AubergineShallow/digital8mm-vertical-nizo/cad/gs8-d2-v1/candidate-vertical/README.md

# D2 vertical Pi concealed vent review candidate

This directory contains the compact Kowa / Princeton vertical-Pi camera candidate derived from [AubergineShallow/digital8mm](https://github.com/AubergineShallow/digital8mm), with upstream baseline commit `d38468e58eb2b02d56743e2e0cfdd8f780818a65` retained for traceability. The current ventilation study uses a plain integral outer skin and separate intake/exhaust shadow plenums. Broadside grilles are concealed; edge mouths remain visible in direct front/rear views. Nine compact printed production parts and the reviewed purchased BOM selections/quantities are retained.

**This is an unqualified review candidate, not a fabrication, energization or service release.** Every r7 physical gate that still applies to this layout, the candidate's G-V-* gates ([REVIEW](REVIEW.md)) and collar M1 remain open. Actual cooler registration, complete FPC/EVF wiring, real tool access, printed strength, plenum manufacture and closed-body thermal performance remain unresolved. Geometric openings and scoped CAD passes do not establish useful airflow or physical safety.

<!-- gates:begin (generated by make_gates_vertical.py; do not edit) -->
**r7 gates on this candidate (generated):** 58 r7 receipt gates (56 open in r7): 39 carried, 11 re-scoped, 3 replaced, 5 retired; 53 of the open ones still apply here (carried, re-scoped or replaced by a G-V-* gate), 3 retired with deleted parts. r7 BX fixes: 8 carried, 7 re-scoped, 0 replaced, 2 retired. Table: [GATES-VERTICAL.md](GATES-VERTICAL.md).
<!-- gates:end -->

**Print hold:** the tub is not print-released. Plenum trial2 (review FP-11a) carries the roof on continuous 1.2 mm flow ribs and splits all four edge mouths (cold rear Z5..75, cold underside, hot underside, hot front Z5..40) with mullions; the two cold mouths also have 45° lintels, the hot mouths cannot (area parity leaves 9.6 mm² of margin). On the trial2 tub every plenum roof and mouth region passes the computed single-direction bridge rule (longest plenum bridge 27.1 mm, hot underside zone; [run extracts](review-2026-10-10/fp11a/)), but other tub regions still fail it, the selected export predates trial2, and no slicer, coupon or physical bridge/cleanout result exists. The plenum coupon script now also crops all four mouths; its files must be regenerated from the final export.

## Start here

- [Design review and open holds](REVIEW.md): geometry, dimensions, alternatives, evidence limits and decisions still needed
- [Assembly and service proposal](ASSEMBLY-VERTICAL.md): dependencies and STOP points, including physical battery isolation
- [Complete BOM](BOM-VERTICAL.md) and [CSV](BOM-VERTICAL.csv): installed versus purchased quantities, included kit contents, spares and qualification notes; [buy view by SKU](BUY-VERTICAL.csv)
- [Wiring specification](WIRING-VERTICAL.md) (generated by `make_wiring_vertical.py`): header and J2 tables, junctions, every lead with both ends, colours, polarity, lengths, plug and unplug order; supersedes baseline WIRING sections 2 and 5-7 for this fork
- [Received-part measurement plan](MEASUREMENTS-TO-CLOSE.md): the measurements needed to replace proxies and close interface holds
- [Pictorial concealed-vent guide PDF](guide/out-concealed-vents/D2-vertical-concealed-vents-review.pdf), [reproduction instructions](guide/README-CONCEALED-VENTS.md) and [STEP review map](guide/STEP-REVIEW-CONCEALED-VENTS.md): source-bound assembly and wiring review
- [Two-page structural supplement PDF](structural-review/output/pdf/D2-shadow-plenum-structural-supplement.pdf) and [editable text](structural-review/CONCEALED-VENT-STRUCTURAL.md): manifest-bound mass/load sensitivity, retained-section assumptions and print implications; no FEA or physical strength claim
- [Retained structural coupons](structural-review/coupons/README.md): nine separate test pieces, with the unchanged [generator](structural-review/make_coupons.py), selected/optional STEP inputs and a [verified restoration receipt](structural-review/coupon-reproducer-recovery.json)
- [Two plenum inspection coupons](vent-study/shadow-plenum-coupon/README.md): generated regular-grid and expanded port/CSI/edge crops, with a [source-bound index](vent-study/shadow-plenum-coupon/coupon-index.json). They remain separate from production parts and earlier structural coupons and do not prove closed-body cleanout or every unsupported span. No slicing, print or test is claimed.
- [Reproduction and inspect commands](REPRODUCE.md) (Windows and POSIX), the [toolchain lock](requirements-candidate-lock.txt) and the [repository index](REPO-INDEX.md) (selected pipeline, helpers, studies, evidence with no in-repo producer)
- [Check coverage](COVERAGE-VERTICAL.md) per report and category, generated from the selected reports, and the [map of r7 gates and BX fixes](GATES-VERTICAL.md)
- [Publication notes](PUBLISHING.md): the repository is public; the review fixes are local and unpushed

## Review 2026-10-10

An independent review recorded 84 issues ([register](review-2026-10-10/ISSUE-REGISTER.md), user decisions at its end). Phase 1 ([status](review-2026-10-10/PHASE1-STATUS.md), commit `44f8131`) and phase 2 (in progress, [fix log](review-2026-10-10/FIX-LOG.md)) changed the candidate as follows; every figure below is generated from the current reports, so it moves with each refresh.

- Windows-safe repository and I/O: `.gitattributes` keeps bytes exact, `cv_io.py` reads and writes UTF-8 with LF and records `/`-separated relative paths; writers record no machine-local path (older records that still hold one are listed in the [repository index](REPO-INDEX.md); the selected one is regenerated in FP-16).
- Deterministic export (fixed STEP header time, canonical colour order) and bound caches that `export_cache.py` can rebuild.
- Evidence tooling: `reconcile_review_evidence.py` and `review_docs_audit.py` have `--check`, exit non-zero on any failure and format repeated figures from their source rows.
- Assembly-state model `steps.py` with the corrected build order (collar and gauge before the camera, lens before the carrier, refits after every service removal); ASSEMBLY-VERTICAL.md blocks are generated from it.
- r7 checks ported: driver and service-driver, J7-R float, roll catch, lens support and clamp, inserts and assembly state in the main audit; print (overhang, bridge direction, bed contact and chamfer, thin wall, critical features), harness (routes, stow, reach, lead access, header housings) and check-scope (EVF and HDMI faces, EVF restraint, flow network, area parity, J4 screen, stack retention) as batch reports. Several fail on the current geometry by design until the phase-2 CAD fixes land; none was weakened.
- Generated [wiring specification](WIRING-VERTICAL.md), buy view and [third-party notices](../../../THIRD-PARTY-NOTICES.md).

<!-- coverage:begin (generated by make_coverage_vertical.py; do not edit) -->
**Check coverage (generated):**

- Main audit (`out/compact-kowa_lm6hc/verification.json`, 529 rows in 20 categories): 481 pass / 16 fail / 32 info. By kind: geometric 312 pass / 9 fail / 17 info; bookkeeping 155 pass / 7 fail / 0 info; coverage/state 14 pass / 0 fail / 6 info; analytical/declared 0 pass / 0 fail / 9 info.
- Batch reports (print, mesh, harness, check_scope, hdmi, power_static): geometric 167 pass / 71 fail / 64 info; coverage/state 4 pass / 0 fail / 0 info; analytical/declared 7 pass / 3 fail / 11 info.
- r7 categories (`cad/gs8-d2-v1/out/checks.json`, 36): 21 ported, 4 partly, 1 report only, 10 not ported.
- Report freshness: stale (manifest or verifier changed since the report): main, mesh, power_static; the counts are what those reports hold.
- Per-category table and the r7 mapping: [COVERAGE-VERTICAL.md](COVERAGE-VERTICAL.md).
<!-- coverage:end -->

## Evidence and preserved history

The current compact-Kowa [manifest](out/compact-kowa_lm6hc/manifest.json) identifies source files, STEP/mesh exports, estimated mass and print poses. Only reports whose manifest and verifier/source hashes match that export are current. The [documentation audit](out/review-docs-audit.json) distinguishes stale reports and checks BOM preservation. A report can contain known failures; binding a report does not convert them into passes.

[Reviewed export18](history/reviewed-export18/README.md) is the frozen reference before concealed-vent changes. Its raw 288 pass / 2 fail / 18 info result and prior service evidence remain historical. The new main checker distinguishes the intentionally empty CSI aperture from adjacent wall measurements; the actual cooler/source conflict remains an open hold.

The [visible angled-channel trial](vent-study/angled-channel-trial/manifest.json) is preserved as a rejected visual alternative. Its slot mouths remained visible, so its 59 mm core and throat/check results must not be used as the shadow-plenum result. Fresh [three-variant STEP comparisons](out/comparison/assembled-comparison.json) and core-void reports bind the current Kowa, Fujinon and original-storage exports. Compact Kowa/Fujinon bounding volumes are about 6.8% below matching baseline; original-storage Kowa is about 3.3% larger. Alternative exports and meshes have current identity checks, but compact-Kowa service results do not transfer.

## Reproduce a review snapshot

Use the repository's pinned CadQuery environment from [the dependency lock](../../gs8-pxl-v3/cad-requirements-lock.txt) (candidate additions and optional extras: [requirements-candidate-lock.txt](requirements-candidate-lock.txt)) and the [CAD execution wrapper](../run_locked.py). [REPRODUCE.md](REPRODUCE.md) has the exact commands for Windows and POSIX. Read the scripts' arguments before running them, and keep all geometry sources fixed during export/checking.

1. Export the chosen compact Kowa source with [export_candidate.py](export_candidate.py). Geometry is defined by [model.py](model.py), [vent_geometry.py](vent_geometry.py) and their recorded dependencies.
2. Run [verify_shadow_plenum.py](verify_shadow_plenum.py), then the serial [shadow review checks](run_shadow_checks.py). Preserve failures and inspect the report scope; do not inherit a historical pass count.
3. Refresh [the BOM generator](make_bom_vertical.py), [the CAD-free structural sensitivity](structural-review/update_concealed_vent_structure.py), the generated summaries ([coverage](make_coverage_vertical.py), [gates](make_gates_vertical.py), [repository index](make_repo_index.py), each with `--write`), and [the document/BOM audit](review_docs_audit.py). The structural calculation accepts only tub/panel changes relative to its frozen reference; a changed carried or lower component needs a new free-body calculation.
4. Rebuild [the structural PDF](structural-review/build_shadow_structural_pdf.py) from its bound JSON and text. For the pictorial guide, run [build_guide_concealed_vents.py](guide/build_guide_concealed_vents.py) under the CAD wrapper with `--manifest-sha256` set to the SHA-256 of the nominated `out/compact-kowa_lm6hc/manifest.json` (it changes with every re-export); on Windows run it through [run_with_numpy_raster.py](guide/run_with_numpy_raster.py), which supplies the pure-numpy rasterizer. Inspect every rendered page, then use [package_concealed_guide.py](guide/package_concealed_guide.py) to verify the guide package. A source change requires renewed bindings and renders.

The guide and reports are review artifacts. Slicing, representative plenum/coupon tests, actual part measurements and powered qualification are separate work that has not been completed by these scripts.
