AubergineShallow/digital8mm-vertical-nizo/cad/gs8-d2-v1/candidate-vertical/routing-snapshots/hdmi-corrected-ports-20261009-0623/README.md

# Corrected-port HDMI integration input

`input.json` SHA256
`cf6b20f21e342414dbf001fe9a4d84ad9634fa2b93e81118b112cac4eaec6f88`
preserves all three300mm full-width HDMI objects exactly. Only the USB5V head
reservation changes, to the upper receptacle of the real GPIO-side USB2 stack,
the lower candidate Z row. `creation-checks.json` records exact object equality
and canonical hashes. The original0524 study remains unchanged.

The corrected exterior31×15.5×9.8mm allowance occupies
X[−152.779999,−121.779999], Y[−15.126001,−5.326001],
Z[8.250319,23.750319]. It is an entire inherited head/bend reservation aligned
to a source socket, not a measurement of the received overmold or insertion.
No wire-exit point or direction is invented.

## Authoritative USB donor clarification

`usb-donor-provenance.json` explicitly supersedes the200mm wording in the two
USB route-status fields of the frozen geometry input. That200mm was an old
route allocation, not an intact purchased cable length that must be retained.

D2-22 is the Adafruit4448 cuttable donor (catalogue300mm, supplier325±10mm),
plus Pololu2180 and2181 tails,100mm each, and an inline diode. Final installed
copper cuts and complete rigid-junction positions remain TBD. Trimming is
permitted as part of the final cut plan. The complete installed lead and its
service staging remain blocked until the real overmold and exit are measured.
The final receipt binds this clarification and the unchanged geometry input
together; a guide must not repeat the superseded200mm intact-stock claim.

## Scope

Installed and EVF-unplugged/Pi-mated ribbon are the selected geometry poses.
Both-free is preserved solely as a rejected diagnostic: in-body Pi-head+Z6
conflicts with fixed power. The Adafruit3557 body-to-socket/root registration
hold remains. Full camera FPC placement and actual cooler/latch/tool geometry
remain open. Exact head/FPS/support checks and the final corrected mechanical
manifest binding are reported separately. No whole-loom or physical approval
follows from a hard-head reservation check. Baseline56 and M1 remain open.
