AubergineShallow/digital8mm-vertical-nizo/cad/gs8-d2-v1/candidate-vertical/routing-snapshots/hdmi-export17-selected-20261009-0704/README.md

# Export17 selected HDMI and corrected USB head reservation

The nominated compact export passes all six canonical selected checks against mechanical manifest `ed58af4220b6afebf3bf1d88d61a9f786f21fd717f74791387b613e62366be4b`: all three hard-head reservations versus printed material, both complete static HDMI ribbon poses, and the selected carrier/ribbon/header reservation at 36 offsets from +Y0 to +Y70 in 2 mm steps. The carried check performed 225 exact intersections after conservative broad-phase rejection. No positive witness was found. This is sampled geometry, not continuous or physical service qualification.

`export17-selected-hdmi-checks.json` is SHA256 `1a589bdbf4d84ecf351e3dd51cfdae0f002a0b5e8bea667961cada53856771da`. It binds canonical verifier `8d842217a75aa1b3ba3b3fabbbf3c5be785e56c637ad3becc2096a836e1fa556` and unchanged geometry input `cf6b20f21e342414dbf001fe9a4d84ad9634fa2b93e81118b112cac4eaec6f88`. Non-material storage keepout is excluded from fixed physical material.

## Conserved HDMI material

`conserved-ribbon-proof.json` checks exact object equality of all three ribbon dictionaries against the accepted CK1044-clear snapshot. The selected installed and premate shapes each use 2,283 full-width convex material cells and exactly 300.000000 mm analytic centreline length. The accepted reproduction proof covers all50 source poses: full10 mm width, 0.4 mm planning thickness, U radius5.5 mm installed decreasing to3 mm with Pi lift, R3 miter and R5 post bends. No ribbon geometry was altered to accommodate the USB port or boss. These are geometric planning radii; laminate bend capability, stiffness, tolerances and received cable construction are unqualified.

The selected sequence keeps the Pi HDMI adapter mated, disconnects the EVF end, and carries the complete ribbon with Pi/carrier. FPS wires/switch remain mated and travel with that group under their separate source-bound audit. The both-heads-free shape is retained only as a diagnostic. In-body Pi-head unplugging is rejected against the fixed power lead; on-bench Pi-head removal requires releasing and parking that loom first. An HDMI-only pass does not grant a full-loom staging pass.

## Corrected USB head and remaining cable holds

The source-aligned USB2 exterior head box is X−152.779999..−121.779999, Y−15.126001..−5.326001, Z8.250319..23.750319 mm. Its own source receptacle, represented FPS branches/supports, original power material and the final mechanical parts are checked separately in this folder. The 31×15.5×9.8 mm box remains a conservative reservation; the real overmold, engagement and wire exit are unmeasured. Neither an exit nor a new soft lead route is invented.

Read `usb-donor-provenance.json` as the authoritative donor ledger: D2-22 is cuttable Adafruit4448 stock, with catalogue300 mm versus supplier325±10 mm unresolved, two Pololu2180/2181 tails of100 mm each and an inline diode. Final installed copper cuts, overlaps, joints and complete lead placement remain TBD. The old200 mm allocation in preserved input status fields is superseded; it is not a purchased intact length or a ban on trimming.

The full200×16 mm camera FPC remains unplaced pending real root/engagement/stiffener/contact clocking and cooler/latch corridor measurements. The old87.119 mm stock allocation is not a full-width material route. Exact source Pi/approximate cooler conflicts remain open, including a separately investigated difference between saved union and distributed source-component witnesses. HDMI adapter-to-socket/root registration remains a received-part measurement hold. All56 baseline physical gates and M1 remain open.

## Preserved failures

The prior export16 tub/boss collision is retained in `../hdmi-corrected-ports-20261009-0623`. The rejected X−131/Z48 boss intersects the accepted ribbon and remains in `../usb-boss-relocation-20261009-0642`. The passing isolated compact X−128.5/Z48 rebuild is separately preserved, including its0.30 mm compression-only corner landing; inward push, outward peel, root stiffness and printed gap still need tests. No failed record was overwritten.
