AubergineShallow/digital8mm-vertical-nizo/cad/gs8-d2-v1/candidate-vertical/requirements-candidate-lock.txt

# Candidate toolchain lock (review 2026-10-10 VN-12, FP-15). Checked by tests/test_repo_hygiene.py.
#
# Base: the shared pinned CAD environment, unchanged (r7 and the 8mm project use the same file):
-r ../../gs8-pxl-v3/cad-requirements-lock.txt
#
# Reference interpreter: CPython 3.12.14, Windows x86-64 (8mm/.venv-cad); the same lock serves Linux.
# Every third-party module the live candidate scripts import is listed on exactly one line below.
# pinned-in-base: cadquery OCP numpy PIL reportlab vtk manifold3d
#   (import names; distributions cadquery, cadquery-ocp, numpy, pillow, reportlab, vtk, manifold3d, pinned in the base lock)
# optional: pypdf | structural-review/build_shadow_structural_pdf.py (page-count assertion after the PDF build)
# optional: scipy | screen_fps_carrier_service.py, screen_fps_core_removal.py, screen_fps_fixed_wires.py, screen_fps_mated_carry.py, screen_fps_mated_carry_v2.py, screen_fps_separate_cores.py, screen_fps_service_low.py, screen_fps_service_wires.py (historical FPS screening studies, scipy.spatial.cKDTree)
#   Optional modules are NOT installed in the reference venv and have no tested version, so no version is pinned.
#   Gate: install them in a copy of the venv, run the scripts that need them and tests/test_repo_hygiene.py, then pin
#   the installed versions here (the test fails while an optional module is installed but unpinned).
# external: bpy mathutils | render_review.py runs inside Blender's bundled Python (not pip).
#   Blender version: unrecorded for the 9ced753 renders (their receipts hold no version); r7 used Blender 4.3.2
#   (cad/gs8-d2-v1/CLOUD-REPRODUCIBILITY.md). render_review.py now writes bpy.app.version_string into every receipt.
# Guide rasterizer: guide/raster.cpp needs a 64-bit g++ matching the interpreter (POSIX); on Windows run the builder
#   through guide/run_with_numpy_raster.py (pure numpy, tested bit-identical to raster.cpp in tests/test_raster_fallback.py).
