AubergineShallow/digital8mm-vertical-nizo/THIRD-PARTY-NOTICES.md

# Third-party notices

This repository contains material made by others. This file names each item, its licence, and every
copy or derived file of it in the repository. The project's own licences are listed at the end.

This file is generated by `cad/gs8-d2-v1/candidate-vertical/tests/test_third_party_notices.py` with `--write`.
The same script's tests fail when a Pi-derived file has no licence beside it or is missing here.

## 1. Raspberry Pi 5 3D model (Raspberry Pi Ltd, MIT licence)

- Source: the official Raspberry Pi 5 STEP model, document RP-010083-CA-1 ("No Graphics small file"):
  <https://pip-assets.raspberrypi.com/categories/892-raspberry-pi-5/documents/RP-010083-CA-1-rpi-5%203D%20STEP%20-%20No%20Graphics%20small%20file.zip>
- SHA-256 of the source STEP inside that archive: `78164070c1cc7ab854382950d2e85926c6e35432f1e5a146b733397a7c6afb44`.
  It is recorded in `cad/gs8-d2-v1/candidate-vertical/official_pi5_csi.py` and in each variant manifest. The archive itself is not stored here.
- The manufacturer's licence file is kept unchanged at `cad/gs8-d2-v1/candidate-vertical/routing-snapshots/hdmi-ck1044-clear-20261009-0524/official-fpc-sources/LICENSE.txt`
  (SHA-256 `4ca2d350552b24137e55587e13fb09a249b757c6af49652ff02ea524d154c7fc`; build receipts bind these exact bytes).
- Every folder that holds Pi geometry has a copy of that licence: the original `LICENSE.txt`, or
  `LICENSE-RaspberryPi.txt` (the same text with LF line endings). A copy covers only the Pi-derived files listed
  for its folder, not the project's own parts stored next to them.
- Renders and guide pages that show the assembled camera also depict this geometry. This notice covers them.

| Folder | Licence file | Pi-derived files |
|---|---|---|
| `cad/gs8-d2-v1/candidate-vertical/out/compact-fujinon_hf6xa/` | `LICENSE-RaspberryPi.txt` | `assembly.step` (whole-camera assembly that includes the Pi part) |
| `cad/gs8-d2-v1/candidate-vertical/out/compact-fujinon_hf6xa/step/` | `LICENSE-RaspberryPi.txt` | `pi5.step` (Pi part as exported for this variant) |
| `cad/gs8-d2-v1/candidate-vertical/out/compact-kowa_lm6hc/` | `LICENSE-RaspberryPi.txt` | `assembly.step` (whole-camera assembly that includes the Pi part) |
| `cad/gs8-d2-v1/candidate-vertical/out/compact-kowa_lm6hc/step/` | `LICENSE-RaspberryPi.txt` | `pi5.step` (Pi part as exported for this variant) |
| `cad/gs8-d2-v1/candidate-vertical/out/original-kowa_lm6hc/` | `LICENSE-RaspberryPi.txt` | `assembly.step` (whole-camera assembly that includes the Pi part) |
| `cad/gs8-d2-v1/candidate-vertical/out/original-kowa_lm6hc/step/` | `LICENSE-RaspberryPi.txt` | `pi5.step` (Pi part as exported for this variant) |
| `cad/gs8-d2-v1/candidate-vertical/out/source-components/` | `LICENSE-RaspberryPi.txt` | `pi5-corrected.step` (corrected Pi assembly built from the extracted solids) |
| `cad/gs8-d2-v1/candidate-vertical/routing-snapshots/hdmi-ck1044-clear-20261009-0524/official-fpc-sources/` | `LICENSE.txt` | `cam_disp0-native.step` (connector solids extracted unchanged from the official STEP)<br>`cam_disp1-native.step` (connector solids extracted unchanged from the official STEP)<br>`connector-extraction.json` (indices and landmark positions measured on the official STEP)<br>`ethernet-native.step` (connector solids extracted unchanged from the official STEP)<br>`gpio-native.step` (connector solids extracted unchanged from the official STEP)<br>`port-landmarks.json` (indices and landmark positions measured on the official STEP)<br>`usb2-native.step` (connector solids extracted unchanged from the official STEP)<br>`usb3-native.step` (connector solids extracted unchanged from the official STEP)<br>`usbc-native.step` (connector solids extracted unchanged from the official STEP) |

### Licence text (verbatim from the manufacturer's LICENSE.txt)

```text
= Disclaimer =
This 3D model is provided under the MIT license included at the end of this file. The 3D model may incorporate individual 3D models that have been provided by third parties with permission to redistribute. No additional license terms are imposed by this use of third party provided 3D models, where applicable.

The overall 3D model and any individual 3D models incorporated into the whole, whether created by first or a third party, are provided here for guidance only and without guarantee of accuracy. Additionally, provided 3D model data may not reflect the most current version(s). Any third party intending to use the provided 3D model for appearance and fitment purposes must refer to manufacturer information and conduct suitable measurements of the physical product.

= MIT License =
Copyright (c) 2026 Raspberry Pi Ltd

Permission is hereby granted, free of charge, to any person obtaining a copy of this software and associated documentation files (the "Software"), to deal in the Software without restriction, including without limitation the rights to use, copy, modify, merge, publish, distribute, sublicense, and/or sell copies of the Software, and to permit persons to whom the Software is furnished to do so, subject to the following conditions:

The above copyright notice and this permission notice shall be included in all copies or substantial portions of the Software.

THE SOFTWARE IS PROVIDED "AS IS", WITHOUT WARRANTY OF ANY KIND, EXPRESS OR IMPLIED, INCLUDING BUT NOT LIMITED TO THE WARRANTIES OF MERCHANTABILITY, FITNESS FOR A PARTICULAR PURPOSE AND NONINFRINGEMENT. IN NO EVENT SHALL THE AUTHORS OR COPYRIGHT HOLDERS BE LIABLE FOR ANY CLAIM, DAMAGES OR OTHER LIABILITY, WHETHER IN AN ACTION OF CONTRACT, TORT OR OTHERWISE, ARISING FROM, OUT OF OR IN CONNECTION WITH THE SOFTWARE OR THE USE OR OTHER DEALINGS IN THE SOFTWARE.
```

## 2. DejaVu fonts

Used to engrave text on printed parts and to set text in rendered guide pages. Generated PDFs may embed
subsets of these fonts. The licence (Bitstream Vera terms, with DejaVu changes in the public domain) is in the
file named next to each font.

- `cad/gs8-d2-v1/fonts/DejaVuSans-Bold.ttf`. Licence: `cad/gs8-d2-v1/fonts/LICENSE-DejaVu.txt`.
- `cad/gs8-d2-v1/fonts/DejaVuSans.ttf`. Licence: `cad/gs8-d2-v1/fonts/LICENSE-DejaVu.txt`.

## 3. The project's own material

- `tools/`: MIT licence, see `tools/LICENSE`.
- `software/gs8-camera-evf/`: MIT licence, see `software/gs8-camera-evf/LICENSE`.
- Individual files with an `SPDX-License-Identifier: MIT` header: MIT licence.
- No licence has been chosen yet for the remaining CAD models and documents. That choice is open with the
  project owner (review item VN-13). Until it is made, only the items above grant any rights.
