AubergineShallow/digital8mm-vertical-nizo/cad/gs8-d2-v1/candidate-vertical/COVERAGE-VERTICAL.md

# Check coverage of the vertical candidate

Generated by `make_coverage_vertical.py` from the selected compact-Kowa reports (manifest `ec60b42dee2487c17f67aab9561451d146ab137fdd88cc3dcf20a39a96917715`); do not edit. Regenerate with `make_coverage_vertical.py --write` after every report refresh; `--check` fails when this file is stale. Review 2026-10-10 VN-21.

## Summary

- Main audit (`out/compact-kowa_lm6hc/verification.json`, 529 rows in 20 categories): 481 pass / 16 fail / 32 info. By kind: geometric 312 pass / 9 fail / 17 info; bookkeeping 155 pass / 7 fail / 0 info; coverage/state 14 pass / 0 fail / 6 info; analytical/declared 0 pass / 0 fail / 9 info.
- Batch reports (print, mesh, harness, check_scope, hdmi, power_static): geometric 167 pass / 71 fail / 64 info; coverage/state 4 pass / 0 fail / 0 info; analytical/declared 7 pass / 3 fail / 11 info.
- r7 categories (`cad/gs8-d2-v1/out/checks.json`, 36): 21 ported, 4 partly, 1 report only, 10 not ported.
- Report freshness: stale (manifest or verifier changed since the report): main, mesh, power_static; the counts are what those reports hold.
- Per-category table and the r7 mapping: [COVERAGE-VERTICAL.md](COVERAGE-VERTICAL.md).

## Per report and category

| Report | Category | Kind | pass | fail | info | stub |
|---|---|---|---|---|---|---|
| main | assembly_state | coverage/state | 3 | 0 | 0 | 0 |
| main | driver | geometric | 9 | 2 | 0 | 0 |
| main | driver_coverage | coverage/state | 1 | 0 | 0 | 0 |
| main | inserts | geometric | 4 | 0 | 0 | 0 |
| main | integrity | bookkeeping (STEP validity, solid count and volume per exported part) | 46 | 0 | 0 | 0 |
| main | interference | geometric | 108 | 1 | 9 | 0 |
| main | j7_float | geometric | 50 | 0 | 0 | 0 |
| main | lens_clamp | geometric | 4 | 4 | 2 | 0 |
| main | lens_support | geometric | 41 | 0 | 5 | 0 |
| main | motion | geometric | 16 | 0 | 0 | 0 |
| main | motion_coverage | coverage/state | 10 | 0 | 6 | 0 |
| main | nominal_features | analytical/declared (analytical constants, not measured from the STEP (VN-21)) | 0 | 0 | 7 | 0 |
| main | non_material_keepout | analytical/declared | 0 | 0 | 1 | 0 |
| main | physical | analytical/declared | 0 | 0 | 1 | 0 |
| main | roll_catch | geometric | 58 | 0 | 1 | 0 |
| main | roundtrip | bookkeeping | 45 | 0 | 0 | 0 |
| main | service_driver | geometric | 9 | 2 | 0 | 0 |
| main | source_binding | bookkeeping | 64 | 7 | 0 | 0 |
| main | step_aperture_probes | geometric | 1 | 0 | 0 | 0 |
| main | step_material_probes | geometric | 12 | 0 | 0 | 0 |
| print | bed_chamfer | geometric | 6 | 4 | 0 | 0 |
| print | bed_contact | geometric | 1 | 0 | 0 | 0 |
| print | critical_features | geometric | 50 | 55 | 37 | 0 |
| print | print_bridge_direction | geometric | 7 | 3 | 0 | 0 |
| print | print_overhang | geometric | 7 | 3 | 0 | 0 |
| print | thin_wall | geometric | 9 | 0 | 0 | 0 |
| print | unclassified_thin_spots | geometric | 0 | 0 | 4 | 0 |
| mesh | mesh | geometric | 10 | 0 | 0 | 0 |
| harness | cable_routes | geometric | 8 | 3 | 2 | 0 |
| harness | cable_stow | geometric | 3 | 0 | 10 | 0 |
| harness | feed_volumes | geometric (EVF feed parts (diode sleeve, RCY pair, option-C reserve) placed on the usb_5v route (FP-11f)) | 6 | 0 | 0 | 0 |
| harness | header_housings | geometric | 7 | 0 | 0 | 0 |
| harness | lead_access | analytical/declared (mixed: lead geometry plus the G-W5 voltage-drop estimate) | 1 | 3 | 2 | 0 |
| harness | mate_reach | geometric | 3 | 2 | 5 | 0 |
| harness | signal_routes | geometric | 5 | 0 | 1 | 0 |
| check_scope | area_parity | geometric | 2 | 0 | 0 | 0 |
| check_scope | evf_face | geometric | 12 | 0 | 3 | 0 |
| check_scope | evf_restraint | geometric | 8 | 1 | 0 | 0 |
| check_scope | flow_network | analytical/declared | 1 | 0 | 9 | 0 |
| check_scope | hdmi_face | geometric | 4 | 0 | 2 | 0 |
| check_scope | j4_screen | analytical/declared | 4 | 0 | 0 | 0 |
| check_scope | post_root_bending | analytical/declared | 1 | 0 | 0 | 0 |
| check_scope | stack_retention | geometric | 1 | 0 | 0 | 0 |
| hdmi | carried_sweep | geometric | 1 | 0 | 0 | 0 |
| hdmi | full_ribbon_vs_solids | geometric | 2 | 0 | 0 | 0 |
| hdmi | hard_head_vs_material | geometric | 3 | 0 | 0 | 0 |
| hdmi | hard_head_vs_printed | geometric | 3 | 0 | 0 | 0 |
| hdmi | obstacle_fixture | coverage/state | 4 | 0 | 0 | 0 |
| hdmi | service_access | geometric (EVF HDMI unplug corridor: pliers jaws and shank swept down the stroke (H2, VN-43; r7 ACCESS tool numbers)) | 3 | 0 | 0 | 0 |
| power_static | power_static | geometric | 6 | 0 | 0 | 0 |

## Reports read

| Report | File | Binds selected manifest | Verifier current |
|---|---|---|---|
| main | `out/compact-kowa_lm6hc/verification.json` | no | no (`verify_candidate.py`) |
| print | `out/compact-kowa_lm6hc/print-checks.json` | yes | yes (`verify_print_checks.py`) |
| mesh | `out/compact-kowa_lm6hc/print-mesh-checks.json` | no | yes (`verify_print_meshes.py`) |
| harness | `out/compact-kowa_lm6hc/harness-checks.json` | yes | yes (`verify_harness_checks.py`) |
| check_scope | `out/compact-kowa_lm6hc/check-scope-checks.json` | yes | yes (`verify_check_scope.py`) |
| hdmi | `out/compact-kowa_lm6hc/hdmi-solid-checks.json` | yes | yes (`verify_hdmi.py`) |
| power_static | `out/compact-kowa_lm6hc/wire-solid-checks.json` | no | yes (`verify_wire_solids.py`) |

## r7 categories

Each category of the r7 release check (`cad/gs8-d2-v1/out/checks.json`, row counts from that file) and where the candidate runs it. "partly" means a narrower candidate check stands in; "not ported" means the candidate has no equivalent and its geometry is not checked for that rule.

| r7 category | r7 rows | Candidate | Coverage |
|---|---|---|---|
| bed_fit | 12 | mesh/mesh (fits_250x210x220 field) | partly |
| boss_geometry | 7 | - | not ported |
| cable_routes | 10 | harness/cable_routes | ported |
| cable_stow | 7 | harness/cable_stow | ported |
| clearance | 13 | - | not ported |
| contract | 38 | - | not ported |
| cots_containment | 20 | - | not ported |
| critical_features | 141 | print/critical_features | ported |
| driver | 11 | main/driver | ported |
| engrave_groove | 10 | - | not ported |
| evf_restraint | 8 | check_scope/evf_restraint | ported |
| handling | 17 | - | not ported |
| header_housings | 10 | harness/header_housings | ported |
| inserts | 4 | main/inserts | ported |
| interference | 62 | main/interference | ported |
| j7_float | 50 | main/j7_float | ported |
| keepouts | 109 | main/non_material_keepout (1 info row) | partly |
| layout_self_check | 188 | - | not ported |
| lead_access | 9 | harness/lead_access | ported |
| lens_clamp | 6 | main/lens_clamp | ported |
| lens_support | 42 | main/lens_support | ported |
| mass_com | 2 | manifest mass_est_g / com_est_mm (report only, as in r7) | report only |
| mate_overlap | 42 | main/interference (declared mating info rows) | partly |
| mate_paths | 13 | hdmi/service_access (r7 ACCESS rows for the EVF HDMI unplug only, H2) | partly |
| mate_reach | 6 | harness/mate_reach | ported |
| print_modifiers | 18 | - | not ported |
| print_overhang | 13 | print/print_overhang | ported |
| release_access | 2 | - | not ported |
| removals | 13 | - | not ported |
| roll_catch | 59 | main/roll_catch | ported |
| service_driver | 11 | main/service_driver | ported |
| stack_retention | 1 | check_scope/stack_retention | ported |
| stl_mesh | 12 | mesh/mesh | ported |
| sweeps | 14 | main/motion | ported |
| thin_wall | 12 | print/thin_wall | ported |
| unclassified_thin_spots | 0 | print/unclassified_thin_spots | ported |

Candidate categories with no r7 counterpart: check_scope/area_parity, check_scope/evf_face, check_scope/flow_network, check_scope/hdmi_face, check_scope/j4_screen, check_scope/post_root_bending, harness/feed_volumes, harness/signal_routes, hdmi/carried_sweep, hdmi/full_ribbon_vs_solids, hdmi/hard_head_vs_material, hdmi/hard_head_vs_printed, hdmi/obstacle_fixture, main/assembly_state, main/driver_coverage, main/integrity, main/motion_coverage, main/nominal_features, main/physical, main/roundtrip, main/source_binding, main/step_aperture_probes, main/step_material_probes, power_static/power_static, print/bed_chamfer, print/bed_contact, print/print_bridge_direction.
