AubergineShallow/digital8mm-vertical-nizo/cad/gs8-d2-v1/candidate-vertical/GATES-VERTICAL.md

# r7 gates and BX fixes on the vertical candidate

Generated by `make_gates_vertical.py` from `gate_map.py`, the r7 build receipt (`cad/gs8-d2-v1/out/build-receipt.json`, hardware_gates.gates) and `cad/gs8-d2-v1/guide/BLOCKERS-2026-10-08.md`; do not edit. Review 2026-10-10 VN-50.

The disposition rules are in the `gate_map.py` docstring. No gate is closed by this table: carried, re-scoped and replaced gates all remain open physical gates, and the candidate adds its own G-V-* gates (REVIEW.md).

## Counts

- r7 receipt gates: 58 (56 open in r7). Disposition on the candidate: 39 carried, 11 re-scoped, 3 replaced, 5 retired.
- Of the 56 gates open in r7, 53 still apply to the candidate (carried, re-scoped or replaced by a G-V-* gate) and 3 are retired with deleted parts (hood, pi_keeper, plunger, stick_sleeve).
- r7 BX blocker fixes: 17. Disposition: 8 carried, 7 re-scoped, 0 replaced, 2 retired.

## r7 physical gates

| Gate | r7 status | Candidate | Carried by | Why |
|---|---|---|---|---|
| EVF-G1 | open (no record) | carried | - | same HMX039 OLED and EVF board |
| EVF-G2 | open (no record) | carried | - | same EVF timing on the Pi |
| EVF-G3 | open (no record) | carried | - | same EVF electronics |
| EVF-G4 | open (no record) | carried | - | same EVF board supply range |
| EVF-G5 | open (no record) | carried | - | same HDMI pin 19 behaviour (run as G-W7) |
| EVF-G6 | open (no record) | carried | - | same EVF electronics |
| EVF-G7 | open (no record) | carried | - | same EVF optics |
| EVF-G8 | open (no record) | carried | - | same EVF optics |
| EVF-G9 | open (no record) | carried | - | same EVF electronics |
| EVF-G4b | open (no record) | carried | - | same EVF rail limit (run as G-W6) |
| G-CAM-1 | open (no record) | carried | main/j7_float | same GS camera and J7-R float; j7_float must pass again after any CAM update |
| G-CAM-2 | open (no record) | carried | main/roll_catch | same assembled sag acceptance and tab-catch roll stop |
| G-CAP-1 | open (no record) | carried | - | the printed cap and its detent are retained |
| G-COL-1 | open (no record) | carried | main/lens_clamp | same lens collar coupons (collar redesign FP-11d may change them) |
| G-COMB-1 | open (no record) | carried | - | clearance comb calibration applies to every printed fit |
| G-ENC-1 | open (no record) | carried | - | encoder cradle hooks retained in the panel |
| G-EVF-1 | open (no record) | carried | - | same eyepiece spigot pull-out and diopter |
| G-EVF-2 | open (no record) | re-scoped | check_scope/evf_restraint | the EVF +Y stop moved with the vertical layout; the candidate stop is the evf_restraint rows |
| G-EVF-3 | open (no record) | re-scoped | harness + hdmi carried sweep | in-situ HDMI mating now follows the candidate step-5 order and the 3557/3556 heads (see G-V-HDMI) |
| G-FPC-1 | open (no record) | carried | - | applies only if a shorter verified FPC is chosen instead |
| G-HDMI | open (no record) | re-scoped | G-V-HDMI | cable part replaced by G-V-HDMI (3557 Pi head, 3556 EVF head, 300 mm ribbon); the 18/24 switch bushing and tab part is carried |
| G-HDR-1 | open (no record) | carried | harness/header_housings | same Pi header housings (WIRING-VERTICAL cites it) |
| G-J4-1 | open (no record) | carried | - | the J4 grip joint is retained |
| G-KEEP-1 | open (no record) | retired | G-V-STACK | pi_keeper deleted; stack retention is the carrier (G-V-STACK) |
| G-KEEP-1/whole | open (no record) | retired | G-V-STACK | whole-keeper cycles: pi_keeper deleted |
| G-KNOB-1 | open (no record) | carried | - | same knob D-bore ladders |
| G-LENS | open (no record) | carried | main/lens_support | same lens line; before tub/panel/collar printing |
| G-MP-ENC | open (no record) | carried | - | same Adafruit 5880 encoder and panel cradle |
| G-MP-EVF | open (no record) | carried | - | same EVF jig measurement |
| G-MP-FPC | open (no record) | re-scoped | G-V-SERVICE | the r7 S-fold box ko_fpc_loop does not exist in the vertical layout; FPC length and route are re-derived |
| G-MP-PACK | open (no record) | carried | - | same 1S2P pack envelope |
| G-MP-STICK | open (no record) | replaced | G-V-STORAGE | stick sleeve and guide deleted; the upper-port storage reserve is G-V-STORAGE |
| G-MP-SW | open (no record) | carried | - | same 18/24 switch tab and nut on the panel |
| G-MP-X1203 | open (no record) | re-scoped | G-V-STACK | X1203 and cooler limits were stated in the r7 horizontal frame (cooler top z 36.3, keeper finger offsets) |
| G-PANEL-1 | open (no record) | re-scoped | G-V-STRAP | the panel is held by four screws with the shifted strap; the r7 PH1-only open/close cycle no longer describes it |
| G-PANEL-1/whole | open (no record) | re-scoped | G-V-STRAP | whole-panel cycles with the strap fitted, on the candidate panel and screws |
| G-PI-1 | open (no record) | replaced | G-V-STACK | keeper finger zones deleted; standoff and stack fit are G-V-STACK |
| G-PLG-1 | open (no record) | replaced | G-V-POWER | plunger deleted; the power switch on J2 is G-V-POWER |
| G-PT-1 | open (no record) | carried | - | PT screws in printed bosses are retained |
| G-QT-1 | open (no record) | re-scoped | harness/mate_reach qt_enc | the QT lead route and fan-in changed (VN-28); the propped-panel dry fit is re-derived |
| G-RUN-1 | open (no record) | carried | - | same run button cap |
| G-SKIRT-1 | withdrawn (feature deleted; see the gate doc) | retired | - | withdrawn in r7 (feature deleted) |
| G-SNAP-1 | withdrawn (feature deleted; see the gate doc) | retired | - | withdrawn in r7 (Pi floor hooks deleted) |
| G-SNAP-2 | open (no record) | re-scoped | - | hood hook and ledge coupons retired with the hood; the encoder cradle hook coupon is carried |
| G-SNAP-2/whole | open (no record) | retired | - | five whole-hood cycles: hood deleted |
| G-W1 | open (no record) | carried | - | same pack receipt |
| G-W2 | open (no record) | carried | - | same X1203 identity and pads |
| G-W3 | open (no record) | carried | - | same Pi bench bring-up |
| G-W4 | open (no record) | carried | - | same X1203 feed test |
| G-W5 | open (no record) | re-scoped | G-V-PIGTAIL | the pigtail path is the candidate 270 mm route (harness lead_access/pigtail_drop; user decision 4) |
| G-W6 | open (no record) | carried | - | same EVF rail test on the bench |
| G-W7 | open (no record) | carried | - | same HDMI pin 19 isolation |
| G-W8 | open (no record) | re-scoped | G-V-POWER | power key is the J2 switch, not the plunger on the Pi button |
| G-W9 | open (no record) | carried | - | same controls test |
| G-W10 | open (no record) | carried | G-V-STORAGE | same sustained recording test; G-V-STORAGE adds the upper-port reserve |
| G-W11 | open (no record) | carried | G-V-THERMAL | closed-body thermal run; G-V-THERMAL adds the plenum and occlusion cases |
| G-W12 | open (no record) | carried | - | closed-body test after the print set |
| G-W13 | open (no record) | carried | - | option C regulator (user decision 10) |

## r7 BX blocker fixes

| BX | r7 severity | Candidate | Where | Why |
|---|---|---|---|---|
| BX-1 | BLOCKER | re-scoped | steps.py evf_mate; hdmi carried sweep | EVF HDMI mating order follows the candidate steps and heads |
| BX-2 | MAJOR | carried | harness/mate_reach qt_enc (fails, VN-28) | QT reach with the panel propped is still open |
| BX-3 | MAJOR | carried | harness/mate_reach xt30_pack; lead_access (fail, VN-47) | XT30 mating length and ties are still open (user decision 6) |
| BX-4 | MAJOR | carried | main/roll_catch | tab-catch camera hold retained (tab printability FP-11b) |
| BX-5 | MAJOR | carried | ASSEMBLY-VERTICAL.md knob press text | knob press by thumb; r7 handling rows not ported |
| BX-6 | MINOR | retired | - | plunger and hood deleted |
| BX-7 | MINOR | carried | steps.py foam pad order | foam pad present |
| BX-8 | MINOR | re-scoped | G-V-SERVICE | no ko_fpc_loop S-fold in the vertical layout |
| BX-9 | MINOR | re-scoped | usb_5v route volumes (FP-11f, VN-60) | no hood; the EVF feed parts move onto the usb_5v route |
| BX-10 | MINOR | re-scoped | harness/header_housings | header-to-wall distances changed with the vertical Pi |
| BX-11 | MINOR | re-scoped | G-V-STACK | stack handling is on the carrier |
| BX-12 | MINOR | re-scoped | main/driver | no hood; driver margins come from the candidate driver rows |
| BX-13 | MINOR | carried | - | same proud panel shafts before the knobs; the r7 fix is not yet written into ASSEMBLY-VERTICAL.md and r7 handling rows are not ported |
| BX-14 | MINOR | carried | - | same 18/24 shaft cut; the r7 guide fix is not yet written into ASSEMBLY-VERTICAL.md |
| BX-15 | MINOR | carried | steps.py collar and gauge before the camera (VN-39) | same centring gauge and collar screws |
| BX-16 | MINOR | re-scoped | harness/cable_routes run_pin37/39 (fail, VN-26) | the run lead route changed and is still open |
| BX-17 | MINOR | retired | - | hood deleted |
