AubergineShallow/digital8mm-vertical-nizo/cad/gs8-d2-v1/candidate-vertical/REPO-INDEX.md

# Repository index of the vertical candidate

Generated by `make_repo_index.py`; do not edit. `make_repo_index.py --check` fails when this file is stale, an evidence file records an undeclared absolute path, or a path grows past the Windows limit below. Review 2026-10-10 VN-10, VN-11, VN-18, VN-19, VN-20.

## Selected pipeline

- export: `make_corrected_pi.py`, `export_candidate.py`, `export_cache.py`, `export_shadow_alternatives.py`
- checks (run_shadow_checks.py batch, then the plenum/outlet verifiers): `run_shadow_checks.py`, `verify_candidate.py`, `verify_print_meshes.py`, `verify_print_checks.py`, `verify_csi_source.py`, `verify_power_service.py`, `verify_wire_solids.py`, `verify_hdmi.py`, `verify_fps_integrated.py`, `verify_harness_checks.py`, `verify_shadow_usb_head.py`, `verify_microsd_service.py`, `verify_check_scope.py`, `measure_volume.py`, `measure_comparison.py`, `verify_shadow_plenum.py`, `verify_shadow_outlet_context.py`, `verify_wall_probe_context.py`
- evidence and documents: `make_assembly_text.py`, `make_bom_vertical.py`, `make_wiring_vertical.py`, `make_shadow_plenum_coupon.py`, `structural-review/update_concealed_vent_structure.py`, `structural-review/build_shadow_structural_pdf.py`, `structural-review/verify_reference_binding.py`, `reconcile_review_evidence.py`, `review_docs_audit.py`, `make_coverage_vertical.py`, `make_gates_vertical.py`, `make_repo_index.py`, `check_links_vertical.py`
- guide and renders: `guide/build_guide_concealed_vents.py`, `guide/run_with_numpy_raster.py`, `guide/package_concealed_guide.py`, `run_shadow_renders.py`, `render_review.py`

Helper modules (the local import closure of the scripts above, computed): `check_scope.py`, `critical_features_vertical.py`, `cv_io.py`, `driver_checks.py`, `evidence_rules.py`, `fps_fixed_support.py`, `fps_geometry.py`, `fps_pair_guide.py`, `gate_map.py`, `guide/raster_numpy.py`, `guide/software_lineart.py`, `guide/vent_guide_support.py`, `harness_rules.py`, `hdmi_routes.py`, `j4_slide_checks.py`, `j7_collar_checks.py`, `model.py`, `official_pi5_assembly.py`, `official_pi5_csi.py`, `official_pi5_geometry.py`, `power_geometry.py`, `power_routes.py`, `print_rules.py`, `rigid_sweep.py`, `routes.py`, `signal_routes.py`, `steps.py`, `strap_route_proposal.py`, `structure_geometry.py`, `vent_geometry.py`, `verify_fps_access.py`, `wire_terminal_rules.py`, `wiring_data.py`.

Superseded runners, kept for provenance:

- `refresh_primary_evidence.py`: the 9ced753 primary refresh runner; run_shadow_checks.py replaces it
- `refresh_alternatives.py`: the 9ced753 alternative-variant runner; export_shadow_alternatives.py replaces it
- `run_review_batch.py`: earlier batch runner; run_shadow_checks.py replaces it
- `render_views.py`: earlier render runner; run_shadow_renders.py replaces it
- `run_vent_renders.py`: renders of the rejected angled-channel trial
- `package_delivery.py`: the 9ced753 delivery packager (delivery-core-paths.json)
- `guide/build_guide_vertical.py`: the original 29-page guide builder (frozen; superseded by the concealed-vent guide)
- `guide/package_guide.py`: packager of the original guide

Studies, probes and one-off generators (56; not part of the selected pipeline, kept because snapshots and receipts record their paths and hashes): `analyze_power_corner.py`, `create_corrected_port_hdmi_snapshot.py`, `diagnose_fps_fixed_contacts.py`, `fps_ck1044_mated_carry.py`, `fps_ck1044_mated_carry_v2.py`, `fps_ck1044_separate_cores.py`, `fps_ck1044_service.py`, `fps_ck1044_service_carrier.py`, `fps_ck1044_service_low.py`, `fps_ck1044_static.py`, `fps_fixed_support_central.py`, `fps_fixed_support_central_wide.py`, `fps_fixed_support_pad_proposal.py`, `fps_picoblade_study.py`, `fps_service_routes.py`, `inspect_baseline.py`, `make_vent_comparison.py`, `measure_baseline.py`, `probe.py`, `probe_carrier_reinforcement.py`, `probe_corrected_fps.py`, `probe_fujinon_print.py`, `probe_power_boolean.py`, `probe_power_boolean2.py`, `probe_power_fit.py`, `probe_structure_additions.py`, `probe_walls.py`, `screen_fps_carrier_service.py`, `screen_fps_core_removal.py`, `screen_fps_fixed_wires.py`, `screen_fps_mated_carry.py`, `screen_fps_mated_carry_v2.py`, `screen_fps_separate_cores.py`, `screen_fps_service_low.py`, `screen_fps_service_wires.py`, `structural-review/check_coupon_meshes.py`, `structural-review/j4_trial_geometry.py`, `structural-review/make_coupons.py`, `structural-review/render_coupons.py`, `study_fps_fixed_switch.py`, `study_fps_over_top_tool.py`, `study_fps_saddle.py`, `study_fps_transition.py`, `study_hdmi_ck1044.py`, `study_pi_cooler_union.py`, `verify_csi_access.py`, `verify_fps_carrier_route.py`, `verify_fps_central_rest.py`, `verify_fps_central_rest_wide.py`, `verify_fps_contact_pad.py`, `verify_fps_final_candidate.py`, `verify_fps_fixed_service.py`, `verify_fps_mated_carry.py`, `verify_fps_pair_deployment.py`, `verify_fps_pair_guide.py`, `verify_ventilation.py`.

Tests: `tests/` (phase-1 and phase-2 review tests) and `test_routes_source.py` (the candidate's own route test).

## Evidence produced by code that is not in the repository

| File | What | Why not reproducible here | What still checks it |
|---|---|---|---|
| `routing-snapshots/hdmi-ck1044-clear-20261009-0524/official-fpc-sources/connector-extraction.json` | Pi 5 connector components extracted from the official Raspberry Pi 5 STEP (source SHA-256 78164070, THIRD-PARTY-NOTICES.md) | the extractor script is not in the repository or the upstream archive; re-deriving needs the official archive (a download) | each component source_sha256 equals its *-native.step (tests/test_repo_hygiene.py); readers official_pi5_geometry.py, official_pi5_csi.py, routes.py, make_corrected_pi.py |
| `routing-snapshots/hdmi-ck1044-clear-20261009-0524/official-fpc-sources/port-landmarks.json` | Pi 5 port landmark boxes (USB2, USB3, Ethernet, GPIO, USB-C) from the same official STEP | same extractor, not in the repository | each object sha256 equals its *-native.step (tests/test_repo_hygiene.py); routes.py binds p_usb_pi to the usb2 landmark (test_routes_source.py) |
| `routing-snapshots/hdmi-ck1044-clear-20261009-0524/official-fpc-sources/*-native.step` | seven native component STEPs (cam_disp0, cam_disp1, ethernet, gpio, usb2, usb3, usbc) | written by the same missing extractor | hash-bound by connector-extraction.json / port-landmarks.json and by the export manifests through make_corrected_pi.py |
| `routing-snapshots/power-csi-clear-20261009-0358/independent-audit.json` | independent XT30 route audit of 2026-10-09 | its reproduction_commands name /tmp/xt30_independent_audit/*.py on the author machine; those scripts were never committed | historical only; the current power checks are verify_power_service.py and verify_wire_solids.py |
| `out/final-check-run.json` | the author run record of 2026-10-09 (main, hdmi, fps) | no writer in the repository; its logs were /tmp/d2-final-*.log on the author machine and were not kept | historical only; the current run record is out/compact-kowa_lm6hc/review-check-run.json (VN-07) |
| `structural-review/reference-export18-structural-binding.json` | base of the structural supplement (export18 mass, parts, critical-region equivalence, upper-body loads) | its generator is not in the repository; the critical-region reference STEPs are not kept | structural-review/verify_reference_binding.py re-derives the manifest, mass, centre of mass, part hashes, history STEP hashes and volumes; "inherited" there means r7 1.6 mm lip / 1.8 mm head J4 geometry |
| `probe_power_boolean.py --archive` | input of a historical boolean diagnostic: an export archive zip | the archive is not in the repository (git history holds the same STEPs) | not evidence; prints only |

## Machine-local absolute paths in recorded JSON

Writers record repository-relative POSIX paths (VN-10; `verify_shadow_usb_head.py`, `verify_check_scope.py` and the refresh runners were fixed in FP-15). These files still hold an absolute path from the machine that wrote them:

| File | Occurrences | Class |
|---|---|---|
| `history/head-checks/0eebe7ed45a5a01f61b9f139f7ccc2ff577751cef44955ccfcbc16942684f4d9.json` | 1 | frozen history |
| `out/final-check-run.json` | 3 | non-reproducible provenance |
| `routing-snapshots/hdmi-corrected-ports-20261009-0623/export16-head-checks.json` | 1 | frozen history |
| `routing-snapshots/hdmi-export17-selected-20261009-0704/export18-head-checks.json` | 1 | frozen history |
| `routing-snapshots/hdmi-export17-selected-20261009-0704/shadow-plenum-head-checks.json` | 1 | pending FP-16 |
| `routing-snapshots/power-csi-clear-20261009-0358/independent-audit.json` | 3 | non-reproducible provenance |

Frozen history is kept byte-for-byte; pending files are regenerated by the FP-16 refresh, never hand-edited.

## Windows path length

The longest repository-relative path is 132 characters (`cad/gs8-d2-v1/candidate-vertical/routing-snapshots/hdmi-ck1044-clear-20261009-0524/fps-deployed-carrier-context-0551-superseded.json`). Windows limits a full path to 259 characters, and git adds a `.lock` suffix while writing, so either clone into a folder whose own path is at most 120 characters, or enable long paths for the clone: `git config --global core.longpaths true` before cloning (and the Windows `LongPathsEnabled` policy for other tools). The routing-snapshot folder names are recorded in receipts and reconciler cases, so they are not shortened.

## Toolchain

Pinned environment and optional extras: `requirements-candidate-lock.txt` (base: `../../gs8-pxl-v3/cad-requirements-lock.txt`). Blender version of the 9ced753 renders: unrecorded (render receipts now record it). Guide rasterizer on Windows: `guide/run_with_numpy_raster.py`.
