AubergineShallow/digital8mm-vertical-nizo/cad/gs8-d2-v1/candidate-vertical/review-2026-10-10/REVIEW-physical.md

# Vertical candidate: physical assembly and service review (dimension "physical")

Date: 2026-10-10. Reviewer: physical-review agent. Read-only. Snapshot: digital8mm-vertical-nizo @ 9ced753, variant
out/compact-kowa_lm6hc (manifest 53e668d4...). Method: the r7 blocker review (guide/BLOCKERS-2026-10-08.md). I read
ASSEMBLY-VERTICAL.md (every step, STOP and service row), model.py, verify_candidate.py, verify_hdmi.py, the routing
snapshots and the out/compact-kowa_lm6hc reports. I ran two probes on the saved STEP files (scripts and JSON in this
folder: p1.py/p1.json, p2.py/p2.json; both through run_locked.py; nothing in the snapshot was written). A third
(p3.py) never got the CAD lock; see Notes.
Everything is CAD-proxy evidence. Nothing was printed or bought.

## Verdict

**0 BLOCKER. Latent: 7 MAJOR, 4 MINOR. Existing holds confirmed: 4 (2 MAJOR, 2 MINOR). 8 CLEARED.** The candidate can likely be built,
but not in the written order. Step 2 cannot be done as written: with the camera in, the seated centring gauge overlaps
the C-CS adapter by 927.75 mm3 (PHY-1). The microSD "panel-off" route is blocked by the lens collar, which the
`microsd_out` check leaves out (PHY-2). The main audit has none of r7's physical-assembly checks (driver, mate_paths,
mate_reach, handling, j7_float, roll_catch, lead_access...): 161 of its 292 passes are file/hash bookkeeping (PHY-3).
The camera FPC has no stated camera-end mating moment and no slack store (PHY-4). The FPS switch/panel sequence is
self-contradictory (PHY-5). The USB 5 V donor head ends 2.72 mm from the rear wall, so a normal axial cable exit cannot
bend (PHY-7). Step 4 needs more than two hands (PHY-8).
Good news, computed here: all 11 screws pass the r7 straight-driver envelope at their own step (C-1). The J7-R float
holds at the exported pose, if the lens is turned back off the tine (C-2, PHY-9). The in-place EVF HDMI push-up has a
clear column and hand corridor, so r7's BX-1 fix survives in principle (C-3).

## r7 BX fix carry-over

| r7 item | Status in the vertical candidate | Evidence |
|---|---|---|
| BX-1 EVF HDMI plug path | Mostly kept: board slides first, head pushed up in place. Push column and +Y hand corridor are clear (C-3). But step 3 still says mate the head at step 3 (PHY-6). The carried sweep drops the head only 6 mm, equal to the 6.0 mm stroke (r7 path: 12 mm). No mate_paths check, no service pliers corridor (PHY-3, PHY-6). | p2.json; verify_hdmi.py:125; snapshot input.json:36-67 |
| BX-2 QT lead / mating pose | Not re-done. The 250 mm lead is kept, the 60 mm prop is a "starting target". No mate_reach row. My rough polyline (header, front edge, up, encoder, panel 60 mm off) is about 164 mm + 2 x 15 mm allowance, against 240 mm minimum. That is an estimate, not a check. | ASSEMBLY-VERTICAL.md:137-139, 260-261 |
| BX-3 pigtail tie / XT30 reach | Weakened. Four carrier cable ties come back (r7 removed tie points because they cost reach). The rigid pose puts the XT30 face 15 mm below the mouth, which is r7's floor (r7 reached 28.4 mm). No lead_access check. Documented as G-V-PIGTAIL STOP (PHY-11). | ASSEMBLY-VERTICAL.md:62-66, 220-229; power-270-yaw21.json pose 150 note |
| BX-4 lens torque via tab catch | Geometry kept: the same four tine boxes, grown from the roof to z 98. Tine gap 1.2 mm (p2). The roll_catch check is not run. The step-7 text drops the "turn lens and camera back off the tine before s_c4" step (PHY-9). | model.py:237-239; p2.json |
| BX-5 knob press backing | knob_exp is pressed at bench B3 (panel off), but the "thumb behind the encoder" wording is gone. knob_fps cannot be fitted at B3 at all (PHY-5). | ASSEMBLY-VERTICAL.md:154-156 |

## Findings

Severity: BLOCKER / MAJOR / MINOR. Kind: latent (not documented by the candidate) or existing (documented hold/STOP).
Closable-by: docs, checks, cad, measurement, user_decision.

| id | sev | kind | title | evidence | failure scenario | fix | closable-by |
|---|---|---|---|---|---|---|---|
| PHY-1 | MAJOR | latent | Step 2 order is impossible: camera first, then collar with the centring gauge | Seated `centring_gauge` vs `c_cs_adapter` overlap **927.75 mm3** (p1.json; gauge x -3.4..21.0). printed_collar.py:193 "camera not yet in". r7 ASSEMBLY.md:206 "Lens collar first, camera still out". The candidate's own `camera_in` motion has the collar present (verify_candidate.py:108). ASSEMBLY-VERTICAL.md:176-186 puts camera first, collar second. | The builder seats the camera, then cannot push the gauge home. Either the collar is screwed down uncentred, or the gauge is forced against the adapter and the floating camera. | Reorder step 2: inserts, then collar + gauge + s_c1..s_c3 with the camera out, gauge out forward, then camera in (r7 C-8). Add a check: gauge seated pose vs every part present at that step. | docs, checks |
| PHY-2 | MAJOR | latent | `microsd_out` pass is mis-scoped; the panel-off +X route is blocked by the lens collar | verify_candidate.py:112 fixed set is only tub, gs_camera, c_cs_adapter. Probe (+X 0..45, 1 mm): `lens_collar` hit at dx 32..45, 14 samples, max **75.55 mm3**; `power_button` dx 5..27, 23 samples, max 42.414 (matches the documented rejection). The card front is at x -31.5 and must travel 31.5 mm to leave the front face. | REVIEW.md:297 and ASSEMBLY-VERTICAL.md:15-16, 306 allow +X withdrawal with the panel removed. With the collar on, the card stops inside the front slit with nothing to grip. The slit (model.py:273) never passes a card and is an unsealed opening into the bay. | Add lens_collar, lens, panel parts, carrier, x1203 to `microsd_out` (it will fail; keep the fail). Either model and qualify a panel-off "+X about 12 mm, then +Y" path with a named tool, or declare microSD bench-only and close the slit. | checks, cad |
| PHY-3 | MAJOR | latent | Main audit dropped every r7 physical-assembly check | verification.json categories: integrity 45, roundtrip 45, source_binding 71, interference 118, motion 10, probes 13, nominal 7, keepout 1, physical 1. 161 of the 292 passes are bookkeeping. r7 out/checks.json has 36 categories incl. driver, service_driver, mate_paths, mate_reach, handling, j7_float, roll_catch, lens_support, lens_clamp, lead_access, cable_routes, cable_stow, header_housings, evf_restraint, stack_retention. REVIEW.md:302: tool reach "pending". | "292 pass" reads as a broad geometric pass. Defects like PHY-1 and PHY-2 are invisible to it. This conflicts with the rule "never weaken a check". | Port the r7 physical checks to the candidate geometry (driver per step, j7_float over s 0..3, roll_catch, mate_paths with hand/tool corridors, mate_reach, lead_access, header_housings, handling). Report counts by category. | checks |
| PHY-4 | MAJOR | latent | Camera FPC: camera-end mating moment unstated, in-place mating unreachable, no slack store | ASSEMBLY-VERTICAL.md:213-217 connects "both end contacts" at step 5, after the carrier. Camera socket stiffener x -28.09..-25.09, y +-8.5, z 41.25..46.25 (snapshot p_fpc_cam; r7 "before camera_in"). Carrier to camera **3.91 mm** (p1); +Y corridor x -29..-25 at socket height holds 6.08 mm3 of camera (p2). Slack space (manifest bounding boxes; the exact probe p3 could not get the CAD lock in time): r7's FPC store `ko_fpc_loop` (x -42.5..-29.7, y 2..19.5, z 36.6..56) now lies inside the pi5 box (x <= -33.55, y <= 6.2), the x1203 box (x <= -34, y 6.2..16.2) and the carrier box (y >= 16.2). Only a strip about 3.9 mm wide (x -33.55..-29.7) is left behind the camera. | A builder follows step 5 and cannot reach the camera socket through a 4 mm slot. About 120 mm of spare FPC has no reserved place. | Mate the FPC at the camera on the bench before step 2 (r7 order). Pre-fold it, define a reserved slack store and route to CAM1, add an FPC route/stow check. | docs, cad |
| PHY-5 | MAJOR | latent | FPS switch / panel sequence contradicts itself | B3 (ASSEMBLY-VERTICAL.md:154-156) seats the panel over the CK1044 bushing at the bench, fits washer, nut and "the two knobs". Step 4 (:197-199) carries the switch with the carrier, hand-supported. Step 6 (:258-266) moves the panel -Y over the switch and never refits the FPS washer, nut or knob. knob_fps is about 24 mm across (manifest x -122.99..-99.01); the panel hole is r5 (model.py:307). | Done as written, step 4 is impossible (switch is on the panel), or the body is closed with a loose switch, no nut and no FPS knob. The r7 BX-5 "thumb behind the encoder" backing is also gone from B3. | B3: encoder, knob_exp (thumb backing, paper shim) and power button only. Step 6: guide bushing and peg into the panel, fit mounting washer and nut with a socket on axis, then knob_fps with the shim. | docs |
| PHY-6 | MINOR | latent | EVF HDMI and 5 V junction told to mate at step 3, before their source ends exist; carried head drop has zero margin | Step 3 (:191-192) mates the EVF HDMI head and establishes the EVF power junction. The 3556 head and the USB donor half arrive with the carrier at step 4 (verify_hdmi.py:125 carries `evf_head`; step 4 :197 "Keep the EVF HDMI end free"). The carried sweep lowers the head 6 mm; the snapshot stroke is 6.0 and its path drops 12 mm (input.json:36-67). | The builder cannot do step 3, or plugs the head early and drags the ribbon during the carrier slide. During the slide the plug tip passes the receptacle mouth with 0 mm margin. | Move both matings to step 5 (push-up from below, C-3). Re-run the carried sweep with the head at least stroke + 3 mm low (12 mm as in r7). Add a service pliers/finger corridor for unplugging (side zones hold tub material: rear 69.4 mm3, front 132.6 mm3, p2). | docs, checks |
| PHY-7 | MAJOR | latent | USB 5 V donor head leaves 2.72 mm to the rear wall; no room for its cable exit | Head reservation x -152.78..-121.78 (usb2-head-reservation.json, `cable_exit: None`). Head-to-tub distance **2.72 mm**; tub material directly behind its footprint 287.9 mm3 (p2). Jacket OD 3.6 (ASSEMBLY-VERTICAL.md:240). | If the real 4448 overmold exits axially (the usual USB-A form), the jacket must turn 90 deg within 2.7 mm. It cannot, so the plug will not seat, or it is forced against the wall and strains the Pi USB2 receptacle. | Measure the 4448 overmold first. If the exit is axial, use a COTS right-angle USB-A lead, or give at least bend radius + OD behind the exit. Add a cable-exit capsule to the head check. | measurement, cad |
| PHY-8 | MAJOR | latent | Step 4 needs more than two hands; no handling pose, helper or switch retainer | ASSEMBLY-VERTICAL.md:197-206: switch and carrier "separately hand-supported", while the pigtail, fuse and XT30 are fed down the floor passage (:199). FPS-SERVICE-STUDY.md step 5: one hand on the bushing, the other on the carrier. The 300 mm ribbon with the hanging EVF head and the FPC tail must also stay clear. r7 used the `handling` check, rest poses and a helper. | The switch drops on its wires; the pigtail or fuse scrapes the floor passage; the ribbon folds under the carrier. | Printed transport clip holding the CK1044 to the carrier in its checked pose, removable through the open side, or a named helper. Define the body rest pose for step 4. Feed the XT30 before the last part of the slide. | cad, docs, user_decision |
| PHY-9 | MINOR | latent | r7 lens turn-back step lost; J7-R float depends on it | Step 7 (:278-281) says only "verify the metal-tab catch". r7 step 8: turn lens and camera back off the tine before s_c4, then the level check (`lens_turn_back_lint`). Nominal gaps: tine 1.2 mm, camera-tub 0.5, panel catch 2.25 (p1, p2). | After threading the lens the tab stays pressed on a printed tine: the camera touches a printed part in the final pose and the tine keeps a standing preload. | Copy r7's step-8 wording (turn back, s_c4, level check); run the r7 lens lint on this doc. | docs |
| PHY-10 | MINOR | latent | Grip/base service row cannot be done as written | Service row (:307): "free run ... leads before sliding the grip off". The run lead's Pi end is a wall-facing header housing (pins 37/39, y -15.4..-0.4, z 10.5..13.1, under the cooler; snapshot hdr_run_lead_37/39), reachable only with the carrier out. The button end is pre-wired (snapshot p_run_btn). | The run lead cannot be freed in place: the grip is pulled on the lead, or the whole Pi module must come out first, with all its STOPs. | State "Pi module out first" in the grip row, or add a removable inline junction in the run lead near the grip mouth. | docs, user_decision |
| PHY-11 | MAJOR | existing | Battery isolation reach is rigid-only and at the r7 floor; ties reintroduced | Rigid poses: XT30 face at z -125, 15 mm below the mouth (power-270-yaw21.json pose notes). Flexible 270 mm cores, tie retention and finger force are STOPs (power-service-checks.json `remaining_stop`; G-V-PIGTAIL; ASSEMBLY-VERTICAL.md:62-66). r7 BX-3 fix reached 28.4 mm with RTV only. | With the four ties fitted, the tied folds may not let the junction leave the mouth; the pack is then parted blind in the bay, against the isolation rule. | Model ties as fixed points; run an r7-style lead_access check (XT30 face >= 15 mm out with flexible cores). Prefer RTV-only retention. | checks, measurement |
| PHY-12 | MAJOR | existing | Module removal and CSI latch access remain STOPs; every camera service now needs the module out | ASSEMBLY-VERTICAL.md:302-303 STOPs (FPC release through the 12 x 27 slot, pigtail withdrawal, run-lead reach). The camera's +Y leg (x -36.19..-15.49) crosses the carrier frame (x <= -29) and the Pi (x <= -33.55). In the current variant folder, csi-access-checks.json is bound to an older manifest (e8648073...); csi-source-tool-checks.json is bound to the current 53e668d4.... | Back-focus, camera or adapter service needs FPC, HDMI, pigtail and harness work first: a serviceability regression against r7. | Keep the STOP. Remove or rebind the stale csi-access-checks.json. Record the regression in REVIEW. | checks, measurement |
| PHY-13 | MINOR | existing | QT and J2 mating with the panel propped are unmeasured | ASSEMBLY-VERTICAL.md:260-261 ("60 mm prop offset is a starting target"). No mate_reach row. Rough estimate (not a check): about 164 mm route + 30 mm end allowance vs 240 mm minimum lead. | QT plug too short to mate outside the body (r7 BX-2 again). | Run mate_reach for qt and J2 with a placed route. | checks |
| PHY-14 | MINOR | existing | Power-switch nut and its tool are unverified | power_nut_reserve "UNVERIFIED nut reserve OD22x3" (model.py:424); G-V-POWER. Probe: a socket annulus up to OD 28 (bore 19) clears every panel feature (only the 0.01 mm plate contact, 1.7-3.3 mm3, p2). | None found in printed geometry; the real nut AF is unknown. | Measure the nut AF; confirm a thin-wall socket on axis at bench B3. | measurement |
| PHY-15 | MINOR | latent | "Camera pigtail" used for the battery pigtail | ASSEMBLY-VERTICAL.md:199; REVIEW.md:245. | A builder confuses the camera FPC with the 16 AWG battery lead in the step-4 feed. | Say "battery pigtail". | docs |

## Cleared (checked here, no defect found)

| id | point checked | result / evidence |
|---|---|---|
| C-1 | Straight-driver rule, all 11 threaded fasteners at their own step | p1.json: r7 envelope (bit dia 6.5 x 40 + handle dia 30 x 100, from the head top along the screw axis). 0 mm3 against every rigid part present: p_grip/s_j (step 1, with the moved strap), p_carrier1/2 (step 4, with camera, collar, EVF, stack, microSD and the CK1044 on its rest), p_panel1..4 (step 6, all panel parts and knobs), s_c1..s_c3 (step 2, with gauge), s_c4 (step 7, with lens). HDMI ribbon cells (installed and premate) stay at y <= 10.5, clear of the carrier-screw paths (y >= 22.2). Not covered: FPS harness, QT/J2 leads, FPC (unplaced). Stack M2.5 screws are bench work; their access next to the cooler proxy was not checked. |
| C-2 | J7-R float at the exported pose | p1/p2: camera-tub 0.5 mm, camera to tab tines 1.2, camera-panel catch 2.25, camera-collar 3.48, camera-carrier 3.91, camera-power button 6.75, adapter-tub 0.825. All above the r7 rule (0.4 overall). Only the exported s; r7 swept s 0..3 (PHY-3). Holds only after the lens turn-back (PHY-9). |
| C-3 | EVF HDMI in-place push-up (r7 BX-1 lesson) | p2: head box (x -147.6..-143.6, y -3.15..14.15, z 37.3..63.8) clear at dz 0, -6, -12. Push column below it to the floor and a hand corridor from the open side (x -155..-136, y 14.15..28, z 10..37): 0 mm3 of tub, carrier, stack, EVF, switch. |
| C-4 | Tab catch carried over | Same four `tab_catch_boxes()`, z top raised to 98 into the roof (model.py:237-239). `camera_in` passes with the tines present. |
| C-5 | Closed-panel microSD rejection | Reproduced: power_button hits dx 5..27, 23 samples, max 42.414 mm3, same as microsd-service-dependency.json. |
| C-6 | Carrier +Y removal with the camera fitted | `carrier_out` passes (36 samples) with camera, adapter and EVF as obstacles; the carrier passes under the FPS shelf beam. |
| C-7 | Power-switch nut socket access (printed parts) | p2: socket annulus bore 19, OD 24/26/28 from the nut face inward: only the 0.01 mm plate contact (1.7/2.5/3.3 mm3). No panel feature blocks it. |
| C-8 | Panel extraction | `panel_out` passes with knob_exp, encoder, power button and nut moving, after the FPS knob, nut and washer come off (three motion rows pass). |

## Notes

- Method: exact cadquery booleans and BRep distances against the saved STEP files of out/compact-kowa_lm6hc
  (manifest 53e668d4...). Corridors are boxes and cylinders; fingers are not modelled beyond box sizes. Scripts p1-p2
  ran. p3.py (exact FPC-space booleans) is in the folder but never got the shared CAD lock; it was stopped while waiting.
  PHY-4's slack statement therefore uses manifest bounding boxes, so treat it as an envelope result.
- Not checked: FPC route detail (unplaced in the candidate), FPS harness hand coordination (needs a trial), real COTS
  sizes (all proxies), the original-storage and Fujinon variants, upper stack screws vs the real Active Cooler.
- Suggestion: before any fix round, freeze a candidate step list as data (like r7 INSERTIONS/MATE_POSES) and generate
  the guide text and the step-present sets for the driver, mate and handling checks from that one list. Most latent
  findings here (PHY-1, -4, -5, -6) are order errors that such a list would have caught.
