AubergineShallow/digital8mm-vertical-nizo/cad/gs8-d2-v1/candidate-vertical/vent-study/angled-channel-trial/FROZEN-LINKS.md

# Frozen copies in this folder

Notice (review 2026-10-10 VN-15): the Markdown files listed below are a frozen copy: relative links point to the original location. They are kept byte-for-byte as recorded (several are bound by SHA-256 in review evidence), so their relative links are not rewritten and some do not resolve from this folder. `check_links_vertical.py` allows broken links only in the files named here.

| File | Original location |
|---|---|
| `ASSEMBLY-VERTICAL.md` | `cad/gs8-d2-v1/candidate-vertical/ASSEMBLY-VERTICAL.md` of the rejected angled-channel trial; its links resolve from `candidate-vertical/` |
| `BOM-VERTICAL.md` | `cad/gs8-d2-v1/candidate-vertical/BOM-VERTICAL.md` of the rejected angled-channel trial; its links resolve from `candidate-vertical/` |
| `REVIEW.md` | `cad/gs8-d2-v1/candidate-vertical/REVIEW.md` of the rejected angled-channel trial; its links resolve from `candidate-vertical/` |
