AubergineShallow/digital8mm-vertical-nizo/cad/gs8-d2-v1/candidate-vertical/routing-snapshots/hdmi-ck1044-clear-20261009-0524/MATED-CARRY-ADDENDUM.md

# Selected mated carry: supplemental scope

This supersedes the staging narrative in the earlier frozen `SERVICE-SCOPE.md`
where it differs. It preserves the old collision diagnoses and input records.

The selected proposed procedure keeps the Pi HDMI head mated, removes the EVF
end first, and carries the complete premate ribbon with the Pi/carrier. The FPS
pair remains mated; the switch and both complete FPS branches travel with them.
Panel/QT endpoints are released and the fixed run lead is explicitly staged.
An HDMI-only extraction is not permission to ignore those objects or undeployed
stock. Whole-loom and fixed-world staging remain the parent audit's scope.

`fps-mated-carry-context-0556.json` and its frozen generator contain the selected
main200mm FPS route,80mm shared switch loop and complete fanout. Exact tests
against full-width corrected HDMI have zero material intersections in installed,
premate and both-free diagnostic poses, with874,870 and698 narrow-phase checks.
See `fps-mated-carry-context-checks.json`. Mutual geometry remains unchanged when
these complete objects translate together. This does not prove clearance from
fixed objects or an unrelated deployed loom.

`reinforced-carrier-checks.json` binds the reinforced carrier STEP
SHA2560befe19c07e62b430d691c7b263e1b0aeed41f3a254685b7cffe3e1c943dd268.
All three complete HDMI poses pass its material screen; no ribbon cell was
within the1mm expanded carrier box. The premate ribbon and carrier move together,
so that relative result remains constant during their shared translation.

The Pi head+Z6 in-body unplug is a real rejected path. The full positive power
core penetrates the head reservation by0.25mm at its initial pose, and the core
axis enters the head during later diagnostic translation. Installed Pi-mated
head clearance to the same full power axis minus wire radius is2.242431mm.
On-bench Pi-head removal still requires releasing and parking the power loom.

The full300mm HDMI construction,10mm width and0.4mm thickness allowance are
retained. All50 source motion samples conserve300.000000mm analytical length.
The smallest modeled centerline radius is3mm; other post-fold radii remain5mm.
These are geometric choices, not received-laminate qualifications. The new
official socket/adapter datum limitation is recorded separately in
`OFFICIAL-PI5-CORRECTION.md`; no source-bound physical head fit is implied.

The complete camera FPC remains unresolved. Orientation-independent envelope
overlap is not proof of actual ribbon collision, and cannot be reported as
interacting-loom clearance. No blanket service or build release is issued.
