AubergineShallow/digital8mm-vertical-nizo/cad/gs8-d2-v1/candidate-vertical/routing-snapshots/hdmi-ck1044-clear-20261009-0524/SERVICE-SCOPE.md

# Separate the selected carrier sequence from rejected diagnostics

No blanket service pass is established.

## 1. Installed, Pi head mated

The corrected full 300 mm installed ribbon clears the tested rigid solids,
corrected CK1044 terminals and separate cradle hypothesis. It also clears all
modeled round wires, corrected FPS junction/splices, full modeled power cores,
and explicit stock reservation boxes. The actual complete camera FPC is
unresolved; an orientation-independent envelope overlap is not a physical
ribbon-contact verdict.

The Pi head remains mated. Its nominal installed clearance to the closest full
positive-power polyline tube is 2.242431 mm (3.842431 mm centerline-to-head
distance minus the nominal 1.6 mm wire radius). The negative-core gap is
3.450000 mm. This is a bound to the source proxy head, not measured hardware.

## 2. Selected carrier-removal candidate: Pi head stays mated

Remove the panel/QT endpoint connections and the FPS switch first, as specified
by the parent procedure. Disconnect the EVF HDMI end by its 6 mm drop. Carry the
Pi-mated HDMI head, full premate ribbon and loose EVF head with the carrier/Pi
stack. **Do not lift the Pi head 6 mm inside the body.**

The saved rigid audit passes this premate carrier motion at 2 mm samples through
Y+70 mm against the export15 STEP solids and separate corrected cradle. Its
carried geometry includes the rigid HDMI heads, USB Pi head, seven source header
housings and complete premate HDMI strip. It does not include complete moving
flexible QT/FPS/RUN/power/USB/FPC shapes. A moving header housing is not proof
that its connected wire has been freed.

The following exact objects need assigned, verified carried or parked states:

- QT: all GPIO housings/breakout branches, the complete main loom, its released
  panel-side endpoint, any fan-in material, and the released route guides.
  If it travels with the Pi, its full material must be shown through the motion;
  the fixed-QT crossing in the HDMI-only diagnostic is not that intended motion.
- FPS: the Pi-side GPIO housing/branch, the complete nominal 200 mm lead,
  both splice zones, and its loose PicoBlade half must travel or be parked after
  release from guides/support. The detached switch-side bundle, both terminal
  branches, switch and mating PicoBlade half must be removed or parked outside
  the moving corridor. The unsupported junction volume alone does not establish
  a carried state.
- Power: isolate/disconnect the battery using its separately validated procedure.
  Model the complete positive and negative allocated paths, fuse, loose housing,
  both board/root regions and all released printed guides. If the entire released
  loom travels rigidly with the stack, its head-relative installed gap is retained;
  its motion through the body/floor and actual flexibility still need checking.
- USB 5 V: include the full 200 mm lead, EVF-end release, diode/PH hardware,
  strain relief and all stored stock. Carrying only the Pi USB head is incomplete.
- Fan: both endpoints and the full native lead belong to the moving Pi/cooler
  assembly; include them in the final carried bundle check.
- RUN: the button stays fixed. Either release the corresponding GPIO housings
  before carrier motion or prove full deployment of the two retained 250 mm
  wires while tethered to the button. The saved moving-header test proves
  neither option and must not be treated as permission to ignore these wires.
- Camera FPC: the camera stays fixed unless a different procedure explicitly
  removes it. Release at a measured accessible connector and park the complete
  200 mm strip/stiffeners, or prove a complete tethered deployment. The actual
  root/latch access and the 87.119246 mm unshaped stock remain open.
- Power-button loom and other panel/native flexible stock: explicitly release
  the removable connection and park or carry its full stock. The unmeasured J2
  root and volume-only storage are not a completed service state.

The next proof is a combined full-loom carrier-motion snapshot showing these
objects and release states, with the Pi HDMI head still seated. This task does
not invent missing stock geometry or claim this combined proof is complete.

## 3. Rejected both-heads-free, fixed-neighbor diagnostic

The diagnostic raises the Pi head 6 mm in the crowded body, drops the EVF head
6 mm, then translates only the HDMI assembly while neighboring looms stay fixed.
It is **not** the selected carrier-removal sequence.

The Pi head already penetrates the nominal positive-power tube by 0.250 mm at
Y0. During Y+6 through +22 mm the positive-core centerline itself enters the head
box; a nominal clash remains at Y+24 mm. This independently rejects in-body
Pi-head unplugging with the power loom in its installed shape. On-bench Pi-head
removal must first release/park that loom; no undeveloped staging is assumed.

The translating strip also meets fixed QT at Y+4 through +14 mm and fixed
Pi-side FPS main at Y+12 through +24 mm. These are required staging constraints,
not proof that the intended carried-looms procedure fails. The unknown camera
FPC envelope also interacts. The rigid-only both-heads-free test can never waive
these flexible-looms or unmodeled-stock gates.

Evidence: `solid-checks.json`, `context-checks.json`,
`power-head-distance-complete.json`, and `FPC-NEXT-DATUM.md`.
