AubergineShallow/digital8mm-vertical-nizo/cad/gs8-d2-v1/candidate-vertical/structural-review/output/pdf/D2-shadow-plenum-structural-supplement.pdf

Review candidate | 53e668d4 | All physical gates remain open | 1

# D2 shadow plenum structural supplement

Compact Kowa candidate | 9 October 2026 | Separate supplement to the historical structural report

The selected housing adds 32.72 g in the planning mass model. The same analytical assumptions raise J4 floor moment by 4.82% and conservative grip moment by 3.79%. The revised proposed equal-share J4 coupon screen is 0.95 N m.

PRINT HOLD: the front mouth removes first-roof frame support over Z5..40. A nominal 10.7 mm distance there is not a two-ended supported span; raster direction may require about 35 mm bridging. The expanded coupon includes it, but slicer, bridge and cleanout evidence remain open.

Unqualified review only. No FEA, drop rating, print test or physical strength result is claimed. All 56 inherited physical gates and collar M1 remain open.

Planning quantity | Reviewed export18 | Shadow plenum
Complete mass | 831.38 g | 864.10 g
Tub / panel mass | 122.58 / 37.41 g | 154.59 / 38.12 g
Upper-body mass | 640.43 g | 673.15 g
Upper-body 5g floor moment | 1.7201 N m | 1.8031 N m
Conservative grip 5g moment | 4.4751 N m | 4.6449 N m
Carrier payload | 122.60 g | 122.60 g (retained)

Estimated complete CoM: (-46.37, 0.92, 29.90) mm. Core: 158 x 63.6 x 100 mm. Manifest mesh-derived complete bounds: 248.83 x 72.82 x 216.82 mm. These are CAD/proxy figures, not a weighed or measured camera.

### Assumptions retained

Only tub and panel manifest rows change. The upper-body first-moment change is taken from the difference between complete manifests; the excluded lower components stay fixed. Grip screening places the whole assembly mass at the upper-body CoM, with hand reaction at Z=-55 mm. The 1g/3g/5g cases are quasi-static handling sensitivities, not drop ratings.

Tub/panel mass retains ASA density 1.07 g/cm3 and the empirical 0.85 mass factor. That factor is not stiffness or slicer mass. The 12 g connector/fuse/pigtail lump has unresolved distribution; other harness masses remain omitted. Weigh actual parts and the loaded assembly before setting qualification loads.

### Retained sections under the new load

Equal-share J4 nominal lip/head screens are 8.92/9.86 MPa; 30-70% station sharing scales these by 0.6-1.4. Grip gross stresses are 1.58/1.68 MPa. The unchanged carrier screen remains 3.39 MPa and 0.399 mm at E=1600 MPa and half of the 5g payload reaction.

Adding the retained 12 g-at-Z100 wiring sensitivity gives 0.9309 N m per equally sharing joint. Round upward to the proposed 0.95 N m inert-coupon screen after fixture review. The old 0.90 N m target is insufficient; 70% reaction would be 1.3033 N m and remains a separate unqualified case.

Review candidate | 53e668d4 | All physical gates remain open | 2

# Print and thermal holds

The selected geometry and its limitations

The 1.6 mm integral skin and support posts cover a 6 mm plenum gap, while the original 2.5 mm wall forms the roof in the -Y-face-down print pose. Keep the current 0.20 mm layer starting point and original part orientations. Nominal 8 mm post spacing does not establish the largest bridge span or two-ended support for every roof extrusion.

Inspect first roof layers, post bonds, sag, slot/mouth area and debris-removal paths in the slicer and actual coupons. The front-mouth band interrupts the frame beneath the first roof layer. Automatic support trapped inside the full plenum is unacceptable. The plain 2.8 mm panel removes four former blind grooves with 0.2 mm floors; it still needs flatness and screw-seat checks.

### Two new open-edge coupons

Generated STEP/STL inspection crops are 48 x 32 x 10.1 mm (regular grid) and 110 x 100 x 10.1 mm (ports, CSI sleeve, post exclusions and front/top edge regions). Both saved STEP crops are valid single solids. They are separate from the nine production pieces and the prior nine structural coupons. Neither has been sliced, printed or tested. Cut-open edges cannot prove closed-body cleanout; the larger crop omits the complete rear region and does not prove a global maximum unsupported span.

### Occlusion and airflow remain unqualified

Test unobstructed reference, normal hand positions, fitted strap positions and stand/support contacts separately under the inherited thermal qualification program. Blocking the hot underside mouth leaves only 210 mm2 at the front versus 510 mm2 of hot wall slots, before internal losses. The 534 mm2 gross outlet sum cannot be credited in that case. No rated blocked-vent operation is established.

The smallest named sampled hot horizontal section is 299.4 mm2, not a proven global hydraulic minimum. External cold/hot/CSI void separation excludes the main cavity and does not seal its baffle, CSI bypass or grip communication. Actual cooler registration, fan operating point, complete wiring, pressure loss, useful flow and closed-body battery temperature remain open.

### Material and structural scope

Retain E=0.8/1.6/2.4 GPa and 5/10/20/30 MPa strength scenarios only as sensitivity cases, never allowables. Layer bonds, notches, preload, warm creep, wear and impact remain unmeasured. Matching unchanged manifest rows is metadata consistency, not a new occupied-solid equivalence test. Old whole-tub/panel zero-difference bindings do not apply to the skin, plenums, divider, posts or CSI sleeve. No factor of safety is certified.

### Source receipt

Selected mechanical manifest

53e668d43847acd1f59d2b559a562476c54a23db0918debd482d632f0e8ceb77

Frozen export18 reference manifest

c9e1e20710bb5f947ad47fa62328cebffb099fd3832d22909056bf8f1867cc76

Saved STEP plenum report SHA-256

a4c4fdc1170a8c4a9488b539ea2b6eaf5a3e2387253d01893a103a13696d65ba
