AubergineShallow/digital8mm-vertical-nizo/cad/gs8-d2-v1/candidate-vertical/out/compact-kowa_lm6hc/renders/rear.png

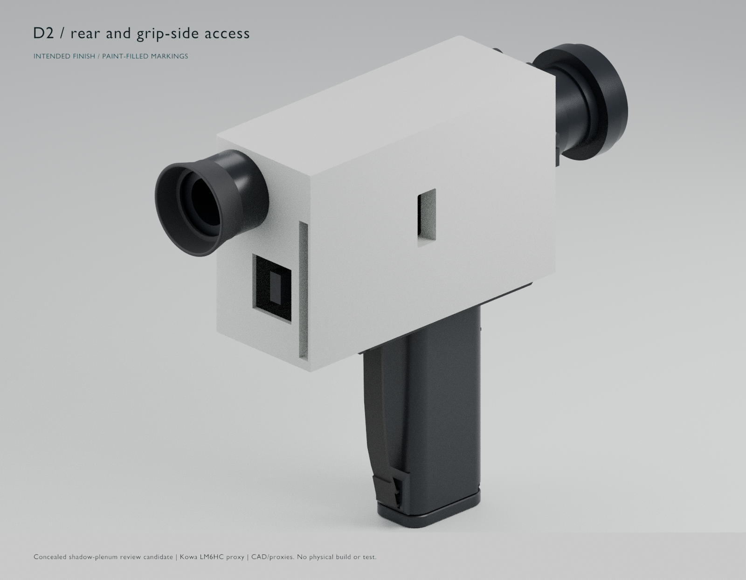
cad/gs8-d2-v1/candidate-vertical/out/compact-kowa_lm6hc/renders/rear.png
