AubergineShallow/digital8mm-vertical-nizo/cad/gs8-d2-v1/candidate-vertical/structural-review/tmp/pdfs/supplement-1.png

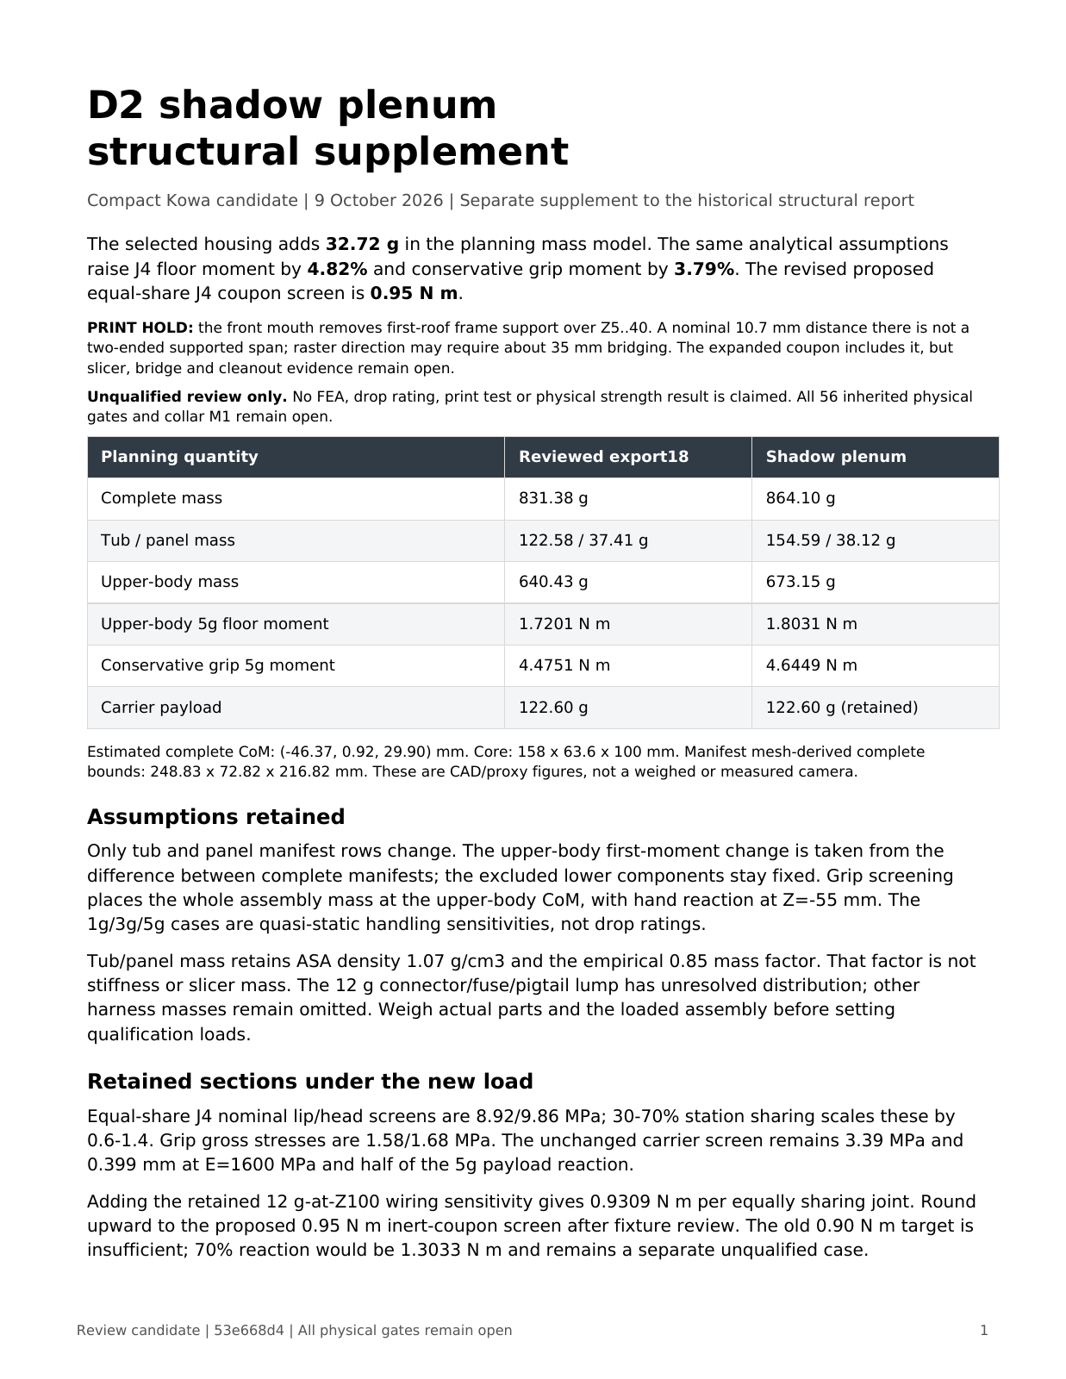
cad/gs8-d2-v1/candidate-vertical/structural-review/tmp/pdfs/supplement-1.png
