AubergineShallow/digital8mm-vertical-nizo/cad/gs8-d2-v1/candidate-vertical/vent-study/angled-channel-trial/renders/vent_side.png

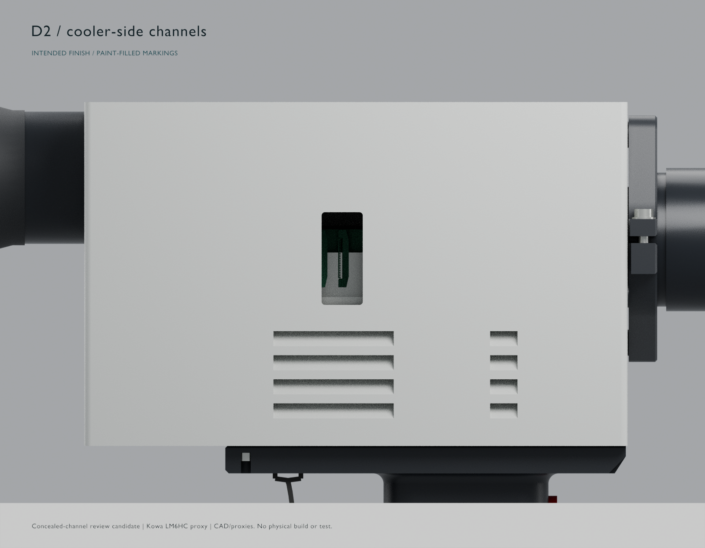
cad/gs8-d2-v1/candidate-vertical/vent-study/angled-channel-trial/renders/vent_side.png
