AubergineShallow/digital8mm-vertical-nizo/cad/gs8-d2-v1/candidate-vertical/vent-study/D2-concealed-vent-comparison.png

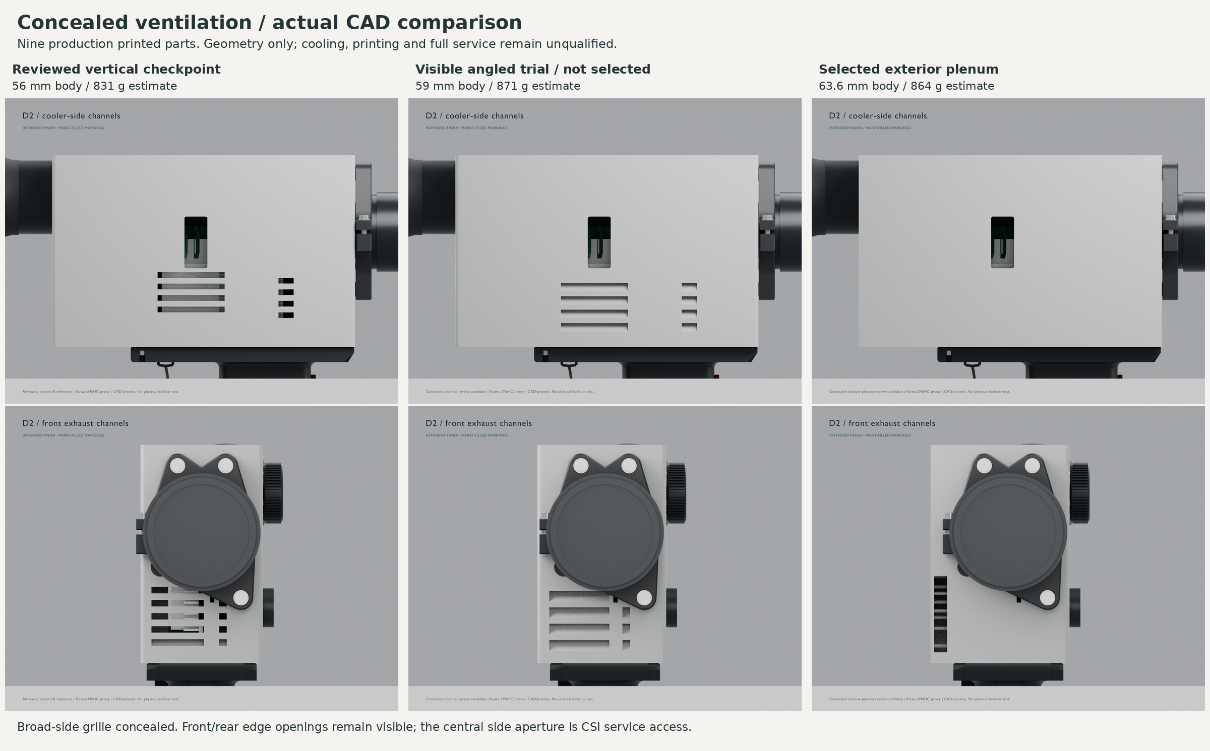
cad/gs8-d2-v1/candidate-vertical/vent-study/D2-concealed-vent-comparison.png
