AubergineShallow/digital8mm-vertical-nizo/cad/gs8-d2-v1/candidate-vertical/vent-study/reviewed-export18-renders/vent_front.png

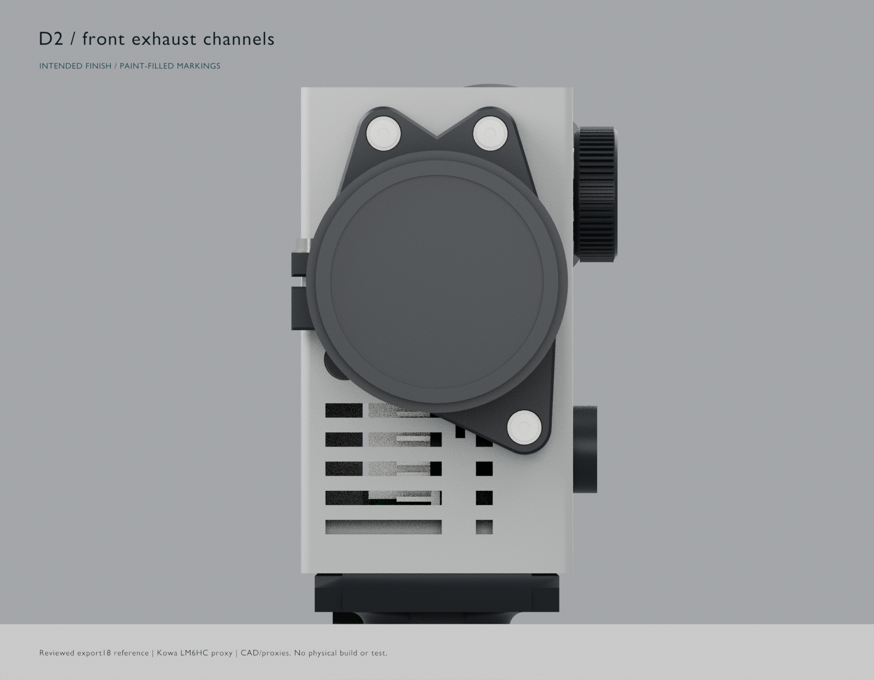
cad/gs8-d2-v1/candidate-vertical/vent-study/reviewed-export18-renders/vent_front.png
