AubergineShallow/digital8mm-vertical-nizo/cad/gs8-d2-v1/candidate-vertical/BOM-VERTICAL.md

# Vertical Pi candidate: complete review BOM

**Unqualified review candidate. Do not procure or fabricate from this list yet.** No costs or stock claims. Baseline commit `d38468e58eb2b02d56743e2e0cfdd8f780818a65` is preserved. Sharing review artifacts does not authorize procurement or production release.

Generated by `make_bom_vertical.py`, reading the unchanged baseline generator’s `LINES`; every baseline line is retained, including explicit replaced/removed/optional rows. Candidate assembly and notes supersede old step numbers. The CSV carries separate installed units, purchase units, spares and included-in fields.

## Current checkpoint: assembly STOPs

- Current compact ventilation geometry: shadow-gap plenum trial2 (flow ribs, 45 deg cold-mouth lintels, mullions, skin bed chamfer). Core 158 x 63.6 x 100 mm. Geometry identity: ec60b42dee2487c17f67aab9561451d146ab137fdd88cc3dcf20a39a96917715. The panel is plain 2.8 mm; four former grooves had blind 0.2 mm floors, not through-vent area. Nine printed production parts are unchanged from reviewed export18; the purchased selections and quantities that differ from it are listed under "Purchase changes against reviewed export18" (computed from history/reviewed-export18/BOM-VERTICAL.csv).
- Current full scoped-report set is not yet bound to this manifest and current verifier sources. Do not import historical pass counts; inspect each report and its binding before use.
- Reviewed export18 is frozen history, manifest c9e1e20710bb5f947ad47fa62328cebffb099fd3832d22909056bf8f1867cc76. Its 288 pass / 2 fail / 18 info, six scoped HDMI passes, 332 clear FPS material checks plus nine separate clear keepout diagnostics and other service checks are not automatically current evidence for the shadow-plenum tub. Read the new manifest-bound ventilation report and structural supplement for this revision.
- Retained unresolved failure: active cooler/source-Pi witness (no main-audit report is bound to this manifest; see verification.json once rerun). The old right-wall ray runs through the intentional CSI opening and does not measure adjacent wall thickness. The new checker records that location as expected-empty and separately probes outer skin and original wall; read its manifest-bound result for the current count. The original 288/2/18 result and old wall supplement remain historical. The former 11.669 mm3 Boolean-difference witness is not an established lost-material volume; the Pi raw component-volume sum is not occupied material. Full FPC and EVF donor wire routes remain unplaced. Storage plug keepout is non-material; actual mating stays open.
- Pigtail convention: positive 270 mm is the FINISHED PATH including a 20 mm rigid fuse/joint-sleeve zone; both 270 mm total path budgets include unresolved pad-root allowances; they are not extra length to add later. Actual copper cuts/overlaps and offcuts are not established. Buy one 914.4 mm stock length per colour; full flexible deployment remains unqualified.
- Conservatively charging both paths as 270 mm copper gives 0.142811 V at 8.6 A with copper at 60 C, just 7.2 mV below G-W5 before hot fuse/contact uncertainty. This nominal calculation is not a pass.
- PRINT HOLD: the front mouth removes first-roof frame support over Z5..40. The nominal 10.7 mm distance is not a two-ended supported span; raster direction may require about 35 mm bridging. The expanded coupon contains the region, but slicer/bridge/cleanout qualification remains open.
- Intact 300 mm HDMI selected; fragile 200 mm study rejected. Limited geometry checks do not qualify the full interacting loom or service.
- CSI slot remains straight 12 x 27 mm R1 (323.14 mm2) and unsealed. It bypasses the intended cooling path. Current declared cylinder clearances do not establish actual latch/jaw/FPC/cooler access, which remains on HOLD.

The detailed service evidence applies to selected compact Kowa. Fresh shadow-plenum compact Fujinon and original-storage Kowa exports have their own source/file, mesh, assembly-envelope, mass/CoM and core-void comparisons in out/comparison/assembled-comparison.json and the three volume reports. Their full service/harness audits were not rerun; compact-Kowa service results do not transfer. Export18 alternative main audits remain historical.

## Count rules

- Filter to one storage variant; compact and original drives are mutually exclusive.
- Installed is the planned in-camera quantity after qualification. It is not evidence anything was built.
- Buy is a planning provision, not an order. Zero for printed items and included-kit constituents.
- Included rows decompose a parent kit or harness. Never add both a parent assembly and its constituents to claim a physical total.
- Workshop tools and spools are outside the camera; consumption and slice masses remain unmeasured.
- Qualification aids are separate: retain the nine prior structural coupon pieces. A preliminary regular-grid open-edge plenum coupon STEP/STL is generated; its open edges do not prove closed-body cleanout or represent all ports/CSI/post exclusions. The expanded feature-region crop is also generated, giving two plenum coupons total. Neither has been sliced, printed or tested; neither establishes every unsupported span or closed-body cleanout. Coupons are neither additional production parts nor purchased items.

| Count | Baseline | Compact candidate | Original-storage candidate |
|---|---:|---:|---:|
| Installed printed production parts | 12 | 9 | 10 |
| Installed PT body screws | 7 | 7 (4 panel + 2 carrier + 1 grip) | 7 |
| Installed lens M3 screws / washers / inserts | 4 / 4 / 4 | 4 / 4 / 4 | 4 / 4 / 4 |
| Installed stack screws / standoffs | 8 / 4 | 8 / 4 (4 old + 4 longer screws) | 8 / 4 |
| Functional harnesses, including kit leads | 10 | 11 | 11 |
| HDMI purchased pieces for one cable assembly | 1 | 3, intact 300 mm ribbon | 3, intact 300 mm ribbon |

The new power signal switch, removable junction and longer carrier screws trade extra purchased parts and bench work for removal of the printed plunger/linkage and side extraction of the whole stack. This is not an overall purchased-part reduction.

Mass caveat: the legacy XT30 row carries a 12 g lump that includes an estimated pigtail mass concentrated at the rigid proxy. Other harness masses are excluded. Thus not all wires are excluded, and the mass distribution/centre of mass is not fully resolved.

Use the chosen manifest and its ventilation report for passage geometry and normal throat definitions; earlier visible angled-channel figures are not transferable to a new plenum. The straight CSI slot remains an unsealed bypass, and the source-driven floor passage adds body/grip air communication. Useful flow, pressure loss, hand occlusion, print/support quality and battery/thermal performance remain unqualified. Integral passages add no purchased fan, mesh, seal or duct part. See structural-review/CONCEALED-VENT-STRUCTURAL.md for the manifest-bound mass/load sensitivity; old whole-tub binding does not apply.

## Installed pieces by category (not a grand total)

| Category | Installed count and contents |
|---|---|
| Printed production pieces | Compact 9; original-stick 10 including sleeve. Gauge/coupons excluded. Integrated FPS rest/guide do not add loose pieces. The tub is printed as two pieces (body + bonded +Y tab-catch stub, T2) and counted once. |
| Body screws | 7 PT: four panel, two carrier, one independent grip lock. |
| Stack hardware | 4 standoffs + 4 retained upper M2.5 x 5 + 4 replacement lower M2.5 x 8 = 12. Removed lower screws are not installed. |
| Cooler mounting | 2 supplied push pins, not four illustrative proxy feet. Other cooler/fan internals stay inside the purchased assembly count. |
| Lens mounting | 4 M3 screws + 4 washers + 4 inserts = 12. |
| Tripod mounting | 1 captured 1/4-20 nut. |
| Control mounting | Planned 5: FPS nut, mounting washer, stop/tang washer; power nut and washer. Inclusion/actual dimensions remain receipt gates. Encoder support is integral; no invented loose hardware. |
| Standalone purchased cable/connector inputs retained in six harnesses | 15 assembly/section inputs: FPC 1; HDMI heads/ribbon 3; USB donor 1; EVF RCY halves 2; QT donor sections 2; GPIO donor stubs 2; FPS Molex halves 2; J2 keyed halves 2 (each one housing plus two pre-crimped leads; family default pending user decision 13). Two GPIO stubs come from one 20-wire pack; this is not 15 separately ordered packages. |
| Camera battery pigtail | Separate seventh external harness: two cut 16 AWG cores, one camera XT30 female and one inline fuse. Copper cuts/overlaps remain TBD; stock wire is not an installed cable assembly. |
| Included/native leads | 4: cooler fan, OLED flex, run-button lead, pack lead. Total functional harnesses = 6 + 1 + 4 = 11. |
| Explicit inline pair constituents | EVF, FPS and J2 together: 6 housings and 12 factory contacts, already inside the six half-assemblies above. GPIO donors add 2 retained housings/2 contacts, also already counted. Do not add them again. |
| Retention/insulation consumption | Four allocated power-slack ties; no FPS service tie. Two USB data-core sleeves, optional shield sleeve only if present, plus two FPS splice sleeves and other required joint insulation. Final tape, RTV, sleeve and wire cuts are unquantified. |

No grand physical-part total is claimed: board/kit internals, purchased assembly internals and measured consumable cuts are not decomposed consistently. Tools, optional quantity-zero rows, spares, offcuts and non-material keepouts are excluded from these installed counts.

## Solder-joint accounting

| Operation | Planned joints |
|---|---:|
| Legacy generator tally: X1203 pads 2, fuse splice 2, EVF lead 3 (two diode/positive joints and one ground splice), encoder A0 1, 18/24 lugs 2, EVF board pigtail 2 | 12 |
| QT splice explicitly required by baseline WIRING W-QT but absent from legacy tally | 4 |
| Loose camera-side XT30 female terminations, absent from legacy tally | 2 |
| New J2 signal lead: two Pi pads and two switch terminals | 4 |
| FPS GPIO donor-stub to PicoBlade blunt-wire splices | 2 |
| Planned total, supplied pack male, spliced QT, FPS donor splices, preterminated J2 pair | 24 |

Add two only if the supplied pack lacks its XT30 male. A verified one-piece QT cable removes four. Optional EVF option C is excluded; its additional parts/joints are still a separate decision. Four J2 connector contacts are preterminated, so they are not four further solder joints. This tally is an operation-level plan, not a completed harness audit or physical qualification.

## Harness inventory

`fpc`, `hdmi`, `usb_5v`, `oled_flex`, `qt`, `run_lead`, `fps_lead`, `pigtail`, `fan`, `pack_lead`, `power_button`. Two HDMI adapters plus a ribbon remain one functional harness; the two QT source cables become one; the J2 pair adds one.

## A. Electronics, optics, power

| Line / variant | Item and SKU | Installed | Buy | Spares / included | Qualification and source |
|---|---|---|---|---|---|
| D2-01 / both | Raspberry Pi 5, 8 GB; SC1432 (8 GB, prices.json); layout pn SC1111/SC1112 | 1 ea | 1 ea |  | inherited; unqualified. Same board, physically rolled into a vertical XZ PCB plane; no replacement compute platform. [Source](../../../electronics/gs8-d2-v1/make_bom.py) |
| D2-02 / both | Raspberry Pi Active Cooler; SC1148 | 1 ea | 1 ea |  | inherited; unqualified. Inherited specification; baseline source line D2-02. Candidate assembly sequence supersedes baseline step numbers. [Source](../../../electronics/gs8-d2-v1/make_bom.py) |
| D2-03 / both | Geekworm X1203 UPS board (pogo pins, 1S input, 5.1 V 5 A) with its M2.5 standoff kit; X1203 | 1 ea | 1 ea |  | inherited; unqualified. One UPS purchase includes four standoffs and eight original M2.5 x 5 screws. Install four original upper screws and four replacement M2.5 x 8 lower screws (V-31); bag the four removed lower screws. Included detail below is not another purchase. [Source](../../../electronics/gs8-d2-v1/make_bom.py) |
| D2-04 / both | microSD card, A2 class, 32-64 GB (OS only, front slot); A2 class | 1 ea | 1 ea |  | inherited; unqualified. Fit the OS card on the bench before carrier insertion; it stays with the carried stack. The closed-panel +X extraction path intersects the panel-mounted power-switch body. Remove the panel and verify actual reach before withdrawing the card, or service it on the bench with the complete module. The panel-off sweep is not a closed-body access pass. [Source](../../../electronics/gs8-d2-v1/make_bom.py) |
| D2-05 / both | Raspberry Pi Global Shutter Camera (IMX296) with its C-CS adapter; SC0926 | 1 ea | 1 ea |  | inherited; unqualified. C-CS adapter included. Remove tripod block and its two supplied screws at supported optical bench setup; bag them. Never react lens torque through PCB or cover. [Source](../../../electronics/gs8-d2-v1/make_bom.py) |
| D2-06 / both | C-mount lens: Kowa LM6HC 6 mm f/1.8 1 in (default, 215 g); LM6HC | 1 ea | 1 ea |  | inherited; unqualified. Default review geometry only; final lens decision and measured support band remain open. M1 remains open for the revised collar. [Source](../../../electronics/gs8-d2-v1/make_bom.py) |
| D2-06b / both | Alternative lens: Fujinon HF6XA-5M 6 mm (100 g); order instead of D2-06; HF6XA-5M | 0 ea | 0 ea |  | optional; not adopted. Alternative, not an additional installed lens. Requires its own measured support band and collar; no baseline CoM claim is carried into the vertical candidate. [Source](../../../electronics/gs8-d2-v1/make_bom.py) |
| D2-07 / both | EVF-A display kit: Hicenda HMX039 0.39 in 1024x768 micro-OLED + HDMI board (option "Display+HDMI Board+Prism"); Hicenda Tindie kit | 1 kit | 1 kit |  | inherited; unqualified. One kit purchase covers OLED emitter, driver board and native flex; included detail below is not a second purchase. Identity, power range and flex/service gates remain open. [Source](../../../electronics/gs8-d2-v1/make_bom.py) |
| D2-08 / both | EVF-A eyepiece: Display Components 0PE039-16X glass eyepiece; 0PE039-16X | 1 ea | 1 ea |  | inherited; unqualified. Inherited specification; baseline source line D2-08. Candidate assembly sequence supersedes baseline step numbers. [Source](../../../electronics/gs8-d2-v1/make_bom.py) |
| D2-09 / original only | SanDisk Extreme PRO USB 3.2 solid state flash drive, 256 GB; SDCZ880-256G | 1 ea | 1 ea |  | fallback; unqualified. SDCZ880-256G retained only with 185 mm original-storage body and sleeve. Do not buy with V-09 for one camera. Warm sustained G-W10 still required. [Source](../../../electronics/gs8-d2-v1/make_bom.py) |
| D2-10 / both | Adafruit 5880 I2C STEMMA QT rotary encoder (encoder pre-soldered); Adafruit 5880 | 1 ea | 1 ea |  | inherited; unqualified. Bridge A0 to select I2C address 0x37; same exposure control. [Source](../../../electronics/gs8-d2-v1/make_bom.py) |
| D2-11 / both | 18/24 selector: Lorlin CK1044 imperial PCB rotary switch with adjustable stop; Lorlin CK1044 | 1 ea | 1 ea |  | conditional corrected selection; physical integration/service unqualified. Replaces inconsistent inherited CK1049/6.35D description. CK1044 is 1 pole, 12 positions, BBM, silver contacts, PCB pins, standard 30-degree indexing; set supplied stop/tang washer to two adjacent positions and verify continuity. Body diameter 27.5 mm, mounting face to rear body 14.1 mm and PCB pin ends 18.1 mm. Preserve all 13 terminals, including unused ones; actual pin section/clocking remain receipt gates. Imperial bushing 9.52 mm x 32 TPI projects 8 mm; shaft diameter 6.35 mm, across-flat 5.5 mm, stock length 38 mm from mounting face with 30 mm end flat. Proposed cut 11.8 mm from mounting face gives about 3.55 mm flat engagement after 0.25 mm bushing clearance; measure actual stack before cutting and coupon-test knob fit/removal force. Corrected candidate knob is 24 mm diameter, with adjacent 30-degree detent markings. Common A and throw 2 give open/high 18 and closed/low 24 under existing software, only after real continuity confirms numbering. Nut, mounting washer and stop/tang washer are separate planned constituents; mounting-washer inclusion and all hardware dimensions remain receipt gates. Do not lose or reset the stop ring during knob/nut/panel removal. [Source](https://lorlinelectronics.co.uk/wp-content/uploads/2020/11/CK-ROTARY-Nov-2020-1.pdf) |
| D2-12 / both | Run button: pre-wired momentary, red cap, female-socket leads; Squid Button (non-latching) class | 1 ea | 1 ea |  | inherited; unqualified. Prewired record/run button; its lead is included, not a separate purchase. GPIO26, pins 37/39 unchanged. [Source](../../../electronics/gs8-d2-v1/make_bom.py) |
| D2-13 / both | 1S2P 18650 pack: 2 high-drain cells (>= 10 A class), BMS >= 10 A, 18 AWG lead, XT30U male, pull ribbon; 1S2P custom (Molicel P28A / Samsung 35E class) | 1 ea | 1 ea |  | inherited; unqualified. Pack, BMS, existing 60 mm 18 AWG lead and XT30 male retained. Check the numeric R-PACK-BMS specification in baseline WIRING; no 2S or other power architecture substitution. Battery is physically disconnected before any internal service. [Source](../../../electronics/gs8-d2-v1/make_bom.py) |
| D2-14 / both | XT30U connector pair (female for the pigtail; male if the pack lacks one); Amass XT30U | 1 female connector | 2 pair | 1 spare female + 2 loose male connectors when pack already has its male | inherited; unqualified. Buy two pairs as baseline provision. Fit one female to the camera pigtail; pack-side male is included with D2-13. Loose males are not additionally installed; one can replace a missing pack male (+2 joints). [Source](../../../electronics/gs8-d2-v1/make_bom.py) |
| D2-14F / both | Inline fuse 15 A, very fast, axial PICO II, 32 V (pigtail + conductor near the XT30 female; W-10, r4); Littelfuse 0251015.MXL (DigiKey F2352-ND) | 1 ea | 2 ea | 1 spare fuse | inherited; unqualified. Retain 15 A axial fuse near the XT30 female in the positive pigtail conductor. ONE installed inline fuse; legacy side-mounted duplicate is removed from the proxy. Frozen 21-degree yaw/45-degree pitch pose and source-driven swept floor passage are integrated. Export18 rigid-power report: 201 poses/659 queries/zero hits. This is not a complete flexible-harness service pass. Flexible-path deployment, actual copper cuts/overlaps, pad/pin exits, retention and hot-drop remain STOPs; positive 270 mm finished path includes the 20 mm rigid fuse/joint-sleeve zone. [Source](../../../electronics/gs8-d2-v1/make_bom.py) |
| D2-15 / both | Hand strap, 12 mm webbing with buckle; class | 1 ea | 1 ea |  | inherited; unqualified. Same hand strap; upper anchors move 12 mm in Y and 18.5 mm rearward in X. Check access with the strap installed. [Source](../../../electronics/gs8-d2-v1/make_bom.py) |
| D2-16 / both | Schottky diode 1N5817 (EVF 5 V lead, W-3; baseline feed); MCC 1N5817-TP | 1 ea | 2 ea | 1 spare diode | inherited; unqualified. Baseline EVF feed provision only; G-W6 remains open. The vertical redesign does not qualify this feed or adopt the optional regulator. [Source](../../../electronics/gs8-d2-v1/make_bom.py) |
| D2-16R / both | Candidate (option C, WIRING s4.8; qty 0 until the user adopts it or G-W6 fails): LDO, adjustable 500 mA, set to 4.553 V by D2-16D (R-EVF-REG band 4.459-4.638 V from datasheet limits); TI TLV75801PDBVJ (SOT-23-5) or TLV75801PDRVR (WSON-6, reflow) | 0 ea | 0 ea |  | optional; not adopted. Baseline EVF-feed option C retained at quantity zero; not adopted. See WIRING section 4.8 and G-W13. No geometry, power or thermal qualification is implied. [Source](../../../electronics/gs8-d2-v1/make_bom.py) |
| D2-16D / both | Candidate (option C): divider resistors for D2-16R, R1 11.5 kohm + R2 1.58 kohm, 0.1 %, 0603; thin film 0.1 % class | 0 ea | 0 ea |  | optional; not adopted. Baseline EVF-feed option C retained at quantity zero; not adopted. See WIRING section 4.8 and G-W13. No geometry, power or thermal qualification is implied. [Source](../../../electronics/gs8-d2-v1/make_bom.py) |
| D2-16C / both | Candidate (option C): MLCC CIN 2.2-4.7 uF + COUT 4.7 uF, X7R, 16 V, 0805 (TLV75801P; the XC6220 would need 10 uF + 10 uF, 1206 25 V); class | 0 ea | 0 ea |  | optional; not adopted. Baseline EVF-feed option C retained at quantity zero; not adopted. See WIRING section 4.8 and G-W13. No geometry, power or thermal qualification is implied. [Source](../../../electronics/gs8-d2-v1/make_bom.py) |
| D2-16P / both | Candidate (option C): small SOT-89 carrier PCB with copper (est. 16 x 7.5 x 4.5 sleeved envelope reserved on the installed usb_5v route (routes.py FEED_VOLUMES); carrier not measured); SOT-23-5 / WSON-6 carrier with copper pour (custom; no 4.5 V module found) | 0 ea | 0 ea |  | optional; not adopted. Baseline EVF-feed option C retained at quantity zero; not adopted (default pending user decision 10, VN-80). Its 16 x 7.5 x 4.5 mm reserve is kept free on the installed usb_5v route, centred in the diode splice zone it would replace (harness feed_volumes usb_5v_option_c_reserve). See WIRING section 4.8 and G-W13. No power or thermal qualification is implied. [Source](../../../electronics/gs8-d2-v1/make_bom.py) |
| V-09 / compact only | Princeton USB-A portable SSD, 500 GB; PHD-USSD-500G | 1 ea | 1 ea |  | candidate; unqualified. Primary compact candidate under review. Official 34 x 15 x 7 mm INCLUDING CAP, about 5 g; model reserves full 34 mm outside port X=-122 to -156 plus assumed mating plug. Remove and bag cap. Advertised maximum write/read 500/600 MB/s, operating 0-70 C; no Linux claim in vendor OS list. G-W10 >=100 MB/s warm sustained, Linux/USB compatibility, power, identity, dimensions and availability all remain gates. [Source](https://www.princeton.co.jp/product/storage/phdussd.html) |
| V-09S / compact only | Studied alternative: Samsung FIT Plus 256 GB; MUF-256AB | 0 ea | 0 ea |  | studied; not recommended or adopted. Retained research record only. Up-to-110 MB/s advertised sequential write offers little headroom against >=100 MB/s warm sustained G-W10. Prior conservative 23.6 x 18.8 x 7.3 mm reserve is not the primary compact storage model. [Source](https://download.semiconductor.samsung.com/resources/data-sheet/2024_Samsung_Data_sheet_UFD_FIT_Plus_v1.2_10139817901318.pdf) |
| V-17 / both | Normally-open black momentary panel power switch; Adafruit 1505 | 1 ea | 1 ea |  | candidate; unqualified. Switch plus supplied fixing nut/washer, receipt check required. Signal switch across Pi 5 J2; same onboard-button semantics, not battery isolation. Full rear 29.4 mm reserve plus 5 mm button; drawing conflicts remain open. [Source](https://www.adafruit.com/product/1505) |

## B. Cables and leads

| Line / variant | Item and SKU | Installed | Buy | Spares / included | Qualification and source |
|---|---|---|---|---|---|
| D2-20 / both | Pi 5 camera cable Standard-Mini 22-to-15 pin, 200 mm; official 200 mm | 1 ea | 1 ea |  | source-corrected port; operational FPC access HOLD. Export18 uses source-registered CAM/DISP 1 and a 12 x 27 mm R1 slot, nominal area 323.14 mm2. The inherited rotated CSI proxy and prior tool pass are superseded. Official 200 mm cable retained; full material route remains unplaced. Both declared cylindrical reservations clear the selected saved solids; the retained straight opening remains an unsealed cooling bypass; this does not qualify actual latch/jaws, cooler outline, stiffeners, contact orientation or cable withdrawal. [Source](../../../electronics/gs8-d2-v1/make_bom.py) |
| D2-21 / both | micro-HDMI D-D 200 mm (+10/-0), OD 3.0, Pi end 90 deg up, board end right-angle (-Y exit); EVF-SELECTION A3 class | 0 ea | 0 ea |  | replaced in both vertical variants. Replaced by one V-21 straight EVF head, one V-21P right-angle Pi head and one V-22O 300 mm ribbon in either body variant. V-22 200 mm ribbon is rejected at quantity zero. One old molded cable becomes three purchased pieces, net +2 pieces. [Source](../../../electronics/gs8-d2-v1/make_bom.py) |
| D2-22 / both | USB-A power-feed donor: Adafruit 4448 four-core breakout cable, cut to verified route; Adafruit 4448 / C14289-001 | 1 ea | 1 ea | Four removed jumper ends and unquantified wire offcuts; not installed parts | conditional donor; source-registered USB2 reservation, actual plug/route unqualified. One purchased cable. Catalog says 300 mm; supplier drawing says 325 +/- 10 mm, 4 x 28 AWG copper (7/0.12), jacket OD 3.6 mm and 25 mm breakout. This explicitly replaces the inherited generic 24-26 AWG lead. The old 200 mm is a route allocation, not purchased length or a cut instruction. Retain the conservative full plug/bend reserve: overmold, strain relief and wire-exit dimensions are unpublished, so no exact fit/exit claim. Red VBUS and black GND only; individually insulate unused white D- and green D+ with TWO separate sleeves, plus shield insulation only if a shield is present. No data connection. Verify every conductor by continuity. Export18 places the estimated head at source-registered USB2; the rejected RJ45-row pose is historical. Actual plug/exit measurements and the full cable/service route remain unresolved. Retain the inline diode; final donor/RCY copper cuts, overlaps and storage are TBD. G-W6 must recheck EVF voltage/drop/heating at measured current with the 28 AWG donor. [Source](https://cdn-shop.adafruit.com/product-files/4448/C14289-001_datasheet.pdf) |
| D2-23 / both | EVF power-only inline pair: Pololu 2180 socket-contact half + 2181 pin-contact half; Pololu 2180 + 2181, Generic RCY-style; one of each | 1 matched pair | 1 pair (one 2180 and one 2181) | No spare pair provision; actual tail offcuts TBD | conditional matched Generic pair; no JST rating inherited. Replaces unsupported PH wire-to-wire pair, not an EVF board socket. Buy ONE 2180 and ONE 2181. Both have nominal 100 mm 20 AWG silicone tails, stripped/tinned; trim only after complete routing and joint budgets are verified. Use 2180 recessed SOCKET contacts on USB source side, 2181 on the EVF board side; confirm actual mating/continuity and insulate when separated. Brand is explicitly Generic; no current/contact-resistance/OD/tolerance rating is published and JST specifications must not be borrowed. Vendor housing lengths are 13 mm and 19 mm; reserve their full sum 32 mm axially, width 7 mm and provisional thickness 7 mm until actual mated geometry is measured. This is a planning reserve, not a guaranteed vendor bound. Keep straight exit space and real disconnect access. Distinct family prevents mating to PicoBlade signal pairs; label EVF polarity. Preserve G-W6 voltage/drop, contact heating, pull retention and insulation gates. Two housings and four factory contacts are included below; no crimper. The EVF board receives two soldered pigtail joints at traced EXT+/GND pads. [Source](https://www.pololu.com/product/2180) |
| D2-24 / both | QT lead part 1: Adafruit 4397 STEMMA QT to female sockets, 150 mm (cut so the socket end is about 93-117 mm, WIRING W-QT); Adafruit 4397 | 1 retained socket-end lead section | 1 ea |  | inherited; unqualified. Join to D2-24B by pin-number continuity, not colour alone; four QT splice joints. Finished QT lead 250 +/- 10 mm. Revised routing requires a new straight splice/stow location. [Source](../../../electronics/gs8-d2-v1/make_bom.py) |
| D2-24B / both | QT lead part 2: Pololu #5521 JST SH-style 4-pin cable, single-ended female, 30 cm, 28 AWG (SH end kept; cut so the finished lead is 250 +/- 10 mm); Pololu 5521 | 1 retained SH-end lead section | 1 ea |  | inherited; unqualified. One purchased cable contributes the SH end; offcut is not another harness. Combined finished lead is 250 +/- 10 mm with D2-24. [Source](../../../electronics/gs8-d2-v1/make_bom.py) |
| D2-25 / both | GPIO donor jumpers: two cut female-ended stubs from Adafruit 1950 pack; Adafruit 1950 | 2 female-ended donor stubs; installed lengths TBD | 1 pack of 20 female/female 150 mm jumpers | 18 intact jumpers plus two removed ends and unquantified wire offcuts | conditional new-build donor; measured cut/fit gates open. Use two distinct colours for GPIO13 pin 33 and ground pin 34. Each stock jumper has 2.54 mm female contacts at both ends and 28 AWG wire (7 strands of 36 AWG). Retain one female housing/contact on each selected jumper; cut measured stubs and join to trimmed blunt-ended PicoBlade male wires using TWO solder splices and TWO insulating sleeves. Included housing/contact counts below are constituents, not additional purchases. No crimp tool. Vendor does not specify complete housing dimensions or insulation OD and warns the silver-latch side is slightly wider than 2.54 mm; verify orientation, adjacent fit, retention and the modeled envelope on receipt. Stock length is not installed length; per-core stub/copper cuts, splice overlaps and combined route budgets remain TBD until actual root/termination dimensions are measured against the selected source-bound FPS route. Replaces the unsupported generic Dupont-to-PH donor identity. [Source](https://www.adafruit.com/product/1950) |
| D2-27 / both | FPS inline pair: Molex 2181110202 male + 2181120201 female pigtail assemblies; Molex 2181110202 + 2181120201 (one of each) | 1 mated pair within one FPS harness | 1 pair (one 225 mm male and one 150 mm female assembly) | Measured wire offcuts TBD; both factory Molex housings retained | selected mated-carry route; refreshed scoped CAD pass, physical cuts/service unqualified. Supersedes unsupported generic PH wire-to-wire identity and old 200+50 mm accounting. Purchased rear-housing-exit-to-blunt-end lengths: male 225 +/- 6 mm, female 150 +/- 6 mm; two black 28 AWG UL1061 cores per half. Installed main nominal axis is 200.000 mm INCLUDING D2-25 donor stubs and splice region; female-to-A axis 95.4644 mm and female-to-throw2 axis 102.4759 mm precede unresolved solder allowances. These are study axes, not copper cuts. See FPS-SERVICE-STUDY.md for staggered splice midpoints and illustrative overlap convention. Both housings and four contacts included below. Keep pair mated while the independently supported switch and whole harness move with carrier; disconnect only on bench. No sacrificial tie or in-body connector draw-out. Actual heads, individual-core fanout, terminal geometry, root allowances and complete integrated USB/CSI/service checks remain open. Mated body 9 mm is reference only; male 8 mm and female 3.95 mm are not equal halves. Polarized friction lock has no alternate keying; J2 now uses a different mating family (V-28, default pending user decision 13), so no other in-camera half mates this pair (FP-14 junction check). Still label FPS and continuity-test both black wires. Spare pair: V-27S. System 1.5 A maximum at 28 AWG / 125 V and 30 tin-contact mating cycles are not a physical service qualification. [Source](https://www.molex.com/content/dam/molex/molex-dot-com/products/automated/en-us/salesdrawingpdf/218/218111/2181110201_sd.pdf) |
| D2-26 / both | PRC high-flex pure-copper 16 AWG silicone wire, red and black; PRC 16 AWG silicone; red SW-16R; black SW-16B | 2 conductor-path allocations; copper cuts TBD | 2 36 in lengths, one per colour | Offcuts not fixed; determine after measured cuts, joint overlaps and pad allowance | provisional length; service route blocked. Purchase one 914.4 mm stock length per colour: red SW-16R, black SW-16B (store product record https://www.progressiverc.com/products/prc-silicone-wire-16-awg.json, read 2026-10-11; the product page shows one SKU field with a colour selector). POSITIVE: 270 mm FINISHED-PATH allocation includes a 20 mm rigid fuse/joint-sleeve zone; actual copper cut and solder overlap must be measured/trimmed to that finished path, not 270 mm copper plus fuse. NEGATIVE: 270 mm total path budget includes unresolved pad-root allowances. BOTH budgets include those allowances; they are not extra length to add later. Neither is a proved production cut; no exact offcut claim. Electrical estimate conservatively charges BOTH as 270 mm copper: at 8.6 A cold drop 0.129789 V and copper-at-60 C drop 0.142811 V, leaving about 7.2 mV before hot fuse/contact/pad uncertainty under the unchanged 0.15 V G-W5 limit. Vendor OD 3.0 mm; reserve 3.2 mm/core, 6.4 x 3.2 mm pair. Existing pack lead stays 60 mm 18 AWG. Four carrier tie eyes are present; separate red/black cold-side slack retention is provisional. Full stored-length/bend and battery-disconnect reach checks pending; fixed ties cannot be assumed to unfold for service. Nominal resistance is not a vendor specification or hot-test pass. [Source](https://www.progressiverc.com/products/prc-silicone-wire-16-awg) |
| V-21 / both | Straight micro-HDMI plug adapter, EVF end; Adafruit 3556 | 1 ea | 1 ea |  | candidate; unqualified. 26.5 x 17.3 x 4 mm; one at EVF only. Replaces earlier two-straight-head proposal. Ribbon not included. Mating, retention and tool access gated. [Source](https://www.adafruit.com/product/3556) |
| V-21P / both | Right-angle R-bend micro-HDMI plug adapter, Pi end; Adafruit 3557 | 1 ea | 1 ea |  | candidate; unqualified. 17.5 x 15 x 14.5 mm; one at Pi. Actual connector clocking, rigid envelope and service access gated. Together with V-21 and one selected ribbon, three purchased pieces total. [Source](https://www.adafruit.com/product/3557) |
| V-22 / compact only | Rejected study: HDMI ribbon cable, intact 200 x 10 mm; Adafruit 3561 | 0 ea | 0 ea |  | rejected/fragile; not installed. Full 200 mm study had effectively zero tolerance reserve with both heads unplugged. Retained research record only; primary compact length is now 300 mm V-22O. No procurement or service-fit recommendation. [Source](https://www.adafruit.com/product/3561) |
| V-22O / both | HDMI ribbon cable, intact 300 x 10 mm; Adafruit 3562 | 1 ea | 1 ea |  | conditional primary; selected scoped checks passed; physical HOLD. One intact 300 mm ribbon for either compact or original-storage body, with 3557/3556 heads. Selected routing input: routing-snapshots/hdmi-corrected-ports-20261009-0623/input.json. The refreshed selected shadow-plenum report has 6 scoped passes / 0 failures, bound to the current compact-Kowa manifest; alternatives still require their own audit. Earlier over-PCB tool failures remain rejected diagnostics; CSI operational access stays on HOLD. This does not qualify complete interacting loom service. Actual availability, full-width/slack/service tolerance, bend/thickness/clocking/EMI and retention remain gates. [Source](https://www.adafruit.com/product/3562) |
| V-23S / both | Spare EVF Generic RCY-style matched pair; Pololu 2180 + 2181 | 0 pair | 1 pair | 1 spare pair (one 2180 + one 2181) | spare (FP-14 spare policy); in the buy count, not installed. Spare for D2-23 (parted at every EVF and module service (steps.SERVICE evf, module); no rating published). Same receipt, continuity, polarity-label and fit checks as D2-23; ordered with it (buy view sums the SKUs). [Source](https://www.pololu.com/product/2180) |
| V-28 / both | J2 removable signal pair: keyed 2-circuit wire-to-wire set, Molex Micro-Fit 3.0 2-circuit wire-to-wire (3.0 mm pitch) (default pending user decision 13); class: Molex Micro-Fit 3.0 2-circuit wire-to-wire set = 1 receptacle housing (socket contacts) + 1 plug housing (pin contacts) + 2 factory pre-crimped leads with female terminals + 2 with male terminals, 28-24 AWG, each lead >= 231 mm exposed; part numbers recorded at order after user decision 13 | 1 set | 1 set | Lead offcuts after cutting to the measured J2 route; spare set V-28S | conditional; default pending user decision 13; family distinct from every other junction; placement and route unqualified. FP-14 (VN-63): replaces the 9ced753 Molex 2181120201 + 2181110202 PicoBlade pair, which was the same unkeyed family as the FPS junction (D2-27), so a J2 half could mate an FPS half and hold PWR_BUT to GND. Default family: Molex Micro-Fit 3.0 2-circuit wire-to-wire (3.0 mm pitch), chosen because no other mateable half in the camera uses its pitch, its housings are polarized with a positive latch, and factory pre-crimped leads need no crimp tool. The family is default pending user decision 13 (alternatives and their gates in WIRING-VERTICAL.md). Genders: receptacle housing with SOCKET (female) contacts on the Pi J2 side: the live side never shows a bare pin that could touch ground and press the button (same rule as the EVF RCY source half); plug housing with PIN (male) contacts on the 1505 switch side. Each pre-crimped lead >= 231 mm exposed: longest 9ced753 V-28 tail upper bound (Molex 2181110202, 225 + 6 mm): each half may then sit on either side and the harness_rules j2_btn halves (150 / 225 +/- 6 mm) and CABLES power_button (363-387 mm) stay conservative lower bounds of what is bought; cut to the measured J2 route. Four solder joints remain: two J2 pads and two switch terminals; no crimps or splices. Housing dimensions, mated length, latch travel, wire exits and stow are receipt and placement gates: the J2 junction was never placed (G-V-POWER, VN-73) and the larger housing is not shown to fit the old 6 x 8 x 12 mm reserve. Try-mate matrix on receipt: each J2 half must refuse the FPS, EVF RCY and header housings. Signal use only, never battery current. Label J2 at both housings; verify both circuits by continuity. [Source](wiring_data.py) |
| V-28S / both | Spare J2 keyed pair set (default pending user decision 13); class: Molex Micro-Fit 3.0 2-circuit wire-to-wire set = 1 receptacle housing (socket contacts) + 1 plug housing (pin contacts) + 2 factory pre-crimped leads with female terminals + 2 with male terminals, 28-24 AWG, each lead >= 231 mm exposed; part numbers recorded at order after user decision 13 | 0 set | 1 set | 1 spare set | spare (FP-14 spare policy); in the buy count, not installed. Spare for V-28 (one J2 mating cycle per panel removal (ASSEMBLY section 5.1 J2 cycles)). Same family decision and receipt checks as V-28. [Source](wiring_data.py) |
| V-27S / both | Spare FPS PicoBlade pair: Molex 2181110202 male + 2181120201 female; Molex 2181110202 + 2181120201 (one of each) | 0 pair | 1 pair | 1 spare pair | spare (FP-14 spare policy); in the buy count, not installed. Spare for D2-27 (tin contacts with a low rated mating-cycle count (BOM D2-27 note); parted on the bench at FPS service). Ordered with D2-27; the buy view sums the two SKUs. [Source](https://www.molex.com/content/dam/molex/molex-dot-com/products/automated/en-us/salesdrawingpdf/218/218111/2181110201_sd.pdf) |
| V-22OS / both | Spare HDMI ribbon cable, intact 300 x 10 mm; Adafruit 3562 | 0 ea | 1 ea | 1 spare ribbon | spare (FP-14 spare policy); in the buy count, not installed. Spare for V-22O (less durable and less shielded than a moulded cable (Adafruit 3562 page; review ELE-14); FPC latch or fold fatigue after services). Heads V-21/V-21P are not consumed in service; reorder only if damaged. [Source](https://www.adafruit.com/product/3562) |

## C. Fasteners

| Line / variant | Item and SKU | Installed | Buy | Spares / included | Qualification and source |
|---|---|---|---|---|---|
| D2-30 / both | PT 3.0 x 12 thread-forming screw for plastics, pan head, PH1 (EJOT PT K30x12 WN 1411 / Delta PT 30x12 class); WN 1411 class | 7 ea | 11 ea | 4 spare | inherited; unqualified. Four panel + two carrier + one independent grip-lock PT 3.0 x 12 PH1; seven installed, not eleven. Same body screw count as baseline. [Source](../../../electronics/gs8-d2-v1/make_bom.py) |
| D2-31 / both | 1/4-20 UNC hex nut, steel (tripod socket); ISO 4032 class | 1 ea | 1 ea |  | inherited; unqualified. Inherited specification; baseline source line D2-31. Candidate assembly sequence supersedes baseline step numbers. [Source](../../../electronics/gs8-d2-v1/make_bom.py) |
| D2-32 / both | Insert fallback: M3 x 5.7 brass heat-set insert (pack); CNC Kitchen M3 standard | 0 inserts | 1 pack |  | contingency stock. Fallback stock only; pack quantity unspecified. Do not count a pack as an installed insert. One long collar insert is separately counted at D2-36. [Source](../../../electronics/gs8-d2-v1/make_bom.py) |
| D2-33 / both | Insert fallback: M3 x 10 pan head A2, ISO 7045 cross recess PH1 (no hex: straight-driver rule); ISO 7045 class | 0 ea | 7 ea |  | contingency stock. Seven fallback screws for stripped PT bosses, not installed in the candidate. Requalify a repaired boss before use. [Source](../../../electronics/gs8-d2-v1/make_bom.py) |
| D2-35 / both | M3 heat-set insert, brass, short (L 4.0, OD 4.6 class), lens-collar anchors in the tub bosses; heat-set insert class (procure; G-COL-1) | 3 ea | 5 ea | 2 spare | inherited; unqualified. Lens-collar hardware; revised collar geometry requires renewed coupon/load checks. M1 remains open. See ASSEMBLY-VERTICAL.md. [Source](../../../electronics/gs8-d2-v1/make_bom.py) |
| D2-36 / both | M3 heat-set insert, brass, L 5.7 (OD 4.6 class), lens-collar pinch lug; CNC Kitchen M3 standard class | 1 ea | 1 ea | spare may come from D2-32; not another installed insert | inherited; unqualified. Lens-collar hardware; revised collar geometry requires renewed coupon/load checks. M1 remains open. See ASSEMBLY-VERTICAL.md. [Source](../../../electronics/gs8-d2-v1/make_bom.py) |
| D2-37 / both | M3 x 10 pan head A2, ISO 7045 cross recess PH1 (lens-collar anchors); ISO 7045 class | 3 ea | 4 ea | 1 spare | inherited; unqualified. Lens-collar hardware; revised collar geometry requires renewed coupon/load checks. M1 remains open. See ASSEMBLY-VERTICAL.md. [Source](../../../electronics/gs8-d2-v1/make_bom.py) |
| D2-38 / both | M3 x 16 pan head A2, ISO 7045 cross recess PH1 (lens-collar pinch); ISO 7045 class | 1 ea | 2 ea | 1 spare | inherited; unqualified. Lens-collar hardware; revised collar geometry requires renewed coupon/load checks. M1 remains open. See ASSEMBLY-VERTICAL.md. [Source](../../../electronics/gs8-d2-v1/make_bom.py) |
| D2-39 / both | M3 washer, ISO 7089 A2 (3.2 x 7.0 x 0.5); ISO 7089 class | 4 ea | 6 ea | 2 spare | inherited; unqualified. Lens-collar hardware; revised collar geometry requires renewed coupon/load checks. M1 remains open. See ASSEMBLY-VERTICAL.md. [Source](../../../electronics/gs8-d2-v1/make_bom.py) |
| D2-34 / both | Contingency: M2.5 x 5 pan head A2, ISO 7045 cross recess PH1; ISO 7045 class | 0 ea | 0 ea |  | optional; not adopted. Conditional four M2.5 x 5 PH1 upper replacements only if included upper screws have an unsuitable drive. Lower four are already replaced by V-31; never add eight extra kit screws. [Source](../../../electronics/gs8-d2-v1/make_bom.py) |
| V-31 / both | M2.5 x 8 pan-head PH1 lower stack/carrier screws; ISO 7045 PH1 class | 4 ea | 5 ea | 1 spare | candidate; unqualified. Replace four original lower M2.5 x 5 screws. Recessed 4 mm bosses leave 3 mm below the heads; 8 - 3 - 1.6 = 3.4 mm nominal thread engagement. Actual thread depth, head profile and bottoming must be measured. Eight stack screws installed in total, never twelve. [Source](model.py) |

## E. Consumables

| Line / variant | Item and SKU | Installed | Buy | Spares / included | Qualification and source |
|---|---|---|---|---|---|
| D2-40 / both | ASA filament 1.75 mm, satin silver (tub, panel; original-storage sleeve); Polymaker ASA class | 0 spool | 1 spool |  | inherited; unqualified. Workshop spool; actual slice mass and filament consumption pending. Does not include an invented production mass. [Source](../../../electronics/gs8-d2-v1/make_bom.py) |
| D2-41 / both | ASA filament 1.75 mm, black (carrier, base/grip, cap, knobs, lens collar); Polymaker ASA class | 0 spool | 1 spool |  | inherited; unqualified. No hood, Pi keeper or printed power plunger in this candidate; actual slice mass pending. Collar material still follows thermal qualification. [Source](../../../electronics/gs8-d2-v1/make_bom.py) |
| D2-43 / both | TPU 95A filament, black (eyecup); class | 0 spool | 1 spool |  | inherited; unqualified. Workshop supply; amount consumed in the candidate is not yet measured. [Source](../../../electronics/gs8-d2-v1/make_bom.py) |
| D2-44 / both | Paint pen / enamel, black and white, for labels and optical witness marks; class | 0 ea | 2 ea |  | inherited; unqualified. Keep baseline two-pen workshop provision; no printed plunger symbol. Witness marks across adapter/BFAR and BFAR/housing remain required. [Source](../../../electronics/gs8-d2-v1/make_bom.py) |
| D2-45 / both | Closed-cell foam sheet 1.0 mm, pressure-sensitive adhesive one side (OLED pad 16 x 14; stuck to the OLED back); class | 0 sheet | 1 sheet |  | inherited; unqualified. Workshop supply; amount consumed in the candidate is not yet measured. [Source](../../../electronics/gs8-d2-v1/make_bom.py) |
| D2-46 / both | Adhesive-lined heat-shrink 3:1 (pigtail, diode splice, r4 fuse splice: about 4.8 mm, 30 mm per fuse) + thin-wall 2:1 (switch lugs); class | 0 set | 1 set |  | inherited; unqualified. Retain insulation for pigtail, fuse, diode and switch leads; include four QT splice sleeves, TWO FPS donor-splice sleeves and insulation for both J2 pads and both new power-switch terminal joints. Confirm diameters for 16 AWG. [Source](../../../electronics/gs8-d2-v1/make_bom.py) |
| D2-46R / both | Neutral-cure silicone RTV, small tube (pigtail strain relief at the X1203 battery pads); class | 0 tube | 1 tube |  | inherited; unqualified. Workshop supply; amount consumed in the candidate is not yet measured. [Source](../../../electronics/gs8-d2-v1/make_bom.py) |
| D2-47 / both | Solder, flux, wick; class | 0 set | 1 set |  | inherited; unqualified. Workshop supply; amount consumed in the candidate is not yet measured. [Source](../../../electronics/gs8-d2-v1/make_bom.py) |
| D2-48 / both | Pull ribbon 10 mm (if the pack has none) + Kapton tape; class | 0 set | 1 set |  | inherited; unqualified. Workshop supply; amount consumed in the candidate is not yet measured. [Source](../../../electronics/gs8-d2-v1/make_bom.py) |
| D2-49 / both | Isopropyl alcohol + glue stick (bed release); class | 0 set | 1 set |  | inherited; unqualified. Workshop supply; amount consumed in the candidate is not yet measured. [Source](../../../electronics/gs8-d2-v1/make_bom.py) |
| D2-50 / both | Small cable ties 2.5 mm (lead bundles); class | 4 allocated slack-loop ties | 1 pack | Pack count and remaining baseline bundle consumption to be measured | inherited; unqualified. Use existing-class 2.5 mm cable ties; measured band thickness must be <=0.7 mm for the four 3 x 1 mm carrier slots. Four provisionally allocated to separate red/black cold-side pigtail loops; exact retention scheme may change. Fixed tied folds cannot unfold for service: qualify battery-disconnect reach with retention as installed. No contact or pressure on UPS PCB; retain bend radii and a straight fuse section. Exact tie/head dimensions and routing remain gated. [Source](../../../electronics/gs8-d2-v1/make_bom.py) |
| V-68 / both | Two-part epoxy adhesive, small pack (bond the +Y tab-catch stub into the tub, B1 print_inserts); class; structural two-part epoxy, confirm on receipt | 0 pack | 1 pack |  | candidate; unqualified. T2 (VN-53, FP-11b): default pending user decision 16 (bonded stub; alternatives: press fit with a printed detent, or a panel-held block, which needs the panel on at lens_in). Adhesive type, cure, gap fill (0.1 to 0.2 mm pocket clearance) and the bond and tenon strength under the r7 roll_catch design torque are a G-V-PRINT tine coupon gate; amount consumed not measured. [Source](model.py) |

## F. Tools and accessories (not in the camera)

| Line / variant | Item and SKU | Installed | Buy | Spares / included | Qualification and source |
|---|---|---|---|---|---|
| D2-60 / both | PH1 screwdriver, straight, shank dia <= 6.5, blade >= 40 mm (hand); TLS-14 class | 0 ea | 1 ea |  | inherited; unqualified. Workshop equipment, not an installed camera part; retained from baseline scope. [Source](../../../electronics/gs8-d2-v1/make_bom.py) |
| D2-61 / both | 1/2 in (12.7 mm) deep socket for the CK1044 switch nut, driven on the bushing axis; class | 0 ea | 1 ea |  | inherited; unqualified. Straight-driver rule (review VN-46): deep socket on the nut axis, never a spanner. 12.7 mm across-flats is the inherited reservation, not a published Lorlin dimension; confirm on receipt. Socket clearance to the panel face and exposure knob belongs to the straight-driver check (FP-07). [Source](../../../electronics/gs8-d2-v1/make_bom.py) |
| D2-62 / both | Fine tweezers (OLED, flex, microSD); class | 0 ea | 1 ea |  | inherited; unqualified. Workshop equipment, not an installed camera part; retained from baseline scope. [Source](../../../electronics/gs8-d2-v1/make_bom.py) |
| D2-63 / both | Temperature-controlled soldering iron; class | 0 ea | 1 ea |  | inherited; unqualified. Planned complete baseline-style build: 24 solder joints with spliced QT, two FPS donor splices and preterminated J2 pair; +2 only if pack lacks XT30 male. See audited count breakdown below; optional EVF regulator excluded. [Source](../../../electronics/gs8-d2-v1/make_bom.py) |
| D2-64 / both | Digital multimeter + thermocouple; class | 0 ea | 1 ea |  | inherited; unqualified. Workshop equipment, not an installed camera part; retained from baseline scope. [Source](../../../electronics/gs8-d2-v1/make_bom.py) |
| D2-65 / both | Adjustable bench DC supply with current limit (>= 10 A for G-W5 and G-W12, else 3 A); class | 0 ea | 1 ea |  | inherited; unqualified. Workshop equipment, not an installed camera part; retained from baseline scope. [Source](../../../electronics/gs8-d2-v1/make_bom.py) |
| D2-66 / both | Official Raspberry Pi 27 W USB-C PSU (bring-up); SC1149 | 0 ea | 1 ea |  | inherited; unqualified. Workshop equipment, not an installed camera part; retained from baseline scope. [Source](../../../electronics/gs8-d2-v1/make_bom.py) |
| D2-67 / both | 1S Li-ion balance charger (SkyRC B6neo class) + XT60-to-XT30 lead + USB-C PD supply; SkyRC B6neo | 0 set | 1 set |  | inherited; unqualified. Workshop equipment, not an installed camera part; retained from baseline scope. [Source](../../../electronics/gs8-d2-v1/make_bom.py) |
| D2-68 / both | Wire stripper / flush cutter, heat gun; class | 0 set | 1 set |  | inherited; unqualified. Workshop equipment, not an installed camera part; retained from baseline scope. [Source](../../../electronics/gs8-d2-v1/make_bom.py) |
| D2-69 / both | Junior hacksaw + small flat file for measured 18/24 switch shaft trim; class | 0 set | 1 set |  | inherited; unqualified. Retain saw, file and soft-jaw vise for physical 18/24 shaft fit. Measure the new panel projection; historical absolute-Y cut position is obsolete. [Source](../../../electronics/gs8-d2-v1/make_bom.py) |
| D2-70 / both | ESD mat + wrist strap; class | 0 set | 1 set |  | inherited; unqualified. Workshop equipment, not an installed camera part; retained from baseline scope. [Source](../../../electronics/gs8-d2-v1/make_bom.py) |
| D2-71 / both | 2 x dia 1.5 steel pins, ISO 8734 1.5 x 16 dowel class (hood release hold-open; r2 fixer: replaces the 3 mm release blade); class | 0 ea | 0 ea |  | removed. The vertical tub has no separate hood; two hood-release pins are removed from required tool scope. [Source](../../../electronics/gs8-d2-v1/make_bom.py) |
| D2-72 / both | Digital calipers, 0.01 mm; class | 0 ea | 1 ea |  | inherited; unqualified. Workshop equipment, not an installed camera part; retained from baseline scope. [Source](../../../electronics/gs8-d2-v1/make_bom.py) |
| D2-73 / both | Oscilloscope >= 20 MHz + inline USB-C power meter (logging); class | 0 set | 1 set |  | inherited; unqualified. Workshop equipment, not an installed camera part; retained from baseline scope. [Source](../../../electronics/gs8-d2-v1/make_bom.py) |
| D2-74 / both | M3 heat-set tip in the tip system of the D2-63 iron (900M class for a YIHUA 928D or Hakko 936-type station, the T12 or TS100 range for those irons) + insert fallback set (pin vise or hand drill, 3.2 + 4.0 mm drills); class | 0 set | 1 set |  | inherited; unqualified. Workshop equipment, not an installed camera part; retained from baseline scope. [Source](../../../electronics/gs8-d2-v1/make_bom.py) |
| D2-75 / both | DC electronic load >= 10 A / 30 W, constant-current mode (r3 fix-baseline); class | 0 ea | 1 ea |  | inherited; unqualified. Workshop equipment, not an installed camera part; retained from baseline scope. [Source](../../../electronics/gs8-d2-v1/make_bom.py) |
| D2-76 / both | G-W13 (c) bench stand-ins: 100 uF electrolytic + power resistor for a 0.30 A load at 4.5 V (about 15 ohm, >= 3 W) (r3 fix-baseline); class | 0 set | 0 set |  | optional; not adopted. Retain in scope for EVF option C only. Baseline listed a tool set although the regulator was quantity zero; no purchase or installed part until that option is adopted. [Source](../../../electronics/gs8-d2-v1/make_bom.py) |
| D2-77 / both | Adjustable torque screwdriver 0.1-0.6 N m, straight, PH1 bit: shank dia <= 6.5 over >= 40 mm, handle dia <= 30 (the DRIVER audit envelope); class | 0 ea | 1 ea |  | inherited; unqualified. Retain adjustable torque PH1 driver; baseline numerical caps are provisional. Revised carrier/boss and collar coupons must validate actual torque limits. [Source](../../../electronics/gs8-d2-v1/make_bom.py) |
| V-62 / both | Deep socket for the Adafruit 1505 power-button nut, sized to the measured across-flats; class; confirm on receipt | 0 ea | 0 ea |  | provisional; purchase gated on the measured 1505 nut across-flats (FP-14 gated purchase). Straight-driver rule (review VN-46): the nut is run down with a deep socket on the button axis, never a spanner. Across-flats unknown until receipt: measure the nut, then reuse an existing deep socket that fits; buy the matching one only if none fits (purchase stays 0 until that measurement). Review CAD probe: a socket up to OD 28 mm clears the panel; actual reach unverified. [Source](model.py) |
| V-63 / both | Smooth-jaw long-nose pliers, fine tips; class; confirm on receipt | 0 ea | 1 ea |  | baseline toolset retained. Explicit ASSEMBLY section 1.1 tool formerly lacking its own baseline BOM line; not a new installed part. Reuse existing workshop item. [Source](model.py) |
| V-64 / both | Soft-jaw vise or vise with wood jaw pads; class; confirm on receipt | 0 ea | 1 ea |  | baseline toolset retained. Explicit ASSEMBLY section 1.1 tool formerly lacking its own baseline BOM line; not a new installed part. Reuse existing workshop item. [Source](model.py) |
| V-65 / both | Flat steel rule / bar; class; confirm on receipt | 0 ea | 1 ea |  | baseline toolset retained. Explicit ASSEMBLY section 1.1 tool formerly lacking its own baseline BOM line; not a new installed part. Reuse existing workshop item. [Source](model.py) |
| V-66 / both | Printer-paper knob shims and panel support block; class; confirm on receipt | 0 ea | 1 ea |  | baseline toolset retained. Explicit ASSEMBLY section 1.1 tool formerly lacking its own baseline BOM line; not a new installed part. Reuse existing workshop item. [Source](model.py) |
| V-67 / both | Small inspection mirror, optional; class; confirm on receipt | 0 ea | 0 ea |  | baseline toolset retained. Explicit ASSEMBLY section 1.1 tool formerly lacking its own baseline BOM line; not a new installed part. Reuse existing workshop item. [Source](model.py) |
| T-gauge / both | Printed collar centring gauge for selected lens; class; confirm on receipt | 0 tool | 0 tool |  | candidate; unqualified. Retained baseline tool; separate from the nine/ten installed printed production parts. Inspect candidate gauge export for selected lens. [Source](model.py) |

## G. Included-kit detail (do not buy or sum with parent assemblies)

| Line / variant | Item and SKU | Installed | Buy | Spares / included | Qualification and source |
|---|---|---|---|---|---|
| I-03A / both | M2.5 F-F standoffs; class; confirm on receipt | 4 ea | 0 ea | Included in D2-03.  | included; unqualified. Retain actual supplied stack length; measure it. [Source](model.py) |
| I-03B / both | Original upper M2.5 x 5 screws; class; confirm on receipt | 4 ea | 0 ea | Included in D2-03.  | included; unqualified. Four installed; four other supplied lower screws are removed and bagged. [Source](model.py) |
| I-05A / both | C-CS adapter; class; confirm on receipt | 1 ea | 0 ea | Included in D2-05.  | included; unqualified. Included optical adapter; witness marks required. [Source](model.py) |
| I-05B / both | Camera tripod block plus two screws; class; confirm on receipt | 0 ea | 0 ea | Included in D2-05.  | included; unqualified. Removed and bagged at supported optical bench setup; no camera-body installation. [Source](model.py) |
| I-07A / both | OLED emitter; class; confirm on receipt | 1 ea | 0 ea | Included in D2-07.  | included; unqualified. Constituent of one EVF kit. [Source](model.py) |
| I-07B / both | EVF driver board; class; confirm on receipt | 1 ea | 0 ea | Included in D2-07.  | included; unqualified. Constituent of one EVF kit. [Source](model.py) |
| I-07C / both | Native OLED flex; class; confirm on receipt | 1 ea | 0 ea | Included in D2-07.  | included; unqualified. One included native harness; never count as another kit purchase. [Source](model.py) |
| I-02B / both | Supplied Active Cooler push pins; class; confirm on receipt | 2 ea | 0 ea | Included in D2-02.  | included; unqualified. Two actual mounting push pins; old four illustrative support feet are not four purchased fasteners. Cooler/fan internals remain within the purchased cooler assembly. [Source](model.py) |
| I-02A / both | Native Active Cooler fan lead; class; confirm on receipt | 1 ea | 0 ea | Included in D2-02.  | included; unqualified. Stays with complete Pi/cooler/UPS module. [Source](model.py) |
| I-12A / both | Prewired run lead; class; confirm on receipt | 1 ea | 0 ea | Included in D2-12.  | included; unqualified. One included harness. [Source](model.py) |
| I-13A / both | 60 mm pack-side 18 AWG lead; class; confirm on receipt | 1 ea | 0 ea | Included in D2-13.  | included; unqualified. Unchanged; pack-side connector below. [Source](model.py) |
| I-13B / both | Pack-side XT30 male; class; confirm on receipt | 1 ea | 0 ea | Included in D2-13.  | included; unqualified. Do not also install a loose male from D2-14. [Source](model.py) |
| I-45A / both | Cut OLED foam pad, 16 x 14 x 1 mm; class; confirm on receipt | 1 ea | 0 ea | Included in D2-45.  | included; unqualified. Cut from the purchased sheet; rides with OLED; actual pad compression is a gate. [Source](model.py) |
| I-27A / both | FPS Molex 510470200 plug housing; class; confirm on receipt | 1 ea | 0 ea | Included in D2-27.  | included; unqualified. Included in male 2181110202; remains installed. [Source](model.py) |
| I-27B / both | FPS Molex 510210200 receptacle housing; class; confirm on receipt | 1 ea | 0 ea | Included in D2-27.  | included; unqualified. Included in female 2181120201; remains installed. [Source](model.py) |
| I-27C / both | FPS male factory-crimped contacts; class; confirm on receipt | 2 ea | 0 ea | Included in D2-27.  | included; unqualified. Included Molex 501338000; no additional purchase or crimp. [Source](model.py) |
| I-27D / both | FPS female factory-crimped contacts; class; confirm on receipt | 2 ea | 0 ea | Included in D2-27.  | included; unqualified. Included Molex 500588000; no additional purchase or crimp. [Source](model.py) |
| I-23A / both | EVF source-side socket-contact housing; class; confirm on receipt | 1 ea | 0 ea | Included in D2-23.  | included; unqualified. Included in Pololu 2180; protected source contacts, identity checked on receipt. [Source](model.py) |
| I-23B / both | EVF board-side pin-contact housing; class; confirm on receipt | 1 ea | 0 ea | Included in D2-23.  | included; unqualified. Included in Pololu 2181; not an additional purchase. [Source](model.py) |
| I-23C / both | EVF factory-crimped contacts; class; confirm on receipt | 4 ea | 0 ea | Included in D2-23.  | included; unqualified. Two per half; no additional crimp or solder joint. [Source](model.py) |
| I-46A / both | Individual USB data-core insulating sleeves; class; confirm on receipt | 2 ea | 0 ea | Included in D2-46.  | included; unqualified. Two separate installed pieces for unused white and green cores; do not join the data conductors. [Source](model.py) |
| I-46B / both | Conditional USB shield insulating sleeve; class; confirm on receipt | 0 ea | 0 ea | Included in D2-46.  | included; unqualified. Fit one additional piece only if a shield/drain is actually present; verify on receipt. [Source](model.py) |
| I-25A / both | GPIO female jumper housings retained from donor pack; class; confirm on receipt | 2 ea | 0 ea | Included in D2-25.  | included; unqualified. One installed on each measured stub; do not count both ends of each stock jumper. [Source](model.py) |
| I-25B / both | GPIO female preterminated contacts retained from donor pack; class; confirm on receipt | 2 ea | 0 ea | Included in D2-25.  | included; unqualified. One installed contact per retained housing; factory termination adds no new crimp or solder joint. [Source](model.py) |
| I-11A / both | 18/24 switch retaining nut; class; confirm on receipt | 1 ea | 0 ea | Included in D2-11.  | included; unqualified. Planned supplied nut; inclusion, imperial thread, dimensions and tool access require receipt verification. [Source](model.py) |
| I-11B / both | 18/24 switch mounting washer; class; confirm on receipt | 1 ea | 0 ea | Included in D2-11.  | included; unqualified. Planned mounting washer; inclusion, type and dimensions unverified. This is NOT the adjustable stop/tang washer. [Source](model.py) |
| I-11C / both | 18/24 adjustable stop/tang washer; class; confirm on receipt | 1 ea | 0 ea | Included in D2-11.  | included; unqualified. Distinct supplied position-limiting piece per CK catalog. Set for two adjacent detents; preserve its indexed seat during panel service. Actual shape and stack remain receipt gates. [Source](model.py) |
| I-09A / both | Princeton SSD protective cap; class; confirm on receipt | 0 ea | 0 ea | Included in V-09.  | included; unqualified. Remove before insertion and bag; official overall envelope includes this cap but it is not installed in camera. [Source](model.py) |
| I-17A / both | Power-switch retaining nut; class; confirm on receipt | 1 ea | 0 ea | Included in V-17.  | included; unqualified. Receipt inclusion/geometry gate. Model OD 22 x 3 mm is an unverified reserve, not a vendor dimension. Nut bearing plane follows panel inner Y=25.2 mm. [Source](model.py) |
| I-17B / both | Power-switch supplied washer; class; confirm on receipt | 1 ea | 0 ea | Included in V-17.  | included; unqualified. Receipt inclusion/thickness gate; no separately qualified washer solid. [Source](model.py) |
| I-28A / both | J2 two-circuit plug housing (pin contacts, switch side); class; confirm on receipt | 1 ea | 0 ea | Included in V-28.  | included; unqualified. Included in the V-28 set (default pending user decision 13); not another purchase. [Source](model.py) |
| I-28B / both | J2 two-circuit receptacle housing (socket contacts, Pi side); class; confirm on receipt | 1 ea | 0 ea | Included in V-28.  | included; unqualified. Included in the V-28 set (default pending user decision 13); not another purchase. [Source](model.py) |
| I-28C / both | J2 male-terminal pre-crimped leads; class; confirm on receipt | 2 ea | 0 ea | Included in V-28.  | included; unqualified. Factory-crimped, included in the V-28 set; no crimp tool or solder splice. [Source](model.py) |
| I-28D / both | J2 female-terminal pre-crimped leads; class; confirm on receipt | 2 ea | 0 ea | Included in V-28.  | included; unqualified. Factory-crimped, included in the V-28 set; no crimp tool or solder splice. [Source](model.py) |

## D. Printed production parts

| Line / variant | Item and SKU | Installed | Buy | Spares / included | Qualification and source |
|---|---|---|---|---|---|
| P-tub / both | tub; ASA, satin silver | 1 part | 0 part |  | candidate; unqualified. Concealed-vent revision: tub incorporates the source-defined ventilation geometry; panel is plain 2.8 mm after removal of four blind grooves. T2 (VN-53): printed as two pieces, the body (stl/tub.stl, -Y face down, tenon pocket open) and the +Y tab-catch stub (stl/tab_catch_insert.stl, bed face down, catch face vertical), bonded with V-68 at B1 print_inserts (default pending user decision 16); the stub is part of this production part, not another installed part. Slice orientation, supports, filament and measured print mass remain pending. Nine compact production parts retained; this is a production-part count, not a purchase quantity. [Source](model.py) |
| P-panel / both | panel; ASA, satin silver | 1 part | 0 part |  | candidate; unqualified. Concealed-vent revision: tub incorporates the source-defined ventilation geometry; panel is plain 2.8 mm after removal of four blind grooves. Slice orientation, supports, filament and measured print mass remain pending. Nine compact production parts retained; this is a production-part count, not a purchase quantity. [Source](model.py) |
| P-carrier / both | carrier; ASA, black | 1 part | 0 part |  | candidate; unqualified. Slice orientation, supports, filament and measured print mass remain pending. Nine compact production parts retained; this is a production-part count, not a purchase quantity. [Source](model.py) |
| P-base_grip / both | base_grip; ASA, black | 1 part | 0 part |  | candidate; unqualified. Slice orientation, supports, filament and measured print mass remain pending. Nine compact production parts retained; this is a production-part count, not a purchase quantity. [Source](model.py) |
| P-cap / both | cap; ASA, black | 1 part | 0 part |  | candidate; unqualified. Slice orientation, supports, filament and measured print mass remain pending. Nine compact production parts retained; this is a production-part count, not a purchase quantity. [Source](model.py) |
| P-eyecup / both | eyecup; TPU 95A, black | 1 part | 0 part |  | candidate; unqualified. Slice orientation, supports, filament and measured print mass remain pending. Nine compact production parts retained; this is a production-part count, not a purchase quantity. [Source](model.py) |
| P-knob_exp / both | knob_exp; ASA, black | 1 part | 0 part |  | candidate; unqualified. Slice orientation, supports, filament and measured print mass remain pending. Nine compact production parts retained; this is a production-part count, not a purchase quantity. [Source](model.py) |
| P-knob_fps / both | knob_fps; ASA, black | 1 part | 0 part |  | candidate; unqualified. Slice orientation, supports, filament and measured print mass remain pending. Nine compact production parts retained; this is a production-part count, not a purchase quantity. [Source](model.py) |
| P-lens_collar / both | lens_collar; ASA, black; thermal qualification pending | 1 part | 0 part |  | candidate; unqualified. Slice orientation, supports, filament and measured print mass remain pending. Nine compact production parts retained; this is a production-part count, not a purchase quantity. [Source](model.py) |
| P-stick_sleeve / original only | stick_sleeve; ASA, satin silver | 1 part | 0 part |  | candidate; unqualified. Slice orientation, supports, filament and measured print mass remain pending. Nine compact production parts retained; this is a production-part count, not a purchase quantity. [Source](model.py) |

## Buy view (grouped by orderable SKU)

Generated from the rows above (FP-14). Every purchased row is broken into the SKUs that are actually ordered (`wiring_data.BUY_SPLIT`); rows sharing a SKU are summed, spares included. Class rows are not SKUs and are never merged. Included-kit rows and printed parts are excluded. Not a price, stock or order claim. Also written as `BUY-VERTICAL.csv`.

| SKU or class | Unit | Supplier | Compact buy | Original buy | From lines | Gate |
|---|---|---|---:|---:|---|---|
| SC1432 (8 GB, prices.json); layout pn SC1111/SC1112 | ea | Cytron SG | 1 | 1 | D2-01 |  |
| SC1148 | ea | MakerSupplies SG | 1 | 1 | D2-02 |  |
| X1203 | ea | Geekworm | 1 | 1 | D2-03 |  |
| D2-04: microSD card, A2 class, 32-64 GB (OS only, front slot) (A2 class) | ea | any | 1 | 1 | D2-04 |  |
| SC0926 | ea | Cytron SG | 1 | 1 | D2-05 |  |
| LM6HC | ea | Kowa distributor | 1 | 1 | D2-06 |  |
| Hicenda Tindie kit | kit | Hicenda (Tindie) | 1 | 1 | D2-07 |  |
| 0PE039-16X | ea | Display Components (Tindie) | 1 | 1 | D2-08 |  |
| Adafruit 5880 | ea | Adafruit / DigiKey | 1 | 1 | D2-10 |  |
| Lorlin CK1044 | ea | Lorlin / authorized distributor | 1 | 1 | D2-11 |  |
| D2-12: Run button: pre-wired momentary, red cap, female-socket leads (Squid Button (non-latching) class) | ea | The Pi Hut | 1 | 1 | D2-12 |  |
| D2-13: 1S2P 18650 pack: 2 high-drain cells (>= 10 A class), BMS >= 10 A, 18 AWG lead, XT30U male, pull ribbon (1S2P custom (Molicel P28A / Samsung 35E class)) | ea | pack builder | 1 | 1 | D2-13 |  |
| Amass XT30U | pair | any | 2 | 2 | D2-14 |  |
| Littelfuse 0251015.MXL (DigiKey F2352-ND) | ea | DigiKey | 2 | 2 | D2-14F |  |
| D2-15: Hand strap, 12 mm webbing with buckle (class) | ea | any | 1 | 1 | D2-15 |  |
| MCC 1N5817-TP | ea | DigiKey SG | 2 | 2 | D2-16 |  |
| official 200 mm | ea | MakerSupplies SG | 1 | 1 | D2-20 |  |
| Adafruit 4448 / C14289-001 | ea | Adafruit | 1 | 1 | D2-22 |  |
| Pololu 2180 | ea | Pololu | 2 | 2 | D2-23, V-23S (spare) |  |
| Pololu 2181 | ea | Pololu | 2 | 2 | D2-23, V-23S (spare) |  |
| Adafruit 4397 | ea | Adafruit / DigiKey | 1 | 1 | D2-24 |  |
| Pololu 5521 | ea | Pololu | 1 | 1 | D2-24B |  |
| Adafruit 1950 | pack of 20 female/female 150 mm jumpers | Adafruit | 1 | 1 | D2-25 |  |
| Molex 2181110202 | ea | Molex / authorized distributor | 2 | 2 | D2-27, V-27S (spare) |  |
| Molex 2181120201 | ea | Molex / authorized distributor | 2 | 2 | D2-27, V-27S (spare) |  |
| PRC SW-16R (16 AWG red, 36 in) | ea | ProgressiveRC | 1 | 1 | D2-26 |  |
| PRC SW-16B (16 AWG black, 36 in) | ea | ProgressiveRC | 1 | 1 | D2-26 |  |
| D2-30: PT 3.0 x 12 thread-forming screw for plastics, pan head, PH1 (EJOT PT K30x12 WN 1411 / Delta PT 30x12 class) (WN 1411 class) | ea | any | 11 | 11 | D2-30 |  |
| D2-31: 1/4-20 UNC hex nut, steel (tripod socket) (ISO 4032 class) | ea | any | 1 | 1 | D2-31 |  |
| CNC Kitchen M3 standard | pack | Printed Solid (US) | 1 | 1 | D2-32 |  |
| D2-33: Insert fallback: M3 x 10 pan head A2, ISO 7045 cross recess PH1 (no hex: straight-driver rule) (ISO 7045 class) | ea | any | 7 | 7 | D2-33 |  |
| D2-35: M3 heat-set insert, brass, short (L 4.0, OD 4.6 class), lens-collar anchors in the tub bosses (heat-set insert class (procure; G-COL-1)) | ea | any | 5 | 5 | D2-35 |  |
| D2-36: M3 heat-set insert, brass, L 5.7 (OD 4.6 class), lens-collar pinch lug (CNC Kitchen M3 standard class) | ea | any | 1 | 1 | D2-36 |  |
| D2-37: M3 x 10 pan head A2, ISO 7045 cross recess PH1 (lens-collar anchors) (ISO 7045 class) | ea | any | 4 | 4 | D2-37 |  |
| D2-38: M3 x 16 pan head A2, ISO 7045 cross recess PH1 (lens-collar pinch) (ISO 7045 class) | ea | any | 2 | 2 | D2-38 |  |
| D2-39: M3 washer, ISO 7089 A2 (3.2 x 7.0 x 0.5) (ISO 7089 class) | ea | any | 6 | 6 | D2-39 |  |
| D2-40: ASA filament 1.75 mm, satin silver (tub, panel; original-storage sleeve) (Polymaker ASA class) | spool | MakerSupplies SG | 1 | 1 | D2-40 |  |
| D2-41: ASA filament 1.75 mm, black (carrier, base/grip, cap, knobs, lens collar) (Polymaker ASA class) | spool | MakerSupplies SG | 1 | 1 | D2-41 |  |
| D2-43: TPU 95A filament, black (eyecup) (class) | spool | any | 1 | 1 | D2-43 |  |
| D2-44: Paint pen / enamel, black and white, for labels and optical witness marks (class) | ea | any | 2 | 2 | D2-44 |  |
| D2-45: Closed-cell foam sheet 1.0 mm, pressure-sensitive adhesive one side (OLED pad 16 x 14; stuck to the OLED back) (class) | sheet | any | 1 | 1 | D2-45 |  |
| D2-46: Adhesive-lined heat-shrink 3:1 (pigtail, diode splice, r4 fuse splice: about 4.8 mm, 30 mm per fuse) + thin-wall 2:1 (switch lugs) (class) | set | any | 1 | 1 | D2-46 |  |
| D2-46R: Neutral-cure silicone RTV, small tube (pigtail strain relief at the X1203 battery pads) (class) | tube | any | 1 | 1 | D2-46R |  |
| D2-47: Solder, flux, wick (class) | set | any | 1 | 1 | D2-47 |  |
| D2-48: Pull ribbon 10 mm (if the pack has none) + Kapton tape (class) | set | any | 1 | 1 | D2-48 |  |
| D2-49: Isopropyl alcohol + glue stick (bed release) (class) | set | any | 1 | 1 | D2-49 |  |
| D2-50: Small cable ties 2.5 mm (lead bundles) (class) | pack | any | 1 | 1 | D2-50 |  |
| D2-60: PH1 screwdriver, straight, shank dia <= 6.5, blade >= 40 mm (hand) (TLS-14 class) | ea | any | 1 | 1 | D2-60 |  |
| D2-61: 1/2 in (12.7 mm) deep socket for the CK1044 switch nut, driven on the bushing axis (class) | ea | any | 1 | 1 | D2-61 |  |
| D2-62: Fine tweezers (OLED, flex, microSD) (class) | ea | any | 1 | 1 | D2-62 |  |
| D2-63: Temperature-controlled soldering iron (class) | ea | any | 1 | 1 | D2-63 |  |
| D2-64: Digital multimeter + thermocouple (class) | ea | any | 1 | 1 | D2-64 |  |
| D2-65: Adjustable bench DC supply with current limit (>= 10 A for G-W5 and G-W12, else 3 A) (class) | ea | any | 1 | 1 | D2-65 |  |
| SC1149 | ea | MakerSupplies SG | 1 | 1 | D2-66 |  |
| SkyRC B6neo | set | Makerfire (US) | 1 | 1 | D2-67 |  |
| D2-68: Wire stripper / flush cutter, heat gun (class) | set | any | 1 | 1 | D2-68 |  |
| D2-69: Junior hacksaw + small flat file for measured 18/24 switch shaft trim (class) | set | any | 1 | 1 | D2-69 |  |
| D2-70: ESD mat + wrist strap (class) | set | any | 1 | 1 | D2-70 |  |
| D2-72: Digital calipers, 0.01 mm (class) | ea | any | 1 | 1 | D2-72 |  |
| D2-73: Oscilloscope >= 20 MHz + inline USB-C power meter (logging) (class) | set | any | 1 | 1 | D2-73 |  |
| D2-74: M3 heat-set tip in the tip system of the D2-63 iron (900M class for a YIHUA 928D or Hakko 936-type station, the T12 or TS100 range for those irons) + insert fallback set (pin vise or hand drill, 3.2 + 4.0 mm drills) (class) | set | any | 1 | 1 | D2-74 |  |
| D2-75: DC electronic load >= 10 A / 30 W, constant-current mode (r3 fix-baseline) (class) | ea | any | 1 | 1 | D2-75 |  |
| D2-77: Adjustable torque screwdriver 0.1-0.6 N m, straight, PH1 bit: shank dia <= 6.5 over >= 40 mm, handle dia <= 30 (the DRIVER audit envelope) (class) | ea | any | 1 | 1 | D2-77 |  |
| PHD-USSD-500G | ea | Princeton / distributor | 1 | 0 | V-09 |  |
| Adafruit 1505 | ea | Adafruit | 1 | 1 | V-17 |  |
| Adafruit 3556 | ea | Adafruit | 1 | 1 | V-21 |  |
| Adafruit 3557 | ea | Adafruit | 1 | 1 | V-21P |  |
| Adafruit 3562 | ea | Adafruit | 2 | 2 | V-22O, V-22OS (spare) |  |
| J2 class: Micro-Fit 3.0 2-circuit receptacle housing (socket contacts) | ea | Molex / authorized distributor (default pending user decision 13) | 2 | 2 | V-28, V-28S (spare) |  |
| J2 class: Micro-Fit 3.0 2-circuit plug housing (pin contacts) | ea | Molex / authorized distributor (default pending user decision 13) | 2 | 2 | V-28, V-28S (spare) |  |
| J2 class: Micro-Fit 3.0 pre-crimped lead, female terminal, >= 231 mm | ea | Molex / authorized distributor (default pending user decision 13) | 4 | 4 | V-28, V-28S (spare) |  |
| J2 class: Micro-Fit 3.0 pre-crimped lead, male terminal, >= 231 mm | ea | Molex / authorized distributor (default pending user decision 13) | 4 | 4 | V-28, V-28S (spare) |  |
| V-31: M2.5 x 8 pan-head PH1 lower stack/carrier screws (ISO 7045 PH1 class) | ea | unselected | 5 | 5 | V-31 |  |
| V-62: Deep socket for the Adafruit 1505 power-button nut, sized to the measured across-flats | ea | unselected | 0 | 0 | V-62 | Adafruit 1505 nut across-flats (MEASUREMENTS-TO-CLOSE "Adafruit 1505 power switch and J2 signal harness" row; VN-73) |
| V-63: Smooth-jaw long-nose pliers, fine tips (class; confirm on receipt) | ea | unselected | 1 | 1 | V-63 |  |
| V-64: Soft-jaw vise or vise with wood jaw pads (class; confirm on receipt) | ea | unselected | 1 | 1 | V-64 |  |
| V-65: Flat steel rule / bar (class; confirm on receipt) | ea | unselected | 1 | 1 | V-65 |  |
| V-66: Printer-paper knob shims and panel support block (class; confirm on receipt) | ea | unselected | 1 | 1 | V-66 |  |
| V-68: Two-part epoxy adhesive, small pack (bond the +Y tab-catch stub into the tub, B1 print_inserts) (class; structural two-part epoxy, confirm on receipt) | pack | any | 1 | 1 | V-68 |  |
| SDCZ880-256G | ea | any | 0 | 1 | D2-09 |  |

Spare policy (`wiring_data.SPARES`): one spare for every inline pair that is cycled in build or service or has few rated mating cycles, and for the fragile HDMI ribbon.

- V-23S for D2-23: EVF RCY-style pair (one 2180 + one 2181); parted at every EVF and module service (steps.SERVICE evf, module); no rating published.
- V-27S for D2-27: FPS PicoBlade pair (one 2181110202 + one 2181120201); tin contacts with a low rated mating-cycle count (BOM D2-27 note); parted on the bench at FPS service.
- V-28S for V-28: J2 keyed pair set (housings + pre-crimped leads); one J2 mating cycle per panel removal (ASSEMBLY section 5.1 J2 cycles).
- V-22OS for V-22O: HDMI ribbon, intact 300 x 10 mm; less durable and less shielded than a moulded cable (Adafruit 3562 page; review ELE-14); FPC latch or fold fatigue after services.

Gated purchases (quantity stays 0 until the measurement closes):

- V-62: Deep socket for the Adafruit 1505 power-button nut, sized to the measured across-flats. Gate: Adafruit 1505 nut across-flats (MEASUREMENTS-TO-CLOSE "Adafruit 1505 power switch and J2 signal harness" row; VN-73); then reuse a fitting deep socket; buy one only if none fits, after the measurement.

Junction families (VN-63): no two wire-to-wire junctions may share a mating family, whatever the circuit count (`wiring_data.shared_family_pairs`, checked in `validate`).

| Junction | BOM line | Family | Carries |
|---|---|---|---|
| `evf_5v` | D2-23 | pololu-rcy-2.5 | EVF 5 V after the diode (power, Pi USB2 VBUS) |
| `fps_1824` | D2-27 | molex-picoblade-1.25 | GPIO13 / GND (18/24 select) |
| `j2` | V-28 | molex-micro-fit-3.0 | Pi 5 J2 PWR_BUT / GND (power-button signal; never battery current) |
| `xt30` | D2-14 | amass-xt30 | battery current (pigtail to pack; power last) |

J2 family: Molex Micro-Fit 3.0 2-circuit wire-to-wire (3.0 mm pitch), default pending user decision 13. See WIRING-VERTICAL.md for the alternatives and the try-mate gate.

## Purchase changes against reviewed export18

Computed against history/reviewed-export18/BOM-VERTICAL.csv on the fields variant, installed_qty, installed_unit, purchase_qty, purchase_unit, included_in, sku_or_class, supplier (the docs audit compares the same fields; item, note and status edits are editorial and not listed).

- D2-26: changed (sku_or_class)
- V-22OS: added
- V-23S: changed (purchase_qty)
- V-27S: added
- V-28: changed (installed_unit, purchase_unit, sku_or_class, supplier)
- V-28S: added
- V-68: added

## Primary source checks

Supplier facts were read on 2026-10-09. No current availability or pricing is asserted. CAD envelopes and bend allowances are proxies; vendor dimensions do not qualify service fit.

- [storage](https://www.princeton.co.jp/product/storage/phdussd.html)
- [storage_studied_samsung](https://download.semiconductor.samsung.com/resources/data-sheet/2024_Samsung_Data_sheet_UFD_FIT_Plus_v1.2_10139817901318.pdf)
- [power](https://www.adafruit.com/product/1505)
- [power_drawing](https://cdn-shop.adafruit.com/datasheets/R13diagram.jpg)
- [picoblade_female](https://www.molex.com/content/dam/molex/molex-dot-com/products/automated/en-us/salesdrawingpdf/218/218112/2181120201_sd.pdf)
- [picoblade_male](https://www.molex.com/content/dam/molex/molex-dot-com/products/automated/en-us/salesdrawingpdf/218/218111/2181110201_sd.pdf)
- [picoblade_spec](https://www.molex.com/content/dam/molex/molex-dot-com/products/automated/en-us/productspecificationpdf/510/51021/510211009-PS-000.pdf)
- [fps_switch](https://lorlinelectronics.co.uk/wp-content/uploads/2020/11/CK-ROTARY-Nov-2020-1.pdf)
- [fps_stop](https://www.mouser.com/catalog/specsheets/CK2373-6.35X17.5MM-D-SHAFT-Lorlin-datasheet-160875.pdf)
- [gpio_donor](https://www.adafruit.com/product/1950)
- [usb_donor](https://www.adafruit.com/product/4448)
- [usb_donor_drawing](https://cdn-shop.adafruit.com/product-files/4448/C14289-001_datasheet.pdf)
- [evf_socket](https://www.pololu.com/product/2180)
- [evf_pin](https://www.pololu.com/product/2181)
- [j2](https://www.raspberrypi.com/documentation/computers/raspberry-pi.html#add-your-own-power-button)
- [hdmi_adapter](https://www.adafruit.com/product/3556)
- [hdmi_pi_adapter](https://www.adafruit.com/product/3557)
- [hdmi_ribbon](https://www.adafruit.com/product/3561)
- [hdmi_original_ribbon](https://www.adafruit.com/product/3562)
- [wire](https://www.progressiverc.com/products/prc-silicone-wire-16-awg)
- [wire_variants](https://www.progressiverc.com/products/prc-silicone-wire-16-awg.json)

All 56 inherited physical gates and M1 remain open. New candidate-specific gates are documented in `REVIEW.md`. Physical HDMI bend/retention and complete-loom service, final power-slack retention, J2 full connector placement/route, power-nut access and warm storage speed remain blockers; a CSV validation pass is not a fabrication release.
