AubergineShallow/digital8mm-vertical-nizo/cad/gs8-d2-v1/candidate-vertical/review-2026-10-10/REVIEW-electrical-bom.md

# Electrical, wiring and BOM review: vertical-Pi candidate (9ced753)

Dimension: electrical-bom. Reviewer: workflow agent, 2026-10-10. Read-only. Nothing in the clone was changed
(`git status` clean after every probe). Probes live next to this file: `drop_probe.py`, `slack_probe.py`,
`bom_diff_probe.py`, `bomcheck.log`.

## What was checked

- `BOM-VERTICAL.md/.csv`, `make_bom_vertical.py`, `ASSEMBLY-VERTICAL.md`, `REVIEW.md`, `MEASUREMENTS-TO-CLOSE.md`,
  `signal_routes.py` / `signal_routes_review.json`, `routes.py`, `power_routes.py`, `hdmi_routes.py`, `model.py`.
- Against r7: `electronics/gs8-d2-v1/WIRING.md`, `BOM.md`, `make_bom.py`, `cad/gs8-d2-v1/checks.py`, `layout.py`.
- Web (one look per doubtful part): Adafruit 1505, 3556, 3557, 3562, 4448; Pololu 2180; Princeton PHD-USSD;
  Lorlin CK1044; Raspberry Pi SC1432; PRC 16 AWG. Molex 2181110202 pages timed out (not confirmed).

## Claims that check out

- Report counts match the JSON: main 292/1/18 (only fail `pi5/cooler` 79.902671 mm3), plenum 49/0/21, HDMI 6/0,
  FPS 332 checks / 0 hits + 9 diagnostics, power 201 poses / 659 queries / 0 hits.
- Header map is unchanged and geometrically consistent: QT 1/3/5/6, 18/24 33/34, run 37/39. Probe of the source
  rows: pin 1 x -42.27, column pitch 2.54, pin 33 x -82.91, pin 37 x -87.99, pin 39 x -90.53; 5/6 share a column.
- I2C: encoder 0x37 (A0 bridged), X1203 gauge 0x36. GPIO6/GPIO16 stay reserved (inherited). Software and
  electronics folders are byte-unchanged from d38468e (`git diff --stat` empty), so W-6 power-key semantics
  (logind ignore, 2 s hold daemon, POWER_OFF_ON_HALT=1) are inherited. J2 is in parallel with the onboard button,
  so the electrical semantics are the same.
- Part identities are real: 1505 = 16 mm NO momentary, 29.4 mm max length, no rating published; 3556 = straight
  micro-HDMI plug 26.5 x 17.3 x 4; 3557 = R-bend micro-HDMI plug 17.5 x 15 x 14.5; 3562 = 30 cm x 10 mm ribbon;
  4448 = USB-A plug to 4 female jumpers, 30 cm; Pololu 2180 = RCY female, 2181 = male, 20 AWG, 10 cm;
  PHD-USSD-500G = USB 3.2 Gen 2, 34 x 15 x 7 mm incl. cap, 500/600 MB/s, no Linux listed, current not published;
  CK1044 = 1 pole 12 way, 6.35 x 38 flat shaft, PCB; SC1432 = Pi 5 8 GB; PRC SW-16R = over 250 x 0.08 mm, OD 3.0.
- Arithmetic is right for its inputs: 24 solder joints; 11 harnesses; 15 cable inputs; drop 0.129789 V cold and
  0.142811 V at 60 C (13.17 and 21 mohm/m, fuse 4.46, XT30 1 mohm, 8.6 A).
- Power last is kept: pack mated last (ASSEMBLY s8), battery isolation first in every service route (s1, s5).

## Probe results used below

- `drop_probe.py`: PRC strand area 252 x 0.08 mm = 1.2667 mm2, so 13.61 mohm/m before lay. 18 AWG fine strand
  150 x 0.08 = 0.754 mm2, 22.87 mohm/m (pack lead strand count is unknown; assumption). At 60 C: lay 1.00 gives
  0.1474 V (+2.6 mV); lay 1.02 gives 0.1494 V (+0.6 mV); lay 1.03 gives 0.1504 V (-0.4 mV). Hot fuse +10/20/30 %
  (assumed range, not data) gives -3.3/-7.1/-10.9 mV. Same model meets 0.150 V only with a shorter path.
- `slack_probe.py` (loads `routes.py`, CAD-free): QT main route + longest branch (27.67 mm). Over the solver's own
  bound (low 34..50) the shortest variant is 237.2..242.3 mm depending on qt_x; at the code's qt_x (-45.4) it is
  about 239 mm, i.e. under 1 mm slack at the 240 mm minimum lead and about 11 mm at nominal 250. Run lead minimum
  routes 214.3 mm (pin 37) and 209.5 mm (pin 39); the recorded routes are stretched to exactly 250.000 mm.
- `bomcheck.log`: `make_bom_vertical.py --check` under run_locked on this Windows machine exits 1, "Stale output:
  BOM-VERTICAL.md". `bom_diff_probe.py` (UTF-8 read) shows both files identical. Cause: `path.read_text()` with no
  encoding uses cp1252 here and the file contains U+2019.

## Findings

| id | sev | kind | title | evidence | failure scenario | fix | closable by |
|---|---|---|---|---|---|---|---|
| ELE-1 | major | latent | Pigtail drop margin (7.2 mV) uses solid-wire resistance; vendor strand data removes it, and no G-W5 fallback is left | BOM-VERTICAL.md:14, :123; make_bom_vertical.py:273-274 (13.17 and 21 mohm/m); power_routes.py:169. PRC page: over 250 x 0.08 mm = 1.267 mm2 = 13.61 mohm/m. drop_probe: +2.6 mV at lay 1.00, +0.6 mV at 1.02, -0.4 mV at 1.03; any hot-fuse rise goes over 0.150 V. r7 WIRING s4.7 fallback ladder ended at "16 AWG", which the candidate already uses. validate() asserts the value equals a constant, not that it is within the limit. | Wire is cut to 270 mm, G-W5 then measures more than 0.15 V at 8.6 A. No documented next step; the X1203 cuts out early at peak load and the pigtail must be rebuilt. | Recompute with the vendor strand area and a stated resistance range; add a limit assertion or a computed row (drop_hi <= 0.150 V). Before any cut, define the G-W5 stop branch: shorter finished path (same model, lay 1.02, cold fuse: 250 mm leaves about 6 mV, 225 mm about 13 mV), 14 AWG with a lane re-check, or a higher software cut-off (user decision). Never relax 0.150 V. | cad / checks / user_decision |
| ELE-2 | major | latent | No candidate wiring specification; the only WIRING still describes r7 parts and ASSEMBLY points to it | electronics/** unchanged (git diff --stat d38468e..9ced753 empty). WIRING.md:43,48,64 (plunger, stick on USB3 lower), :371 (PH pigtail on 18/24 lugs), :373 (PH plug on EVF lead), s6 pigtail 18 AWG 200-225 mm; harness-schedule.csv, pi5-header.csv, wiring-d2.svg same. ASSEMBLY-VERTICAL.md:138 "Prepare the baseline EVF feed, 18/24 lead and QT lead"; :220 "within qualified lanes" (none exist for QT/run/J2/EVF). J2 half genders, EVF RCY colour/polarity and diode band direction are not stated in candidate docs. Port naming is inconsistent: routes.py:651 "corrected lower USB2" vs routes.py:188/611 and official_pi5_geometry.py:84 "upper USB2". | A builder follows WIRING s7 and crimps/solders JST PH parts that the candidate BOM does not buy, or wires J2 halves with the same genders as FPS (see ELE-4). No pin table includes J2; no plug order exists for the new junctions. | Write WIRING-VERTICAL.md (block diagram, header + J2 table, harness schedule with both ends, lengths with tolerances, genders, colours, polarity, plug order and service unplug order), generated from candidate sources; mark baseline WIRING sections superseded for this fork. | docs |
| ELE-3 | major | latent | Signal-lead reach is not checked: routes are stretched to nominal stock length; QT 240 mm minimum and panel-off mating ignored | signal_routes.py:60-66 (QT solved so main + branch = 250), :137 (`_solve_top(make,250,35,80)` for run), :13-21 (no final-length check). signal_routes_review.json: qt 222.33 + 27.67, run 250.000/250.000. slack_probe: shortest QT variant in the solver's own bounds about 239 mm, so under 1 mm slack at 240 mm min; r7 mate_reach qt_enc kept 35.2 mm slack at 240 mm after a 24 mm margin with the panel 60 mm off (WIRING W-QT). Run lead "about 250 mm" (r7 BOM D2-12) treated as exact; min routes 214.3/209.5 mm not reported. signal_routes_review.json power_source_sha256 3b7db74a... matches no file in the repo (power_routes.py is 3fd2a630...); revision "angled-csi" is superseded; no manifest-bound report covers QT/run/J2/EVF feed. MEASUREMENTS-TO-CLOSE.md has no row for run lead, QT lead, RCY pair or EVF pads. | QT lead at 240-245 mm cannot reach the encoder with the panel propped off (ASSEMBLY s6 needs both housings accessible), or is under tension when closed. A short run lead does not reach pins 37/39. | Port r7 semantics: route length from a minimum path plus service allowance, check at the minimum stock length (QT 240, run lead measured range), report slack and mating-pose reach; bind the report to the current power source and manifest. Consider a longer QT (e.g. 270-280 mm, inside Adafruit's 300 mm note). Add measurement rows. | checks / cad / measurement |
| ELE-4 | minor | latent | J2 and FPS junctions are the same Molex pair (all black, no keying); a cross-mate holds the Pi power button | BOM D2-27 and V-28 use the same 2181110202 + 2181120201; REVIEW.md:217-218 (label only). D2-23 picks a different family for EVF "to prevent mating to PicoBlade signal pairs", J2 does not get the same protection. J2 half genders unspecified (ASSEMBLY-VERTICAL.md:123-126). | On the bench, the Pi-side J2 half is mated to the FPS switch half (or the GPIO13/GND half): at 24 fps J2 PWR_BUT is held to GND, giving the 2 s daemon shutdown, then press-to-boot or PMIC forced-off cycles; another mix ties GPIO13 to PWR_BUT. | Use a different family or circuit count for J2 (e.g. 3-circuit with a blanked cavity, or a 2-pin JST GH/SH pair), or fix genders so the in-body open pair cannot meet FPS, plus coloured sleeves; add a check row. | bom / docs |
| ELE-5 | minor | latent | Power control lost its guard: r7 recessed plunger replaced by an unguarded 16 mm button about 5 mm proud of the side panel | r7 layout.py:118 (guard rim 1.0 proud), :532-537 (finger face recessed 1.3 mm, travel 0.6). Candidate model.py:423 (button cylinder Y28..33, flange at Y28); REVIEW.md:203-205. W-6 aim: a brush of the hand cannot stop a take. | Camera rested or held on the panel side keeps KEY_POWER pressed: after 2 s a clean shutdown ends the take; a longer press reaches the PMIC forced off and may lose the last file. | Add a printed guard ring or recess so the cap sits flush or below a rim, or choose a flush panel switch; add it to G-V-POWER; user decides. | cad / user_decision |
| ELE-6 | minor | latent | EVF option C (the r3-recommended fallback) has no space in the vertical body; diode sleeve and RCY junction are unplaced; stale "ko_5v_up" and "PH pair" text | BOM D2-16P item text "inside ko_5v_up by box arithmetic" (r7 keep-out, absent in the candidate). No regulator/diode/junction volume in candidate geometry (grep: none in model.py, routes.py, power_routes.py). routes.py:611 "Diode + PH pair and all unmodeled stock need a separate full straight/loop model"; routes.py:737 "diode/PH pair remains straight". r7 WIRING W-3: G-W6 is expected to fail. BOM line 12: EVF donor routes unplaced. | G-W6 fails as predicted; the 16 x 7.5 x 4.5 mm LDO carrier, the sleeved diode and the 32 x 7 x 7 mm RCY reserve have nowhere checked to go, so the body or the EVF feed must be redesigned late. | Place and check volumes for the diode sleeve, RCY pair and an option-C carrier on the usb_5v route (stow box routes.py:737 is 42 x 24 x 8 mm); replace stale PH/ko_5v_up text. | cad / checks |
| ELE-7 | minor | latent | 20 AWG RCY tails soldered straight onto the small traced EXT+/GND pads of the EVF board | BOM D2-23 note ("The EVF board receives two soldered pigtail joints"; 2181 has 20 AWG silicone tails); ASSEMBLY-VERTICAL.md:240-245. r7 used a 24-26 AWG PH pigtail on these pads (WIRING W-4, BOM D2-23). No pad-size row in MEASUREMENTS-TO-CLOSE.md. | Stiff 20 AWG and a large solder fillet lift a traced pad during soldering or service handling; the EVF board is the one item with a long lead time. | Keep a short 24-26 AWG pigtail from the pads to the 2181 tail (two more splices), or record pad size first and add a measurement row; strain-relieve on the board edge. | measurement / bom |
| ELE-8 | minor | latent | 18/24 switch has silver contacts on a dry-circuit GPIO input | BOM D2-11 ("silver contacts"); WIRING W-5/W-8: Pi internal pull-up only, no added parts; CK1044 rated 150 mA/250 V (distributors). Pull-up current is tens of microamps. | Silver tarnish gives intermittent opens over months; the camera reads 18 fps when set to 24 (or flickers between them on vibration). | Add an external 1-2.2 kohm pull-up to 3V3 on GPIO13 for wetting current, or buy a gold-contact variant if Lorlin offers one; add a continuity/contact-resistance check at G-W9. PLAUSIBLE, not measured. | bom / user_decision |
| ELE-9 | minor | existing | HDMI ribbon end-plane keying / contact face is open, yet the BOM already fixes the R-bend 3557 head that depends on it | hdmi_routes.py:9-15 ("Natural U turn + one isometric 45-degree cylindrical miter fold"; "clocking are still gates"); routes.py:655 ("BLOCKED pending ... keyed end-plane sweep"); REVIEW.md:322 G-V-HDMI. verify_hdmi.py has no contact-face or pin-1 end-plane test (grep), so the 6 HDMI passes do not cover it. A miter fold turns the strip face-over. Adafruit sells R-bend 3557 and a separate L-bend part; BOM V-21P names 3557 as the buy. | The bought 3557 head mates only with the ribbon's contacts facing away from its FPC latch after the routed fold; the builder has to twist the ribbon (not in the checked route) or buy the other bend. | Track the conductor-face normal along the route and assert it matches each head's FPC contact side; confirm on the real parts before ordering the head. | checks / measurement |
| ELE-10 | minor | latent | `make_bom_vertical.py --check` fails on Windows though the BOM is current; regeneration writes CRLF | bomcheck.log: exit 1 "Stale output: BOM-VERTICAL.md"; bom_diff_probe: both files identical in UTF-8. make_bom_vertical.py:399 `path.read_text()` (cp1252 here; file has U+2019), :400 `write_text` without newline='' (CRLF on Windows); also :279, :286 read JSON with locale encoding. REPRODUCE.md:12 documents the check. | The user's reproduction on Windows reports a stale BOM; a regenerate rewrites both files with CRLF and creates whole-file diffs while --check still passes. | Use read_text(encoding='utf-8') and write with newline='' (or open(..., 'w', newline='\n')). | repo |
| ELE-11 | minor | latent | BOM spares and purchase view regressed; some items still unsized | V-23S = 0 (r7 bought 2 PH pairs, 1 spare); D2-27 and V-28 order the same two Molex SKUs on separate lines with no combined total and no spare for a 30-cycle tin contact; no spare 3562 ribbon or heads; D2-26 black SKU missing ("black colour selection"; page shows SW-16R only); D2-61 1/2 in socket inherited for the old CK1049 nut, CK1044 nut size not checked; V-62 power-nut tool 0 qty; D2-14F note says 625 queries while BOM line 10 and the report say 659. No prices or purchase links (r7 PURCHASE-LINKS-2026-10-09.md not updated for new parts). | Buyer orders one Molex pair, or no black 16 AWG, or finds the nut tool missing at the bench; inconsistent counts reduce trust in the BOM. | Add a consolidated buy view grouped by SKU, spare policy (RCY, PicoBlade, ribbon), the black wire SKU, nut sizes as receipt gates with a tool line; refresh the stale count; price and link when adopted. | bom |
| ELE-12 | major | existing | Pigtail service STOP: 270 mm finished paths, copper cuts, pad roots, flexible deployment, retention and hot drop all open | BOM-VERTICAL.md:13-14, D2-26; ASSEMBLY-VERTICAL.md:127-136 (STOP); power-service-checks.json remaining_stop (5 items); REVIEW.md:323 G-V-PIGTAIL. Rigid-pose check only (201 poses, 0 hits). | No cut length can be set; a wrong cut cannot be undone without new wire, and tied folds may not unfold for pack withdrawal. | Keep the STOP; close with the mock-up in MEASUREMENTS-TO-CLOSE plus ELE-1 fallback; add a flexible-core reach check at the pack-out pose. | measurement / checks |
| ELE-13 | major | existing | Replacement power switch and J2 lead are unplaced: 1505 drawing conflict, nut/tool access, J2 pad map, J2 connector stow; microSD path blocked by the switch body | BOM V-17, V-28, V-62 (0 qty), D2-04; REVIEW.md:199-221, :321 G-V-POWER; MEASUREMENTS-TO-CLOSE rows 1505/J2 and microSD; signal_routes_review.json power_button route starts on the Pi PCB at a hypothesised J2 point. | Switch cannot be clamped or its nut reached; J2 pads may sit under the cooler or another part, so the J2 route changes after build. | Keep the hold; measure real 1505 and J2 location first; then place the J2 pair and run a manifest-bound check. | measurement / cad |
| ELE-14 | minor | existing | HDMI DIY assembly (3557 + 3556 + 300 mm ribbon) is physically unqualified: bend R3, thickness, retention, EMI | BOM V-21, V-21P, V-22O; REVIEW.md:322; Adafruit 3562 page: not as durable or shielded as molded cables. hdmi_routes.py:119 strain proxy 6.67 % at R3 for an assumed 0.4 mm. Ribbon runs within 1.15-1.5 mm of the FPC and QT routes (signal_routes_review.json installed_hdmi_segment_aabb_clearance). | FPC latch or ribbon fatigue after a few services; unshielded TMDS near the CSI FPC causes EVF dropouts or camera errors. | Keep G-V-HDMI and G-W7; add a live EMI soak (record + EVF) to the gate; buy a spare ribbon (ELE-11). | measurement |
| ELE-15 | minor | existing | Compact storage Princeton PHD-USSD-500G: Linux, bus power and warm speed unproven | BOM V-09; REVIEW.md:183-190, :320 G-V-STORAGE. Vendor page: USB 3.2 Gen 2, OS list Windows/macOS only, no current figure. Pi 5 ports are 5 Gb/s, so the 500/600 MB/s figures cannot be reached (still above 100 MB/s on paper). | Drive throttles warm below 100 MB/s or browns out the 1.6 A USB budget with the EVF feed; compact body then loses its drive. | Keep G-W10 and G-V-STORAGE; add bus-current logging with the EVF lead on the inline meter (D2-73); original SDCZ880 body stays the fallback. | measurement |
| ELE-16 | minor | existing | EVF 5 V diode feed is kept although r3 expects G-W6 to fail; option C stays at qty 0 pending the user | BOM D2-16 to D2-16P; r7 WIRING W-3, s4.8. Candidate adds 28 AWG donor and 20 AWG RCY tails (small extra drop). | EVF voltage outside 4.25-4.90 V; option C is then needed (see ELE-6 for space). | User decision on option C before the build; if adopted, add volumes and checks. | user_decision |
| ELE-17 | info | existing | Inherited power envelope: 27 W planning peak above the X1203 25.5 W rating; 8.6 A sizing assumes a 3.3 V software cut-off | r7 WIRING s4.1, s4.7; BOM D2-13 (R-PACK-BMS). At 3.0 V (BMS UVP upper bound) the same 25.5 W draws 9.44 A (drop_probe). Not changed by the candidate. | If the software cut-off fails, current and drop rise beyond the sized case. | Keep G-W12/G-W5; keep the low-cell shutdown as a tested function. | measurement |

## Other suggestions

- Generate the candidate wiring tables from code (as r7 did with make_tables.py), so BOM, WIRING and ASSEMBLY cannot drift.
- Port the r7 electrical checks to the vertical geometry: cable_routes (slack with allowance), mate_reach (minimum
  lengths), lead_access pigtail_drop (limit row), cable_stow, header_housings, completeness.
- Solder a 2-pin 2.54 mm header into J2 and use a socket half instead of wire joints on the Pi; it removes two Pi
  solder joints and makes the Pi side replaceable (check height against the cooler first).
- Put the fuse rating, wire gauge and polarity on a small label at the XT30 female.
