AubergineShallow/digital8mm-vertical-nizo/cad/gs8-d2-v1/candidate-vertical/vent-study/angled-channel-trial/BOM-VERTICAL.md

# Vertical Pi candidate: complete review BOM

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

## Current checkpoint: assembly STOPs

- Current compact candidate uses integral concealed channels, cooler-side exterior Y-31 with interior Y-25.5, a 158 x 59 x 100 mm core and a plain 2.8 mm panel. Four former panel grooves had blind 0.2 mm floors, not through-vent area. Nine printed production parts and every purchased selection/quantity are unchanged from reviewed export18.
- Reviewed export18 is frozen history, manifest c9e1e20710bb5f947ad47fa62328cebffb099fd3832d22909056bf8f1867cc76. Its 288 pass / 2 fail / 18 info, six scoped HDMI passes, 332 clear FPS material checks plus nine separate clear keepout diagnostics and other service checks are not automatically current evidence for the concealed-channel tub. Read the new manifest-bound ventilation report and structural supplement for this revision.
- Retained unresolved failure: active cooler/source-Pi witness 79.902671 mm3. The old right-wall ray runs through the intentional CSI opening and does not measure adjacent wall thickness. Frozen adjacent-wall measurements describe the former wall. The former 11.669 mm3 Boolean-difference witness is not an established lost-material volume; the Pi raw component-volume sum is not occupied material. Full FPC and EVF donor wire routes remain unplaced. Storage plug keepout is non-material; actual mating stays open.
- Pigtail convention: positive 270 mm is the FINISHED PATH including a 20 mm rigid fuse/joint-sleeve zone; both 270 mm total path budgets include unresolved pad-root allowances; they are not extra length to add later. Actual copper cuts/overlaps and offcuts are not established. Buy one 914.4 mm stock length per colour; full flexible deployment remains unqualified.
- Conservatively charging both paths as 270 mm copper gives 0.142811 V at 8.6 A with copper at 60 C, just 7.2 mV below G-W5 before hot fuse/contact uncertainty. This nominal calculation is not a pass.
- Intact 300 mm HDMI selected; fragile 200 mm study rejected. Limited geometry checks do not qualify the full interacting loom or service.
- CSI slot remains straight 12 x 27 mm R1 (323.14 mm2) and unsealed. It bypasses the intended cooling path. Frozen export18 cylinder clearances do not establish current actual latch/jaw/FPC/cooler access, which remains on HOLD.

This concealed-channel evidence applies to compact Kowa. Reviewed export18 alternatives and their source/file, mesh, assembly-bound, mass/CoM and Kowa core-void comparisons remain historical until individually updated and rebound. No separate Fujinon void calculation or complete alternative harness/service audit is claimed.

## Count rules

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

The concealed normal throats are nominally 435.58 mm2 inlet, 99.56 mm2 side exhaust and 420.87 mm2 front exhaust. The straight CSI slot remains an unsealed bypass, and the source-driven floor passage adds body/grip air communication. Useful flow, pressure loss, hand occlusion, print-web quality and battery/thermal performance remain unqualified. Integral passages add no purchased fan, mesh, seal or duct part. See structural-review/CONCEALED-VENT-STRUCTURAL.md for the final mass/load sensitivity; old whole-tub binding does not apply.

## Installed pieces by category (not a grand total)

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

## Solder-joint accounting

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

## Harness inventory

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

## A. Electronics, optics, power

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

## B. Cables and leads

| Line / variant | Item and SKU | Installed | Buy | Spares / included | Qualification and source |
|---|---|---|---|---|---|
| D2-20 / both | Pi 5 camera cable Standard-Mini 22-to-15 pin, 200 mm; official 200 mm | 1 ea | 1 ea |  | source-corrected port; operational FPC access HOLD. Export18 uses source-registered CAM/DISP 1 and a 12 x 27 mm R1 slot, nominal area 323.14 mm2. The inherited rotated CSI proxy and prior tool pass are superseded. Official 200 mm cable retained; full material route remains unplaced. Both declared cylindrical reservations cleared frozen export18 solids; retained straight opening remains an unsealed cooling bypass and needs a new manifest-bound check; this does not qualify actual latch/jaws, cooler outline, stiffeners, contact orientation or cable withdrawal. [Source](../../../electronics/gs8-d2-v1/make_bom.py) |
| D2-21 / both | micro-HDMI D-D 200 mm (+10/-0), OD 3.0, Pi end 90 deg up, board end right-angle (-Y exit); EVF-SELECTION A3 class | 0 ea | 0 ea |  | replaced in both vertical variants. Replaced by one V-21 straight EVF head, one V-21P right-angle Pi head and one V-22O 300 mm ribbon in either body variant. V-22 200 mm ribbon is rejected at quantity zero. One old molded cable becomes three purchased pieces, net +2 pieces. [Source](../../../electronics/gs8-d2-v1/make_bom.py) |
| D2-22 / both | USB-A power-feed donor: Adafruit 4448 four-core breakout cable, cut to verified route; Adafruit 4448 / C14289-001 | 1 ea | 1 ea | Four removed jumper ends and unquantified wire offcuts; not installed parts | conditional donor; source-registered USB2 reservation, actual plug/route unqualified. One purchased cable. Catalog says 300 mm; supplier drawing says 325 +/- 10 mm, 4 x 28 AWG copper (7/0.12), jacket OD 3.6 mm and 25 mm breakout. This explicitly replaces the inherited generic 24-26 AWG lead. The old 200 mm is a route allocation, not purchased length or a cut instruction. Retain the conservative full plug/bend reserve: overmold, strain relief and wire-exit dimensions are unpublished, so no exact fit/exit claim. Red VBUS and black GND only; individually insulate unused white D- and green D+ with TWO separate sleeves, plus shield insulation only if a shield is present. No data connection. Verify every conductor by continuity. Export18 places the estimated head at source-registered USB2; the rejected RJ45-row pose is historical. Actual plug/exit measurements and the full cable/service route remain unresolved. Retain the inline diode; final donor/RCY copper cuts, overlaps and storage are TBD. G-W6 must recheck EVF voltage/drop/heating at measured current with the 28 AWG donor. [Source](https://cdn-shop.adafruit.com/product-files/4448/C14289-001_datasheet.pdf) |
| D2-23 / both | EVF power-only inline pair: Pololu 2180 socket-contact half + 2181 pin-contact half; Pololu 2180 + 2181, Generic RCY-style; one of each | 1 matched pair | 1 pair (one 2180 and one 2181) | No spare pair provision; actual tail offcuts TBD | conditional matched Generic pair; no JST rating inherited. Replaces unsupported PH wire-to-wire pair, not an EVF board socket. Buy ONE 2180 and ONE 2181. Both have nominal 100 mm 20 AWG silicone tails, stripped/tinned; trim only after complete routing and joint budgets are verified. Use 2180 recessed SOCKET contacts on USB source side, 2181 on the EVF board side; confirm actual mating/continuity and insulate when separated. Brand is explicitly Generic; no current/contact-resistance/OD/tolerance rating is published and JST specifications must not be borrowed. Vendor housing lengths are 13 mm and 19 mm; reserve their full sum 32 mm axially, width 7 mm and provisional thickness 7 mm until actual mated geometry is measured. This is a planning reserve, not a guaranteed vendor bound. Keep straight exit space and real disconnect access. Distinct family prevents mating to PicoBlade signal pairs; label EVF polarity. Preserve G-W6 voltage/drop, contact heating, pull retention and insulation gates. Two housings and four factory contacts are included below; no crimper. The EVF board receives two soldered pigtail joints at traced EXT+/GND pads. [Source](https://www.pololu.com/product/2180) |
| D2-24 / both | QT lead part 1: Adafruit 4397 STEMMA QT to female sockets, 150 mm (cut so the socket end is about 93-117 mm, WIRING W-QT); Adafruit 4397 | 1 retained socket-end lead section | 1 ea |  | inherited; unqualified. Join to D2-24B by pin-number continuity, not colour alone; four QT splice joints. Finished QT lead 250 +/- 10 mm. Revised routing requires a new straight splice/stow location. [Source](../../../electronics/gs8-d2-v1/make_bom.py) |
| D2-24B / both | QT lead part 2: Pololu #5521 JST SH-style 4-pin cable, single-ended female, 30 cm, 28 AWG (SH end kept; cut so the finished lead is 250 +/- 10 mm); Pololu 5521 | 1 retained SH-end lead section | 1 ea |  | inherited; unqualified. One purchased cable contributes the SH end; offcut is not another harness. Combined finished lead is 250 +/- 10 mm with D2-24. [Source](../../../electronics/gs8-d2-v1/make_bom.py) |
| D2-25 / both | GPIO donor jumpers: two cut female-ended stubs from Adafruit 1950 pack; Adafruit 1950 | 2 female-ended donor stubs; installed lengths TBD | 1 pack of 20 female/female 150 mm jumpers | 18 intact jumpers plus two removed ends and unquantified wire offcuts | conditional new-build donor; measured cut/fit gates open. Use two distinct colours for GPIO13 pin 33 and ground pin 34. Each stock jumper has 2.54 mm female contacts at both ends and 28 AWG wire (7 strands of 36 AWG). Retain one female housing/contact on each selected jumper; cut measured stubs and join to trimmed blunt-ended PicoBlade male wires using TWO solder splices and TWO insulating sleeves. Included housing/contact counts below are constituents, not additional purchases. No crimp tool. Vendor does not specify complete housing dimensions or insulation OD and warns the silver-latch side is slightly wider than 2.54 mm; verify orientation, adjacent fit, retention and the modeled envelope on receipt. Stock length is not installed length; per-core stub/copper cuts, splice overlaps and combined route budgets remain TBD until actual root/termination dimensions are measured against the selected source-bound FPS route. Replaces the unsupported generic Dupont-to-PH donor identity. [Source](https://www.adafruit.com/product/1950) |
| D2-27 / both | FPS inline pair: Molex 2181110202 male + 2181120201 female pigtail assemblies; Molex 2181110202 + 2181120201 (one of each) | 1 mated pair within one FPS harness | 1 pair (one 225 mm male and one 150 mm female assembly) | Measured wire offcuts TBD; both factory Molex housings retained | selected mated-carry route; export18 scoped CAD pass, physical cuts/service unqualified. Supersedes unsupported generic PH wire-to-wire identity and old 200+50 mm accounting. Purchased rear-housing-exit-to-blunt-end lengths: male 225 +/- 6 mm, female 150 +/- 6 mm; two black 28 AWG UL1061 cores per half. Installed main nominal axis is 200.000 mm INCLUDING D2-25 donor stubs and splice region; female-to-A axis 95.4644 mm and female-to-throw2 axis 102.4759 mm precede unresolved solder allowances. These are study axes, not copper cuts. See FPS-SERVICE-STUDY.md for staggered splice midpoints and illustrative overlap convention. Both housings and four contacts included below. Keep pair mated while the independently supported switch and whole harness move with carrier; disconnect only on bench. No sacrificial tie or in-body connector draw-out. Actual heads, individual-core fanout, terminal geometry, root allowances and complete integrated USB/CSI/service checks remain open. Mated body 9 mm is reference only; male 8 mm and female 3.95 mm are not equal halves. Polarized friction lock has no alternate keying: label FPS distinctly from J2 and continuity-test black wires. System 1.5 A maximum at 28 AWG / 125 V and 30 tin-contact mating cycles are not a physical service qualification. [Source](https://www.molex.com/content/dam/molex/molex-dot-com/products/automated/en-us/salesdrawingpdf/218/218111/2181110201_sd.pdf) |
| D2-26 / both | PRC high-flex pure-copper 16 AWG silicone wire, red and black; PRC 16 AWG; red SW-16R; black colour selection | 2 conductor-path allocations; copper cuts TBD | 2 36 in lengths, one per colour | Offcuts not fixed; determine after measured cuts, joint overlaps and pad allowance | provisional length; service route blocked. Purchase one 914.4 mm stock length per colour. POSITIVE: 270 mm FINISHED-PATH allocation includes a 20 mm rigid fuse/joint-sleeve zone; actual copper cut and solder overlap must be measured/trimmed to that finished path, not 270 mm copper plus fuse. NEGATIVE: 270 mm total path budget includes unresolved pad-root allowances. BOTH budgets include those allowances; they are not extra length to add later. Neither is a proved production cut; no exact offcut claim. Electrical estimate conservatively charges BOTH as 270 mm copper: at 8.6 A cold drop 0.129789 V and copper-at-60 C drop 0.142811 V, leaving about 7.2 mV before hot fuse/contact/pad uncertainty under the unchanged 0.15 V G-W5 limit. Vendor OD 3.0 mm; reserve 3.2 mm/core, 6.4 x 3.2 mm pair. Existing pack lead stays 60 mm 18 AWG. Four carrier tie eyes are present; separate red/black cold-side slack retention is provisional. Full stored-length/bend and battery-disconnect reach checks pending; fixed ties cannot be assumed to unfold for service. Nominal resistance is not a vendor specification or hot-test pass. [Source](https://www.progressiverc.com/products/prc-silicone-wire-16-awg) |
| V-21 / both | Straight micro-HDMI plug adapter, EVF end; Adafruit 3556 | 1 ea | 1 ea |  | candidate; unqualified. 26.5 x 17.3 x 4 mm; one at EVF only. Replaces earlier two-straight-head proposal. Ribbon not included. Mating, retention and tool access gated. [Source](https://www.adafruit.com/product/3556) |
| V-21P / both | Right-angle R-bend micro-HDMI plug adapter, Pi end; Adafruit 3557 | 1 ea | 1 ea |  | candidate; unqualified. 17.5 x 15 x 14.5 mm; one at Pi. Actual connector clocking, rigid envelope and service access gated. Together with V-21 and one selected ribbon, three purchased pieces total. [Source](https://www.adafruit.com/product/3557) |
| V-22 / compact only | Rejected study: HDMI ribbon cable, intact 200 x 10 mm; Adafruit 3561 | 0 ea | 0 ea |  | rejected/fragile; not installed. Full 200 mm study had effectively zero tolerance reserve with both heads unplugged. Retained research record only; primary compact length is now 300 mm V-22O. No procurement or service-fit recommendation. [Source](https://www.adafruit.com/product/3561) |
| V-22O / both | HDMI ribbon cable, intact 300 x 10 mm; Adafruit 3562 | 1 ea | 1 ea |  | conditional primary; export18 scoped checks passed; physical HOLD. One intact 300 mm ribbon for either compact or original-storage body, with 3557/3556 heads. Selected routing input: routing-snapshots/hdmi-corrected-ports-20261009-0623/input.json. Frozen export18 report has 6 scoped passes / 0 failures; it requires rebinding to the concealed-vent tub. Earlier over-PCB tool failures remain rejected diagnostics; CSI operational access stays on HOLD. This does not qualify complete interacting loom service. Actual availability, full-width/slack/service tolerance, bend/thickness/clocking/EMI and retention remain gates. [Source](https://www.adafruit.com/product/3562) |
| V-23S / both | Optional spare EVF Generic RCY-style matched pair; Pololu 2180 + 2181 | 0 pair | 0 pair |  | optional spare; not included in actual buy count. Former spare-pair provision is quantity zero. A future spare would require one of each half and the same receipt/continuity/fit checks; not ordered or installed. [Source](https://www.pololu.com/product/2180) |
| V-28 / both | J2 removable signal pair: two single-ended factory pigtail assemblies; Molex 2181120201 + 2181110202 (one of each) | 1 pair | 1 pair | Measured wire offcuts TBD; factory flag labels removed/bagged only after recording identity and applying small circuit labels | conditional selected family; complete route unqualified. One purchased pair means ONE 2181120201 female assembly with 150 +/- 6 mm exposed tails AND ONE 2181110202 male assembly with 225 +/- 6 mm exposed tails, housing excluded from those length datums. Both are two-circuit 28 AWG UL1061 black-wire assemblies, explicitly replacing the provisional 24-26 AWG class. Trim only to the separately established J2 route; 150 mm combined per-conductor finished-path target is provisional, not a copper-cut instruction. Two housings/four contacts included below. Four solder joints remain: two J2 pads and two switch terminals; no connector crimps or additional splices. Nominal mated reference body 9 x 4.25 x 3.3 mm fits the estimated 6 x 8 x 12 mm reserve with mating axis Z; actual tolerance, latch, travel, wire exits, full stow and pad/terminal access remain unplaced/unqualified. W/W system rated 1.5 A max for 28 AWG and 125 V; signal use only, never battery current. Polarized friction lock but no alternate keying: label J2 separately from FPS if that family is shared, verify both black-wire circuits by continuity, and prevent cross-connection. Tin system durability is 30 mating cycles; repeated service remains a gate. Factory 12.7 x 35.5 mm flag labels are not modeled as installed clearance. [Source](https://www.molex.com/content/dam/molex/molex-dot-com/products/automated/en-us/salesdrawingpdf/218/218112/2181120201_sd.pdf) |

## C. Fasteners

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

## E. Consumables

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

## F. Tools and accessories (not in the camera)

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

## G. Included-kit detail (do not buy or sum with parent assemblies)

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

## D. Printed production parts

| Line / variant | Item and SKU | Installed | Buy | Spares / included | Qualification and source |
|---|---|---|---|---|---|
| P-tub / both | tub; ASA, satin silver | 1 part | 0 part |  | candidate; unqualified. Concealed-vent revision: tub has integral diagonal passages and exterior stock at Y-31 with inner datum Y-25.5; panel is plain 2.8 mm after removal of four blind grooves. Slice orientation, supports, filament and measured print mass remain pending. Nine compact production parts retained; this is a production-part count, not a purchase quantity. [Source](model.py) |
| P-panel / both | panel; ASA, satin silver | 1 part | 0 part |  | candidate; unqualified. Concealed-vent revision: tub has integral diagonal passages and exterior stock at Y-31 with inner datum Y-25.5; panel is plain 2.8 mm after removal of four blind grooves. Slice orientation, supports, filament and measured print mass remain pending. Nine compact production parts retained; this is a production-part count, not a purchase quantity. [Source](model.py) |
| P-carrier / both | carrier; ASA, black | 1 part | 0 part |  | candidate; unqualified. Slice orientation, supports, filament and measured print mass remain pending. Nine compact production parts retained; this is a production-part count, not a purchase quantity. [Source](model.py) |
| P-base_grip / both | base_grip; ASA, black | 1 part | 0 part |  | candidate; unqualified. Slice orientation, supports, filament and measured print mass remain pending. Nine compact production parts retained; this is a production-part count, not a purchase quantity. [Source](model.py) |
| P-cap / both | cap; ASA, black | 1 part | 0 part |  | candidate; unqualified. Slice orientation, supports, filament and measured print mass remain pending. Nine compact production parts retained; this is a production-part count, not a purchase quantity. [Source](model.py) |
| P-eyecup / both | eyecup; TPU 95A, black | 1 part | 0 part |  | candidate; unqualified. Slice orientation, supports, filament and measured print mass remain pending. Nine compact production parts retained; this is a production-part count, not a purchase quantity. [Source](model.py) |
| P-knob_exp / both | knob_exp; ASA, black | 1 part | 0 part |  | candidate; unqualified. Slice orientation, supports, filament and measured print mass remain pending. Nine compact production parts retained; this is a production-part count, not a purchase quantity. [Source](model.py) |
| P-knob_fps / both | knob_fps; ASA, black | 1 part | 0 part |  | candidate; unqualified. Slice orientation, supports, filament and measured print mass remain pending. Nine compact production parts retained; this is a production-part count, not a purchase quantity. [Source](model.py) |
| P-lens_collar / both | lens_collar; ASA, black; thermal qualification pending | 1 part | 0 part |  | candidate; unqualified. Slice orientation, supports, filament and measured print mass remain pending. Nine compact production parts retained; this is a production-part count, not a purchase quantity. [Source](model.py) |
| P-stick_sleeve / original only | stick_sleeve; ASA, satin silver | 1 part | 0 part |  | candidate; unqualified. Slice orientation, supports, filament and measured print mass remain pending. Nine compact production parts retained; this is a production-part count, not a purchase quantity. [Source](model.py) |

## Primary source checks

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
