AubergineShallow/digital8mm-vertical-nizo/cad/gs8-d2-v1/candidate-vertical/BOM-VERTICAL.csv

section | line | item | variant | status | installed_qty | installed_unit | purchase_qty | purchase_unit | spare_or_remainder | included_in | sku_or_class | supplier | layout_id | note | source
A. Electronics, optics, power | D2-01 | Raspberry Pi 5, 8 GB | both | inherited; unqualified | 1 | ea | 1 | ea |  |  | SC1432 (8 GB, prices.json); layout pn SC1111/SC1112 | Cytron SG | pi5 | Same board, physically rolled into a vertical XZ PCB plane; no replacement compute platform. | ../../../electronics/gs8-d2-v1/make_bom.py
A. Electronics, optics, power | D2-02 | Raspberry Pi Active Cooler | both | inherited; unqualified | 1 | ea | 1 | ea |  |  | SC1148 | MakerSupplies SG | cooler | Inherited specification; baseline source line D2-02. Candidate assembly sequence supersedes baseline step numbers. | ../../../electronics/gs8-d2-v1/make_bom.py
A. Electronics, optics, power | D2-03 | Geekworm X1203 UPS board (pogo pins, 1S input, 5.1 V 5 A) with its M2.5 standoff kit | both | inherited; unqualified | 1 | ea | 1 | ea |  |  | X1203 | Geekworm | x1203 | One UPS purchase includes four standoffs and eight original M2.5 x 5 screws. Install four original upper screws and four replacement M2.5 x 8 lower screws (V-31); bag the four removed lower screws. Included detail below is not another purchase. | ../../../electronics/gs8-d2-v1/make_bom.py
A. Electronics, optics, power | D2-04 | microSD card, A2 class, 32-64 GB (OS only, front slot) | both | inherited; unqualified | 1 | ea | 1 | ea |  |  | A2 class | any | microsd | Fit the OS card on the bench before carrier insertion; it stays with the carried stack. The closed-panel +X extraction path intersects the panel-mounted power-switch body. Remove the panel and verify actual reach before withdrawing the card, or service it on the bench with the complete module. The panel-off sweep is not a closed-body access pass. | ../../../electronics/gs8-d2-v1/make_bom.py
A. Electronics, optics, power | D2-05 | Raspberry Pi Global Shutter Camera (IMX296) with its C-CS adapter | both | inherited; unqualified | 1 | ea | 1 | ea |  |  | SC0926 | Cytron SG | gs_camera | C-CS adapter included. Remove tripod block and its two supplied screws at supported optical bench setup; bag them. Never react lens torque through PCB or cover. | ../../../electronics/gs8-d2-v1/make_bom.py
A. Electronics, optics, power | D2-06 | C-mount lens: Kowa LM6HC 6 mm f/1.8 1 in (default, 215 g) | both | inherited; unqualified | 1 | ea | 1 | ea |  |  | LM6HC | Kowa distributor | lens | Default review geometry only; final lens decision and measured support band remain open. M1 remains open for the revised collar. | ../../../electronics/gs8-d2-v1/make_bom.py
A. Electronics, optics, power | D2-06b | Alternative lens: Fujinon HF6XA-5M 6 mm (100 g); order instead of D2-06 | both | optional; not adopted | 0 | ea | 0 | ea |  |  | HF6XA-5M | Fujifilm distributor |  | Alternative, not an additional installed lens. Requires its own measured support band and collar; no baseline CoM claim is carried into the vertical candidate. | ../../../electronics/gs8-d2-v1/make_bom.py
A. Electronics, optics, power | D2-07 | EVF-A display kit: Hicenda HMX039 0.39 in 1024x768 micro-OLED + HDMI board (option "Display+HDMI Board+Prism") | both | inherited; unqualified | 1 | kit | 1 | kit |  |  | Hicenda Tindie kit | Hicenda (Tindie) | hmx039 | One kit purchase covers OLED emitter, driver board and native flex; included detail below is not a second purchase. Identity, power range and flex/service gates remain open. | ../../../electronics/gs8-d2-v1/make_bom.py
A. Electronics, optics, power | D2-08 | EVF-A eyepiece: Display Components 0PE039-16X glass eyepiece | both | inherited; unqualified | 1 | ea | 1 | ea |  |  | 0PE039-16X | Display Components (Tindie) | eyepiece | Inherited specification; baseline source line D2-08. Candidate assembly sequence supersedes baseline step numbers. | ../../../electronics/gs8-d2-v1/make_bom.py
A. Electronics, optics, power | D2-09 | SanDisk Extreme PRO USB 3.2 solid state flash drive, 256 GB | original only | fallback; unqualified | 1 | ea | 1 | ea |  |  | SDCZ880-256G | any | usb_stick | SDCZ880-256G retained only with 185 mm original-storage body and sleeve. Do not buy with V-09 for one camera. Warm sustained G-W10 still required. | ../../../electronics/gs8-d2-v1/make_bom.py
A. Electronics, optics, power | D2-10 | Adafruit 5880 I2C STEMMA QT rotary encoder (encoder pre-soldered) | both | inherited; unqualified | 1 | ea | 1 | ea |  |  | Adafruit 5880 | Adafruit / DigiKey | encoder | Bridge A0 to select I2C address 0x37; same exposure control. | ../../../electronics/gs8-d2-v1/make_bom.py
A. Electronics, optics, power | D2-11 | 18/24 selector: Lorlin CK1044 imperial PCB rotary switch with adjustable stop | both | conditional corrected selection; physical integration/service unqualified | 1 | ea | 1 | ea |  |  | Lorlin CK1044 | Lorlin / authorized distributor | switch_1824 | Replaces inconsistent inherited CK1049/6.35D description. CK1044 is 1 pole, 12 positions, BBM, silver contacts, PCB pins, standard 30-degree indexing; set supplied stop/tang washer to two adjacent positions and verify continuity. Body diameter 27.5 mm, mounting face to rear body 14.1 mm and PCB pin ends 18.1 mm. Preserve all 13 terminals, including unused ones; actual pin section/clocking remain receipt gates. Imperial bushing 9.52 mm x 32 TPI projects 8 mm; shaft diameter 6.35 mm, across-flat 5.5 mm, stock length 38 mm from mounting face with 30 mm end flat. Proposed cut 11.8 mm from mounting face gives about 3.55 mm flat engagement after 0.25 mm bushing clearance; measure actual stack before cutting and coupon-test knob fit/removal force. Corrected candidate knob is 24 mm diameter, with adjacent 30-degree detent markings. Common A and throw 2 give open/high 18 and closed/low 24 under existing software, only after real continuity confirms numbering. Nut, mounting washer and stop/tang washer are separate planned constituents; mounting-washer inclusion and all hardware dimensions remain receipt gates. Do not lose or reset the stop ring during knob/nut/panel removal. | https://lorlinelectronics.co.uk/wp-content/uploads/2020/11/CK-ROTARY-Nov-2020-1.pdf
A. Electronics, optics, power | D2-12 | Run button: pre-wired momentary, red cap, female-socket leads | both | inherited; unqualified | 1 | ea | 1 | ea |  |  | Squid Button (non-latching) class | The Pi Hut | run_button | Prewired record/run button; its lead is included, not a separate purchase. GPIO26, pins 37/39 unchanged. | ../../../electronics/gs8-d2-v1/make_bom.py
A. Electronics, optics, power | D2-13 | 1S2P 18650 pack: 2 high-drain cells (>= 10 A class), BMS >= 10 A, 18 AWG lead, XT30U male, pull ribbon | both | inherited; unqualified | 1 | ea | 1 | ea |  |  | 1S2P custom (Molicel P28A / Samsung 35E class) | pack builder | pack | Pack, BMS, existing 60 mm 18 AWG lead and XT30 male retained. Check the numeric R-PACK-BMS specification in baseline WIRING; no 2S or other power architecture substitution. Battery is physically disconnected before any internal service. | ../../../electronics/gs8-d2-v1/make_bom.py
A. Electronics, optics, power | D2-14 | XT30U connector pair (female for the pigtail; male if the pack lacks one) | both | inherited; unqualified | 1 | female connector | 2 | pair | 1 spare female + 2 loose male connectors when pack already has its male |  | Amass XT30U | any | xt30_pair | Buy two pairs as baseline provision. Fit one female to the camera pigtail; pack-side male is included with D2-13. Loose males are not additionally installed; one can replace a missing pack male (+2 joints). | ../../../electronics/gs8-d2-v1/make_bom.py
A. Electronics, optics, power | D2-14F | Inline fuse 15 A, very fast, axial PICO II, 32 V (pigtail + conductor near the XT30 female; W-10, r4) | both | inherited; unqualified | 1 | ea | 2 | ea | 1 spare fuse |  | Littelfuse 0251015.MXL (DigiKey F2352-ND) | DigiKey |  | Retain 15 A axial fuse near the XT30 female in the positive pigtail conductor. ONE installed inline fuse; legacy side-mounted duplicate is removed from the proxy. Frozen 21-degree yaw/45-degree pitch pose and source-driven swept floor passage are integrated. Export18 rigid-power report: 201 poses/659 queries/zero hits. This is not a complete flexible-harness service pass. Flexible-path deployment, actual copper cuts/overlaps, pad/pin exits, retention and hot-drop remain STOPs; positive 270 mm finished path includes the 20 mm rigid fuse/joint-sleeve zone. | ../../../electronics/gs8-d2-v1/make_bom.py
A. Electronics, optics, power | D2-15 | Hand strap, 12 mm webbing with buckle | both | inherited; unqualified | 1 | ea | 1 | ea |  |  | class | any | strap | Same hand strap; upper anchors move 12 mm in Y and 18.5 mm rearward in X. Check access with the strap installed. | ../../../electronics/gs8-d2-v1/make_bom.py
A. Electronics, optics, power | D2-16 | Schottky diode 1N5817 (EVF 5 V lead, W-3; baseline feed) | both | inherited; unqualified | 1 | ea | 2 | ea | 1 spare diode |  | MCC 1N5817-TP | DigiKey SG |  | Baseline EVF feed provision only; G-W6 remains open. The vertical redesign does not qualify this feed or adopt the optional regulator. | ../../../electronics/gs8-d2-v1/make_bom.py
A. Electronics, optics, power | D2-16R | Candidate (option C, WIRING s4.8; qty 0 until the user adopts it or G-W6 fails): LDO, adjustable 500 mA, set to 4.553 V by D2-16D (R-EVF-REG band 4.459-4.638 V from datasheet limits) | both | optional; not adopted | 0 | ea | 0 | ea |  |  | TI TLV75801PDBVJ (SOT-23-5) or TLV75801PDRVR (WSON-6, reflow) | DigiKey |  | Baseline EVF-feed option C retained at quantity zero; not adopted. See WIRING section 4.8 and G-W13. No geometry, power or thermal qualification is implied. | ../../../electronics/gs8-d2-v1/make_bom.py
A. Electronics, optics, power | D2-16D | Candidate (option C): divider resistors for D2-16R, R1 11.5 kohm + R2 1.58 kohm, 0.1 %, 0603 | both | optional; not adopted | 0 | ea | 0 | ea |  |  | thin film 0.1 % class | any |  | Baseline EVF-feed option C retained at quantity zero; not adopted. See WIRING section 4.8 and G-W13. No geometry, power or thermal qualification is implied. | ../../../electronics/gs8-d2-v1/make_bom.py
A. Electronics, optics, power | D2-16C | Candidate (option C): MLCC CIN 2.2-4.7 uF + COUT 4.7 uF, X7R, 16 V, 0805 (TLV75801P; the XC6220 would need 10 uF + 10 uF, 1206 25 V) | both | optional; not adopted | 0 | ea | 0 | ea |  |  | class | any |  | Baseline EVF-feed option C retained at quantity zero; not adopted. See WIRING section 4.8 and G-W13. No geometry, power or thermal qualification is implied. | ../../../electronics/gs8-d2-v1/make_bom.py
A. Electronics, optics, power | D2-16P | Candidate (option C): small SOT-89 carrier PCB with copper (est. 16 x 7.5 x 4.5 sleeved envelope reserved on the installed usb_5v route (routes.py FEED_VOLUMES); carrier not measured) | both | optional; not adopted | 0 | ea | 0 | ea |  |  | SOT-23-5 / WSON-6 carrier with copper pour (custom; no 4.5 V module found) | any |  | Baseline EVF-feed option C retained at quantity zero; not adopted (default pending user decision 10, VN-80). Its 16 x 7.5 x 4.5 mm reserve is kept free on the installed usb_5v route, centred in the diode splice zone it would replace (harness feed_volumes usb_5v_option_c_reserve). See WIRING section 4.8 and G-W13. No power or thermal qualification is implied. | ../../../electronics/gs8-d2-v1/make_bom.py
B. Cables and leads | D2-20 | Pi 5 camera cable Standard-Mini 22-to-15 pin, 200 mm | both | source-corrected port; operational FPC access HOLD | 1 | ea | 1 | ea |  |  | official 200 mm | MakerSupplies SG | fpc | Export18 uses source-registered CAM/DISP 1 and a 12 x 27 mm R1 slot, nominal area 323.14 mm2. The inherited rotated CSI proxy and prior tool pass are superseded. Official 200 mm cable retained; full material route remains unplaced. Both declared cylindrical reservations clear the selected saved solids; the retained straight opening remains an unsealed cooling bypass; this does not qualify actual latch/jaws, cooler outline, stiffeners, contact orientation or cable withdrawal. | ../../../electronics/gs8-d2-v1/make_bom.py
B. Cables and leads | D2-21 | micro-HDMI D-D 200 mm (+10/-0), OD 3.0, Pi end 90 deg up, board end right-angle (-Y exit) | both | replaced in both vertical variants | 0 | ea | 0 | ea |  |  | EVF-SELECTION A3 class | any | hdmi | Replaced by one V-21 straight EVF head, one V-21P right-angle Pi head and one V-22O 300 mm ribbon in either body variant. V-22 200 mm ribbon is rejected at quantity zero. One old molded cable becomes three purchased pieces, net +2 pieces. | ../../../electronics/gs8-d2-v1/make_bom.py
B. Cables and leads | D2-22 | USB-A power-feed donor: Adafruit 4448 four-core breakout cable, cut to verified route | both | conditional donor; source-registered USB2 reservation, actual plug/route unqualified | 1 | ea | 1 | ea | Four removed jumper ends and unquantified wire offcuts; not installed parts |  | Adafruit 4448 / C14289-001 | Adafruit | usb_5v | One purchased cable. Catalog says 300 mm; supplier drawing says 325 +/- 10 mm, 4 x 28 AWG copper (7/0.12), jacket OD 3.6 mm and 25 mm breakout. This explicitly replaces the inherited generic 24-26 AWG lead. The old 200 mm is a route allocation, not purchased length or a cut instruction. Retain the conservative full plug/bend reserve: overmold, strain relief and wire-exit dimensions are unpublished, so no exact fit/exit claim. Red VBUS and black GND only; individually insulate unused white D- and green D+ with TWO separate sleeves, plus shield insulation only if a shield is present. No data connection. Verify every conductor by continuity. Export18 places the estimated head at source-registered USB2; the rejected RJ45-row pose is historical. Actual plug/exit measurements and the full cable/service route remain unresolved. Retain the inline diode; final donor/RCY copper cuts, overlaps and storage are TBD. G-W6 must recheck EVF voltage/drop/heating at measured current with the 28 AWG donor. | https://cdn-shop.adafruit.com/product-files/4448/C14289-001_datasheet.pdf
B. Cables and leads | D2-23 | EVF power-only inline pair: Pololu 2180 socket-contact half + 2181 pin-contact half | both | conditional matched Generic pair; no JST rating inherited | 1 | matched pair | 1 | pair (one 2180 and one 2181) | No spare pair provision; actual tail offcuts TBD |  | Pololu 2180 + 2181, Generic RCY-style; one of each | Pololu |  | Replaces unsupported PH wire-to-wire pair, not an EVF board socket. Buy ONE 2180 and ONE 2181. Both have nominal 100 mm 20 AWG silicone tails, stripped/tinned; trim only after complete routing and joint budgets are verified. Use 2180 recessed SOCKET contacts on USB source side, 2181 on the EVF board side; confirm actual mating/continuity and insulate when separated. Brand is explicitly Generic; no current/contact-resistance/OD/tolerance rating is published and JST specifications must not be borrowed. Vendor housing lengths are 13 mm and 19 mm; reserve their full sum 32 mm axially, width 7 mm and provisional thickness 7 mm until actual mated geometry is measured. This is a planning reserve, not a guaranteed vendor bound. Keep straight exit space and real disconnect access. Distinct family prevents mating to PicoBlade signal pairs; label EVF polarity. Preserve G-W6 voltage/drop, contact heating, pull retention and insulation gates. Two housings and four factory contacts are included below; no crimper. The EVF board receives two soldered pigtail joints at traced EXT+/GND pads. | https://www.pololu.com/product/2180
B. Cables and leads | D2-24 | QT lead part 1: Adafruit 4397 STEMMA QT to female sockets, 150 mm (cut so the socket end is about 93-117 mm, WIRING W-QT) | both | inherited; unqualified | 1 | retained socket-end lead section | 1 | ea |  |  | Adafruit 4397 | Adafruit / DigiKey | qt | Join to D2-24B by pin-number continuity, not colour alone; four QT splice joints. Finished QT lead 250 +/- 10 mm. Revised routing requires a new straight splice/stow location. | ../../../electronics/gs8-d2-v1/make_bom.py
B. Cables and leads | D2-24B | QT lead part 2: Pololu #5521 JST SH-style 4-pin cable, single-ended female, 30 cm, 28 AWG (SH end kept; cut so the finished lead is 250 +/- 10 mm) | both | inherited; unqualified | 1 | retained SH-end lead section | 1 | ea |  |  | Pololu 5521 | Pololu | qt | One purchased cable contributes the SH end; offcut is not another harness. Combined finished lead is 250 +/- 10 mm with D2-24. | ../../../electronics/gs8-d2-v1/make_bom.py
B. Cables and leads | D2-25 | GPIO donor jumpers: two cut female-ended stubs from Adafruit 1950 pack | both | conditional new-build donor; measured cut/fit gates open | 2 | female-ended donor stubs; installed lengths TBD | 1 | pack of 20 female/female 150 mm jumpers | 18 intact jumpers plus two removed ends and unquantified wire offcuts |  | Adafruit 1950 | Adafruit | fps_lead | Use two distinct colours for GPIO13 pin 33 and ground pin 34. Each stock jumper has 2.54 mm female contacts at both ends and 28 AWG wire (7 strands of 36 AWG). Retain one female housing/contact on each selected jumper; cut measured stubs and join to trimmed blunt-ended PicoBlade male wires using TWO solder splices and TWO insulating sleeves. Included housing/contact counts below are constituents, not additional purchases. No crimp tool. Vendor does not specify complete housing dimensions or insulation OD and warns the silver-latch side is slightly wider than 2.54 mm; verify orientation, adjacent fit, retention and the modeled envelope on receipt. Stock length is not installed length; per-core stub/copper cuts, splice overlaps and combined route budgets remain TBD until actual root/termination dimensions are measured against the selected source-bound FPS route. Replaces the unsupported generic Dupont-to-PH donor identity. | https://www.adafruit.com/product/1950
B. Cables and leads | D2-27 | FPS inline pair: Molex 2181110202 male + 2181120201 female pigtail assemblies | both | selected mated-carry route; refreshed scoped CAD pass, physical cuts/service unqualified | 1 | mated pair within one FPS harness | 1 | pair (one 225 mm male and one 150 mm female assembly) | Measured wire offcuts TBD; both factory Molex housings retained |  | Molex 2181110202 + 2181120201 (one of each) | Molex / authorized distributor |  | Supersedes unsupported generic PH wire-to-wire identity and old 200+50 mm accounting. Purchased rear-housing-exit-to-blunt-end lengths: male 225 +/- 6 mm, female 150 +/- 6 mm; two black 28 AWG UL1061 cores per half. Installed main nominal axis is 200.000 mm INCLUDING D2-25 donor stubs and splice region; female-to-A axis 95.4644 mm and female-to-throw2 axis 102.4759 mm precede unresolved solder allowances. These are study axes, not copper cuts. See FPS-SERVICE-STUDY.md for staggered splice midpoints and illustrative overlap convention. Both housings and four contacts included below. Keep pair mated while the independently supported switch and whole harness move with carrier; disconnect only on bench. No sacrificial tie or in-body connector draw-out. Actual heads, individual-core fanout, terminal geometry, root allowances and complete integrated USB/CSI/service checks remain open. Mated body 9 mm is reference only; male 8 mm and female 3.95 mm are not equal halves. Polarized friction lock has no alternate keying; J2 now uses a different mating family (V-28, default pending user decision 13), so no other in-camera half mates this pair (FP-14 junction check). Still label FPS and continuity-test both black wires. Spare pair: V-27S. System 1.5 A maximum at 28 AWG / 125 V and 30 tin-contact mating cycles are not a physical service qualification. | https://www.molex.com/content/dam/molex/molex-dot-com/products/automated/en-us/salesdrawingpdf/218/218111/2181110201_sd.pdf
B. Cables and leads | D2-26 | PRC high-flex pure-copper 16 AWG silicone wire, red and black | both | provisional length; service route blocked | 2 | conductor-path allocations; copper cuts TBD | 2 | 36 in lengths, one per colour | Offcuts not fixed; determine after measured cuts, joint overlaps and pad allowance |  | PRC 16 AWG silicone; red SW-16R; black SW-16B | ProgressiveRC | pigtail | Purchase one 914.4 mm stock length per colour: red SW-16R, black SW-16B (store product record https://www.progressiverc.com/products/prc-silicone-wire-16-awg.json, read 2026-10-11; the product page shows one SKU field with a colour selector). POSITIVE: 270 mm FINISHED-PATH allocation includes a 20 mm rigid fuse/joint-sleeve zone; actual copper cut and solder overlap must be measured/trimmed to that finished path, not 270 mm copper plus fuse. NEGATIVE: 270 mm total path budget includes unresolved pad-root allowances. BOTH budgets include those allowances; they are not extra length to add later. Neither is a proved production cut; no exact offcut claim. Electrical estimate conservatively charges BOTH as 270 mm copper: at 8.6 A cold drop 0.129789 V and copper-at-60 C drop 0.142811 V, leaving about 7.2 mV before hot fuse/contact/pad uncertainty under the unchanged 0.15 V G-W5 limit. Vendor OD 3.0 mm; reserve 3.2 mm/core, 6.4 x 3.2 mm pair. Existing pack lead stays 60 mm 18 AWG. Four carrier tie eyes are present; separate red/black cold-side slack retention is provisional. Full stored-length/bend and battery-disconnect reach checks pending; fixed ties cannot be assumed to unfold for service. Nominal resistance is not a vendor specification or hot-test pass. | https://www.progressiverc.com/products/prc-silicone-wire-16-awg
C. Fasteners | D2-30 | PT 3.0 x 12 thread-forming screw for plastics, pan head, PH1 (EJOT PT K30x12 WN 1411 / Delta PT 30x12 class) | both | inherited; unqualified | 7 | ea | 11 | ea | 4 spare |  | WN 1411 class | any | pt_screws | Four panel + two carrier + one independent grip-lock PT 3.0 x 12 PH1; seven installed, not eleven. Same body screw count as baseline. | ../../../electronics/gs8-d2-v1/make_bom.py
C. Fasteners | D2-31 | 1/4-20 UNC hex nut, steel (tripod socket) | both | inherited; unqualified | 1 | ea | 1 | ea |  |  | ISO 4032 class | any | tripod_nut | Inherited specification; baseline source line D2-31. Candidate assembly sequence supersedes baseline step numbers. | ../../../electronics/gs8-d2-v1/make_bom.py
C. Fasteners | D2-32 | Insert fallback: M3 x 5.7 brass heat-set insert (pack) | both | contingency stock | 0 | inserts | 1 | pack |  |  | CNC Kitchen M3 standard | Printed Solid (US) |  | Fallback stock only; pack quantity unspecified. Do not count a pack as an installed insert. One long collar insert is separately counted at D2-36. | ../../../electronics/gs8-d2-v1/make_bom.py
C. Fasteners | D2-33 | Insert fallback: M3 x 10 pan head A2, ISO 7045 cross recess PH1 (no hex: straight-driver rule) | both | contingency stock | 0 | ea | 7 | ea |  |  | ISO 7045 class | any |  | Seven fallback screws for stripped PT bosses, not installed in the candidate. Requalify a repaired boss before use. | ../../../electronics/gs8-d2-v1/make_bom.py
C. Fasteners | D2-35 | M3 heat-set insert, brass, short (L 4.0, OD 4.6 class), lens-collar anchors in the tub bosses | both | inherited; unqualified | 3 | ea | 5 | ea | 2 spare |  | heat-set insert class (procure; G-COL-1) | any | m3_hw | Lens-collar hardware; revised collar geometry requires renewed coupon/load checks. M1 remains open. See ASSEMBLY-VERTICAL.md. | ../../../electronics/gs8-d2-v1/make_bom.py
C. Fasteners | D2-36 | M3 heat-set insert, brass, L 5.7 (OD 4.6 class), lens-collar pinch lug | both | inherited; unqualified | 1 | ea | 1 | ea | spare may come from D2-32; not another installed insert |  | CNC Kitchen M3 standard class | any |  | Lens-collar hardware; revised collar geometry requires renewed coupon/load checks. M1 remains open. See ASSEMBLY-VERTICAL.md. | ../../../electronics/gs8-d2-v1/make_bom.py
C. Fasteners | D2-37 | M3 x 10 pan head A2, ISO 7045 cross recess PH1 (lens-collar anchors) | both | inherited; unqualified | 3 | ea | 4 | ea | 1 spare |  | ISO 7045 class | any |  | Lens-collar hardware; revised collar geometry requires renewed coupon/load checks. M1 remains open. See ASSEMBLY-VERTICAL.md. | ../../../electronics/gs8-d2-v1/make_bom.py
C. Fasteners | D2-38 | M3 x 16 pan head A2, ISO 7045 cross recess PH1 (lens-collar pinch) | both | inherited; unqualified | 1 | ea | 2 | ea | 1 spare |  | ISO 7045 class | any |  | Lens-collar hardware; revised collar geometry requires renewed coupon/load checks. M1 remains open. See ASSEMBLY-VERTICAL.md. | ../../../electronics/gs8-d2-v1/make_bom.py
C. Fasteners | D2-39 | M3 washer, ISO 7089 A2 (3.2 x 7.0 x 0.5) | both | inherited; unqualified | 4 | ea | 6 | ea | 2 spare |  | ISO 7089 class | any |  | Lens-collar hardware; revised collar geometry requires renewed coupon/load checks. M1 remains open. See ASSEMBLY-VERTICAL.md. | ../../../electronics/gs8-d2-v1/make_bom.py
C. Fasteners | D2-34 | Contingency: M2.5 x 5 pan head A2, ISO 7045 cross recess PH1 | both | optional; not adopted | 0 | ea | 0 | ea |  |  | ISO 7045 class | any |  | Conditional four M2.5 x 5 PH1 upper replacements only if included upper screws have an unsuitable drive. Lower four are already replaced by V-31; never add eight extra kit screws. | ../../../electronics/gs8-d2-v1/make_bom.py
E. Consumables | D2-40 | ASA filament 1.75 mm, satin silver (tub, panel; original-storage sleeve) | both | inherited; unqualified | 0 | spool | 1 | spool |  |  | Polymaker ASA class | MakerSupplies SG |  | Workshop spool; actual slice mass and filament consumption pending. Does not include an invented production mass. | ../../../electronics/gs8-d2-v1/make_bom.py
E. Consumables | D2-41 | ASA filament 1.75 mm, black (carrier, base/grip, cap, knobs, lens collar) | both | inherited; unqualified | 0 | spool | 1 | spool |  |  | Polymaker ASA class | MakerSupplies SG |  | No hood, Pi keeper or printed power plunger in this candidate; actual slice mass pending. Collar material still follows thermal qualification. | ../../../electronics/gs8-d2-v1/make_bom.py
E. Consumables | D2-43 | TPU 95A filament, black (eyecup) | both | inherited; unqualified | 0 | spool | 1 | spool |  |  | class | any |  | Workshop supply; amount consumed in the candidate is not yet measured. | ../../../electronics/gs8-d2-v1/make_bom.py
E. Consumables | D2-44 | Paint pen / enamel, black and white, for labels and optical witness marks | both | inherited; unqualified | 0 | ea | 2 | ea |  |  | class | any |  | Keep baseline two-pen workshop provision; no printed plunger symbol. Witness marks across adapter/BFAR and BFAR/housing remain required. | ../../../electronics/gs8-d2-v1/make_bom.py
E. Consumables | D2-45 | Closed-cell foam sheet 1.0 mm, pressure-sensitive adhesive one side (OLED pad 16 x 14; stuck to the OLED back) | both | inherited; unqualified | 0 | sheet | 1 | sheet |  |  | class | any | foam_pad | Workshop supply; amount consumed in the candidate is not yet measured. | ../../../electronics/gs8-d2-v1/make_bom.py
E. Consumables | D2-46 | Adhesive-lined heat-shrink 3:1 (pigtail, diode splice, r4 fuse splice: about 4.8 mm, 30 mm per fuse) + thin-wall 2:1 (switch lugs) | both | inherited; unqualified | 0 | set | 1 | set |  |  | class | any |  | Retain insulation for pigtail, fuse, diode and switch leads; include four QT splice sleeves, TWO FPS donor-splice sleeves and insulation for both J2 pads and both new power-switch terminal joints. Confirm diameters for 16 AWG. | ../../../electronics/gs8-d2-v1/make_bom.py
E. Consumables | D2-46R | Neutral-cure silicone RTV, small tube (pigtail strain relief at the X1203 battery pads) | both | inherited; unqualified | 0 | tube | 1 | tube |  |  | class | any |  | Workshop supply; amount consumed in the candidate is not yet measured. | ../../../electronics/gs8-d2-v1/make_bom.py
E. Consumables | D2-47 | Solder, flux, wick | both | inherited; unqualified | 0 | set | 1 | set |  |  | class | any |  | Workshop supply; amount consumed in the candidate is not yet measured. | ../../../electronics/gs8-d2-v1/make_bom.py
E. Consumables | D2-48 | Pull ribbon 10 mm (if the pack has none) + Kapton tape | both | inherited; unqualified | 0 | set | 1 | set |  |  | class | any |  | Workshop supply; amount consumed in the candidate is not yet measured. | ../../../electronics/gs8-d2-v1/make_bom.py
E. Consumables | D2-49 | Isopropyl alcohol + glue stick (bed release) | both | inherited; unqualified | 0 | set | 1 | set |  |  | class | any |  | Workshop supply; amount consumed in the candidate is not yet measured. | ../../../electronics/gs8-d2-v1/make_bom.py
E. Consumables | D2-50 | Small cable ties 2.5 mm (lead bundles) | both | inherited; unqualified | 4 | allocated slack-loop ties | 1 | pack | Pack count and remaining baseline bundle consumption to be measured |  | class | any |  | Use existing-class 2.5 mm cable ties; measured band thickness must be <=0.7 mm for the four 3 x 1 mm carrier slots. Four provisionally allocated to separate red/black cold-side pigtail loops; exact retention scheme may change. Fixed tied folds cannot unfold for service: qualify battery-disconnect reach with retention as installed. No contact or pressure on UPS PCB; retain bend radii and a straight fuse section. Exact tie/head dimensions and routing remain gated. | ../../../electronics/gs8-d2-v1/make_bom.py
F. Tools and accessories (not in the camera) | D2-60 | PH1 screwdriver, straight, shank dia <= 6.5, blade >= 40 mm (hand) | both | inherited; unqualified | 0 | ea | 1 | ea |  |  | TLS-14 class | any |  | Workshop equipment, not an installed camera part; retained from baseline scope. | ../../../electronics/gs8-d2-v1/make_bom.py
F. Tools and accessories (not in the camera) | D2-61 | 1/2 in (12.7 mm) deep socket for the CK1044 switch nut, driven on the bushing axis | both | inherited; unqualified | 0 | ea | 1 | ea |  |  | class | any |  | Straight-driver rule (review VN-46): deep socket on the nut axis, never a spanner. 12.7 mm across-flats is the inherited reservation, not a published Lorlin dimension; confirm on receipt. Socket clearance to the panel face and exposure knob belongs to the straight-driver check (FP-07). | ../../../electronics/gs8-d2-v1/make_bom.py
F. Tools and accessories (not in the camera) | D2-62 | Fine tweezers (OLED, flex, microSD) | both | inherited; unqualified | 0 | ea | 1 | ea |  |  | class | any |  | Workshop equipment, not an installed camera part; retained from baseline scope. | ../../../electronics/gs8-d2-v1/make_bom.py
F. Tools and accessories (not in the camera) | D2-63 | Temperature-controlled soldering iron | both | inherited; unqualified | 0 | ea | 1 | ea |  |  | class | any |  | Planned complete baseline-style build: 24 solder joints with spliced QT, two FPS donor splices and preterminated J2 pair; +2 only if pack lacks XT30 male. See audited count breakdown below; optional EVF regulator excluded. | ../../../electronics/gs8-d2-v1/make_bom.py
F. Tools and accessories (not in the camera) | D2-64 | Digital multimeter + thermocouple | both | inherited; unqualified | 0 | ea | 1 | ea |  |  | class | any |  | Workshop equipment, not an installed camera part; retained from baseline scope. | ../../../electronics/gs8-d2-v1/make_bom.py
F. Tools and accessories (not in the camera) | D2-65 | Adjustable bench DC supply with current limit (>= 10 A for G-W5 and G-W12, else 3 A) | both | inherited; unqualified | 0 | ea | 1 | ea |  |  | class | any |  | Workshop equipment, not an installed camera part; retained from baseline scope. | ../../../electronics/gs8-d2-v1/make_bom.py
F. Tools and accessories (not in the camera) | D2-66 | Official Raspberry Pi 27 W USB-C PSU (bring-up) | both | inherited; unqualified | 0 | ea | 1 | ea |  |  | SC1149 | MakerSupplies SG |  | Workshop equipment, not an installed camera part; retained from baseline scope. | ../../../electronics/gs8-d2-v1/make_bom.py
F. Tools and accessories (not in the camera) | D2-67 | 1S Li-ion balance charger (SkyRC B6neo class) + XT60-to-XT30 lead + USB-C PD supply | both | inherited; unqualified | 0 | set | 1 | set |  |  | SkyRC B6neo | Makerfire (US) |  | Workshop equipment, not an installed camera part; retained from baseline scope. | ../../../electronics/gs8-d2-v1/make_bom.py
F. Tools and accessories (not in the camera) | D2-68 | Wire stripper / flush cutter, heat gun | both | inherited; unqualified | 0 | set | 1 | set |  |  | class | any |  | Workshop equipment, not an installed camera part; retained from baseline scope. | ../../../electronics/gs8-d2-v1/make_bom.py
F. Tools and accessories (not in the camera) | D2-69 | Junior hacksaw + small flat file for measured 18/24 switch shaft trim | both | inherited; unqualified | 0 | set | 1 | set |  |  | class | any |  | Retain saw, file and soft-jaw vise for physical 18/24 shaft fit. Measure the new panel projection; historical absolute-Y cut position is obsolete. | ../../../electronics/gs8-d2-v1/make_bom.py
F. Tools and accessories (not in the camera) | D2-70 | ESD mat + wrist strap | both | inherited; unqualified | 0 | set | 1 | set |  |  | class | any |  | Workshop equipment, not an installed camera part; retained from baseline scope. | ../../../electronics/gs8-d2-v1/make_bom.py
F. Tools and accessories (not in the camera) | D2-71 | 2 x dia 1.5 steel pins, ISO 8734 1.5 x 16 dowel class (hood release hold-open; r2 fixer: replaces the 3 mm release blade) | both | removed | 0 | ea | 0 | ea |  |  | class | any |  | The vertical tub has no separate hood; two hood-release pins are removed from required tool scope. | ../../../electronics/gs8-d2-v1/make_bom.py
F. Tools and accessories (not in the camera) | D2-72 | Digital calipers, 0.01 mm | both | inherited; unqualified | 0 | ea | 1 | ea |  |  | class | any |  | Workshop equipment, not an installed camera part; retained from baseline scope. | ../../../electronics/gs8-d2-v1/make_bom.py
F. Tools and accessories (not in the camera) | D2-73 | Oscilloscope >= 20 MHz + inline USB-C power meter (logging) | both | inherited; unqualified | 0 | set | 1 | set |  |  | class | any |  | Workshop equipment, not an installed camera part; retained from baseline scope. | ../../../electronics/gs8-d2-v1/make_bom.py
F. Tools and accessories (not in the camera) | D2-74 | M3 heat-set tip in the tip system of the D2-63 iron (900M class for a YIHUA 928D or Hakko 936-type station, the T12 or TS100 range for those irons) + insert fallback set (pin vise or hand drill, 3.2 + 4.0 mm drills) | both | inherited; unqualified | 0 | set | 1 | set |  |  | class | any |  | Workshop equipment, not an installed camera part; retained from baseline scope. | ../../../electronics/gs8-d2-v1/make_bom.py
F. Tools and accessories (not in the camera) | D2-75 | DC electronic load >= 10 A / 30 W, constant-current mode (r3 fix-baseline) | both | inherited; unqualified | 0 | ea | 1 | ea |  |  | class | any |  | Workshop equipment, not an installed camera part; retained from baseline scope. | ../../../electronics/gs8-d2-v1/make_bom.py
F. Tools and accessories (not in the camera) | D2-76 | G-W13 (c) bench stand-ins: 100 uF electrolytic + power resistor for a 0.30 A load at 4.5 V (about 15 ohm, >= 3 W) (r3 fix-baseline) | both | optional; not adopted | 0 | set | 0 | set |  |  | class | any |  | Retain in scope for EVF option C only. Baseline listed a tool set although the regulator was quantity zero; no purchase or installed part until that option is adopted. | ../../../electronics/gs8-d2-v1/make_bom.py
F. Tools and accessories (not in the camera) | D2-77 | Adjustable torque screwdriver 0.1-0.6 N m, straight, PH1 bit: shank dia <= 6.5 over >= 40 mm, handle dia <= 30 (the DRIVER audit envelope) | both | inherited; unqualified | 0 | ea | 1 | ea |  |  | class | any |  | Retain adjustable torque PH1 driver; baseline numerical caps are provisional. Revised carrier/boss and collar coupons must validate actual torque limits. | ../../../electronics/gs8-d2-v1/make_bom.py
A. Electronics, optics, power | V-09 | Princeton USB-A portable SSD, 500 GB | compact only | candidate; unqualified | 1 | ea | 1 | ea |  |  | PHD-USSD-500G | Princeton / distributor | usb_stick | Primary compact candidate under review. Official 34 x 15 x 7 mm INCLUDING CAP, about 5 g; model reserves full 34 mm outside port X=-122 to -156 plus assumed mating plug. Remove and bag cap. Advertised maximum write/read 500/600 MB/s, operating 0-70 C; no Linux claim in vendor OS list. G-W10 >=100 MB/s warm sustained, Linux/USB compatibility, power, identity, dimensions and availability all remain gates. | https://www.princeton.co.jp/product/storage/phdussd.html
A. Electronics, optics, power | V-09S | Studied alternative: Samsung FIT Plus 256 GB | compact only | studied; not recommended or adopted | 0 | ea | 0 | ea |  |  | MUF-256AB | Samsung / distributor |  | Retained research record only. Up-to-110 MB/s advertised sequential write offers little headroom against >=100 MB/s warm sustained G-W10. Prior conservative 23.6 x 18.8 x 7.3 mm reserve is not the primary compact storage model. | https://download.semiconductor.samsung.com/resources/data-sheet/2024_Samsung_Data_sheet_UFD_FIT_Plus_v1.2_10139817901318.pdf
A. Electronics, optics, power | V-17 | Normally-open black momentary panel power switch | both | candidate; unqualified | 1 | ea | 1 | ea |  |  | Adafruit 1505 | Adafruit | power_button | Switch plus supplied fixing nut/washer, receipt check required. Signal switch across Pi 5 J2; same onboard-button semantics, not battery isolation. Full rear 29.4 mm reserve plus 5 mm button; drawing conflicts remain open. | https://www.adafruit.com/product/1505
B. Cables and leads | V-21 | Straight micro-HDMI plug adapter, EVF end | both | candidate; unqualified | 1 | ea | 1 | ea |  |  | Adafruit 3556 | Adafruit | hdmi | 26.5 x 17.3 x 4 mm; one at EVF only. Replaces earlier two-straight-head proposal. Ribbon not included. Mating, retention and tool access gated. | https://www.adafruit.com/product/3556
B. Cables and leads | V-21P | Right-angle R-bend micro-HDMI plug adapter, Pi end | both | candidate; unqualified | 1 | ea | 1 | ea |  |  | Adafruit 3557 | Adafruit | hdmi | 17.5 x 15 x 14.5 mm; one at Pi. Actual connector clocking, rigid envelope and service access gated. Together with V-21 and one selected ribbon, three purchased pieces total. | https://www.adafruit.com/product/3557
B. Cables and leads | V-22 | Rejected study: HDMI ribbon cable, intact 200 x 10 mm | compact only | rejected/fragile; not installed | 0 | ea | 0 | ea |  |  | Adafruit 3561 | Adafruit |  | Full 200 mm study had effectively zero tolerance reserve with both heads unplugged. Retained research record only; primary compact length is now 300 mm V-22O. No procurement or service-fit recommendation. | https://www.adafruit.com/product/3561
B. Cables and leads | V-22O | HDMI ribbon cable, intact 300 x 10 mm | both | conditional primary; selected scoped checks passed; physical HOLD | 1 | ea | 1 | ea |  |  | Adafruit 3562 | Adafruit | hdmi | One intact 300 mm ribbon for either compact or original-storage body, with 3557/3556 heads. Selected routing input: routing-snapshots/hdmi-corrected-ports-20261009-0623/input.json. The refreshed selected shadow-plenum report has 6 scoped passes / 0 failures, bound to the current compact-Kowa manifest; alternatives still require their own audit. Earlier over-PCB tool failures remain rejected diagnostics; CSI operational access stays on HOLD. This does not qualify complete interacting loom service. Actual availability, full-width/slack/service tolerance, bend/thickness/clocking/EMI and retention remain gates. | https://www.adafruit.com/product/3562
B. Cables and leads | V-23S | Spare EVF Generic RCY-style matched pair | both | spare (FP-14 spare policy); in the buy count, not installed | 0 | pair | 1 | pair | 1 spare pair (one 2180 + one 2181) |  | Pololu 2180 + 2181 | Pololu |  | Spare for D2-23 (parted at every EVF and module service (steps.SERVICE evf, module); no rating published). Same receipt, continuity, polarity-label and fit checks as D2-23; ordered with it (buy view sums the SKUs). | https://www.pololu.com/product/2180
B. Cables and leads | V-28 | J2 removable signal pair: keyed 2-circuit wire-to-wire set, Molex Micro-Fit 3.0 2-circuit wire-to-wire (3.0 mm pitch) (default pending user decision 13) | both | conditional; default pending user decision 13; family distinct from every other junction; placement and route unqualified | 1 | set | 1 | set | Lead offcuts after cutting to the measured J2 route; spare set V-28S |  | class: Molex Micro-Fit 3.0 2-circuit wire-to-wire set = 1 receptacle housing (socket contacts) + 1 plug housing (pin contacts) + 2 factory pre-crimped leads with female terminals + 2 with male terminals, 28-24 AWG, each lead >= 231 mm exposed; part numbers recorded at order after user decision 13 | Molex / authorized distributor (default pending user decision 13) | power_button | FP-14 (VN-63): replaces the 9ced753 Molex 2181120201 + 2181110202 PicoBlade pair, which was the same unkeyed family as the FPS junction (D2-27), so a J2 half could mate an FPS half and hold PWR_BUT to GND. Default family: Molex Micro-Fit 3.0 2-circuit wire-to-wire (3.0 mm pitch), chosen because no other mateable half in the camera uses its pitch, its housings are polarized with a positive latch, and factory pre-crimped leads need no crimp tool. The family is default pending user decision 13 (alternatives and their gates in WIRING-VERTICAL.md). Genders: receptacle housing with SOCKET (female) contacts on the Pi J2 side: the live side never shows a bare pin that could touch ground and press the button (same rule as the EVF RCY source half); plug housing with PIN (male) contacts on the 1505 switch side. Each pre-crimped lead >= 231 mm exposed: longest 9ced753 V-28 tail upper bound (Molex 2181110202, 225 + 6 mm): each half may then sit on either side and the harness_rules j2_btn halves (150 / 225 +/- 6 mm) and CABLES power_button (363-387 mm) stay conservative lower bounds of what is bought; cut to the measured J2 route. Four solder joints remain: two J2 pads and two switch terminals; no crimps or splices. Housing dimensions, mated length, latch travel, wire exits and stow are receipt and placement gates: the J2 junction was never placed (G-V-POWER, VN-73) and the larger housing is not shown to fit the old 6 x 8 x 12 mm reserve. Try-mate matrix on receipt: each J2 half must ref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 | wiring_data.py
B. Cables and leads | V-28S | Spare J2 keyed pair set (default pending user decision 13) | both | spare (FP-14 spare policy); in the buy count, not installed | 0 | set | 1 | set | 1 spare set |  | class: Molex Micro-Fit 3.0 2-circuit wire-to-wire set = 1 receptacle housing (socket contacts) + 1 plug housing (pin contacts) + 2 factory pre-crimped leads with female terminals + 2 with male terminals, 28-24 AWG, each lead >= 231 mm exposed; part numbers recorded at order after user decision 13 | Molex / authorized distributor (default pending user decision 13) | power_button | Spare for V-28 (one J2 mating cycle per panel removal (ASSEMBLY section 5.1 J2 cycles)). Same family decision and receipt checks as V-28. | wiring_data.py
B. Cables and leads | V-27S | Spare FPS PicoBlade pair: Molex 2181110202 male + 2181120201 female | both | spare (FP-14 spare policy); in the buy count, not installed | 0 | pair | 1 | pair | 1 spare pair |  | Molex 2181110202 + 2181120201 (one of each) | Molex / authorized distributor |  | Spare for D2-27 (tin contacts with a low rated mating-cycle count (BOM D2-27 note); parted on the bench at FPS service). Ordered with D2-27; the buy view sums the two SKUs. | https://www.molex.com/content/dam/molex/molex-dot-com/products/automated/en-us/salesdrawingpdf/218/218111/2181110201_sd.pdf
B. Cables and leads | V-22OS | Spare HDMI ribbon cable, intact 300 x 10 mm | both | spare (FP-14 spare policy); in the buy count, not installed | 0 | ea | 1 | ea | 1 spare ribbon |  | Adafruit 3562 | Adafruit |  | Spare for V-22O (less durable and less shielded than a moulded cable (Adafruit 3562 page; review ELE-14); FPC latch or fold fatigue after services). Heads V-21/V-21P are not consumed in service; reorder only if damaged. | https://www.adafruit.com/product/3562
C. Fasteners | V-31 | M2.5 x 8 pan-head PH1 lower stack/carrier screws | both | candidate; unqualified | 4 | ea | 5 | ea | 1 spare |  | ISO 7045 PH1 class | unselected | x1203_kit | Replace four original lower M2.5 x 5 screws. Recessed 4 mm bosses leave 3 mm below the heads; 8 - 3 - 1.6 = 3.4 mm nominal thread engagement. Actual thread depth, head profile and bottoming must be measured. Eight stack screws installed in total, never twelve. | model.py
F. Tools and accessories (not in the camera) | V-62 | Deep socket for the Adafruit 1505 power-button nut, sized to the measured across-flats | both | provisional; purchase gated on the measured 1505 nut across-flats (FP-14 gated purchase) | 0 | ea | 0 | ea |  |  | class; confirm on receipt | unselected |  | Straight-driver rule (review VN-46): the nut is run down with a deep socket on the button axis, never a spanner. Across-flats unknown until receipt: measure the nut, then reuse an existing deep socket that fits; buy the matching one only if none fits (purchase stays 0 until that measurement). Review CAD probe: a socket up to OD 28 mm clears the panel; actual reach unverified. | model.py
F. Tools and accessories (not in the camera) | V-63 | Smooth-jaw long-nose pliers, fine tips | both | baseline toolset retained | 0 | ea | 1 | ea |  |  | class; confirm on receipt | unselected |  | Explicit ASSEMBLY section 1.1 tool formerly lacking its own baseline BOM line; not a new installed part. Reuse existing workshop item. | model.py
F. Tools and accessories (not in the camera) | V-64 | Soft-jaw vise or vise with wood jaw pads | both | baseline toolset retained | 0 | ea | 1 | ea |  |  | class; confirm on receipt | unselected |  | Explicit ASSEMBLY section 1.1 tool formerly lacking its own baseline BOM line; not a new installed part. Reuse existing workshop item. | model.py
F. Tools and accessories (not in the camera) | V-65 | Flat steel rule / bar | both | baseline toolset retained | 0 | ea | 1 | ea |  |  | class; confirm on receipt | unselected |  | Explicit ASSEMBLY section 1.1 tool formerly lacking its own baseline BOM line; not a new installed part. Reuse existing workshop item. | model.py
F. Tools and accessories (not in the camera) | V-66 | Printer-paper knob shims and panel support block | both | baseline toolset retained | 0 | ea | 1 | ea |  |  | class; confirm on receipt | unselected |  | Explicit ASSEMBLY section 1.1 tool formerly lacking its own baseline BOM line; not a new installed part. Reuse existing workshop item. | model.py
F. Tools and accessories (not in the camera) | V-67 | Small inspection mirror, optional | both | baseline toolset retained | 0 | ea | 0 | ea |  |  | class; confirm on receipt | unselected |  | Explicit ASSEMBLY section 1.1 tool formerly lacking its own baseline BOM line; not a new installed part. Reuse existing workshop item. | model.py
G. Included-kit detail (do not buy or sum with parent assemblies) | I-03A | M2.5 F-F standoffs | both | included; unqualified | 4 | ea | 0 | ea |  | D2-03 | class; confirm on receipt | unselected | x1203_kit | Retain actual supplied stack length; measure it. | model.py
G. Included-kit detail (do not buy or sum with parent assemblies) | I-03B | Original upper M2.5 x 5 screws | both | included; unqualified | 4 | ea | 0 | ea |  | D2-03 | class; confirm on receipt | unselected | x1203_kit | Four installed; four other supplied lower screws are removed and bagged. | model.py
G. Included-kit detail (do not buy or sum with parent assemblies) | I-05A | C-CS adapter | both | included; unqualified | 1 | ea | 0 | ea |  | D2-05 | class; confirm on receipt | unselected | c_cs_adapter | Included optical adapter; witness marks required. | model.py
G. Included-kit detail (do not buy or sum with parent assemblies) | I-05B | Camera tripod block plus two screws | both | included; unqualified | 0 | ea | 0 | ea |  | D2-05 | class; confirm on receipt | unselected | tripod_block | Removed and bagged at supported optical bench setup; no camera-body installation. | model.py
G. Included-kit detail (do not buy or sum with parent assemblies) | I-07A | OLED emitter | both | included; unqualified | 1 | ea | 0 | ea |  | D2-07 | class; confirm on receipt | unselected | hmx039 | Constituent of one EVF kit. | model.py
G. Included-kit detail (do not buy or sum with parent assemblies) | I-07B | EVF driver board | both | included; unqualified | 1 | ea | 0 | ea |  | D2-07 | class; confirm on receipt | unselected | evf_board | Constituent of one EVF kit. | model.py
G. Included-kit detail (do not buy or sum with parent assemblies) | I-07C | Native OLED flex | both | included; unqualified | 1 | ea | 0 | ea |  | D2-07 | class; confirm on receipt | unselected | oled_flex | One included native harness; never count as another kit purchase. | model.py
G. Included-kit detail (do not buy or sum with parent assemblies) | I-02B | Supplied Active Cooler push pins | both | included; unqualified | 2 | ea | 0 | ea |  | D2-02 | class; confirm on receipt | unselected | cooler | Two actual mounting push pins; old four illustrative support feet are not four purchased fasteners. Cooler/fan internals remain within the purchased cooler assembly. | model.py
G. Included-kit detail (do not buy or sum with parent assemblies) | I-02A | Native Active Cooler fan lead | both | included; unqualified | 1 | ea | 0 | ea |  | D2-02 | class; confirm on receipt | unselected | fan | Stays with complete Pi/cooler/UPS module. | model.py
G. Included-kit detail (do not buy or sum with parent assemblies) | I-12A | Prewired run lead | both | included; unqualified | 1 | ea | 0 | ea |  | D2-12 | class; confirm on receipt | unselected | run_lead | One included harness. | model.py
G. Included-kit detail (do not buy or sum with parent assemblies) | I-13A | 60 mm pack-side 18 AWG lead | both | included; unqualified | 1 | ea | 0 | ea |  | D2-13 | class; confirm on receipt | unselected | pack_lead | Unchanged; pack-side connector below. | model.py
G. Included-kit detail (do not buy or sum with parent assemblies) | I-13B | Pack-side XT30 male | both | included; unqualified | 1 | ea | 0 | ea |  | D2-13 | class; confirm on receipt | unselected | xt30_pair | Do not also install a loose male from D2-14. | model.py
G. Included-kit detail (do not buy or sum with parent assemblies) | I-45A | Cut OLED foam pad, 16 x 14 x 1 mm | both | included; unqualified | 1 | ea | 0 | ea |  | D2-45 | class; confirm on receipt | unselected | foam_pad | Cut from the purchased sheet; rides with OLED; actual pad compression is a gate. | model.py
G. Included-kit detail (do not buy or sum with parent assemblies) | I-27A | FPS Molex 510470200 plug housing | both | included; unqualified | 1 | ea | 0 | ea |  | D2-27 | class; confirm on receipt | unselected | fps_lead | Included in male 2181110202; remains installed. | model.py
G. Included-kit detail (do not buy or sum with parent assemblies) | I-27B | FPS Molex 510210200 receptacle housing | both | included; unqualified | 1 | ea | 0 | ea |  | D2-27 | class; confirm on receipt | unselected | fps_lead | Included in female 2181120201; remains installed. | model.py
G. Included-kit detail (do not buy or sum with parent assemblies) | I-27C | FPS male factory-crimped contacts | both | included; unqualified | 2 | ea | 0 | ea |  | D2-27 | class; confirm on receipt | unselected | fps_lead | Included Molex 501338000; no additional purchase or crimp. | model.py
G. Included-kit detail (do not buy or sum with parent assemblies) | I-27D | FPS female factory-crimped contacts | both | included; unqualified | 2 | ea | 0 | ea |  | D2-27 | class; confirm on receipt | unselected | fps_lead | Included Molex 500588000; no additional purchase or crimp. | model.py
G. Included-kit detail (do not buy or sum with parent assemblies) | I-23A | EVF source-side socket-contact housing | both | included; unqualified | 1 | ea | 0 | ea |  | D2-23 | class; confirm on receipt | unselected | usb_5v | Included in Pololu 2180; protected source contacts, identity checked on receipt. | model.py
G. Included-kit detail (do not buy or sum with parent assemblies) | I-23B | EVF board-side pin-contact housing | both | included; unqualified | 1 | ea | 0 | ea |  | D2-23 | class; confirm on receipt | unselected | usb_5v | Included in Pololu 2181; not an additional purchase. | model.py
G. Included-kit detail (do not buy or sum with parent assemblies) | I-23C | EVF factory-crimped contacts | both | included; unqualified | 4 | ea | 0 | ea |  | D2-23 | class; confirm on receipt | unselected | usb_5v | Two per half; no additional crimp or solder joint. | model.py
G. Included-kit detail (do not buy or sum with parent assemblies) | I-46A | Individual USB data-core insulating sleeves | both | included; unqualified | 2 | ea | 0 | ea |  | D2-46 | class; confirm on receipt | unselected | usb_5v | Two separate installed pieces for unused white and green cores; do not join the data conductors. | model.py
G. Included-kit detail (do not buy or sum with parent assemblies) | I-46B | Conditional USB shield insulating sleeve | both | included; unqualified | 0 | ea | 0 | ea |  | D2-46 | class; confirm on receipt | unselected | usb_5v | Fit one additional piece only if a shield/drain is actually present; verify on receipt. | model.py
G. Included-kit detail (do not buy or sum with parent assemblies) | I-25A | GPIO female jumper housings retained from donor pack | both | included; unqualified | 2 | ea | 0 | ea |  | D2-25 | class; confirm on receipt | unselected | fps_lead | One installed on each measured stub; do not count both ends of each stock jumper. | model.py
G. Included-kit detail (do not buy or sum with parent assemblies) | I-25B | GPIO female preterminated contacts retained from donor pack | both | included; unqualified | 2 | ea | 0 | ea |  | D2-25 | class; confirm on receipt | unselected | fps_lead | One installed contact per retained housing; factory termination adds no new crimp or solder joint. | model.py
G. Included-kit detail (do not buy or sum with parent assemblies) | I-11A | 18/24 switch retaining nut | both | included; unqualified | 1 | ea | 0 | ea |  | D2-11 | class; confirm on receipt | unselected | switch_1824 | Planned supplied nut; inclusion, imperial thread, dimensions and tool access require receipt verification. | model.py
G. Included-kit detail (do not buy or sum with parent assemblies) | I-11B | 18/24 switch mounting washer | both | included; unqualified | 1 | ea | 0 | ea |  | D2-11 | class; confirm on receipt | unselected | switch_1824 | Planned mounting washer; inclusion, type and dimensions unverified. This is NOT the adjustable stop/tang washer. | model.py
G. Included-kit detail (do not buy or sum with parent assemblies) | I-11C | 18/24 adjustable stop/tang washer | both | included; unqualified | 1 | ea | 0 | ea |  | D2-11 | class; confirm on receipt | unselected | switch_1824 | Distinct supplied position-limiting piece per CK catalog. Set for two adjacent detents; preserve its indexed seat during panel service. Actual shape and stack remain receipt gates. | model.py
G. Included-kit detail (do not buy or sum with parent assemblies) | I-09A | Princeton SSD protective cap | both | included; unqualified | 0 | ea | 0 | ea |  | V-09 | class; confirm on receipt | unselected | usb_stick | Remove before insertion and bag; official overall envelope includes this cap but it is not installed in camera. | model.py
G. Included-kit detail (do not buy or sum with parent assemblies) | I-17A | Power-switch retaining nut | both | included; unqualified | 1 | ea | 0 | ea |  | V-17 | class; confirm on receipt | unselected | power_nut_reserve | Receipt inclusion/geometry gate. Model OD 22 x 3 mm is an unverified reserve, not a vendor dimension. Nut bearing plane follows panel inner Y=25.2 mm. | model.py
G. Included-kit detail (do not buy or sum with parent assemblies) | I-17B | Power-switch supplied washer | both | included; unqualified | 1 | ea | 0 | ea |  | V-17 | class; confirm on receipt | unselected | power_button | Receipt inclusion/thickness gate; no separately qualified washer solid. | model.py
G. Included-kit detail (do not buy or sum with parent assemblies) | I-28A | J2 two-circuit plug housing (pin contacts, switch side) | both | included; unqualified | 1 | ea | 0 | ea |  | V-28 | class; confirm on receipt | unselected | power_button | Included in the V-28 set (default pending user decision 13); not another purchase. | model.py
G. Included-kit detail (do not buy or sum with parent assemblies) | I-28B | J2 two-circuit receptacle housing (socket contacts, Pi side) | both | included; unqualified | 1 | ea | 0 | ea |  | V-28 | class; confirm on receipt | unselected | power_button | Included in the V-28 set (default pending user decision 13); not another purchase. | model.py
G. Included-kit detail (do not buy or sum with parent assemblies) | I-28C | J2 male-terminal pre-crimped leads | both | included; unqualified | 2 | ea | 0 | ea |  | V-28 | class; confirm on receipt | unselected | power_button | Factory-crimped, included in the V-28 set; no crimp tool or solder splice. | model.py
G. Included-kit detail (do not buy or sum with parent assemblies) | I-28D | J2 female-terminal pre-crimped leads | both | included; unqualified | 2 | ea | 0 | ea |  | V-28 | class; confirm on receipt | unselected | power_button | Factory-crimped, included in the V-28 set; no crimp tool or solder splice. | model.py
D. Printed production parts | P-tub | tub | both | candidate; unqualified | 1 | part | 0 | part |  |  | ASA, satin silver | print after qualification | tub | Concealed-vent revision: tub incorporates the source-defined ventilation geometry; panel is plain 2.8 mm after removal of four blind grooves. T2 (VN-53): printed as two pieces, the body (stl/tub.stl, -Y face down, tenon pocket open) and the +Y tab-catch stub (stl/tab_catch_insert.stl, bed face down, catch face vertical), bonded with V-68 at B1 print_inserts (default pending user decision 16); the stub is part of this production part, not another installed part. Slice orientation, supports, filament and measured print mass remain pending. Nine compact production parts retained; this is a production-part count, not a purchase quantity. | model.py
D. Printed production parts | P-panel | panel | both | candidate; unqualified | 1 | part | 0 | part |  |  | ASA, satin silver | print after qualification | panel | Concealed-vent revision: tub incorporates the source-defined ventilation geometry; panel is plain 2.8 mm after removal of four blind grooves. Slice orientation, supports, filament and measured print mass remain pending. Nine compact production parts retained; this is a production-part count, not a purchase quantity. | model.py
D. Printed production parts | P-carrier | carrier | both | candidate; unqualified | 1 | part | 0 | part |  |  | ASA, black | print after qualification | carrier | Slice orientation, supports, filament and measured print mass remain pending. Nine compact production parts retained; this is a production-part count, not a purchase quantity. | model.py
D. Printed production parts | P-base_grip | base_grip | both | candidate; unqualified | 1 | part | 0 | part |  |  | ASA, black | print after qualification | base_grip | Slice orientation, supports, filament and measured print mass remain pending. Nine compact production parts retained; this is a production-part count, not a purchase quantity. | model.py
D. Printed production parts | P-cap | cap | both | candidate; unqualified | 1 | part | 0 | part |  |  | ASA, black | print after qualification | cap | Slice orientation, supports, filament and measured print mass remain pending. Nine compact production parts retained; this is a production-part count, not a purchase quantity. | model.py
D. Printed production parts | P-eyecup | eyecup | both | candidate; unqualified | 1 | part | 0 | part |  |  | TPU 95A, black | print after qualification | eyecup | Slice orientation, supports, filament and measured print mass remain pending. Nine compact production parts retained; this is a production-part count, not a purchase quantity. | model.py
D. Printed production parts | P-knob_exp | knob_exp | both | candidate; unqualified | 1 | part | 0 | part |  |  | ASA, black | print after qualification | knob_exp | Slice orientation, supports, filament and measured print mass remain pending. Nine compact production parts retained; this is a production-part count, not a purchase quantity. | model.py
D. Printed production parts | P-knob_fps | knob_fps | both | candidate; unqualified | 1 | part | 0 | part |  |  | ASA, black | print after qualification | knob_fps | Slice orientation, supports, filament and measured print mass remain pending. Nine compact production parts retained; this is a production-part count, not a purchase quantity. | model.py
D. Printed production parts | P-lens_collar | lens_collar | both | candidate; unqualified | 1 | part | 0 | part |  |  | ASA, black; thermal qualification pending | print after qualification | lens_collar | Slice orientation, supports, filament and measured print mass remain pending. Nine compact production parts retained; this is a production-part count, not a purchase quantity. | model.py
D. Printed production parts | P-stick_sleeve | stick_sleeve | original only | candidate; unqualified | 1 | part | 0 | part |  |  | ASA, satin silver | print after qualification | stick_sleeve | Slice orientation, supports, filament and measured print mass remain pending. Nine compact production parts retained; this is a production-part count, not a purchase quantity. | model.py
E. Consumables | V-68 | Two-part epoxy adhesive, small pack (bond the +Y tab-catch stub into the tub, B1 print_inserts) | both | candidate; unqualified | 0 | pack | 1 | pack |  |  | class; structural two-part epoxy, confirm on receipt | any | tab_catch_insert | T2 (VN-53, FP-11b): default pending user decision 16 (bonded stub; alternatives: press fit with a printed detent, or a panel-held block, which needs the panel on at lens_in). Adhesive type, cure, gap fill (0.1 to 0.2 mm pocket clearance) and the bond and tenon strength under the r7 roll_catch design torque are a G-V-PRINT tine coupon gate; amount consumed not measured. | model.py
F. Tools and accessories (not in the camera) | T-gauge | Printed collar centring gauge for selected lens | both | candidate; unqualified | 0 | tool | 0 | tool |  |  | class; confirm on receipt | print after qualification |  | Retained baseline tool; separate from the nine/ten installed printed production parts. Inspect candidate gauge export for selected lens. | model.py
