AubergineShallow/digital8mm-vertical-nizo/cad/gs8-d2-v1/candidate-vertical/history/reviewed-export18/panel.step

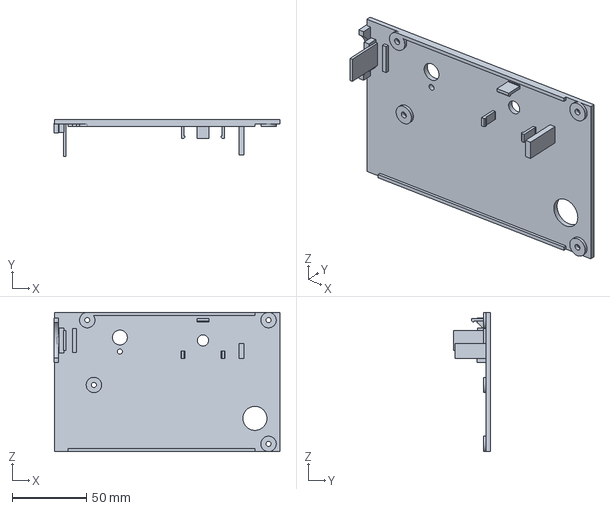
[picture p11: CAD file, 2026-10-09]
cad/gs8-d2-v1/candidate-vertical/history/reviewed-export18/panel.step
152.3 x 24.8 x 93.8 mm
