AubergineShallow/digital8mm-vertical-nizo/cad/gs8-d2-v1/candidate-vertical/out/compact-fujinon_hf6xa/step/knob_exp.step

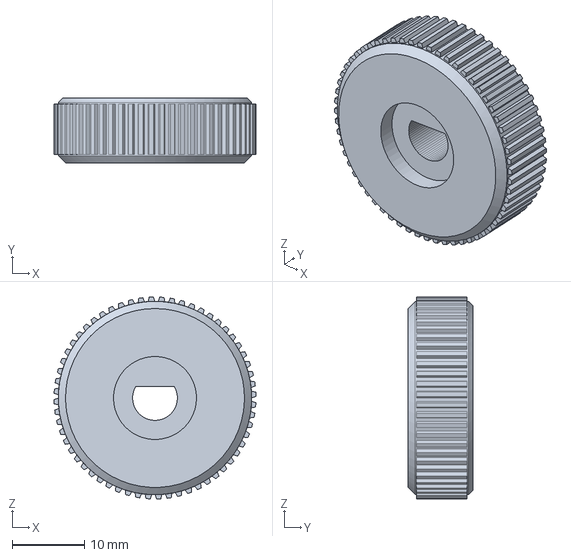
[picture p12: CAD file, 2026-10-09]
cad/gs8-d2-v1/candidate-vertical/out/compact-fujinon_hf6xa/step/knob_exp.step
28.0 x 9.00 x 28.0 mm
