AubergineShallow/digital8mm-vertical-nizo/cad/gs8-d2-v1/candidate-vertical/out/compact-kowa_lm6hc/step/run_button.step

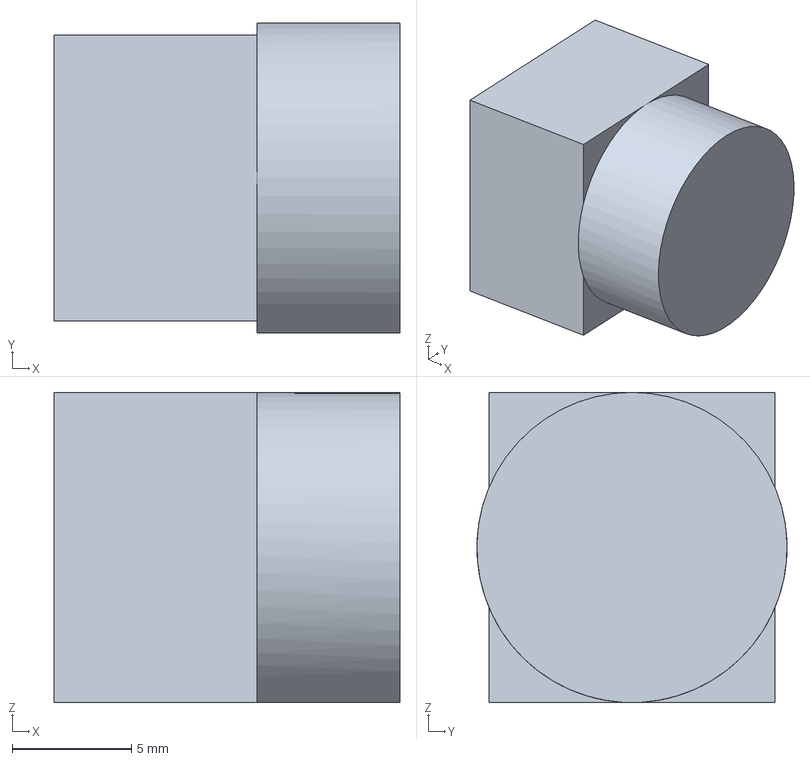
[picture p13: CAD file, 2026-10-09]
cad/gs8-d2-v1/candidate-vertical/out/compact-kowa_lm6hc/step/run_button.step
14.5 x 13.0 x 13.0 mm
