AubergineShallow/digital8mm-vertical-nizo/cad/gs8-d2-v1/candidate-vertical/out/original-kowa_lm6hc/step/x1203_kit.step

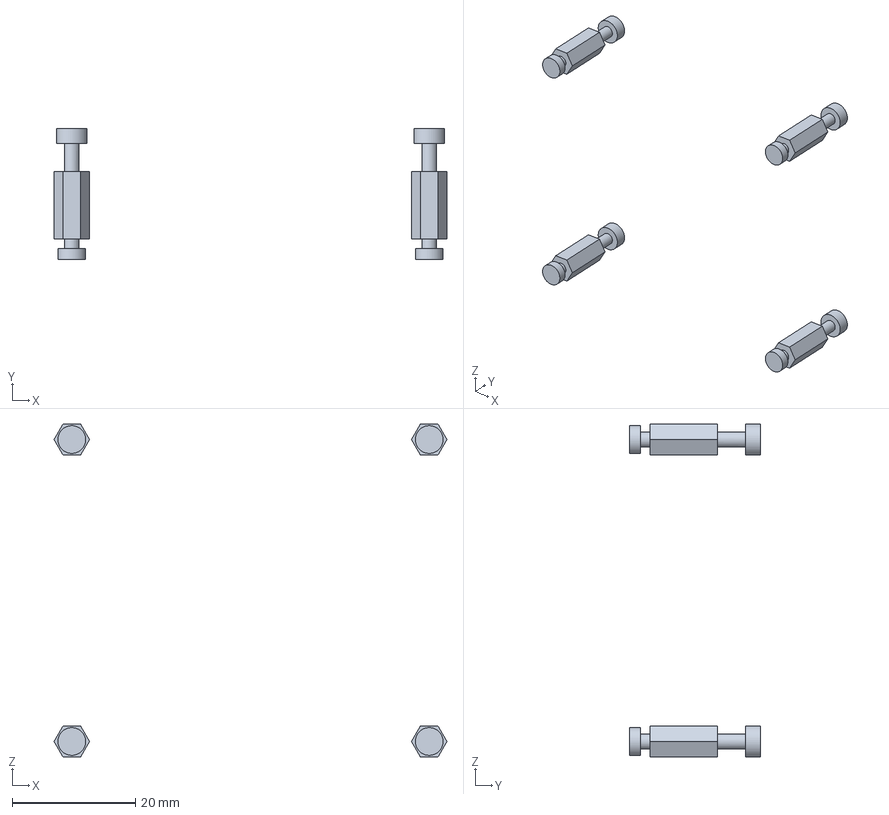
[picture p14: CAD file, 2026-10-09]
cad/gs8-d2-v1/candidate-vertical/out/original-kowa_lm6hc/step/x1203_kit.step
63.8 x 21.2 x 54.0 mm
