AubergineShallow/digital8mm-vertical-nizo/cad/gs8-d2-v1/candidate-vertical/routing-snapshots/hdmi-ck1044-clear-20261009-0524/official-fpc-sources/usb2-native.step

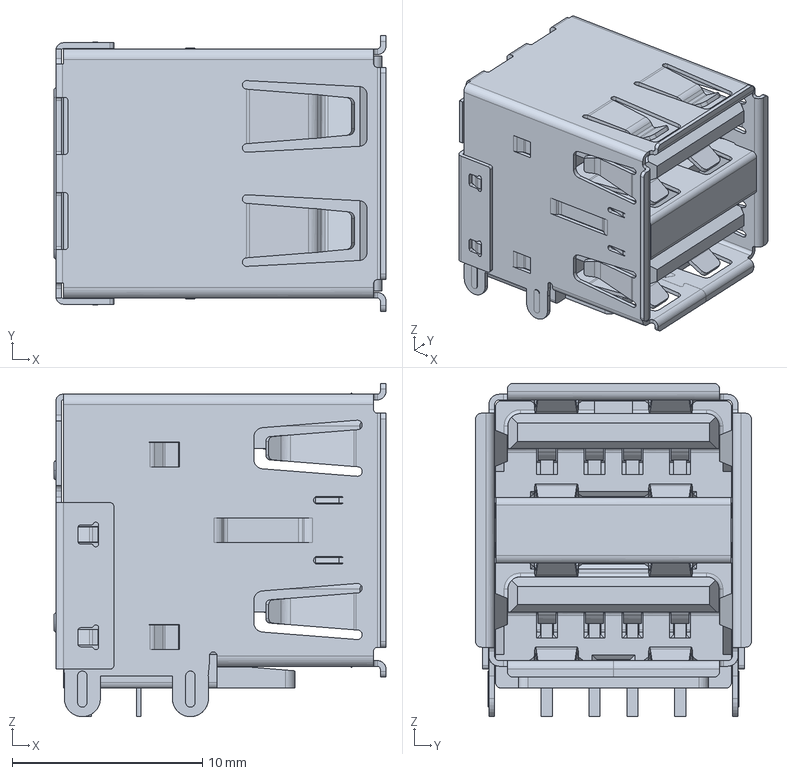
[picture p15: CAD file, 2026-10-09]
cad/gs8-d2-v1/candidate-vertical/routing-snapshots/hdmi-ck1044-clear-20261009-0524/official-fpc-sources/usb2-native.step
17.5 x 14.5 x 17.5 mm
