AubergineShallow/digital8mm-vertical-nizo/cad/gs8-d2-v1/candidate-vertical/structural-review/coupons/C03_heel_original.step

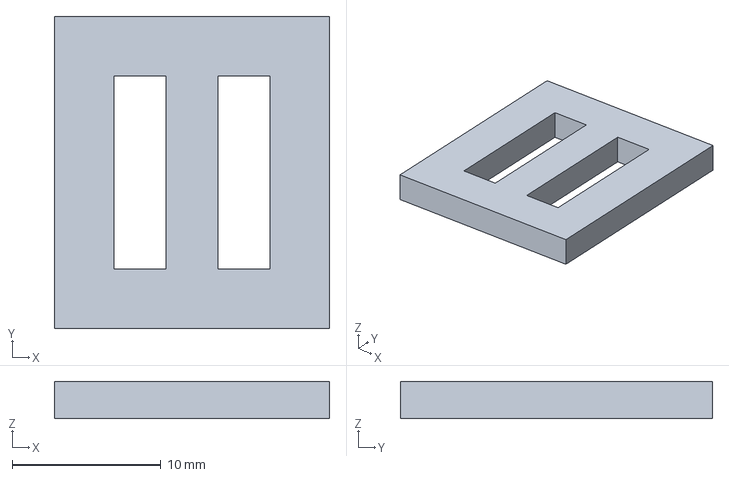
[picture p16: CAD file, 2026-10-09]
cad/gs8-d2-v1/candidate-vertical/structural-review/coupons/C03_heel_original.step
18.5 x 21.0 x 2.50 mm
