AubergineShallow/digital8mm-vertical-nizo/cad/gs8-d2-v1/candidate-vertical/structural-review/input-baseline/step/base_grip.step

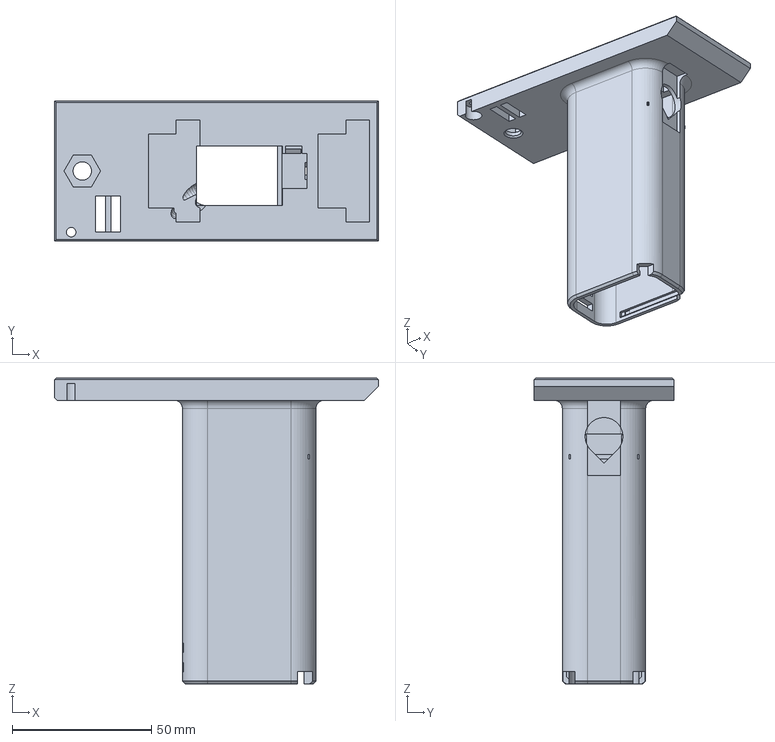
[picture p17: CAD file, 2026-10-09]
cad/gs8-d2-v1/candidate-vertical/structural-review/input-baseline/step/base_grip.step
116.5 x 50.4 x 110.0 mm
