AubergineShallow/digital8mm-vertical-nizo/cad/gs8-d2-v1/candidate-vertical/structural-review/j4-trial/tub.step

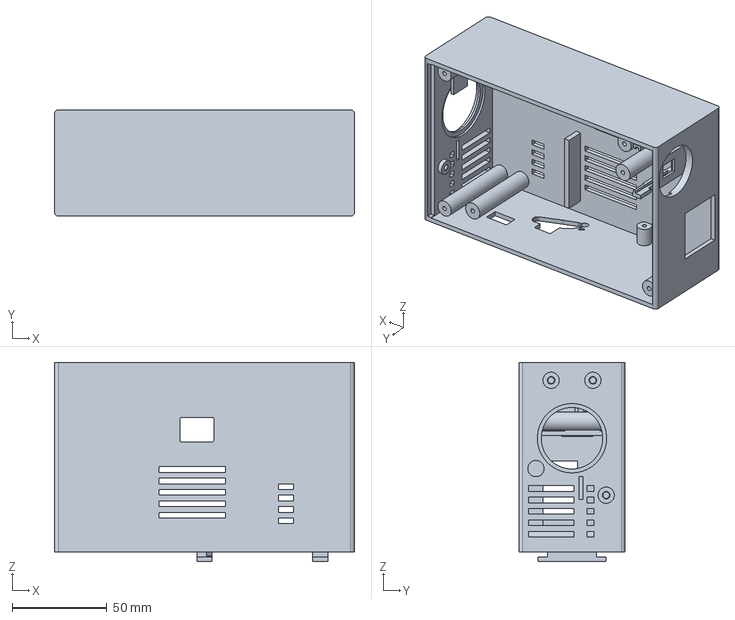
[picture p18: CAD file, 2026-10-09]
cad/gs8-d2-v1/candidate-vertical/structural-review/j4-trial/tub.step
158.0 x 56.0 x 105.0 mm
