AubergineShallow/digital8mm-vertical-nizo/cad/gs8-d2-v1/candidate-vertical/vent-study/angled-channel-trial/panel.step

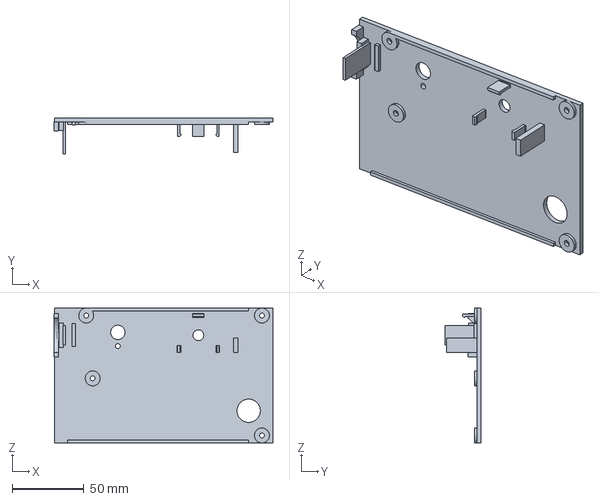
[picture p19: CAD file, 2026-10-09]
cad/gs8-d2-v1/candidate-vertical/vent-study/angled-channel-trial/panel.step
152.3 x 24.8 x 93.8 mm
