AubergineShallow/digital8mm-vertical-nizo/cad/gs8-d2-v1/candidate-vertical/vent-study/shadow-plenum-coupon/plenum-port-service-open-edge-coupon.step

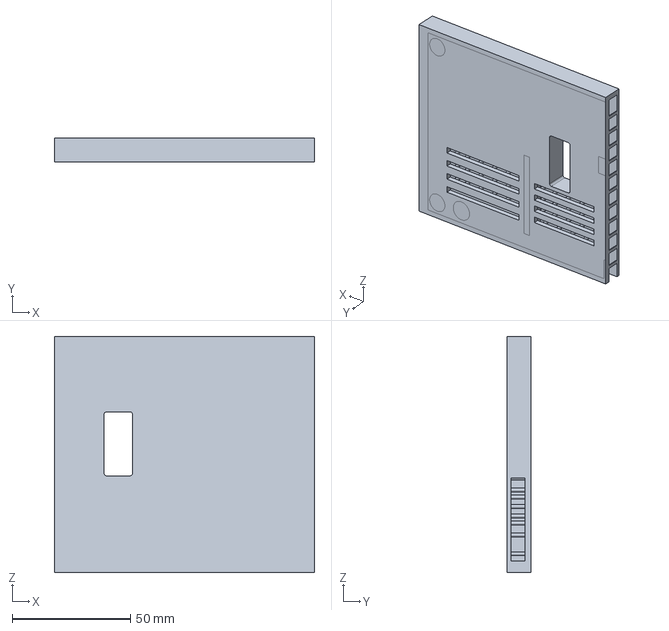
[picture p20: CAD file, 2026-10-09]
cad/gs8-d2-v1/candidate-vertical/vent-study/shadow-plenum-coupon/plenum-port-service-open-edge-coupon.step
110.0 x 10.1 x 100.0 mm
