AubergineShallow/digital8mm-vertical-nizo/cad/gs8-d2-v1/candidate-vertical/history/reviewed-export18/tub.step

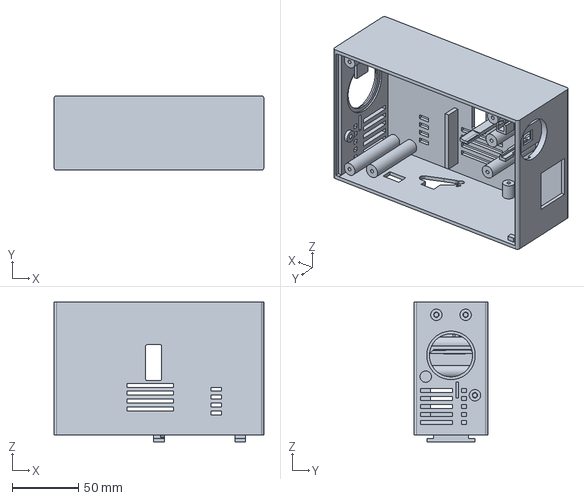
[picture p21: CAD file, 2026-10-09]
cad/gs8-d2-v1/candidate-vertical/history/reviewed-export18/tub.step
158.0 x 56.0 x 105.0 mm
