AubergineShallow/digital8mm-vertical-nizo/cad/gs8-d2-v1/candidate-vertical/out/compact-kowa_lm6hc/step/hmx039.step

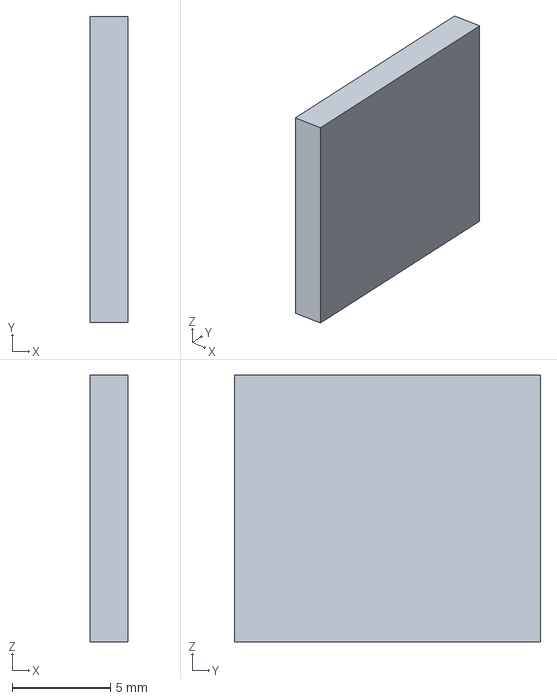
[picture p22: CAD file, 2026-10-09]
cad/gs8-d2-v1/candidate-vertical/out/compact-kowa_lm6hc/step/hmx039.step
1.93 x 15.6 x 13.6 mm
