AubergineShallow/digital8mm-vertical-nizo/cad/gs8-d2-v1/candidate-vertical/out/original-kowa_lm6hc/step/tub.step

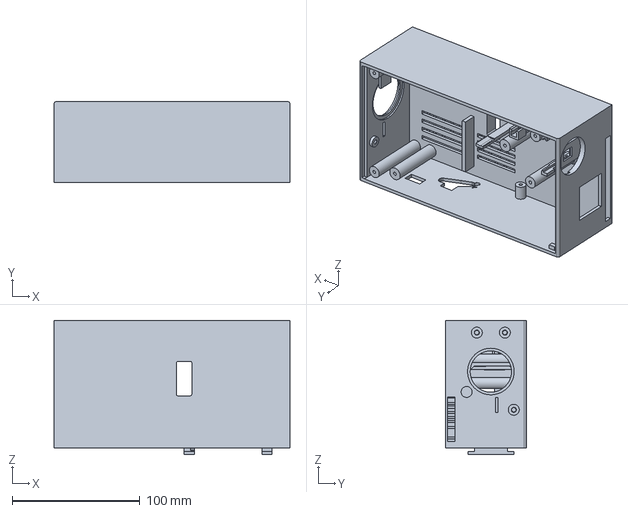
[picture p23: CAD file, 2026-10-09]
cad/gs8-d2-v1/candidate-vertical/out/original-kowa_lm6hc/step/tub.step
185.0 x 63.6 x 105.0 mm
