AubergineShallow/digital8mm-vertical-nizo/cad/gs8-d2-v1/candidate-vertical/routing-snapshots/hdmi-ck1044-clear-20261009-0524/official-fpc-sources/ethernet-native.step

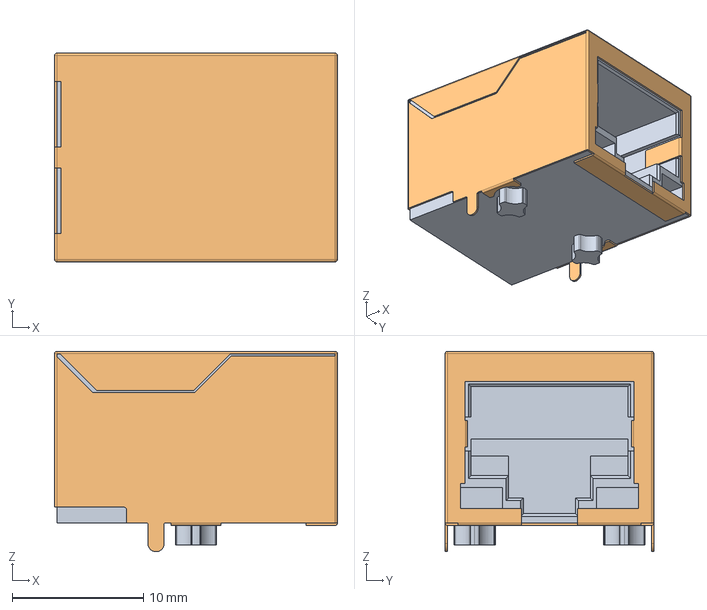
[picture p24: CAD file, 2026-10-09]
cad/gs8-d2-v1/candidate-vertical/routing-snapshots/hdmi-ck1044-clear-20261009-0524/official-fpc-sources/ethernet-native.step
21.6 x 15.9 x 15.3 mm
