AubergineShallow/digital8mm-vertical-nizo/cad/gs8-d2-v1/candidate-vertical/structural-review/coupons/C06_upper_widened.step

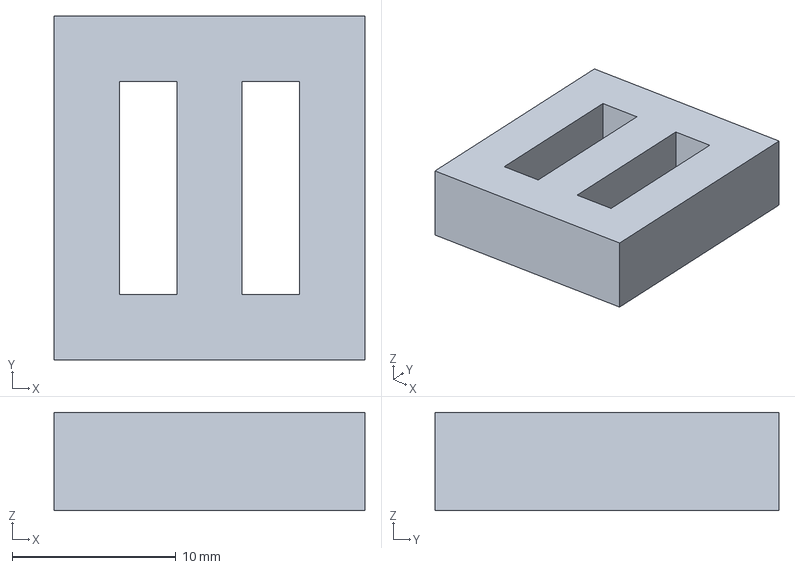
[picture p25: CAD file, 2026-10-09]
cad/gs8-d2-v1/candidate-vertical/structural-review/coupons/C06_upper_widened.step
19.0 x 21.0 x 6.00 mm
