AubergineShallow/digital8mm-vertical-nizo/cad/gs8-d2-v1/candidate-vertical/structural-review/input-baseline/step/tub.step

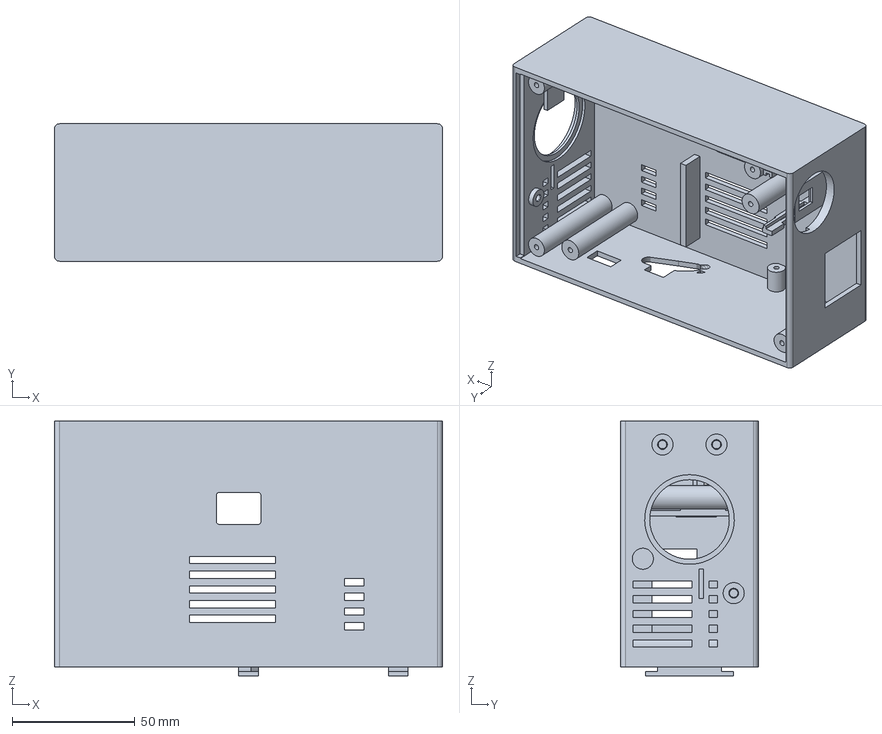
[picture p26: CAD file, 2026-10-09]
cad/gs8-d2-v1/candidate-vertical/structural-review/input-baseline/step/tub.step
158.0 x 56.0 x 103.7 mm
