AubergineShallow/digital8mm-vertical-nizo/cad/gs8-d2-v1/candidate-vertical/structural-review/j4-trial/grip.step

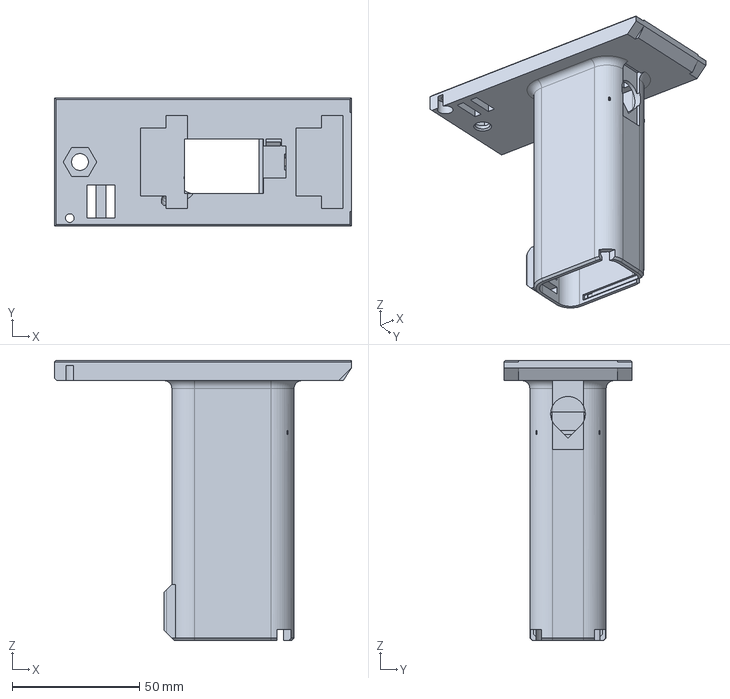
[picture p27: CAD file, 2026-10-09]
cad/gs8-d2-v1/candidate-vertical/structural-review/j4-trial/grip.step
116.5 x 50.4 x 110.0 mm
