AubergineShallow/digital8mm-vertical-nizo/cad/gs8-d2-v1/candidate-vertical/vent-study/angled-channel-trial/tub.step

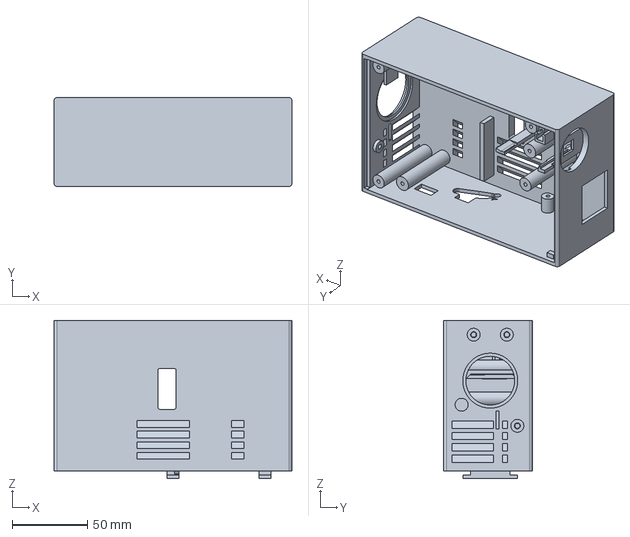
[picture p28: CAD file, 2026-10-09]
cad/gs8-d2-v1/candidate-vertical/vent-study/angled-channel-trial/tub.step
158.0 x 59.0 x 105.0 mm
