AubergineShallow/digital8mm-vertical-nizo/cad/gs8-d2-v1/candidate-vertical/vent-study/shadow-plenum-coupon/plenum-bridge-open-edge-coupon.step

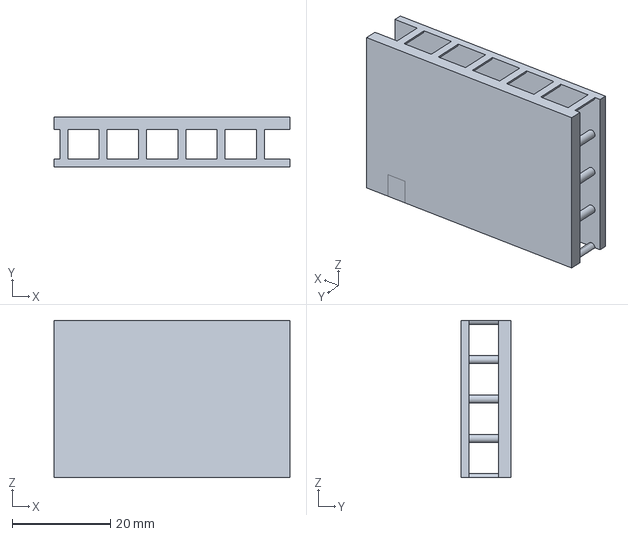
[picture p29: CAD file, 2026-10-09]
cad/gs8-d2-v1/candidate-vertical/vent-study/shadow-plenum-coupon/plenum-bridge-open-edge-coupon.step
48.0 x 10.1 x 32.0 mm
