AubergineShallow/digital8mm-vertical-nizo/cad/gs8-d2-v1/candidate-vertical/out/compact-fujinon_hf6xa/step/p_panel2.step

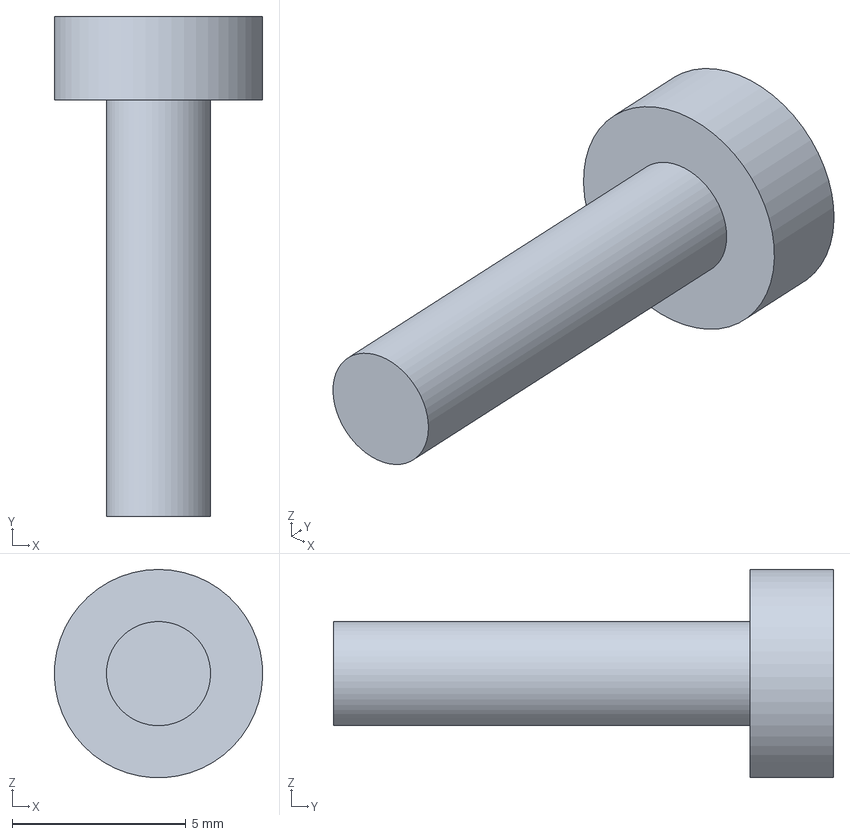
[picture p30: CAD file, 2026-10-09]
cad/gs8-d2-v1/candidate-vertical/out/compact-fujinon_hf6xa/step/p_panel2.step
6.00 x 14.4 x 5.99 mm
