AubergineShallow/digital8mm-vertical-nizo/cad/gs8-d2-v1/candidate-vertical/out/original-kowa_lm6hc/step/gs_camera.step

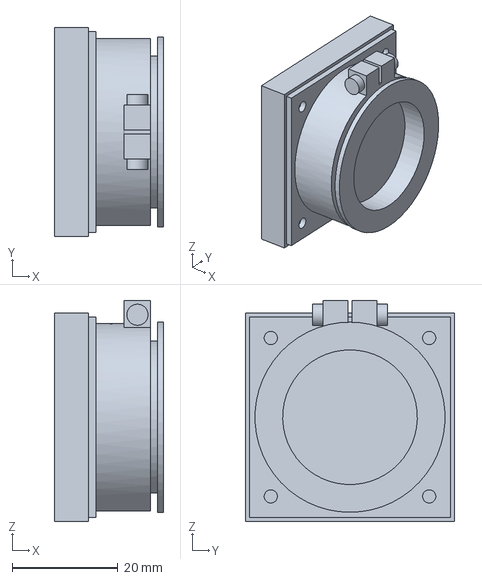
[picture p32: CAD file, 2026-10-09]
cad/gs8-d2-v1/candidate-vertical/out/original-kowa_lm6hc/step/gs_camera.step
20.7 x 39.5 x 41.8 mm
