AubergineShallow/digital8mm-vertical-nizo/cad/gs8-d2-v1/candidate-vertical/routing-snapshots/hdmi-ck1044-clear-20261009-0524/official-fpc-sources/cam_disp1-native.step

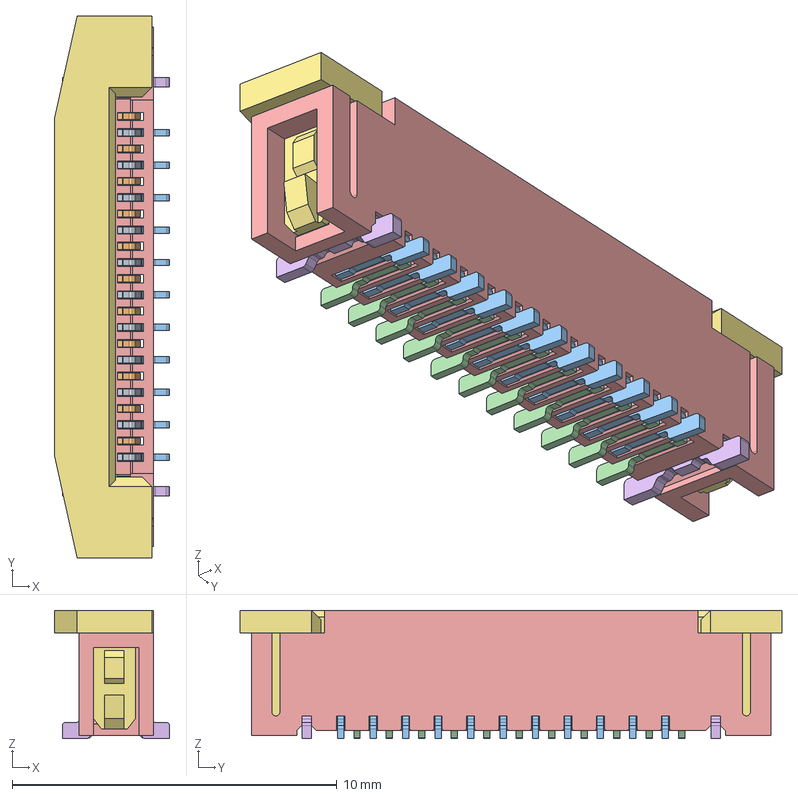
[picture p33: CAD file, 2026-10-09]
cad/gs8-d2-v1/candidate-vertical/routing-snapshots/hdmi-ck1044-clear-20261009-0524/official-fpc-sources/cam_disp1-native.step
3.55 x 16.7 x 3.95 mm
