AubergineShallow/digital8mm-vertical-nizo/cad/gs8-d2-v1/candidate-vertical/structural-review/coupons/C08_J4_base.step

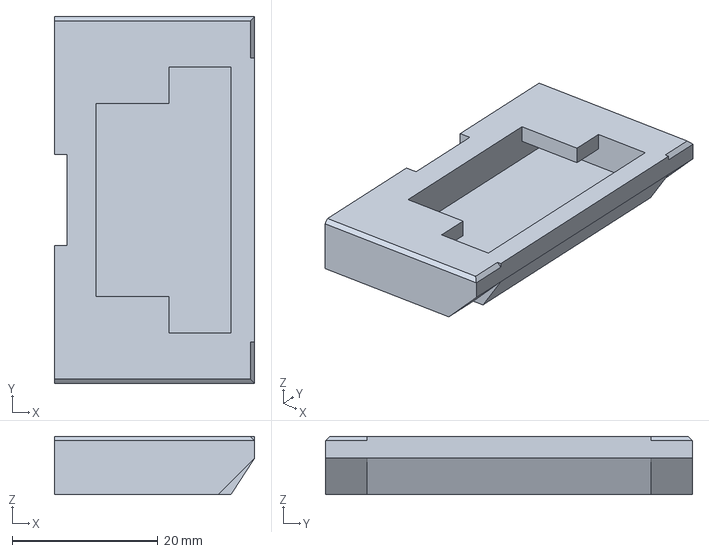
[picture p34: CAD file, 2026-10-09]
cad/gs8-d2-v1/candidate-vertical/structural-review/coupons/C08_J4_base.step
27.5 x 50.4 x 8.00 mm
