AubergineShallow/digital8mm-vertical-nizo/cad/gs8-d2-v1/candidate-vertical/out/compact-fujinon_hf6xa/step/evf_board.step

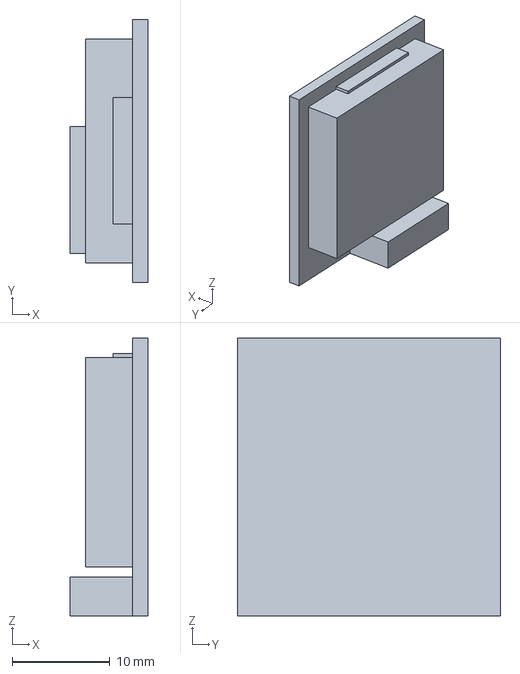
[picture p35: CAD file, 2026-10-09]
cad/gs8-d2-v1/candidate-vertical/out/compact-fujinon_hf6xa/step/evf_board.step
8.00 x 27.0 x 28.5 mm
