AubergineShallow/digital8mm-vertical-nizo/cad/gs8-d2-v1/candidate-vertical/out/compact-kowa_lm6hc/step/carrier.step

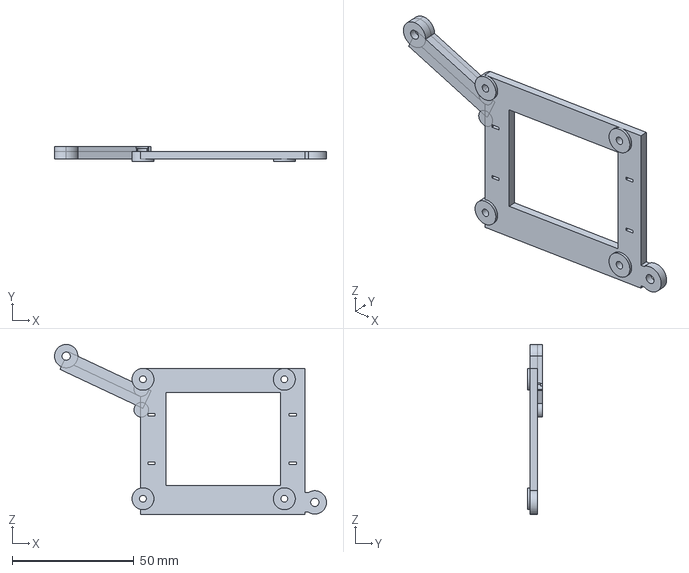
[picture p36: CAD file, 2026-10-09]
cad/gs8-d2-v1/candidate-vertical/out/compact-kowa_lm6hc/step/carrier.step
111.6 x 6.00 x 69.8 mm
