AubergineShallow/digital8mm-vertical-nizo/cad/gs8-d2-v1/candidate-vertical/out/original-kowa_lm6hc/step/knob_fps.step

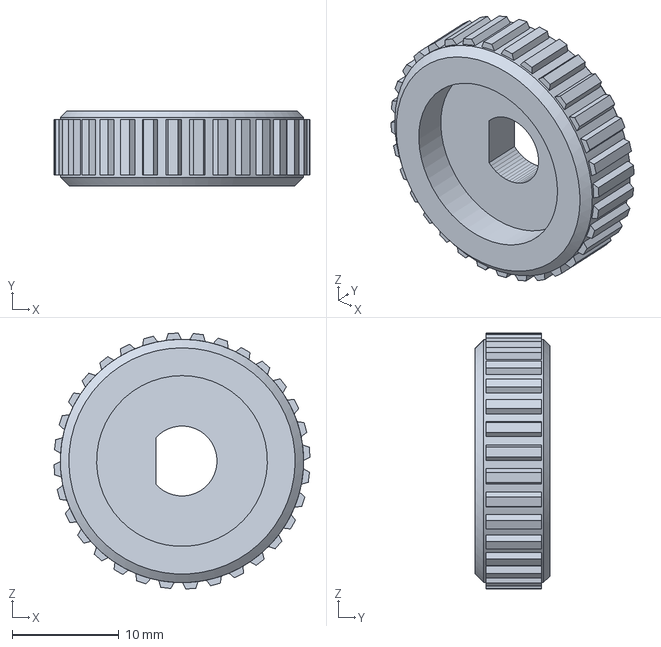
[picture p37: CAD file, 2026-10-09]
cad/gs8-d2-v1/candidate-vertical/out/original-kowa_lm6hc/step/knob_fps.step
24.0 x 7.00 x 24.0 mm
