AubergineShallow/digital8mm-vertical-nizo/cad/gs8-d2-v1/candidate-vertical/structural-review/coupons/C07_M2_5_seat.step

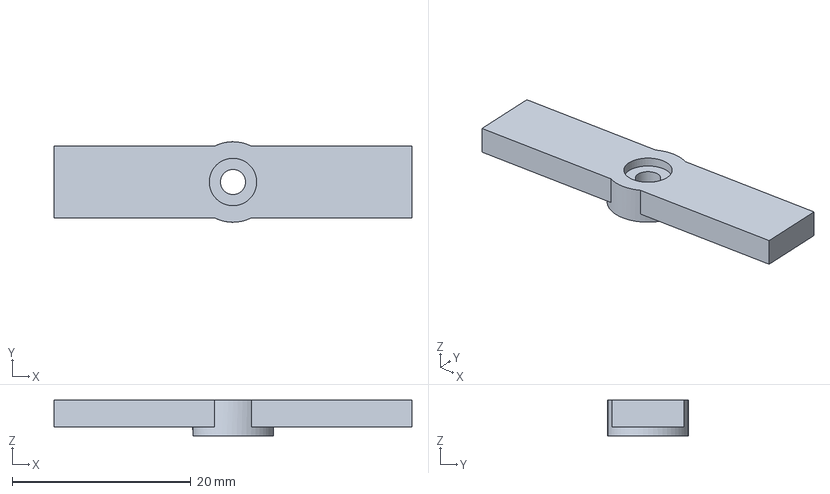
[picture p38: CAD file, 2026-10-09]
cad/gs8-d2-v1/candidate-vertical/structural-review/coupons/C07_M2_5_seat.step
40.0 x 9.00 x 4.00 mm
