AubergineShallow/digital8mm-vertical-nizo/cad/gs8-d2-v1/candidate-vertical/out/compact-fujinon_hf6xa/step/switch_1824.step

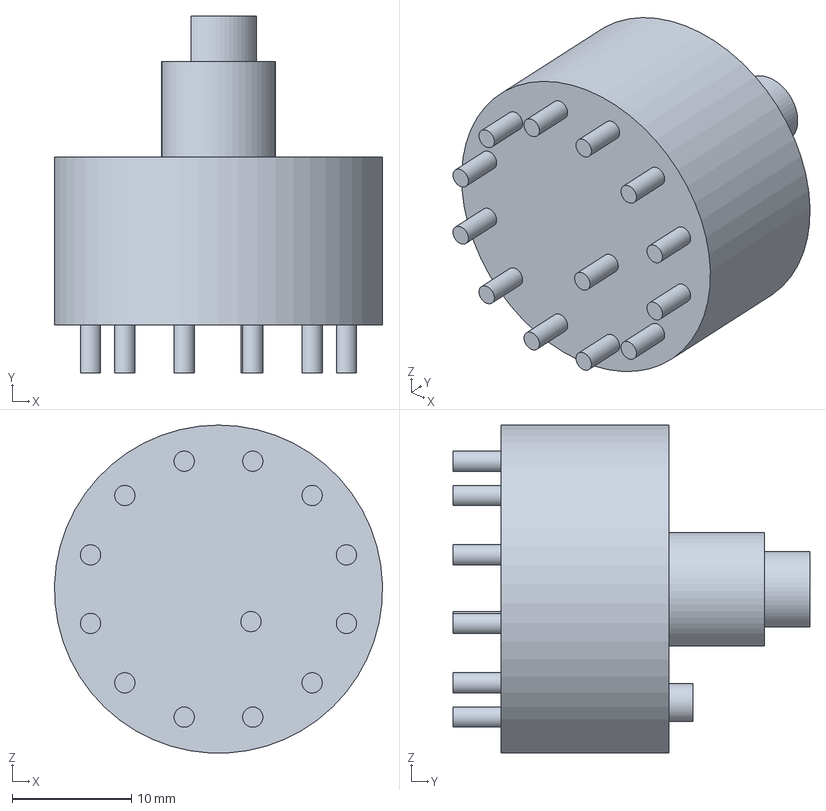
[picture p39: CAD file, 2026-10-09]
cad/gs8-d2-v1/candidate-vertical/out/compact-fujinon_hf6xa/step/switch_1824.step
27.5 x 29.9 x 27.5 mm
