AubergineShallow/digital8mm-vertical-nizo/cad/gs8-d2-v1/candidate-vertical/out/compact-kowa_lm6hc/step/centring_gauge.step

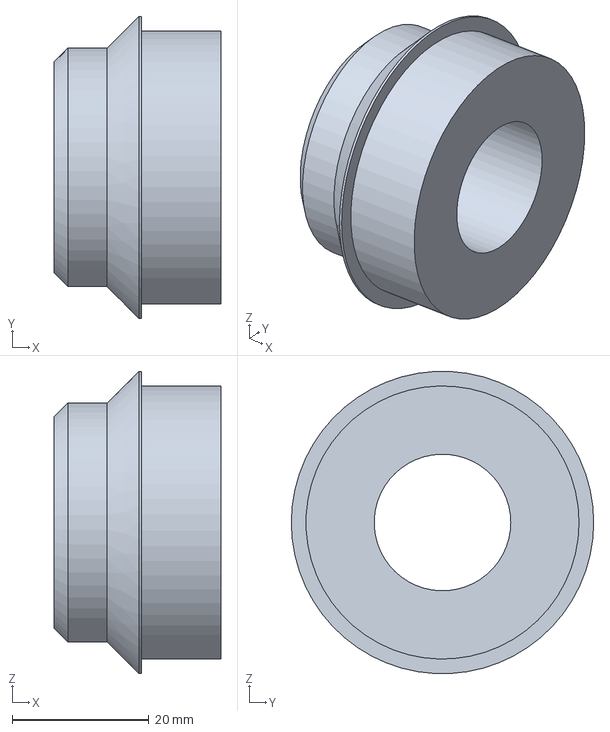
[picture p40: CAD file, 2026-10-09]
cad/gs8-d2-v1/candidate-vertical/out/compact-kowa_lm6hc/step/centring_gauge.step
24.4 x 44.3 x 44.2 mm
