AubergineShallow/digital8mm-vertical-nizo/cad/gs8-d2-v1/candidate-vertical/out/original-kowa_lm6hc/step/s_c1.step

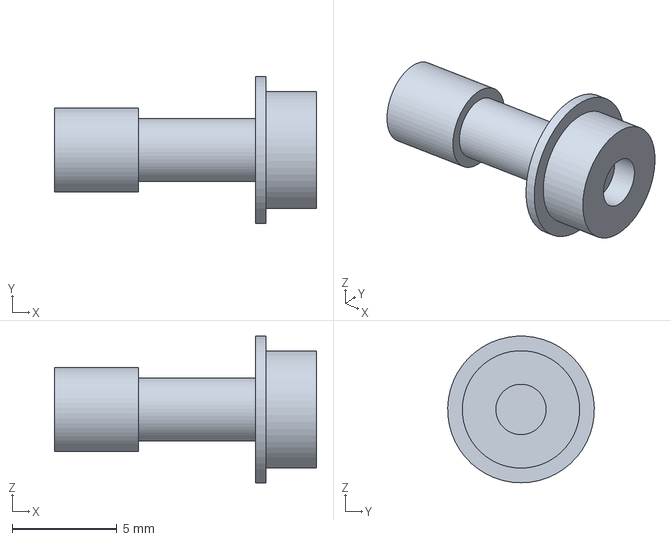
[picture p41: CAD file, 2026-10-09]
cad/gs8-d2-v1/candidate-vertical/out/original-kowa_lm6hc/step/s_c1.step
12.5 x 7.00 x 6.99 mm
