AubergineShallow/digital8mm-vertical-nizo/cad/gs8-d2-v1/candidate-vertical/structural-review/coupons/C04_heel_reinforced.step

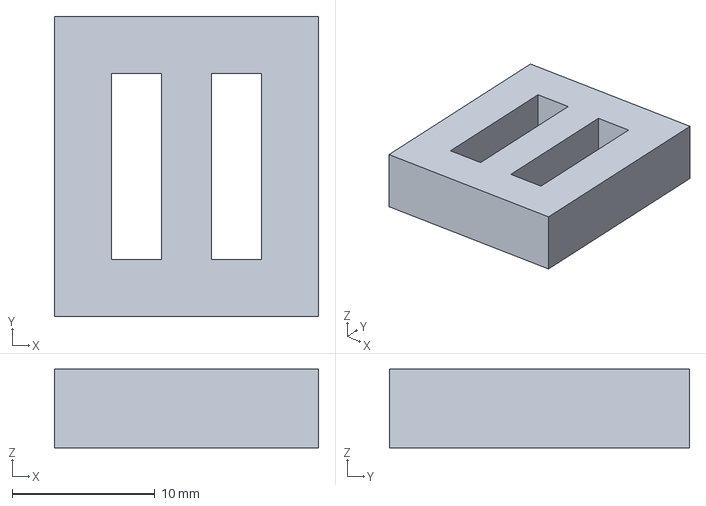
[picture p43: CAD file, 2026-10-09]
cad/gs8-d2-v1/candidate-vertical/structural-review/coupons/C04_heel_reinforced.step
18.5 x 21.0 x 5.50 mm
