AubergineShallow/digital8mm-vertical-nizo/cad/gs8-d2-v1/candidate-vertical/structural-review/coupons/C05_upper_original.step

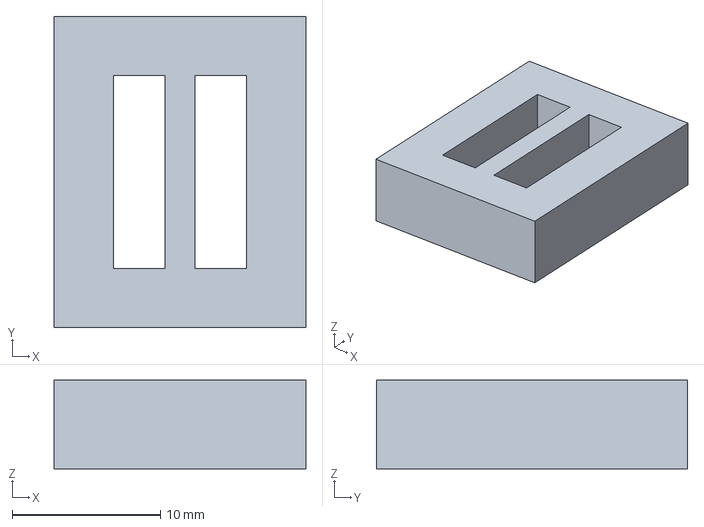
[picture p46: CAD file, 2026-10-09]
cad/gs8-d2-v1/candidate-vertical/structural-review/coupons/C05_upper_original.step
17.0 x 21.0 x 6.00 mm
