AubergineShallow/digital8mm-vertical-nizo/cad/gs8-d2-v1/candidate-vertical/structural-review/coupons/C01_carrier_original.step

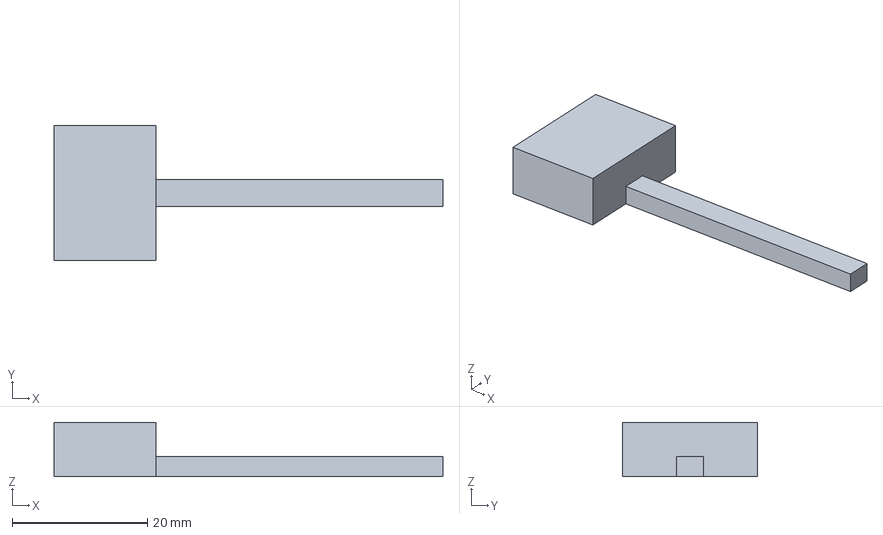
[picture p48: CAD file, 2026-10-09]
cad/gs8-d2-v1/candidate-vertical/structural-review/coupons/C01_carrier_original.step
57.6 x 20.0 x 8.00 mm
