AubergineShallow/digital8mm-vertical-nizo/cad/gs8-d2-v1/candidate-vertical/structural-review/coupons/C09_J4_tongue.step

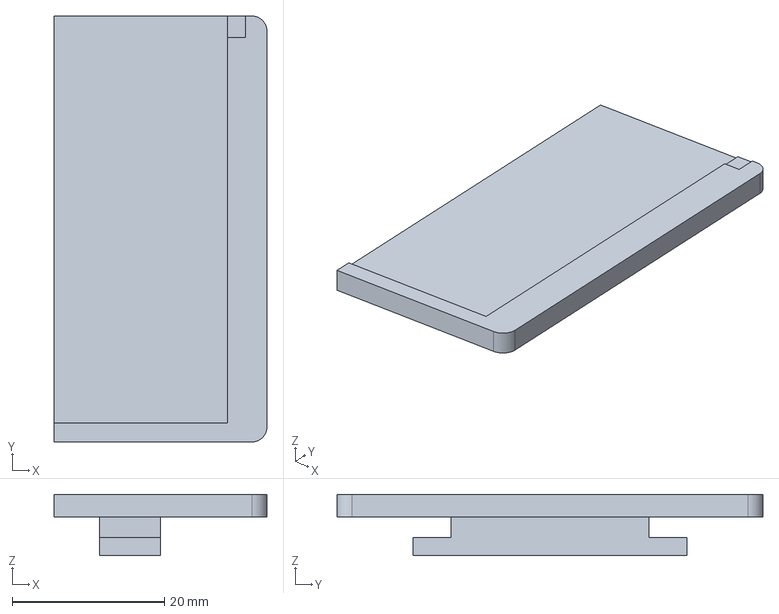
[picture p49: CAD file, 2026-10-09]
cad/gs8-d2-v1/candidate-vertical/structural-review/coupons/C09_J4_tongue.step
28.0 x 56.0 x 8.05 mm
