AubergineShallow/digital8mm-vertical-nizo/cad/gs8-d2-v1/candidate-vertical/out/compact-fujinon_hf6xa/step/lens.step

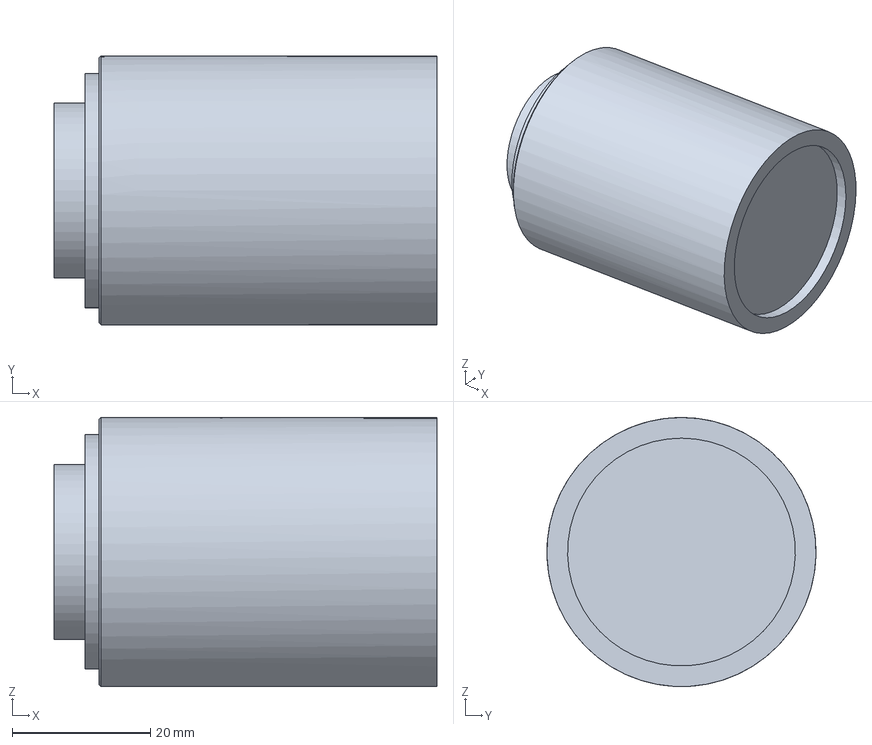
[picture p50: CAD file, 2026-10-09]
cad/gs8-d2-v1/candidate-vertical/out/compact-fujinon_hf6xa/step/lens.step
55.5 x 39.0 x 39.0 mm
