AubergineShallow/digital8mm-vertical-nizo/cad/gs8-d2-v1/candidate-vertical/out/original-kowa_lm6hc/step/usb_storage_plug_reserve.step

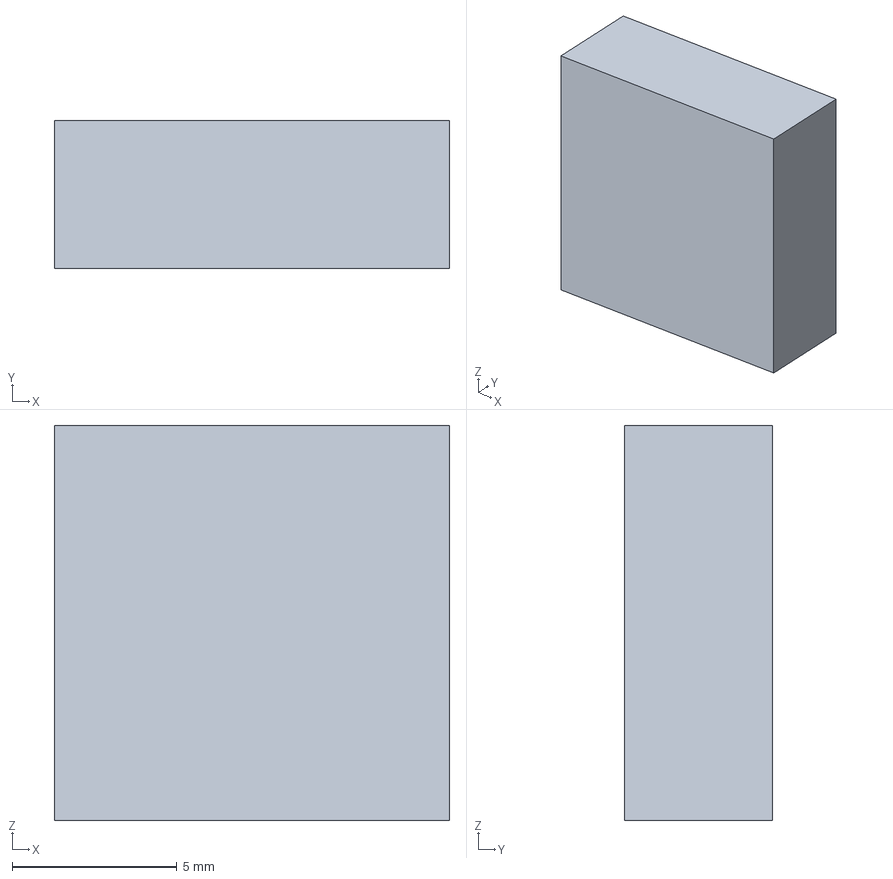
[picture p60: CAD file, 2026-10-09]
cad/gs8-d2-v1/candidate-vertical/out/original-kowa_lm6hc/step/usb_storage_plug_reserve.step
12.0 x 4.50 x 12.0 mm
