AubergineShallow/digital8mm-vertical-nizo/(list of files, cad)

Other CAD files:
cad/gs8-d2-v1/candidate-vertical/routing-snapshots/hdmi-ck1044-clear-20261009-0524/official-fpc-sources/cam_disp0-native.step
cad/gs8-d2-v1/candidate-vertical/out/compact-fujinon_hf6xa/step/carrier.step
cad/gs8-d2-v1/candidate-vertical/out/compact-fujinon_hf6xa/step/p_panel3.step
cad/gs8-d2-v1/candidate-vertical/out/compact-kowa_lm6hc/step/evf_board.step
cad/gs8-d2-v1/candidate-vertical/out/compact-kowa_lm6hc/step/knob_exp.step
cad/gs8-d2-v1/candidate-vertical/out/original-kowa_lm6hc/step/hmx039.step
cad/gs8-d2-v1/candidate-vertical/out/original-kowa_lm6hc/step/base_grip.step
cad/gs8-d2-v1/candidate-vertical/out/compact-kowa_lm6hc/step/p_panel1.step
cad/gs8-d2-v1/candidate-vertical/out/original-kowa_lm6hc/step/switch_1824.step
cad/gs8-d2-v1/candidate-vertical/out/compact-fujinon_hf6xa/step/p_carrier2.step
cad/gs8-d2-v1/candidate-vertical/out/compact-kowa_lm6hc/step/p_panel2.step
cad/gs8-d2-v1/candidate-vertical/out/original-kowa_lm6hc/step/p_panel4.step
cad/gs8-d2-v1/candidate-vertical/out/compact-kowa_lm6hc/step/p_carrier2.step
cad/gs8-d2-v1/candidate-vertical/out/original-kowa_lm6hc/step/foam_pad.step
cad/gs8-d2-v1/candidate-vertical/out/compact-kowa_lm6hc/step/p_grip.step
cad/gs8-d2-v1/candidate-vertical/out/compact-fujinon_hf6xa/step/panel.step
cad/gs8-d2-v1/candidate-vertical/out/compact-kowa_lm6hc/step/panel.step
cad/gs8-d2-v1/candidate-vertical/out/compact-fujinon_hf6xa/step/s_c1.step
cad/gs8-d2-v1/candidate-vertical/out/compact-kowa_lm6hc/step/power_button.step
cad/gs8-d2-v1/candidate-vertical/out/compact-fujinon_hf6xa/step/p_panel1.step
cad/gs8-d2-v1/candidate-vertical/out/compact-kowa_lm6hc/step/microsd.step
cad/gs8-d2-v1/candidate-vertical/out/original-kowa_lm6hc/step/s_c3.step
cad/gs8-d2-v1/candidate-vertical/out/compact-fujinon_hf6xa/step/foam_pad.step
cad/gs8-d2-v1/candidate-vertical/out/compact-kowa_lm6hc/step/knob_fps.step
cad/gs8-d2-v1/candidate-vertical/out/original-kowa_lm6hc/step/centring_gauge.step
cad/gs8-d2-v1/candidate-vertical/out/compact-fujinon_hf6xa/step/p_carrier1.step
cad/gs8-d2-v1/candidate-vertical/out/original-kowa_lm6hc/step/p_carrier1.step
cad/gs8-d2-v1/candidate-vertical/out/compact-fujinon_hf6xa/step/s_c3.step
cad/gs8-d2-v1/candidate-vertical/out/compact-fujinon_hf6xa/step/x1203.step
cad/gs8-d2-v1/candidate-vertical/out/compact-kowa_lm6hc/step/c_cs_adapter.step
cad/gs8-d2-v1/candidate-vertical/out/original-kowa_lm6hc/step/c_cs_adapter.step
cad/gs8-d2-v1/candidate-vertical/out/compact-fujinon_hf6xa/step/p_grip.step
cad/gs8-d2-v1/candidate-vertical/out/original-kowa_lm6hc/step/strap.step
cad/gs8-d2-v1/candidate-vertical/out/original-kowa_lm6hc/step/eyecup.step
cad/gs8-d2-v1/candidate-vertical/out/compact-fujinon_hf6xa/step/knob_fps.step
cad/gs8-d2-v1/candidate-vertical/out/compact-fujinon_hf6xa/step/microsd.step
cad/gs8-d2-v1/candidate-vertical/out/original-kowa_lm6hc/step/evf_board.step
cad/gs8-d2-v1/candidate-vertical/out/compact-fujinon_hf6xa/step/xt30_pair.step
cad/gs8-d2-v1/candidate-vertical/out/compact-kowa_lm6hc/step/cooler.step
cad/gs8-d2-v1/candidate-vertical/out/original-kowa_lm6hc/step/p_panel2.step
cad/gs8-d2-v1/candidate-vertical/out/compact-kowa_lm6hc/step/s_c1.step
cad/gs8-d2-v1/candidate-vertical/out/original-kowa_lm6hc/step/s_c4.step
cad/gs8-d2-v1/candidate-vertical/out/compact-fujinon_hf6xa/step/base_grip.step
cad/gs8-d2-v1/candidate-vertical/out/compact-kowa_lm6hc/step/base_grip.step
cad/gs8-d2-v1/candidate-vertical/out/compact-fujinon_hf6xa/step/x1203_kit.step
cad/gs8-d2-v1/candidate-vertical/out/compact-kowa_lm6hc/step/x1203_kit.step
cad/gs8-d2-v1/candidate-vertical/out/original-kowa_lm6hc/step/p_grip.step
cad/gs8-d2-v1/candidate-vertical/out/compact-kowa_lm6hc/step/usb_storage_plug_reserve.step
cad/gs8-d2-v1/candidate-vertical/out/compact-fujinon_hf6xa/step/cap.step
cad/gs8-d2-v1/candidate-vertical/out/compact-kowa_lm6hc/step/gs_camera.step
cad/gs8-d2-v1/candidate-vertical/out/original-kowa_lm6hc/step/run_button.step
cad/gs8-d2-v1/candidate-vertical/out/compact-fujinon_hf6xa/step/run_button.step
cad/gs8-d2-v1/candidate-vertical/out/compact-kowa_lm6hc/step/eyecup.step
cad/gs8-d2-v1/candidate-vertical/out/original-kowa_lm6hc/step/xt30_pair.step
cad/gs8-d2-v1/candidate-vertical/out/compact-fujinon_hf6xa/step/power_button.step
cad/gs8-d2-v1/candidate-vertical/out/original-kowa_lm6hc/step/s_c2.step
cad/gs8-d2-v1/candidate-vertical/out/compact-fujinon_hf6xa/step/s_c4.step
cad/gs8-d2-v1/candidate-vertical/out/compact-kowa_lm6hc/step/pack.step
cad/gs8-d2-v1/candidate-vertical/out/original-kowa_lm6hc/step/cap.step
cad/gs8-d2-v1/candidate-vertical/out/compact-fujinon_hf6xa/step/usb_storage_plug_reserve.step
cad/gs8-d2-v1/candidate-vertical/out/compact-kowa_lm6hc/step/p_panel3.step
cad/gs8-d2-v1/candidate-vertical/out/original-kowa_lm6hc/step/encoder.step
cad/gs8-d2-v1/candidate-vertical/out/compact-fujinon_hf6xa/step/gs_camera.step
cad/gs8-d2-v1/candidate-vertical/out/compact-kowa_lm6hc/step/tub.step
cad/gs8-d2-v1/candidate-vertical/out/original-kowa_lm6hc/step/p_panel3.step
cad/gs8-d2-v1/candidate-vertical/out/compact-fujinon_hf6xa/step/s_c2.step
cad/gs8-d2-v1/candidate-vertical/out/compact-kowa_lm6hc/step/encoder.step
cad/gs8-d2-v1/candidate-vertical/out/original-kowa_lm6hc/step/eyepiece.step
cad/gs8-d2-v1/candidate-vertical/out/compact-fujinon_hf6xa/step/eyepiece.step
cad/gs8-d2-v1/candidate-vertical/out/compact-kowa_lm6hc/step/s_c3.step
cad/gs8-d2-v1/candidate-vertical/out/original-kowa_lm6hc/step/x1203.step
cad/gs8-d2-v1/candidate-vertical/out/compact-fujinon_hf6xa/step/usb_stick.step
cad/gs8-d2-v1/candidate-vertical/out/original-kowa_lm6hc/step/carrier.step
cad/gs8-d2-v1/candidate-vertical/out/compact-fujinon_hf6xa/step/hmx039.step
cad/gs8-d2-v1/candidate-vertical/out/compact-kowa_lm6hc/step/p_carrier1.step
cad/gs8-d2-v1/candidate-vertical/out/original-kowa_lm6hc/step/p_carrier2.step
cad/gs8-d2-v1/candidate-vertical/out/compact-fujinon_hf6xa/step/strap.step
cad/gs8-d2-v1/candidate-vertical/out/original-kowa_lm6hc/step/knob_exp.step
cad/gs8-d2-v1/candidate-vertical/out/compact-fujinon_hf6xa/step/cooler.step
cad/gs8-d2-v1/candidate-vertical/out/compact-kowa_lm6hc/step/switch_1824.step
cad/gs8-d2-v1/candidate-vertical/out/original-kowa_lm6hc/step/p_panel1.step
cad/gs8-d2-v1/candidate-vertical/out/compact-kowa_lm6hc/step/s_c2.step
cad/gs8-d2-v1/candidate-vertical/out/original-kowa_lm6hc/step/pack.step
cad/gs8-d2-v1/candidate-vertical/out/compact-fujinon_hf6xa/step/p_panel4.step
cad/gs8-d2-v1/candidate-vertical/out/compact-kowa_lm6hc/step/p_panel4.step
cad/gs8-d2-v1/candidate-vertical/out/original-kowa_lm6hc/step/lens_collar.step
cad/gs8-d2-v1/candidate-vertical/out/original-kowa_lm6hc/step/lens.step
cad/gs8-d2-v1/candidate-vertical/out/compact-fujinon_hf6xa/step/fps_mounting_washer.step
cad/gs8-d2-v1/candidate-vertical/out/compact-fujinon_hf6xa/step/fps_nut.step
cad/gs8-d2-v1/candidate-vertical/out/compact-fujinon_hf6xa/step/power_nut_reserve.step
cad/gs8-d2-v1/candidate-vertical/out/compact-fujinon_hf6xa/step/tripod_nut.step
cad/gs8-d2-v1/candidate-vertical/out/compact-fujinon_hf6xa/stl/base_grip.stl
cad/gs8-d2-v1/candidate-vertical/out/compact-fujinon_hf6xa/stl/cap.stl
cad/gs8-d2-v1/candidate-vertical/out/compact-fujinon_hf6xa/stl/carrier.stl
cad/gs8-d2-v1/candidate-vertical/out/compact-fujinon_hf6xa/stl/centring_gauge.stl
cad/gs8-d2-v1/candidate-vertical/out/compact-fujinon_hf6xa/stl/eyecup.stl
cad/gs8-d2-v1/candidate-vertical/out/compact-fujinon_hf6xa/stl/knob_exp.stl
cad/gs8-d2-v1/candidate-vertical/out/compact-fujinon_hf6xa/stl/knob_fps.stl
cad/gs8-d2-v1/candidate-vertical/out/compact-fujinon_hf6xa/stl/lens_collar.stl
cad/gs8-d2-v1/candidate-vertical/out/compact-fujinon_hf6xa/stl/panel.stl
cad/gs8-d2-v1/candidate-vertical/out/compact-fujinon_hf6xa/stl/tub.stl
cad/gs8-d2-v1/candidate-vertical/out/compact-kowa_lm6hc/step/fps_mounting_washer.step
cad/gs8-d2-v1/candidate-vertical/out/compact-kowa_lm6hc/step/fps_nut.step
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
