AubergineShallow/digital8mm-vertical-nizo/cad/gs8-d2-v1/candidate-vertical/WIRING-VERTICAL.md

# Vertical candidate: wiring specification

<!-- Generated by make_wiring_vertical.py (FP-14, review VN-61). Do not edit by hand; edit the sources and regenerate, then run with --check. -->

**Unqualified review candidate. Nothing here is bought, built or measured.** Lengths are route-model and purchase-requirement figures, not cut instructions; every open item names its gate.

For this fork this file supersedes the baseline (r7) `electronics/gs8-d2-v1/WIRING.md` sections 2 (block diagram), 5 (header), 6 (cables) and 7 (plug order): the r7 file still describes the printed plunger, a JST PH pigtail and a PH EVF plug that the candidate does not buy. Still in force from r7: section 4 (power path, pack and current budget), section 8 (Pi configuration) and section 9 (bench gates). USB ports in this candidate: recording drive in the upper USB3 port (steps.py `storage_in`), EVF feed in the upper USB2 port (routes.py usb_5v note, official_pi5_geometry.py).

Generated from: `wiring_data.py`, `steps.py`, `harness_rules.py`, `routes.py`, `signal_routes.py`, `power_routes.py`, `make_bom_vertical.py`, `out/compact-kowa_lm6hc/harness-checks.json`. Harness report `out/compact-kowa_lm6hc/harness-checks.json`: current.

## 1. Block diagram

```
pack 1S2P --60 mm 18 AWG--> XT30 male | XT30 FEMALE --fuse 15 A (+)--16 AWG red/black--> X1203 battery pads
X1203 (pogo 5.1 V) --> Pi 5 pins 2/4 ............................ Pi 5 (vertical, carrier)
Pi 5 J8 1/3/5/6  --QT lead (sockets / SH 4-pin)-----------------> encoder 5880 (0x37) [panel]
Pi 5 J8 33/34    --donor stubs~Molex PicoBlade pair-------------> CK1044 18/24 (common A, throw 2) [carrier]
Pi 5 J8 37/39    <--pre-wired run lead--------------------------- run button [grip]
Pi 5 J2 pads     --J2 keyed pair (molex-micro-fit-3.0)---------> Adafruit 1505 NO [panel]
Pi 5 upper USB2  --4448 red/black--1N5817 (+, band to EVF)--RCY 2180|2181--> EVF board EXT+/GND
Pi 5 HDMI0       --3557 head~3562 ribbon 300 mm~3556 head--------> EVF board receptacle
Pi 5 CAM/DISP 1  --official 200 mm FPC--------------------------> GS camera (bench-mated end)
Pi 5 FAN         --native lead----------------------------------> Active Cooler
Pi 5 upper USB3  <-- recording drive (storage, not a harness)
```

## 2. Pi 5 header (J8), J2 and I2C

| Pin | Signal | Connected to | Lead | Header housing |
|---|---|---|---|---|
| 1 | 3V3 | encoder V+ (QT red) | `qt` | `hdr_qt_1` |
| 3 | GPIO2 / SDA1 | encoder SDA (QT blue); X1203 gauge (pogo) | `qt` | `hdr_qt_3` |
| 5 | GPIO3 / SCL1 | encoder SCL (QT yellow); X1203 gauge (pogo) | `qt` | `hdr_qt_5` |
| 6 | GND | encoder GND (QT black) | `qt` | `hdr_qt_6` |
| 33 | GPIO13 | 18/24 switch, common A | `fps_lead` | `hdr_fps_lead_33_34` |
| 34 | GND | 18/24 switch, throw 2 | `fps_lead` | `hdr_fps_lead_33_34` |
| 37 | GPIO26 | run button | `run_lead` | `hdr_run_lead_37` |
| 39 | GND | run button | `run_lead` | `hdr_run_lead_39` |

All other J8 pins are free; GPIO6 / GPIO16 stay reserved for the X1203 (r7 W-2). Single 1-pin housings, seated with open tweezer tips and tug-tested (r7 G-HDR-1).

| J2 pad | Signal | Connected to | Lead |
|---|---|---|---|
| J2 (one pad) | PWR_BUT | Adafruit 1505 terminal via the J2 pair | `power_button` |
| J2 (other pad) | GND | Adafruit 1505 terminal via the J2 pair | `power_button` |

Pad identity, position under the cooler and solder access are G-V-POWER (VN-73); the 1505 is in parallel with the onboard button (same semantics, never battery isolation).

I2C bus 1: 0x36 X1203 fuel gauge (pogo); 0x37 Adafruit 5880 encoder with A0 bridged.

## 3. Junctions (wire-to-wire pairs)

Rule (VN-63): no two junctions share a mating family, whatever the circuit count. Checked from the BOM rows by `make_bom_vertical.validate` and tests/test_wiring_bom.py. Shared families now: none.

| Junction | BOM | Family (from the BOM SKU) | Sides | Carries | Mated | Parted in service |
|---|---|---|---|---|---|---|
| `evf_5v` | D2-23 | pololu-rcy-2.5 | source side: Pololu 2180 SOCKET-contact half on the USB donor; EVF side: Pololu 2181 PIN-contact half, tails soldered to the EVF board EXT+/GND pads | EVF 5 V after the diode (power, Pi USB2 VBUS) | pi end on `pi5` at `module_bench` (B2); evf end on `evf_board` at `evf_mate` (5) | `evf`/`svc_evf_unplug`, `module`/`svc_module_unplug` |
| `fps_1824` | D2-27 | molex-picoblade-1.25 | Pi side: Molex 2181110202 male assembly (225 mm), spliced to the two D2-25 donor stubs; switch side: Molex 2181120201 female assembly (150 mm), soldered to CK1044 common A and throw 2 | GPIO13 / GND (18/24 select) | pi end on `pi5` at `module_bench` (B2); sw end on `switch_1824` at `module_bench` (B2) | never parted in a service route |
| `j2` | V-28 | molex-micro-fit-3.0 | Pi side: receptacle housing with SOCKET (female) contacts on the Pi J2 side: the live side never shows a bare pin that could touch ground and press the button (same rule as the EVF RCY source half); switch side: plug housing with PIN (male) contacts on the 1505 switch side | Pi 5 J2 PWR_BUT / GND (power-button signal; never battery current) | pi end on `pi5` at `module_bench` (B2); btn end on `power_button` at `panel_prop` (6) | `panel`/`svc_panel_out` |
| `xt30` | D2-14 | amass-xt30 | camera side: XT30U FEMALE on the pigtail, fuse in the + conductor; pack side: XT30U male on the 60 mm pack lead (D2-13) | battery current (pigtail to pack; power last) | pigtail end on `x1203` at `module_bench` (B2); pack end on `pack` at `pack_in` (8) | `safety`/`svc_pack_out` |

### J2 connector family (default pending user decision 13)

- Default: **Molex Micro-Fit 3.0 2-circuit wire-to-wire (3.0 mm pitch)**, chosen because no other mateable half in the camera uses its pitch, its housings are polarized with a positive latch, and factory pre-crimped leads need no crimp tool. It replaces the 9ced753 J2 pair, which was the same unkeyed Molex PicoBlade family as the FPS junction. BOM V-28 (spare V-28S).
- Genders: receptacle housing with SOCKET (female) contacts on the Pi J2 side: the live side never shows a bare pin that could touch ground and press the button (same rule as the EVF RCY source half); plug housing with PIN (male) contacts on the 1505 switch side.
- Leads: each pre-crimped lead >= 231 mm exposed; longest 9ced753 V-28 tail upper bound (Molex 2181110202, 225 + 6 mm): each half may then sit on either side and the harness_rules j2_btn halves (150 / 225 +/- 6 mm) and CABLES power_button (363-387 mm) stay conservative lower bounds of what is bought; cut to the measured J2 route.
- Gate: G-V-POWER (VN-73): place the J2 pair and its stow after the real 1505 and J2 pads are measured; try-mate matrix on receipt (each J2 half must refuse every other mateable half in the camera).
- Alternative: JST SM 2-circuit wire-to-wire (2.5 mm pitch, positive latch) (family `jst-sm-2.5`): same pitch as the EVF RCY pair: needs a try-mate proof against Pololu 2180/2181 before adoption.
- Alternative: Molex PicoBlade 3-circuit pair with the centre cavity blanked (family `molex-picoblade-1.25`): same family as FPS: a 2-circuit half may enter a 3-circuit shroud; the conservative family rule rejects it unless a try-mate proof is recorded.
- Alternative: Same PicoBlade pair as FPS with labels and coloured sleeves only (9ced753) (family `molex-picoblade-1.25`): rejected by VN-63: labels do not stop a cross-mate.

## 4. Harness schedule (every lead, both ends)

### `qt`

| Field | Value |
|---|---|
| End A | Pi 5 header pins 1 / 3 / 5 / 6: four single 2.54 mm female housings (Adafruit 4397 sockets) |
| End B | Adafruit 5880 encoder STEMMA QT socket: JST SH 4-pin plug (Pololu 5521) |
| Conductors and colours | 4 x QT cores: pin 1 3V3 red, pin 3 SDA blue, pin 5 SCL yellow, pin 6 GND black (STEMMA QT colours, r7 W-QT); splice the two sources by SH pin number with a meter, never by colour alone |
| Polarity | 3V3 on pin 1 only; never 5 V |
| BOM | D2-24 QT lead part 1: Adafruit 4397 STEMMA QT to female sockets, 150 mm (cut so the socket end is about 93-117 mm, WIRING W-QT) (Adafruit 4397); D2-24B QT lead part 2: Pololu #5521 JST SH-style 4-pin cable, single-ended female, 30 cm, 28 AWG (SH end kept; cut so the finished lead is 250 +/- 10 mm) (Pololu 5521) |
| Stock `qt` | 250 mm (240-260) (BOM D2-24 / D2-24B: finished QT lead 250 +/- 10 mm (MP-QT measures)) |
| Route `qt` | installed 206.93, shortest 203.54 + allowance 25 vs minimum stock 240: slack 11.46 mm (length rule pass) |
| Mated | pi end on `pi5` at `module_bench` (B2); enc end on `encoder` at `panel_prop` (6) |
| Parted in service | `panel`/`svc_panel_out` |
| Harness report rows | cable_routes/qt fail; mate_reach/qt_enc pass; cable_stow/qt pass |

### `run_lead`

| Field | Value |
|---|---|
| End A | run button in the grip cradle (pre-wired, factory joints) |
| End B | Pi 5 header pins 37 (GPIO26) and 39 (GND): two single female housings |
| Conductors and colours | 2 cores as supplied (colours record on receipt) |
| Polarity | none (contact to GND) |
| BOM | D2-12 Run button: pre-wired momentary, red cap, female-socket leads (Squid Button (non-latching) class) |
| Stock `run_pin37` | 250 mm, no tolerance (r7 CABLES run_lead length 250 mm design value; no vendor tolerance (MP-RUN measures)) |
| Route `run_pin37` | installed 250, shortest 183.27 + allowance 25 vs minimum stock 250: slack 41.73 mm (length rule pass) |
| Stock `run_pin39` | 250 mm, no tolerance (r7 CABLES run_lead length 250 mm design value; no vendor tolerance (MP-RUN measures)) |
| Route `run_pin39` | installed 250, shortest 171.63 + allowance 25 vs minimum stock 250: slack 53.37 mm (length rule pass) |
| Mated | grip end on `run_button` at `grip_prep` (1); pi end on `pi5` at `module_staged` (4) |
| Parted in service | `module`/`svc_carrier_out` |
| Harness report rows | cable_routes/run_pin37 pass; cable_routes/run_pin39 pass; mate_reach/run_pi_37 pass; mate_reach/run_pi_39 pass; cable_stow/run_pin37 pass; cable_stow/run_pin39 pass |

### `fps_lead`

| Field | Value |
|---|---|
| End A | Pi 5 header pins 33 (GPIO13) and 34 (GND): two single female housings kept from the D2-25 donor stubs |
| End B | CK1044 18/24 switch: common A and throw 2 (solder) |
| Conductors and colours | donor stubs: two distinct colours, record which is pin 33; Molex leads: both black, so label FPS and continuity-test each core end to end |
| Polarity | none (contact to GND); GPIO13 = common A |
| BOM | D2-27 FPS inline pair: Molex 2181110202 male + 2181120201 female pigtail assemblies (Molex 2181110202 + 2181120201 (one of each)); D2-25 GPIO donor jumpers: two cut female-ended stubs from Adafruit 1950 pack (Adafruit 1950); D2-11 18/24 selector: Lorlin CK1044 imperial PCB rotary switch with adjustable stop (Lorlin CK1044) |
| Stock `fps_lead` | delegated: verify_fps_integrated.py -> integrated-fps-checks.json: the selected D2-27 Molex mated-carry harness; the signal_routes 200 + 50 mm PH model is superseded (BOM D2-27) |
| Route `fps_lead` | see the delegated report |
| Mated | pi end on `pi5` at `module_bench` (B2); sw end on `switch_1824` at `module_bench` (B2) |
| Parted in service | never parted in a service route |
| Harness report rows | cable_routes/fps_lead info; cable_stow/fps_lead info |

### `power_button`

| Field | Value |
|---|---|
| End A | Pi 5 J2 pads PWR_BUT and GND (solder; pad identity from the official drawing and the board, G-V-POWER) |
| End B | Adafruit 1505 normally-open terminals (solder) |
| Conductors and colours | 2 cores of two distinct colours (record which is PWR_BUT); label J2 at both housings |
| Polarity | the 1505 is a non-polarized NO contact: polarity matters only for the label and the try-mate matrix |
| BOM | V-28 J2 removable signal pair: keyed 2-circuit wire-to-wire set, Molex Micro-Fit 3.0 2-circuit wire-to-wire (3.0 mm pitch) (default pending user decision 13) (class: Molex Micro-Fit 3.0 2-circuit wire-to-wire set = 1 receptacle housing (socket contacts) + 1 plug housing (pin contacts) + 2 factory pre-crimped leads with female terminals + 2 with male terminals, 28-24 AWG, each lead >= 231 mm exposed; part numbers recorded at order after user decision 13); V-17 Normally-open black momentary panel power switch (Adafruit 1505) |
| Stock `power_button` | 375 mm (363-387) (BOM V-28: 2181120201 female 150 +/- 6 mm + 2181110202 male 225 +/- 6 mm exposed tails, cut to measured length; side genders unassigned (VN-63). The signal_routes 150 mm stock figure predates V-28.) |
| Route `power_button` | installed 76.75, shortest 76.75 + allowance 37.5 vs minimum stock 363: slack 248.75 mm (length rule pass) |
| Mated | pi end on `pi5` at `module_bench` (B2); btn end on `power_button` at `panel_prop` (6) |
| Parted in service | `panel`/`svc_panel_out` |
| Harness report rows | cable_routes/power_button pass; mate_reach/j2_btn fail; cable_stow/power_button info |

### `usb_5v`

| Field | Value |
|---|---|
| End A | Pi 5 upper USB2 port: Adafruit 4448 USB-A plug |
| End B | EVF board EXT+ / GND pads: Pololu 2181 tails (solder, strain-relieved at the board edge) |
| Conductors and colours | 4448 red VBUS and black GND only; white D- and green D+ each in its own sleeve (two pieces), shield sleeved only if present; RCY tail colours record on receipt |
| Polarity | 1N5817 in the + conductor, cathode band toward the EVF board (current flows USB -> EVF); 2180 socket half on the USB (source) side |
| BOM | D2-22 USB-A power-feed donor: Adafruit 4448 four-core breakout cable, cut to verified route (Adafruit 4448 / C14289-001); D2-16 Schottky diode 1N5817 (EVF 5 V lead, W-3; baseline feed) (MCC 1N5817-TP); D2-23 EVF power-only inline pair: Pololu 2180 socket-contact half + 2181 pin-contact half (Pololu 2180 + 2181, Generic RCY-style; one of each); D2-46 Adhesive-lined heat-shrink 3:1 (pigtail, diode splice, r4 fuse splice: about 4.8 mm, 30 mm per fuse) + thin-wall 2:1 (switch lugs) (class) |
| Stock `usb_5v` | 500 mm (500-535) (H1 (FIX-LOG): cut-to-length feed assembly, BOM D2-22 Adafruit 4448 donor catalog 300 mm (supplier drawing 325 +/- 10) + D2-23 Pololu 2180 / 2181 100 mm tails; the old 200 mm allocation is superseded (routing-snapshots/hdmi-export17-selected-20261009-0704/usb-donor-provenance.json). Each segment is held to its own stock with the r7 allowance in feed_volumes (usb_5v_donor, usb_5v_tail_2180, usb_5v_tail_2181).) |
| Route `usb_5v` | installed 197.93, shortest 197.93 + allowance 50 vs minimum stock 500: slack 252.07 mm (length rule pass) |
| Mated | pi end on `pi5` at `module_bench` (B2); evf end on `evf_board` at `evf_mate` (5) |
| Parted in service | `evf`/`svc_evf_unplug`, `module`/`svc_module_unplug` |
| Harness report rows | cable_routes/usb_5v pass; cable_stow/usb_5v info |

### `pigtail`

| Field | Value |
|---|---|
| End A | X1203 battery pads + / - (solder, neutral-cure RTV strain relief) |
| End B | camera-side XT30U FEMALE (solder) |
| Conductors and colours | 16 AWG PRC silicone: red SW-16R = +, black SW-16B = - |
| Polarity | red to X1203 + and XT30 +; the one 15 A inline fuse in the red (+) conductor near the XT30; check polarity with a meter before the first pack mate |
| BOM | D2-26 PRC high-flex pure-copper 16 AWG silicone wire, red and black (PRC 16 AWG silicone; red SW-16R; black SW-16B); D2-14 XT30U connector pair (female for the pigtail; male if the pack lacks one) (Amass XT30U); D2-14F Inline fuse 15 A, very fast, axial PICO II, 32 V (pigtail + conductor near the XT30 female; W-10, r4) (Littelfuse 0251015.MXL (DigiKey F2352-ND)) |
| Stock `pigtail_positive` | 270 mm finished path per polarity (harness_rules.PIGTAIL_LENGTH; cut to it, G-V-PIGTAIL) |
| Route `pigtail_positive` | installed 263.69, shortest 251.83 + allowance 27 vs minimum stock 270: slack -8.83 mm (length rule fail) |
| Stock `pigtail_negative` | 270 mm finished path per polarity (harness_rules.PIGTAIL_LENGTH; cut to it, G-V-PIGTAIL) |
| Route `pigtail_negative` | installed 268.09, shortest 250.92 + allowance 27 vs minimum stock 270: slack -7.92 mm (length rule fail) |
| Mated | pigtail end on `x1203` at `module_bench` (B2); pack end on `pack` at `pack_in` (8) |
| Parted in service | `safety`/`svc_pack_out` |
| Harness report rows | cable_routes/pigtail_positive fail; cable_routes/pigtail_negative fail; mate_reach/xt30_pack fail; lead_access/pigtail_ties_on_route fail; lead_access/pigtail_pad_range info; lead_access/pigtail_xt30_mouth fail; lead_access/pigtail_xt30_mouth_rtv_only info; lead_access/pigtail_drop fail; cable_stow/pigtail_positive info; cable_stow/pigtail_negative info |

### `pack_lead`

| Field | Value |
|---|---|
| End A | 1S2P pack BMS (existing 60 mm 18 AWG lead) |
| End B | pack-side XT30U male |
| Conductors and colours | as supplied with the pack |
| Polarity | XT30 housing marks |
| BOM | D2-13 1S2P 18650 pack: 2 high-drain cells (>= 10 A class), BMS >= 10 A, 18 AWG lead, XT30U male, pull ribbon (1S2P custom (Molicel P28A / Samsung 35E class)) |
| Stock `pack_lead` | 60 mm, no tolerance (D2-13 existing 60 mm 18 AWG pack lead (MP-PACK)) |
| Route `pack_lead` | installed 16.76, shortest 16.76 + allowance 10 vs minimum stock 60: slack 33.24 mm (length rule pass) |
| Mated | pigtail end on `x1203` at `module_bench` (B2); pack end on `pack` at `pack_in` (8) |
| Parted in service | `safety`/`svc_pack_out` |
| Harness report rows | cable_routes/pack_lead pass; cable_stow/pack_lead info |

### `fpc`

| Field | Value |
|---|---|
| End A | GS camera 15-pin connector (mated on the bench) |
| End B | Pi 5 CAM/DISP 1 (22-pin, through the CSI side slot) |
| Conductors and colours | official 200 mm 22-to-15 FPC |
| Polarity | contact side per the official cable; latch HOLD |
| BOM | D2-20 Pi 5 camera cable Standard-Mini 22-to-15 pin, 200 mm (official 200 mm) |
| Stock `fpc` | 200 mm, no tolerance (official 200 mm camera cable, design value (MTC camera-cable row)) |
| Route `fpc` | installed 112.88, shortest 112.88 + allowance 20 vs minimum stock 200: slack 67.12 mm (length rule pass) |
| Mated | cam end on `gs_camera` at `optics_bench` (B0); pi end on `pi5` at `evf_mate` (5) |
| Parted in service | `module`/`svc_module_unplug` |
| Harness report rows | cable_routes/fpc pass; cable_stow/fpc info |

### `hdmi`

| Field | Value |
|---|---|
| End A | Pi 5 HDMI0: Adafruit 3557 right-angle head |
| End B | EVF board receptacle: Adafruit 3556 straight head |
| Conductors and colours | intact 300 x 10 mm Adafruit 3562 ribbon |
| Polarity | contact face per head: check_scope HDMI_CONTACT_SIDES (HOLD until the parts are in hand) |
| BOM | V-21P Right-angle R-bend micro-HDMI plug adapter, Pi end (Adafruit 3557); V-22O HDMI ribbon cable, intact 300 x 10 mm (Adafruit 3562); V-21 Straight micro-HDMI plug adapter, EVF end (Adafruit 3556) |
| Stock `hdmi` | delegated: verify_hdmi.py -> hdmi-solid-checks.json: the full developable 300 mm 3562 ribbon is laid in explicit deployable loops and its carried / premate / unplugged poses are swept there |
| Route `hdmi` | see the delegated report |
| Mated | pi end on `pi5` at `module_bench` (B2); evf end on `evf_board` at `evf_mate` (5) |
| Parted in service | `evf`/`svc_evf_unplug`, `module`/`svc_module_unplug` |
| Harness report rows | cable_routes/hdmi info; cable_stow/hdmi info |

### `fan`

| Field | Value |
|---|---|
| End A | Active Cooler fan |
| End B | Pi 5 FAN header (native JST SH) |
| Conductors and colours | native lead |
| Polarity | keyed |
| BOM | D2-02 Raspberry Pi Active Cooler (SC1148) |
| Stock `fan` | 60 mm, no tolerance (native Active Cooler lead, r7 length estimate) |
| Route `fan` | installed 37.88, shortest 37.88 + allowance 10 vs minimum stock 60: slack 12.12 mm (length rule pass) |
| Mated | pi end on `pi5` at `module_bench` (B2); cooler end on `cooler` at `module_bench` (B2) |
| Parted in service | never parted in a service route |
| Harness report rows | cable_routes/fan pass; cable_stow/fan info |

### `oled_flex`

| Field | Value |
|---|---|
| End A | HMX039 OLED |
| End B | EVF driver board ZIF (bench op evf_bench) |
| Conductors and colours | native kit flex |
| Polarity | ZIF orientation per the kit |
| BOM | D2-07 EVF-A display kit: Hicenda HMX039 0.39 in 1024x768 micro-OLED + HDMI board (option "Display+HDMI Board+Prism") (Hicenda Tindie kit) |
| Stock `oled_flex` | 50 mm, no tolerance (kit OLED flex 50 mm (r7 CABLES)) |
| Route `oled_flex` | installed 28.08, shortest 28.08 + allowance 10 vs minimum stock 50: slack 11.92 mm (length rule pass) |
| Mated | bench op evf_bench (B4), not a steps.CONNECTIONS cable |
| Parted in service | bench only |
| Harness report rows | cable_routes/oled_flex pass; cable_stow/oled_flex info |

J2 length note: the harness check assumes 363-387 mm per conductor (BOM V-28: 2181120201 female 150 +/- 6 mm + 2181110202 male 225 +/- 6 mm exposed tails, cut to measured length; side genders unassigned (VN-63). The signal_routes 150 mm stock figure predates V-28.); the V-28 default buys >= 462 mm per conductor, so the check stays a lower bound of what is bought.

## 5. Polarity and colour rules

- `qt`: 3V3 on pin 1 only; never 5 V
- `run_lead`: none (contact to GND)
- `fps_lead`: none (contact to GND); GPIO13 = common A
- `power_button`: the 1505 is a non-polarized NO contact: polarity matters only for the label and the try-mate matrix
- `usb_5v`: 1N5817 in the + conductor, cathode band toward the EVF board (current flows USB -> EVF); 2180 socket half on the USB (source) side
- `pigtail`: red to X1203 + and XT30 +; the one 15 A inline fuse in the red (+) conductor near the XT30; check polarity with a meter before the first pack mate
- `pack_lead`: XT30 housing marks
- `fpc`: contact side per the official cable; latch HOLD
- `hdmi`: contact face per head: check_scope HDMI_CONTACT_SIDES (HOLD until the parts are in hand)
- `fan`: keyed
- `oled_flex`: ZIF orientation per the kit
- Socket (female) contacts on the live or source side of every inline pair: EVF 2180 on the USB side, J2 receptacle on the Pi side, XT30 FEMALE on the camera (battery-source) side of the pigtail.
- Never identify a conductor by colour alone where both cores are black (FPS Molex leads) or colours are not recorded: continuity-test end to end and label both housings.

## 6. Plug order (build)

From steps.STEPS; each end is mated once, at the op listed. Power last.

| Step | Op | Where | Mates |
|---|---|---|---|
| B0 | `optics_bench` | bench | `camera_fpc:cam` (gs_camera) |
| B2 | `module_bench` | bench | `fps_1824:pi` (pi5), `fps_1824:sw` (switch_1824), `evf_hdmi:pi` (pi5), `evf_5v:pi` (pi5), `qt:pi` (pi5), `j2:pi` (pi5), `fan:pi` (pi5), `fan:cooler` (cooler), `xt30:pigtail` (x1203) |
| 1 | `grip_prep` | body | `run_lead:grip` (run_button) |
| 4 | `module_staged` | prop | `run_lead:pi` (pi5) |
| 5 | `evf_mate` | body | `camera_fpc:pi` (pi5), `evf_hdmi:evf` (evf_board), `evf_5v:evf` (evf_board) |
| 6 | `panel_prop` | prop | `qt:enc` (encoder), `j2:btn` (power_button) |
| 8 | `pack_in` | body | `xt30:pack` (pack) |

## 7. Unplug order (service)

From steps.SERVICE; a route runs after the routes it requires (section 1 safety first: pack out, XT30 parted). Refit is the reverse.

| Route | Requires | Parts in order |
|---|---|---|
| `safety` | - | `svc_pack_out`: xt30 |
| `panel` | safety | `svc_panel_out`: qt, j2 |
| `storage` | safety | none |
| `lens` | safety | none |
| `evf` | safety -> panel | `svc_evf_unplug`: evf_hdmi, evf_5v |
| `microsd` | safety -> panel | none |
| `module` | safety -> storage -> panel | `svc_module_unplug`: evf_hdmi, evf_5v, camera_fpc; `svc_carrier_out`: run_lead |
| `camera` | safety -> panel -> storage -> module -> lens | none |
| `collar` | safety -> panel -> storage -> module -> lens -> camera | none |
| `grip` | safety -> storage -> panel -> module | none |

## 8. Battery pigtail drop (G-W5)

harness_rules.pigtail_drop_row at 8.6 A, limit 0.15 V (never relaxed): low 0.14277 V, high 0.16254 V, status fail. Decision data (VN-62 user decision: shorter finished path, 14 AWG with a lane re-check, or a higher software cut-off. The 0.150 V limit is never relaxed by this check.): shortest-path limit 225.4 mm (hot fuse) / 266.3 mm (cold fuse); cut-off raise needed 0.01254 V. This is user decision 4; the row fails honestly until it is taken.

## 9. Open items

- J2 connector family: default pending user decision 13 (VN-63).
- V-62 deep socket purchase: gated on Adafruit 1505 nut across-flats (MEASUREMENTS-TO-CLOSE "Adafruit 1505 power switch and J2 signal harness" row; VN-73).
- Harness rows failing in the bound report: cable_routes: pigtail_negative, pigtail_positive, qt; lead_access: pigtail_drop, pigtail_ties_on_route, pigtail_xt30_mouth; mate_reach: j2_btn, xt30_pack.
- Lengths are regenerated from the route sources; the final refresh (FP-16) regenerates this file after the route and harness lanes land.
