AubergineShallow/digital8mm-vertical-nizo/cad/gs8-d2-v1/candidate-vertical/guide/STEP-REVIEW-CONCEALED-VENTS.md

# Concealed ventilation guide evidence and limitations

The original `STEP-REVIEW.md` remains the underlying assembly, wiring and service evidence checklist. This revised review adds the items below without closing any earlier STOP. All 56 inherited physical gates, M1 and candidate gates remain open.

| Section | Evidence used | Remaining physical check or hold |
|---|---|---|
| Cover and inventory | Current manifest core dimensions and nine printed part meshes | Slicer, material, supports, tolerances and actual prints; no purchased-part changes |
| 03v Cold outer bay | Source geometry and manifest-matched saved-STEP checks; rear/underside mouths, separate cold bay and four inner-wall slots | Actual unobstructed path, posts, roof sag, debris and pressure loss; section is an analytical diagram |
| 03v Hot outer bay | Source geometry and manifest-matched saved-STEP checks; four inner-wall slots and front/underside mouths | Complete path and real internal leakage; individual sampled paths do not solve the entire air domain |
| 03w Panel | Current source restores a nominal 2.8 mm skin; historical angled-trial probes identified the old 0.2 mm floors | Selected plenum report contains no panel-thickness probes; physical print, control fit, seam and dimensional qualification remain open |
| 03w Print and cleanout | Exported tub orientation and integral post layout from the same source | Slicer layer/bridge review and representative plenum coupon; no inaccessible/trapped supports; inspect and clean both bays before fitting electronics |
| 13 CSI service | Existing straight 12 x 27 mm R1 opening; limited source-bound tool reserves remain separate | Do not cover the opening; actual cooler, latch/jaws and complete 200 mm FPC are still operational HOLD |
| 17v Assembly | Perimeter mouths, blank exterior skin, separated outer bays, original inner wall/cavity datum and existing internal baffle | Full FPC, EVF feed, power loop, tie heads and fan lead must clear; preserve all prior loom holds |
| 17v Air path | Nominal gross mouth and inner-wall-slot areas only | CSI and internal baffle remain unsealed; no fan operating-point, pressure-loss, recirculation or thermal proof |
| 17v Hand and thermal | Written test prerequisites and record requirements | Rear, underside and front-edge mouth hand/strap/stand occlusion plus matched ambient/load closed-body testing after electrical prerequisites; actual cooler metrology remains open |

The nominal 1.6 mm exterior skin, 6 mm gap and original 2.5 mm inner wall conceal the internal slots behind the broad side. The front face has no repeated vent slot field. Edge mouths and the explicit CSI service opening remain. Compare gross mouth areas and inner-wall slots separately; their total areas are not a measured airflow, effective free-flow coefficient or fan operating point. Posts, turns, leakage, actual cooler registration and printed roughness remain unqualified.

The tub is one print. Its 1.6 mm integral posts on a nominal 8 mm grid are only a roof-support proposal before slicing. The front mouth removes frame support across Z5..40: the identified 10.7 mm gap is not a supported bridge at that mouth. Depending on raster direction, front-edge paths may require about 35 mm bridging. The expanded 110 x 100 mm crop includes that region. This remains a prominent print HOLD; if slicing or coupons fail, add local support webs and rerun the changed airflow-section checks. No automatically generated internal support may be left trapped inside the plenum. A representative coupon must establish the layer sequence, bridge spans, roof shape, post attachment and practical inspection/cleanout access. If a region cannot be inspected or cleared through an intended mouth, revise the print strategy or geometry before proceeding. Do not drill through the blank exterior skin to rescue a failed print.

If the hot underside mouth is blocked, only the nominal 210 mm2 front mouth remains for the 510 mm2 inner-wall slots. This is an occlusion scenario, not a qualified operating state.

The guide must not imply full concealment from every viewing angle, a sealed CSI opening, dust protection or water resistance. The new topology replaces the archived angled-channel trial; its 16 inclined passages and normal-throat figures are not the selected procedure.

The distinct source receipt must preserve the actual manifest and ventilation-report hashes. A current ventilation geometry pass may label only the recorded saved-STEP checks. Other computed captions remain governed by their own manifest and source binding. The final page count belongs to the revised receipt, not the original 29-page checkpoint. The manifest-bound structural supplement is included as analytical evidence; it does not close a strength or print gate.
