AubergineShallow/digital8mm-vertical-nizo/cad/gs8-d2-v1/candidate-vertical/MEASUREMENTS-TO-CLOSE.md

# Received-part measurements to close geometry holds

This is a de-energized measurement plan, not an assembly or power-on release. Remove USB/bench power and physically isolate the battery before touching internal hardware. Use ESD precautions, a caliper/depth gauge and scaled orthogonal photographs; do not probe energized contacts. Record part numbers/revisions, measurement uncertainty and photographs with the same datums used in CAD. Never force a mating connector or pull a ribbon to operate its latch.

This checklist now applies to the concealed-vent candidate: 158 × 63.6 × 100 mm compact core, cooler-side outer Y−35.6 / inner Y−25.5, plain 2.8 mm panel, and the retained straight unsealed CSI access slot. Export18 reports remain frozen references until rebound to this geometry.

For each item, archive the measurements, update the source/proxy geometry, then rerun its manifest-bound static and service checks. A corrected model does not close the inherited physical tests. All 56 physical gates and collar M1 remain open.

| Received item | Measure and record | CAD hold resolved / follow-on check |
|---|---|---|
| Pi 5 plus official Active Cooler | Register the board by all four mounting-hole centres, board faces and edges, with measured residual error. Record cooler underside outline, contact pads, protrusions and actual installed stand-off height; locate the two push-pin axes, heads, latches and compressed/free geometry. Photograph the pin-fin/blower assembly in its actual orientation. Do not treat four old illustrative feet as four real fasteners. | Distinguishes a genuine interference from the approximate cooler proxy's active overlap with source Pi geometry (retained export18 witness is 79.902671 mm³; its magnitude is not a measured physical interference). Rebuild the occupied cooler shape and its two mount interfaces, preserve intended thermal contacts, then rerun full stack/printed-clearance and carried-stack checks. Cooling remains a separate powered thermal gate. |
| Camera cable interfaces at Pi and GS camera | Identify the exact Pi CAM/DISP port and camera connector. Relative to board holes/faces, record socket body and entry-plane position, contact-facing side, latch hinge/slide direction, closed/open latch envelopes and release travel. Record access to both latch ends and the actual tool-tip/jaw width needed without touching components. Record cable/stiffener width, thickness, length, exposed-contact length and minimum straight exit before bending at both ends. | Replaces the incorrect inherited CSI orientation/vertical-root proxy and unmeasured camera-end datum. Rebuild both occupied connectors and latch/tool sweeps. A straight empty corridor is not proof that the latch can be released with the full cable present. |
| Official nominal 200 mm camera cable | Lay it flat and measure end-to-end length and each end's seated insertion depth; distinguish total cable length, contact/stiffener lengths and free length between seated exit planes. Verify contact orientation at both ends. Record any documented static bend limit; do not assign a safe radius solely because the ribbon can be bent to it once. | Establishes actual usable free length and full-width material needed for the currently unplaced FPC route, slack storage and service motion. Check the full width and stiffeners, not a centreline; rerun collision, bend and latch-access studies before trial assembly. |
| Adafruit HDMI 3557/3556 heads and intact 3562 ribbon | On the real Pi/EVF sockets, measure seated connector depth and hard stop; record all exposed head-body bounds and mating-axis direction. Measure ribbon exit plane, centre, normal/clocking, width/thickness and clamp/stiffener length, plus unplug stroke and housing grasp area. Record which side the contacts face on each head as mated and whether the 3562 ribbon has its contacts on the same face at both ends (enter in `check_scope.HDMI_CONTACT_SIDES`; the FP-12 `hdmi_face` rows state the required sides for the routed fold). Record the intact ribbon length without stretching it. | Replaces inferred plug centring/insertion-depth and ribbon-exit datums. Rerun installed, pre-mate, EVF-unplugged and selected Pi-mated carried poses using full ribbon material. Existing proxy clearance does not establish real fit, durability, shielding or live-video performance. |
| Adafruit 4448 USB donor | Confirm purchased revision and actual stock length against the catalog 300 mm / supplier 325 ± 10 mm discrepancy. Measure USB metal projection, overmold, strain relief, seated exposed length and cable exit plane/direction (the installed usb_5v route needs the rigid head to end within 24.7 mm of the port face; longer means a re-route); measure actual jacket OD and straight length before a bend. Record breakout lengths and identify VBUS/GND/data cores by continuity with all power disconnected. Inspect whether a shield/drain exists before assigning an insulation piece. | Closes unknown overmold/strain-relief/exit data for the EVF feed. Rebuild the plug at a real USB port, then route the actual jacket, diode/joints, insulated unused data ends and power junction. The full EVF feed route and cuts remain open until this is done; G-W6 still requires measured-current voltage/drop and heating tests afterward. |
| Princeton PHD-USSD-500G compact recording drive | With cap removed, record actual exposed housing, plug shell and shoulder dimensions. Measure shell insertion depth/seated shoulder relative to the Pi socket face and verify which USB3 socket is used. Record extraction stroke and hand/grasp envelope; retain port/contact cavities instead of replacing the plug by a filled block. | Resolves actual storage mating and external-housing placement. Export16's 195.943 mm³ overlap came from a solid estimated plug reserve against real socket geometry; that diagnostic remains, but a non-material reservation is not occupied hardware. Use measured shell/contact engagement for the new mate check. Warm sustained recording speed, temperature and retention remain independent gates. |
| X1203 kit, carrier screws and received printed coupons | Measure the four standoff lengths, female thread depths and actual upper/lower screw lengths and heads. Record board thickness, boss/head-recess depth, bearing contact and any bottoming before clamping. Measure actual tie band/head dimensions against the 3 × 1 mm slots, without loading the UPS board. On the printed carrier, tub and panel (FP-11c) measure the 7.0 mm counterbores against the PT head and a 6.5 mm bit, the bottom-rail tongue resting on the tub seat rib, and the tongue-to-panel-stop gap (0.15 mm nominal, r7 window 0.1-0.3 mm). | Replaces nominal 3.4 mm lower-screw engagement with measured engagement and establishes a coupon/torque trial. The four longer lower screws replace four supplied screws; there are eight installed stack screws. Print strength and repeated-cycle retention remain physical gates. |
| Adafruit 1505 power switch and J2 signal harness | Reconcile actual flange, bushing/thread, panel clamping range, nut/washer and terminal dimensions with the conflicting product drawing. Record nut across-flats and usable tool approach. Locate J2 on the actual Pi and record pad access, protected solder-root volumes and wire exits. Measure both halves of the keyed J2 set (BOM V-28; family default pending user decision 13), seated length, release/grasp travel and lead length datums; run the try-mate matrix (each J2 half must refuse the FPS PicoBlade halves, the EVF RCY halves and the header housings); map each conductor by continuity and label J2. The nut across-flats sets the V-62 purchase (0 until measured). | Resolves switch/nut fit and the currently incomplete J2 connector/route. Prove full panel stow, supported prop reach, disconnect access and insulation with the assembled harness; a nominal connector box is insufficient. J2 is a signal circuit, not battery isolation. |
| Lorlin CK1044 and FPS donor/PicoBlade parts | Record all 13 terminal locations and sections, molded A/throw numbering, actual body/bushing/shaft profile and separate nut, mounting washer and stop/tang washer. Check the two-stop setting by continuity. Measure the Adafruit 1950 female housings, contact orientation, wire OD and retained-stub exits; measure the actual Molex mated body, tails and bench-separation grip. Qualify solder/heatshrink splice roots and the supported shaft-to-bushing hand transfer with coupons. | Resolves provisional terminal, donor-head, solder-root and support datums behind the 332-check scoped FPS result. Confirm the proposed shaft trim against the measured stack before cutting. Recheck complete mated carry with Pi HDMI mated and the EVF end free; actual hand coordination, fit, guide strength and connector lifetime remain open. |
| Pack, XT30 pair, fuse and PRC pigtail wire | With the pack isolated, record actual pad/cup locations, connector body/grasp and separation stroke, wire OD and stock lengths, fuse/joint-sleeve dimensions and straight exits. Use a non-energized routing mock-up to assign solder overlaps and pad roots inside each 270 mm total path budget; the positive budget includes the 20 mm rigid fuse/joint zone. Record retained loops, tie heads and access with the cap/body in the intended service state. | Establishes honest copper cuts and complete installed/service material. Prove pack isolation with retention unchanged and no assumed unfolding of fixed loops; rerun full route/collision checks. The rigid pack/junction/fuse study does not certify flexible deployment, hot voltage drop, fuse temperature or printed retention strength. |
| OS microSD and panel-mounted power switch | With all power isolated and the control panel removed, measure actual card grasp with straight fine-tip non-conductive tweezers, the +X withdrawal stroke out of the socket and the tool/finger reach for the dog-leg (+X 18 mm, then +Y out of the open panel side). Verify that the bench-fitted card is retained through complete-carrier insertion/removal. | The closed-panel card path is a rejected geometry case (power-switch body) and the straight panel-off +X path meets the lens collar (FP-12 `verify_microsd_service.py`). The rigid dog-leg card path is clear with the derived obstacle set; the tweezers body and fingers are not modelled. Qualify only panel-off dog-leg access or bench service of the whole module. Closing the unused front slit is user decision VN-29. |
| Concealed tub plenums and plain control panel | Use the generated regular-grid open-edge coupon as a preliminary aid, then include the required ports/CSI/post-exclusion section before judging the complete plenum. These geometries require slicer review and printing under the selected ASA process; open cut edges cannot prove closed-body cleanout. Record actual 1.6 mm skin/post dimensions, 6 mm gap, roof bridge spans, wall-slot and edge-mouth dimensions, divider continuity, sag, cleanout and accessible support-removal paths. Record dimensional uncertainty and slicer toolpaths. Weigh the final tub and panel; check all screw seats, optical datums and panel flatness. | Validates manufacturability of the skin, integral post grid, plenum roof and cold/hot bay separation. The retained 2.5 mm wall becomes a roof over the gap in the declared print pose; nominal 8 mm post spacing is not proof that all roof spans will bridge. The old four panel grooves had blind 0.2 mm floors and were not through vents; the plain 2.8 mm panel must not acquire new cuts. Replace empirical printed-mass factors with measured values before final load testing. A clear coupon is not a thermal or structural qualification. |
| Shadow-gap airflow and handling | After the inherited safe bench gates permit powered testing, measure the actual fan operating condition and closed-body workload temperatures with the hand/strap in the intended positions; record rear/underside inlet and front/underside exhaust obstruction, CSI bypass behavior and battery/grip temperature. Log unobstructed, normal-hand, fitted-strap and stand/support positions separately. A blocked hot underside mouth leaves only 210 mm² front opening versus 510 mm² wall ports; no rated blocked-mouth operation is established. Preserve the straight CSI slot and verify actual latch/jaw access with the complete FPC present. Measure or obtain the Active Cooler fan pressure-flow curve: the FP-12 `flow_network` rows give only area splits (CSI share of intake, occlusion cases) and compute no operating point until that band exists; any CSI plug stays user decision VN-36. | Closes the useful-flow/pressure-loss/occlusion portion of G-V-THERMAL and the new vent-specific print holds. The gross mouth/inner-wall slot areas and the 299.4 mm² smallest sampled hot section do not establish a global hydraulic minimum or airflow. The existing baffle and open CSI bypass do not establish a sealed duct, ingress protection or safe operating temperature. |
| QT lead (D2-24 Adafruit 4397 spliced to D2-24B Pololu 5521; FP-10, VN-28) | Finished length end to end and per branch (BOM 250 +/- 10 mm), the four socket-end branch lengths to the splice, actual fan-in/bundle OD, SH plug body and wire-exit point and the socket housings. Lay it in the wall lane and record the shortest loop it can take with the panel propped. | `harness-checks.json` rows cable_routes qt (shortest route plus allowance at the minimum length, with the modeled fan-in and the installed-route sweep of the main and its four branches), mate_reach qt_enc (H2: the lead is free at panel_prop, so the gate is the declared free-lead route, signal_routes free_leads, exact capsule sweep at the propped pose; the secured-lane reach is reported as secured_lane_case), cable_stow qt (longest lead in the loop family) and header_housings hdr_qt_*. Re-run verify_harness_checks.py with the measured range. |
| Run button lead (D2-12 pre-wired, I-12A; FP-10, VN-28) | Per-core length from the button root to each Dupont housing (no vendor tolerance is published; the 250 mm figure is r7's design value), core OD, housing body and wire exit, and how far the lead comes out of the grip floor hole. | cable_routes run_pin37 / run_pin39, mate_reach run_pi_37 / run_pi_39 (module staged outside the open side), header_housings hdr_run_lead_*. MP-RUN. |
| EVF power RCY pair (D2-23 Pololu 2180 + 2181; FP-10, VN-28) | Both housing bodies, contact orientation, factory tail lengths and exits, mated length and the unmating direction and force, with the source half on the USB donor and the board half on the EVF feed. | Confirms the placed 32 × 7 × 7 mm RCY reserve on the installed usb_5v route (harness feed_volumes usb_5v_rcy_pair) and both 100 mm tail spans (usb_5v_tail_2180 / _2181); then the evf_5v:evf mate (finger access HOLD) and whether each 20 AWG core fits the 3.6 mm lead envelope (≤ 1.8 mm OD). |
| EVF board 5 V pads (EXT+ / GND; FP-10, VN-28, VN-66) | Pad size, pitch and position relative to the board datums, solder access, trace clearance and room for strain relief at the board edge; decide between direct 20 AWG tails and a short 24-26 AWG pigtail. | The usb_5v route end point and its route row; VN-66 pigtail choice; then the EVF feed checks in `harness-checks.json`. |
| Tab-catch tine coupon (G-V-PRINT; T2, VN-53, FP-11b) | Print the tub's catch region (-Y down, with the ceiling, -Y tine and tenon pocket) and the +Y stub (bed face down) on the production printer; bond the stub with the chosen two-part epoxy (V-68) pressed onto the pocket datum. Record the pocket clearances as printed, the catch-face positions about the lens axis (both tines, y = +-8.28 nominal) and their flatness, then load each tine at the head contact with the r7 roll_catch design torque (0.5 N m at the least contact radius) and to failure: deflection, bond/tenon failure load and mode. | The bonded-stub default (user decision 16) or its alternatives; the roll_catch window rows use the nominal faces, so measured face offsets above the 0.129 mm worst-offset margin reopen roll_catch. |

## Close-out record

For each changed interface, include a dimensioned sketch or annotated photo, actual part/revision, datum definition, instrument uncertainty, source-file revision and the new report/manifest hashes. Record any mismatch as a failure to resolve, rather than moving a datum, shortening a purchased cable virtually or deleting a contact to obtain clearance. Safe handling, actual hand coordination, print strength, electrical performance and thermal performance require their own evidence.
