AubergineShallow/digital8mm-vertical-nizo/cad/gs8-d2-v1/candidate-vertical/guide/out-concealed-vents/qa/pdf-14.png

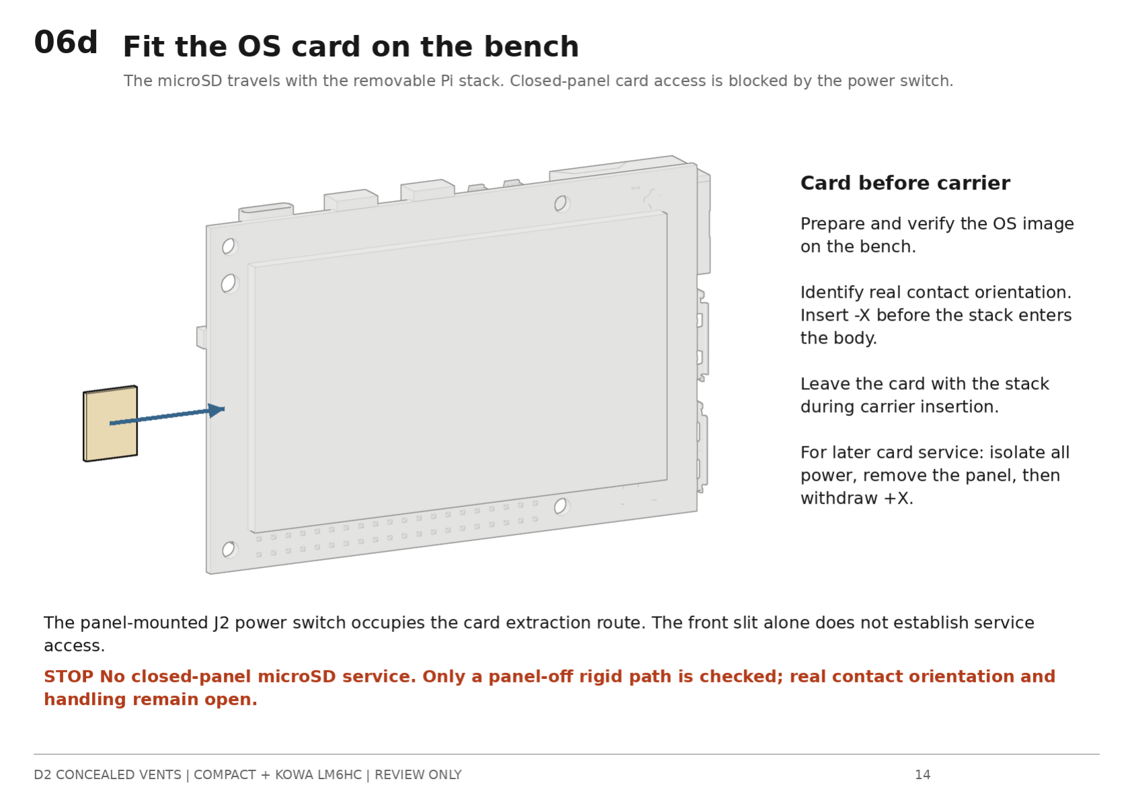
cad/gs8-d2-v1/candidate-vertical/guide/out-concealed-vents/qa/pdf-14.png
