AubergineShallow/digital8mm-vertical-nizo/cad/gs8-d2-v1/candidate-vertical/review-2026-10-10/FIX-LOG.md

# Fix log (review 2026-10-10)

Short progress lines from the fix lanes: time, task, change, result, numbers.

- 2026-10-10 21:17 FP-01: .gitattributes restored to `* -text` first + binary `-diff` rules (snapshot in scratchpad vnfix/snap/FP-01); `git config --local core.autocrlf false` (shared .git/config, so it also covers the rebuild worktree; that tree was not touched). Clone `git ls-files --eol`: 897 i/lf w/lf, 67 i/crlf w/crlf, 6 i/mixed, 13 i/none, 406 binary, every attr/-text, 0 i/lf w/crlf.
- 2026-10-10 21:17 FP-01: THIRD-PARTY-NOTICES.md (generated) + LF copies `LICENSE-RaspberryPi.txt` in 7 folders (3 variant dirs for assembly.step, 3 step/ dirs for pi5.step, out/source-components); vendor LICENSE.txt unchanged (sha256 4ca2d350). tests/test_third_party_notices.py: 9/9 pass.
- 2026-10-10 21:30 FP-01: tests/test_repo_eol.py 7/7 pass via run_locked (149 s): check-attr text unset + no eol/filter/encoding on every tracked and new file; 0 tracked text files with CR outside tests/eol-cr-allowlist.json (73 frozen entries = 72 r7-inherited byte-identical to d38468e + vendor LICENSE.txt; 14 of the 73 are SHA-256-bound, e.g. r7 out/build-receipt.json binds out/coupons-manifest.json, so they are kept byte-exact, not normalised); emulated autocrlf=true checkout-index of 1381 next-commit files <=4 MB: 0 changed; negative control with the 9ced753 attributes: 717 changed; r7 audit_cloud_release.py --final-release on an emulated autocrlf clone (all non-candidate files): exit 0, sources 20/20, outputs 86/86, gate docs 4/4, 35 categories, 58 gates (56 open, 2 withdrawn).
- 2026-10-10 21:30 FP-01: not touched (read-only reference): rebuild worktree still has 23 i/lf w/crlf files, all regenerated outputs written by Python on Windows (BOM-VERTICAL.*, out/*/…-checks.json, review-docs-audit.json, pi5-corrected.json …), i.e. VN-03/FP-02, not git conversion. Note for FP-02: cad/gs8-d2-v1/run_locked.py is an r7-bound source (audit FONT_SOURCES; blob e885bbca = r7); editing it to set PYTHONUTF8 would break the r7 final-release audit source binding and test_repo_eol's audit test.
- 2026-10-10 21:59 FP-02: new candidate-vertical/cv_io.py (read_text/write_text/open_text = UTF-8, LF on write; rel_posix/relpath_posix/posix = '/' paths; child_env = PYTHONUTF8=1 for Python children). Named cv_io, not `_io`: `_io` is CPython's built-in module and always wins `import _io`. Snapshot of every script before edit: scratchpad vnfix/snap/FP-02.
- 2026-10-10 21:59 FP-02: AST-driven rewrite (scratchpad vnfix/fp02/rewrite_io.py) of 76 live scripts, 241 lint violations removed (130 read_text, 78 write_text, 6 text open, 24 str(relative_to), 2 os.path.relpath, 1 subprocess text) + env=child_env() in the 5 batch runners. Each rewritten file compiles and its canonical AST equals the original's (I/O-only change); every changed diff line matched an expected pattern. Keys now posix in export_candidate.py (sources_before/sources/files), make_corrected_pi.py (before/after), update_concealed_vent_structure.py:38, docs audit entry(), guide receipt, vent_guide_support lookup key, run_shadow_checks/run_review_batch logs, package_delivery, study/measure receipts. render_review.py (Blender Python) gets explicit encoding/newline kwargs instead of the import.
- 2026-10-10 21:59 FP-02: manual: cv_io.py added to export_candidate's bound source list and to the concealed guide's bound sources (it is now in their import closure); review_docs_audit.py gained `--out PATH` (inspection without rewriting out/review-docs-audit.json; --check/exit codes stay with FP-04). Not edited: run_locked.py (r7 hash-bound, see FP-01 note; guard implemented as child_env in the runners + documented in cv_io), frozen folders (history/, routing-snapshots/, out/, vent-study/), and the 3 restored coupon reproducer scripts (structural-review/make_coupons.py, check_coupon_meshes.py, render_coupons.py; coupon-reproducer-recovery.json asserts byte-identical restoration: edited then reverted, hashes d6c04976/75ebdf75/9b7228c7 match the receipt). Frozen code that live scripts execute (hdmi300.py, rounded_wire/tube from source-verify_fps_access.py) does no text I/O.
- 2026-10-10 21:59 FP-02: tests/test_cross_platform_io.py 12/12 pass via run_locked (3.5 s): cv_io unit tests (U+201D -> e2 80 9d, no CR), AST lint of 114 live scripts clean, planted-source negative control catches all 14 violation kinds, frozen-reproducer receipt tie, 0 backslashes in any key/string of 150 JSON files + BOM CSV, planted Windows manifest caught, writer key helpers asserted, 28 literal manifest lookups in 24 scripts resolve. Negative controls: the lint finds 241 violations in the pre-edit snapshot; the key scan finds 72 backslashes in 4 Windows-produced JSON files of the rebuild worktree.
- 2026-10-10 21:59 FP-02: tests/test_windows_smoke.py 3/3 pass via run_locked (6 s): each inspect command run with -X utf8=0 and utf8=1, PYTHONUTF8 unset: identical results, no Unicode errors; structural --check exit 0; docs audit to scratch --out: identical JSON (minus generated_utc), 0 backslashes, 0 CR, committed out/review-docs-audit.json untouched; BOM --check same verdict in both modes.
- 2026-10-10 21:59 FP-02: unchanged-snapshot smoke (git archive HEAD of cad/gs8-d2-v1 + electronics/gs8-d2-v1 + pxl lock to scratch, utf8=0 = cp1252). Before (9ced753 tools): BOM --check exit 1 "Stale output", structural --check exit 1, docs audit crash UnicodeDecodeError 0x9d. After (only cv_io + 3 FP-02 tools copied in): BOM --check exit 0 (131 rows / 70 baseline lines), docs audit exit 0 with sources changed 0/0/0, 0 backslashes, 0 CR, BOM current true, 0 missing links (files missing 45/45/46 = gitignored meshes, VN-04/FP-03); structural --check stale only on its own verification_source_sha256 (the tool changed).
- 2026-10-10 21:59 FP-02: structural supplement regenerated on Windows without PYTHONUTF8: concealed-vent-structural.json differs from 9ced753 only in verification_source_sha256 (aa9e3f51 -> 5937ad8b); CONCEALED-VENT-STRUCTURAL.md byte-identical; --check now exit 0 in both modes.
- 2026-10-10 21:59 FP-02: EXPECTED binding drift in the live tree (I/O-only source edits; rebind by the next re-export, FP-03/CAD phase, never by pasting hashes): manifest 53e668d4 now sees 6/71 sources changed per variant (export_candidate, make_corrected_pi, model, official_pi5_csi, official_pi5_geometry, power_geometry); reconcile_review_evidence.py stops at ('Source mismatch', model.py) and writes nothing; 8 report rows and the USB-head, plenum, outlet, core-void, microSD, wall-probe, FPS reports show verifier/source not current; guide receipt and structural PDF receipt source bindings stale; BOM --check "Stale output: BOM-VERTICAL.md" in both modes, the only difference being the current-check note (5 bound verifiers changed), CSV identical; model.load_corrected_pi() refuses the Pi cache until make_corrected_pi.py is rerun (step 1 of the documented rebuild).
- 2026-10-10 21:59 FP-02: other runs: tests/test_repo_eol.py 7/7 (148 s, incl. r7 final-release audit on an emulated autocrlf clone), tests/test_third_party_notices.py 9/9. Found, not fixed (not FP-02): test_routes_source.py fails 2/10 identically on the unchanged 9ced753 snapshot (test_full_rigid_connectors_retained: p_usb_pi box x [-152.78, -121.78] vs expected [-153, -122]; test_frozen_mechanical_geometry_unchanged: last-digit float difference ...592006 vs ...592005, exact equality across platforms).
- 2026-10-10 22:33 FP-05: new candidate-vertical/steps.py (pure data, no CAD): STEPS = corrected build order as 35 single-purpose ops (B0 optics + bench camera-end FPC pre-mate; B2 module incl. CK1044 switch; B3 panel = encoder, knob_exp, power button + nut by deep socket only; 1 grip/tub/strap/p_grip; 2 collar_on, s_c1-3 start, gauge_in, collar_tighten (gauge home), gauge_out, camera_in, s_c4_start, lens_in, lens_float (turn-back, float check, s_c4); 3 eyepiece_in, evf_in (no matings); 4 module_staged (run lead 37/39), carrier_in, carrier_screws; 5 evf_mate (EVF HDMI up from below, EVF 5 V pair, FPC Pi end); 6 panel_prop (QT, J2), panel_in, panel_screws, fps_washer_on, fps_nut_on (socket), knob_fps_on; 7 storage_in, eyecup_on; 8 pack_in, cap_on). Each op has a `doc` for FP-06. SERVICE: 10 routes (safety, panel, storage, lens, evf, microsd, module, camera, collar, grip) from the final state with requires + reverse_of refits; CONNECTIONS: 9 cables, both ends and mating ops. MOTIONS: 32 (16 swept by verify_candidate, 10 covered by a swept reverse with superset obstacles, 6 open: base_on, grip_off, pack_in/out, cap_on/off). Obstacles derived = (present before | after) - movers - riders - named exemptions; driver_contexts() for 11 screws + 2 nuts (build + service). lint(): 0 errors.
- 2026-10-10 22:33 FP-05: verify_candidate.py (snapshot vnfix/snap/FP-05): hand-typed `paths` table replaced by steps.verify_paths(); gauge STEP loaded (manifest-bound sha) for gauge_out; new rows assembly_state/model_lint, assembly_state/tool_exclusion:centring_gauge/{gs_camera,c_cs_adapter} (records the seated overlap), motion_coverage/<id> (covered = pass if lint COVERAGE clean; open = info) - FP-04 note: 6 new info rows (open motions) + 14 new non-motion rows (10 covered, model_lint, 2 tool_exclusion, integrity/centring_gauge) + 6 new motion rows; motion rows carry movers/obstacles/exempt/state_op; result gains state_model_sha256 and scope. New --only/--out flags for partial runs (refuses --only without --out; verification.json never overwritten by a partial run). Derived vs 9ced753 obstacles: no obstacle dropped in any of the 10 legacy rows; carrier_out +14 (xt30_pair, lens_collar, s_c1-4, eyepiece, eyecup, lens, grip parts, strap, p_grip), panel_out +19 (x1203_kit, microsd, xt30_pair, usb_stick, plug reserve, lens, collar, s_c1-4, p_carrier1-2, ...).
- 2026-10-10 22:33 FP-05: tests/test_assembly_state.py 11/11 pass via run_locked (0.14 s): lint clean; final state == manifest rows of all 3 variants, gauge bound, no tool final; gauge never with camera/adapter over 290 build/bench/service states; obstacles == present - movers - riders - exempt by an independent state walk for all 32 motions; verify_candidate.py has no hand-typed id list and keeps the 10 legacy ids/knots with no obstacle dropped; register omissions (VN-22) now obstacles; corrected order chain; driver contexts (strap at p_grip, gauge at s_c1-3, no knob_fps at panel screws, lens at s_c4, nuts by socket). Negative controls: the 9ced753 order gives 13 lint errors (TOOL_COEXIST x2, ORDER x8 incl. collar->camera, lens->carrier, panel->FPS washer, MATE x2 evf_hdmi/evf_5v before pi5, CAMERA_RETAINED); single mutations caught (ORDER/CAMERA_RETAINED, TOOL_COEXIST, REFIT, COVERAGE, MOTION_SET, EXEMPT, MOTION_MISSING).
- 2026-10-10 23:01 FP-09: new candidate-vertical/print_rules.py + verify_print_checks.py; one line in run_shadow_checks.py `('print',[P/'verify_print_checks.py'])` (snapshot vnfix/snap/FP-09). The verifier is bound to manifest 53e668d4: every STL/STEP is checked against manifest files, and the manifest must not change during the run. It runs r7 checks.check_print_overhang, thin_wall, check_critical_features and unclassified_thin_spots, imported unchanged from ../checks.py (r7 checks.py/layout.py untouched). It adds three things. (1) print_bridge_direction: one raster direction per connected region; every pixel that is not a short overhang must sit on a two-ended (or anchor+hole) run of at most 30 mm in that one direction. Same layer, 45 deg, 1.0 cantilever, edge_tol, px, 8 directions and sliver filter as r7. (2) J4 wing support zones built from the J4 trial tongue rows (head z -5.05..-2.65, no -Y chamfer) with r7's own construction. (3) Candidate thin_wall loaded zones from model constants (carrier/panel/insert/J4 bosses, panel catch), and PARTS = the candidate's printed parts with the carrier added to LOAD_BEARING_PARTS. It writes out/compact-kowa_lm6hc/print-checks.json (sha 538eca53), exit 1 on any fail.
- 2026-10-10 23:01 FP-09 results (expected failures, CAD phase). print_overhang (r7 rule) 6 pass / 4 fail. Tub: both J4 wing zones used (20.21 mm2 each), 10 unsupported regions remain: 665.9 + 417.9 mm2 at the 4 plenum mouths (print z 7.6, VN-52); tab catch 48.0/16.3/15.0 mm2 at asm x -14.6..-8.2 z 78.5..86.8 (VN-53); EVF support 13.7/7.8 mm2 at x -137.7..-129.4 z 76.3..83.4; rear panel-screw landing 8.0 mm2 at x -152..-147 y 21.4; 2.8 mm2 at x -55..-54 z 0..2.5; LL insert boss 1.7 mm2 at x -7.7..-6.8 z 29..31. Carrier 1963.1 mm2 at print z 2.0 (VN-54). base_grip 102.9 mm2 at asm x -76.1..-66.1 z -5.4 (VN-57). lens_collar 11.0 mm2 at y -22.8..-18.1 z 40.2..45.4 (VN-55). print_bridge_direction: the same 4 parts fail. Tub has 10 failing regions. The plenum roof cold bay fails in its best direction (22.5 deg): 1162.2 mm2 bad, and the shortest worst run over the 8 directions is 43.8 mm (at 67.5 and 112.5 deg). The hot bay fails in its best direction (157.5 deg): 732.6 mm2 bad, worst run 47.0 mm. Along the axes the runs are 92.9 and 97.4 mm. Under r7 these roofs pass inside at 30.0 and only the mouths fail (VN-51). Carrier: 2041.7 mm2 bad, open in every direction. base_grip: 266.0 mm2 bad (r7 rule 102.9), worst run 25.7 mm with an open end. lens_collar: 11.0 mm2. Passing parts: panel 5.5 mm, cap 3.9, gauge/eyecup/knobs 0.
- 2026-10-10 23:01 FP-09 results, continued. thin_wall 9/9 pass. tub p1 1.399, min 1.199, 115 loaded samples, 0 under 1.6. panel p1 1.599, 95 loaded. carrier p1 2.592, 280 loaded. lens_collar 1.848, 256 loaded. critical_features 49 pass / 56 fail / 37 info. 44 feature rows fail with stale origin: the r7 probes sit on geometry the candidate moved (tub 21, panel 16, base_grip 4, lens_collar 3). 0 measured rows are below their floor. The 17 hood and 7 keeper rows are info (parts removed). 10 joints fail. J1, J2 and J9 cover removed parts and have no fork replacement. J3, J7, J8, J12 and J13_strap have stale probes. J4 fails only on base_sb1/sb2 head floors, because s_b1/s_b2 were removed. The carrier has no structural entry and no joint. thin_spot_classification fails on 1 spot: base_grip (-112.87,-24.96,-6.38), 0.373 mm. B-rep chords along y are 0.378/0.241/0.124 mm at x -113.07/-112.87/-112.67: a feather edge on the -Y side of the narrowed base. This is a NEW latent finding for the CAD phase.
- 2026-10-10 23:01 FP-09 tests: tests/test_print_checks.py 11/11 pass via run_locked (34 s). Fixtures: a 40 mm bridge fails both rules (min span 39.6); a 20 mm bridge passes both (19.6 mm at 0 deg); a two-arm region passes r7 per pixel but fails the single-direction rule; a declared zone is used; a stale zone fails. r7 proof: the upstream tub STL (sha 66b12c2a = r7 print-manifest) passes the r7 rule at 19.7 mm with zones 3.42/10.82/15.35/15.35 mm2 (= r7 checks.json). It also passes the single-direction rule at 19.7 mm (90 deg) with all 4 zones used. Also checked: the wing-zone formula reproduces r7's boxes exactly; J4_TRIAL equals model.build's call; the report is bound and complete; bridge rows are recomputed for the 4 failing parts. Negative control: r7's tongue boxes leave 2 regions (19.40 mm2) under the candidate's tongues. test_cross_platform_io: my files are lint-clean and manifest-key-clean; the 1 remaining failure is export_cache.py:487 os.sep (FP-03 lane file, not touched).
- 2026-10-10 23:01 FP-09 open, not done here. Fujinon/original variants: FP-13 (`verify_print_checks.py --variant ...`). The J7 required_checks (r7 check_joint_checks: j7_float, lens_support, lens_clamp, inserts) need the FP-08 rows. Re-nominating critical features for the candidate (tub/panel/collar/grip probes, carrier entries, fork joints for J1/J2/J9) is CAD/registry work; no origins were invented. The reconciler and docs audit do not know print-checks.json yet (FP-04/FP-16).
- 2026-10-10 23:45 FP-03: new candidate-vertical/export_cache.py (deterministic export helpers + bound-cache tool; CAD-free at import). STEP FILE_NAME time fixed at 1970-01-01T00:00:00 (header only, idempotent); assembly STEP colour section rewritten in canonical order; built_utc / generated_utc record `unrecorded (deterministic build, FP-03)`; manifest `sources` and `files` sorted, model.ROOT glob sorted; runtime gains `platform` (win32-amd64) and the manifest a `determinism` block; mesh JSON is now made from the saved STEP (read back, tessellate 0.07/0.15) so it can be rebuilt from tracked files; export refuses leftover files in step/stl/meshes; `--out DIR` re-exports without touching committed evidence. make_corrected_pi.py: same STEP/time treatment. Snapshots: scratchpad vnfix/snap/FP-03.
- 2026-10-10 23:45 FP-03: found while proving: (1) OCCT's XCAF writer orders the trailing colour section by memory address: two exports differed in 1358 of 1,377,609 assembly.step lines, only in the 1418 style entities (44 MDGPR, 196 STYLED_ITEM chains, 2 COLOUR_RGB); geometry entities identical. Canonicaliser (content-keyed DFS, SET lists sorted, refuses non-style records or outside references): canonical A == canonical B (66,201,162 bytes), idempotent, geometry prefix unchanged, XCAF re-read of 44 parts gives identical names/colours/volumes, 5.3 s per file. (2) Shape.BoundingBox() uses a triangulation when present: without the old in-memory tessellation 39 of 45 bbox_mm shrank (strap 0.69 mm, tub -158.0102/0.0128 -> -158.0/0.0), so the tessellation is kept before manifest.append and bbox values are unchanged (latent, not fixed: recorded bbox_mm is triangulation-inflated by ~0.01-0.69 mm; changing it would move REVIEW/structural numbers; for FP-04/FP-16 to decide).
- 2026-10-10 23:45 FP-03 proof (scratch copy of the live tree, live run_locked; committed out/ untouched): make_corrected_pi twice: pi5-corrected.step + .json byte-identical (52,035,113 bytes, 57 s each) [fixup-1 correction: that size does not reproduce and the source state that produced it was not recorded. The verifier's two fresh-clone runs on the then-current sources (autocrlf clone, PYTHONUTF8 unset, run_locked) each gave 52,030,332 bytes, STEP sha 15f13dc8..., JSON sha 3ffe761e...; the committed pre-FP-03 file is 52,030,331 bytes, sha 85fae8b0... (re-measured 2026-10-11), differing only in the normalised header. The determinism result itself reproduced.]. Final code, compact-Kowa exported twice (~275 s each, PYTHONHASHSEED random): 104/104 files byte-identical, 173,199,576 bytes (46 STEP, 10 STL, 45+1 mesh JSON, assembly.step, manifest). Fresh-clone emulation: meshes/ deleted, `export_cache.py regenerate` rebuilt 45/45 byte-identical to the manifest bindings, folder identical to the other export again, `status` exit 0. Manifest vs the 9ced753 Windows rebuild (old exporter, same machine): all 20 non-FP-03 top-level fields identical (rows, print poses, mass, COM, dims 248.834 x 72.815 x 216.821); part STEPs 46/46 and STLs 10/10 identical after header normalisation; mesh JSON 0/45 identical to the old in-memory meshes (44/45 same face count), so mesh bindings change once at the next export. Vs the committed Linux 53e668d4: 38/46 part STEPs identical after normalisation (platform float formatting, as REPRODUCTION.md found).
- 2026-10-10 23:45 FP-03 wiring: reconciler line 10 -> `EC.require_files` (tracked missing/changed: `Export mismatch`; only caches missing: `Bound cache missing`, count and rebuild command, or "predates FP-03" for this manifest) instead of a FileNotFoundError. Docs audit: `bound_cache` per variant and `guide_bound_cache` (no CAD import; `files.pass` stays false while a cache is missing, binding kept). Concealed guide builder: page 20 prints the manifest hash, not the build time; reportlab `invariant=1`; receipt time unrecorded, sources sorted, export_cache.py bound. run_shadow_checks.py: one row `bound_files` (export_cache status, compact-Kowa, no guide). REPRODUCE.md: section "Bound caches that git does not carry"; rebuild paragraph no longer says every export gets a new hash.
- 2026-10-10 23:45 FP-03 live status (`export_cache.py status`, exit 1): all three variants `cache_missing_unregenerable` (45/45/46 mesh JSON missing; tracked bound files 0 missing, 0 changed), guide `cache_missing_unregenerable` (32 pages + 45 meshes missing, PDF matches, receipt predates FP-03). EXPECTED FAIL until FP-16 re-exports: the `bound_files` batch row (exit 1); the 53e668d4 mesh bindings cannot be re-verified from the repo by anyone (in-memory Linux tessellation). Default kept: no caches committed (VN-04/VN-16 user decision).
- 2026-10-10 23:45 FP-03 tests: tests/test_deterministic_export.py 19/19 pass via run_locked (29 s): header normaliser (only the FILE_NAME time, idempotent, DATA untouched, '' quotes, OCCT 7.8 committed header); colour-section canonicaliser (two permuted sections give identical bytes, wrapping ignored, unsafe rewrites refused); binding states complete / cache_missing / unregenerable / mismatch and CLI exit 0/3/1; reconciler gate messages; cache rule == `git check-ignore` for all 387 bound paths and every other bound file tracked; live tracked bindings hold; lint (no wall clock, STEP only via the normaliser, guide invariant, tessellation before manifest.append); CAD: two subprocess exports of a 9-part coloured assembly byte-identical (STEP, assembly STEP, STL, mesh JSON) while a raw OCCT pair differs, colours survive re-read, deleted mesh cache rebuilt byte-for-byte, a non-matching rebuild never overwrites. Also: test_cross_platform_io 12/12 (after replacing an os.sep test in export_cache.py), test_windows_smoke 3/3, test_third_party_notices 9/9, test_repo_eol 7/7 (151 s, new files LF and attribute-clean), docs audit --out exit 0 (cad_imported false, 0 missing links).
- 2026-10-10 23:45 FP-03 not done: build_guide_vertical.py (superseded workflow; output folder wholly git-ignored and unbound) still prints wall-clock time; history/ manifests (reviewed-export18, angled-channel) still bind 102 absent files each (frozen, FP-04 labelling); part STEP PRODUCT names carry OCCT's per-process export counter, so a single-part re-export differs from a full export (full exports are deterministic); guide page determinism is lint-tested only (rasterizer cannot build here, VN-12). For FP-04: use `bound_cache.state` / `guide_bound_cache.state` (`cache_missing` = rebuildable) in the exit logic. For FP-16: after re-export expect `export_cache.py status --no-guide` exit 0, then rebuild and re-review the guide.
- 2026-10-10 23:46 FP-05: motion re-run (compact-kowa_lm6hc, manifest 53e668d4, verify_candidate --only motion,assembly_state --out review-2026-10-10/fp05/motions-compact-kowa_lm6hc.json, steps.py 0d1f8e2a, verify_candidate.py 0ce251cf; ~10 min CAD at 2 mm steps; verification.json untouched): 16 swept motions, 15 pass with 0.0 mm3 against the derived obstacles (fps_knob_off 42 obstacles, fps_nut 41, fps_washer 40, carrier_out 20, panel_out 31, camera_in 10, evf_in 15, storage plug 40, storage_out 41, gauge_out 10, collar_off 11, lens_out 42, eyepiece_in 14, camera_out 16, evf_out 28). EXPECTED FAIL microsd_out: straight +X hits lens_collar from dx 33.26 to 45.0, worst 72.794 mm3, 7 hits (the 9ced753 set had only tub/camera/adapter; this is the hidden hit of VN-29, fixed by the FP-12 dog-leg / user decision). assembly_state: model_lint pass (0 errors, manifest == final state); tool_exclusion gauge/c_cs_adapter pass with seated overlap 927.752 mm3, gauge/gs_camera pass (0.0); 10 motion_coverage pass; 6 open info rows: motion_coverage/{base_on,grip_off,pack_in,pack_out,cap_on,cap_off} (FP-04: add to the exact info set). Not FP-05: 6 source_binding fails = the FP-02 drift (model, export_candidate, power_geometry, official_pi5_geometry, official_pi5_csi, make_corrected_pi).
- 2026-10-10 23:46 FP-05: eyepiece path: my first declared eyepiece_in (+Y drop-in, read from the open inner seat in model.evf_support) failed on the first run (tub hits from +Y 30 to +Y 8, worst 337.942 mm3). Probe (scratch eyepiece_probe.py via run_locked): the tub rear wall closes the bore above it (hit region x -158..-155.5, y 17.2..28); -Z drop 1533.1 mm3 and +Z drop 947.7 mm3 also hit; the r7 method (+X push from behind, r7 INSERTIONS eyepiece_in (-30,0,0)->0) clears with 0.0 mm3. steps.py now declares the r7 path and the op doc says so; eyepiece_in passes (16 samples). This replaces an assumption of this session, not a candidate claim (9ced753 never stated an eyepiece path).
- 2026-10-10 23:46 FP-05: steps.py also gained describe() (per-step render data for FP-06: ops, docs, fasteners+tools, motions, cable ends, body count) and the service no_motion reasons moved into the sop() calls; derived motion/driver/state tables verified byte-identical across that refactor. tests/test_assembly_state.py 11/11 pass via run_locked after the change (adds the describe() section-order check).
- 2026-10-10 23:56 FP-05: directly affected suites via run_locked: tests/test_cross_platform_io.py 12/12 (3.9 s; steps.py, verify_candidate.py and the new test pass the FP-02 I/O lint, no backslash in the new fp05 JSON), tests/test_repo_eol.py 7/7 (150 s; new files LF, attributes clean). Files: new steps.py, tests/test_assembly_state.py, review-2026-10-10/fp05/motions-compact-kowa_lm6hc.json; edited verify_candidate.py (snapshot vnfix/snap/FP-05). Not done here: original/fujinon motion runs (FP-13/FP-16), verification.json refresh (FP-16), the 6 open motions, docs text (FP-06 from steps.describe()).
- 2026-10-11 00:28 FP-04: new candidate-vertical/evidence_rules.py (CAD-free, shared): inherited gates counted from ../out/build-receipt.json hardware_gates.gates (58 total / 56 open / 2 withdrawn, sha 2128ccea); cooler witness from the main-audit row interference pi5/cooler; power poses/queries from the power report; same_value/changed_rows (numbers within max(1e-6, 1e-9*|x|), bools/strings/None exact); KEEPOUT_MATING_PARTNERS {usb_storage_plug_reserve: pi5, usb_stick}; MAIN_AUDIT_INFO (the 18 legacy info rows) + motion_coverage/<id> for steps.py 'open' motions (6); EXPECTED_PRINT_FAILURES = {} (empty: every FP-09 failure is a CAD defect); DECLARED_HISTORICAL (3 reports + the manifest each must bind); selected_folder_findings; document number checks; evaluate_docs_audit. Snapshots: scratchpad vnfix/snap/FP-04.
- 2026-10-11 00:28 FP-04 docs audit (VN-05): exit 0 clean / 3 only rebuildable caches / 1 any failure, failure list under `verdict`; default read-only, --check (also fails if committed out/review-docs-audit.json differs), --out, --write; deterministic (generated_utc unrecorded); a missing input is a failed binding, not a traceback. New: per-variant selected_folder_findings, print-checks.json as a selected report, declared-historical bindings, guide nominated manifest vs current (guide_manifest_stale + CHECKPOINT claim), checkpoint_numbers, document_numbers, BOM export18-claim consistency, alternative verification.json listed as declared pending (FP-13). Live run (--check): exit 1, 36 failures = 7 binding (FP-02 source drift + coupon/PDF), 4 bound_files (3 variants + guide unregenerable caches, FP-16), 17 stale_selected_report (verifiers edited by FP-02/FP-05), 2 report_input, 3 cooler_witness_number (frozen manifests still carry 'Retain32.3614mm3'; source fixed, clears at re-export), bom_outputs_stale + bom_claim (both from FP-06's concurrent D2-61/V-62 BOM edit: V-62 purchase 0->1 contradicts the BOM line "every purchased selection/quantity are unchanged from reviewed export18" - FP-06/FP-14 must regenerate the BOM and reword that claim), committed_audit_stale (committed audit left for FP-16). Committed out/review-docs-audit.json NOT rewritten.
- 2026-10-11 00:28 FP-04 reconciler (VN-05/08/09/31): restructured into reconcile()/main(); every gate runs and all failures are listed; writes only with --write and only when 0 failures; --check/--out; deterministic. Adds print-checks.json as a bound case, the exact info-row set, exact print-failure set, selected-folder scan, holds and gate count formatted from source rows. Live run: exit 1, 27 failures (6 source mismatch FP-02, Bound cache missing 45, 13 Different verifier, fps dependency verify_fps_access.py, 6 missing motion_coverage info rows because committed verification.json predates FP-05, print_failures_differ). current-review-evidence.json untouched.
- 2026-10-11 00:28 FP-04 VN-09: out/compact-kowa_lm6hc/csi-access-checks.json (binds e8648073, manifest not in repo) and ventilation-checks.json (binds c392feab = vent-study/angled-channel-trial/manifest.json) moved byte-identical to history/stale-selected-reports-2026-10-10/ with INDEX.json; delivery-core-paths.json repointed. wall-probe-context.json stays (guide builder reads it, guide receipt binds it there) and is DECLARED_HISTORICAL (must bind history/reviewed-export18/manifest.json c9e1e207). All 3 variant folders: 0 findings.
- 2026-10-11 00:28 FP-04 VN-06/08/32/31 in producers: structural refresh uses ER.changed_rows (still exactly tub+panel changed, 43 unchanged), records row_comparison + inherited_gates, text gate count from source; regenerated: concealed-vent-structural.json differs only by verification_source_sha256 + the 2 new fields, CONCEALED-VENT-STRUCTURAL.md byte-identical, --check exit 0. make_bom_vertical: cooler witness from the main-audit row, D2-14F counts from history/reviewed-export18/power-service-checks.json (201/659; the typed "625" was wrong even for export18), gate count from source; BOM regenerated (CSV 1 line, MD 3 lines) and --check exit 0 at 00:05 - then FP-06 edited rows, so it is stale again by their hunk. REVIEW.md:23 and ASSEMBLY-VERTICAL.md:26 "625 queries" -> 659. official_pi5_geometry.py cooler_hold no longer types 32.3614 (provenance changes at the next export). verify_candidate.py: keepout info only with the declared partner; open_inherited_gates + inherited_gate_source from the r7 receipt. verify_print_meshes.py: rows gain manifest_file_binding, expected_sha256, within_volume_tolerance; --out. Committed print-mesh-checks.json / verification.json not rerun (FP-16).
- 2026-10-11 00:28 FP-04 CAD proof: verify_candidate.py --only interference --out scratch (171 s, run_locked): 265 pass / 7 fail / 18 info; the 18 info rows == MAIN_AUDIT_INFO exactly (pi5/usb_storage_plug_reserve 195.94 mm3 still info as the partner); the only interference fail is pi5/cooler 79.902671 mm3 (unchanged); the other 6 fails are the FP-02 source_binding drift; physical row carries the receipt source.
- 2026-10-11 00:28 FP-04 tests via run_locked: new tests/test_evidence_tooling.py 13/13 (74 s; light tree copy tests/_evidence_fixture.py: tampered source recorded as failure, guide nomination/link/625-query/gate/foreign-report all fail and are absent from the untouched copy, default and --check write nothing, --write then --check clean = deterministic, planted foreign/unbound/mis-bound historical JSON fail the reconciler which writes nothing, exact info set +/- one row, keepout partner rule, stale reports indexed); new tests/test_evidence_numbers.py 8/8 (13 s: 1.4e-13 jitter passes and exact equality would flag it, 1e-3 on volume/bbox/mass and bool/str/kind changes fail, structural end-to-end in a tree copy exits 1 'Unexpected changed components' with pi5 at 1e-3; docs + in-memory BOM/structural/reconciler outputs match source rows; generators hold no typed figures while all 5 at 9ced753 did; byte-flipped STL attribute fails on manifest_file_binding alone with watertight/bed true). Also: test_cross_platform_io 12/12, test_windows_smoke 3/3 (docs-audit exit-code assertion changed from ==0 to "same code in both locales, no traceback"), test_deterministic_export 19/19, test_assembly_state 11/11, test_repo_eol 7/7 (151 s), structural --check 0.
- 2026-10-11 00:28 FP-04 notes for other lanes: a new main-audit info row must be added to evidence_rules.MAIN_AUDIT_INFO (or be a steps.py 'open' motion) or the reconciler fails; accepted print failures go in EXPECTED_PRINT_FAILURES (keep empty); a new selected report goes in the docs audit report lists and reconciler CASES; a foreign report kept in a selected folder needs a DECLARED_HISTORICAL entry. Not done: run_shadow_checks.py still archives the previous head-check file on a refresh (producer, shared runner; left as is).
- 2026-10-11 00:45 FP-06: ASSEMBLY-VERTICAL.md sections 4-5 rewritten to the steps.py order (snapshot vnfix/snap/FP-06). New candidate-vertical/make_assembly_text.py (pure Python, cv_io, `--check`) writes 15 generated blocks from steps.py: 13 op lists (B0-B4, 1-8; 35 ops, each under its own heading) + `service-routes` (10 routes, every removal with its refit op(s), route refit in build order) + `service-matrix` (r7 ASSEMBLY s7 vs candidate: route closure, ids out, screws/nuts, cables parted, J2 cycles, refit chain). Hand text per step = details/holds only. Section 2: CK1044 nut = 1/2-inch deep socket on the bushing axis, power-button nut = deep socket on the button axis (VN-46). 5.1 matrix has both lens-change rows: same collar = closed body, safety only, 3 ids out, 4 refit ops; different collar = `collar` route: safety->lens->panel->storage->module->camera, 35 ids, 9 screws out, 7 cables parted, 1 J2 cycle, 22 refit ops (VN-42). 5.2 holds: closed-body lens swap with the r7 turn-back, grip = module out first (VN-45 default; inline junction = user decision 11), microSD (VN-29). 5.3 user decision 5 / VN-42: option A (accept) and option B (B1 camera ahead of the carrier front, B2 lip-free gauge) documented, not decided. FP-04's line-26 "659 queries" edit preserved (in my snapshot).
- 2026-10-11 00:45 FP-06: FPS-SERVICE-STUDY.md intended sequence names the steps.py ops, nut by deep socket on the bushing axis, new refit paragraph (switch with module B2; panel without FPS hardware B3; step 6 panel_in -> panel_screws -> fps_washer_on -> fps_nut_on -> knob_fps_on). Both guide builders (text/scene data only, nothing rendered): bench pages 10/13b/14 moved before step 1 as 06e/06f/06g; new 06h panel subassembly (B3); 07 grip without lock, 07b strap then p_grip; 08 split into 08 collar+gauge on the empty lip / 08b camera / 08c lens with r7 turn-back then s_c4; 09 eyepiece first, no matings; 11 run lead at staging, EVF head drawn stroke+3 mm low (-9) with the caption saying the sweep is still the 6 mm one; 12 EVF HDMI + RCY pair (step 5); 13 Pi end only; 16 panel, 4 screws, then washer / nut (deep socket) / knob; 17 drive + eyecup; 19 service rows incl. both lens changes; new 19b VN-42 options A/B; T7 deep sockets. Page calls 29 -> 33 (vertical), 32 -> 36 (concealed). GUIDE_OPS literal + RuntimeError at build time if the page order drifts from steps.STEPS; steps.py added to START_HASHES (receipt sources). Guide READMEs carry a STALE banner (VN-12) while the receipt binds older sources.
- 2026-10-11 00:45 FP-06: make_bom_vertical.py D2-61 -> "1/2 in (12.7 mm) deep socket for the CK1044 switch nut, driven on the bushing axis", V-62 -> "Deep socket for the Adafruit 1505 power-button nut, sized to the measured across-flats", purchase stays 0 (size unknown until receipt; a first try with purchase 1 made the docs audit fail bom_claim "V-62 0->1" vs export18, reverted). BOM regenerated: only those 2 rows changed (MD 168/185, CSV 55/82); make_bom --check exit 0. run_shadow_checks.py: one line ('build_order_docs', tests/test_build_order_docs.py).
- 2026-10-11 00:45 FP-06 tests: new tests/test_build_order_docs.py 23/23 via run_locked (2.4 s): generated blocks current and doc op order == steps.STEPS per heading (a swapped collar_on/camera_in makes block 'ops 2' stale and steps.lint fail); r7 checks.lens_turn_back_lint (source segment byte-identical to upstream d38468e, compiled without CadQuery) passes on ASSEMBLY step 2, steps.py step 2, the closed-body lens service text and guide page 08c of both builders, and FAILS on 9ced753 ASSEMBLY steps 2 and 7 and on 9ced753 guide page 17; no r7 LENS_HOLD_FORBIDDEN phrase; no un-negated "spanner" in ASSEMBLY, FPS study, builder literals, steps.py docs/tools, BOM rows, BOM-VERTICAL.md/.csv (fixtures: "thin spanner" caught, "never a spanner" allowed; 9ced753 ASSEMBLY 2 hits, 9ced753 BOM generator 1); every SERVICE removal listed with its refit (dropping a reverse_of makes the block stale + lint REFIT); matrix: every route once, closure cells == route_closure, both lens-change rows; VN-42 options A/B in ASSEMBLY 5.3 and guide 19b; GUIDE_OPS covers all 27 body ops plus the 2 staging ops in order, page() order and ascending labels, steps.py bound; 17 superseded 9ced753 phrases gone (each verified present in 9ced753); every scene() id exists as a manifest mesh, builder DATA key or HDMI-snapshot connector; FPS study op order; STALE banner == receipt staleness.
- 2026-10-11 00:45 FP-06 other runs via run_locked: test_assembly_state 11/11, test_cross_platform_io 12/12, test_windows_smoke 3/3, test_repo_eol 7/7 (150 s), test_evidence_numbers 8/8, test_evidence_tooling 13/13 (75 s). Docs audit --out scratch: exit 1, 33 failures, none from FP-06 (17 stale_selected_report, 7 binding, 4 bound_files, 3 cooler_witness_number, 2 report_input); bom_outputs_stale cleared. Expected drift: concealed guide receipt binds the old ASSEMBLY/FPS study/builder hashes (stale until the FP-16 rebuild, VN-12); committed out/review-docs-audit.json holds old ASSEMBLY/BOM hashes (FP-04 --check / FP-16). No new geometry check row fails. Open for later phases: VN-43 stroke+3 mm carried sweep and EVF HDMI pliers corridor; FP-07 socket clearance at both nuts and p_grip with the strap; FP-08 candidate roll_catch / j7_float (docs say not ported); user decisions 5 (VN-42) and 11 (VN-45); guide rebuild (FP-16).
- 2026-10-11 01:04 FP-12 VN-29: steps.py microsd_out = dog-leg (0,0,0)->(+X 18)->(+X 18,+Y 40) (constants MICROSD_DOGLEG_*, MICROSD_TOOL 'straight fine-tip non-conductive tweezers' named in svc_microsd_out doc, reach HOLD); ASSEMBLY service-routes block regenerated (make_assembly_text, --check current), ASSEMBLY/REVIEW/MTC prose updated; tests/test_assembly_state.py LEGACY microsd_out knots updated (ids/movers/obstacles still pinned). New rigid_sweep.py (verify_candidate sampling, crop and Pi component method). verify_microsd_service.py adds panel-off rows with the steps-derived obstacle set (31 ids) and --out. Run (run_locked, fp12/microsd-service-dependency.json, manifest 53e668d4): closed-panel REJECTED unchanged (23 hits, max 42.414 mm3); straight +X45 blocked by lens_collar from +X 33.3, worst 72.7936 mm3 (= FP-05 verify_candidate microsd_out row, so the helper reproduces the rigid row); dog-leg +X18 clear (0.0 mm3, 30 samples); window probes: +X10 carrier 15.4 mm3, +X12 clear, +X24 tub 0.453 mm3 (the review's 12-24 window is 12..<24), +X26 tub+s_c3 9.507 mm3. 4 pass / 0 fail / 2 info. Front slit closure stays user decision VN-29.
- 2026-10-11 01:04 FP-12 VN-30 wires: verify_wire_solids.py obstacles = every material row (printed+COTS+hardware, Pi via verify_candidate component set; keepout usb_storage_plug_reserve listed as the only exclusion); declared terminals per wire (x1203 root, xt30_pair fuse/housing) may be touched only in one run contiguous from that end, every run listed; planted hardware (p_carrier1) and COTS (cooler) fixtures must be detected; --out. Run (133 s, fp12/wire-solid-checks.json): pass, 44 material obstacles, 0 non-terminal hits; terminal runs: board_to_fuse end/xt30 3 pieces 0.84 mm, fuse_to_housing both end balls only, negative end/xt30 2 pieces 4.8 mm (end balls half-embedded, 9.238 mm3); fixtures 2/2 detected.
- 2026-10-11 01:05 FP-12 VN-33: new check_scope.py (CAD-free rules for FP-12) j4_lower_set/j4_screen/j4_envelope: the lower free body = steps GRIP+strap+p_grip+POWER_IDS, proved by the mass identity sum(lower)=831.379-640.429 g (residual < 1e-6 g); a variant whose lower rows change is refused. structural-review/update_concealed_vent_structure.py now computes the transfer per variant (asserts the compact value equals its own calculation) and writes coupon_load.per_variant / all_variants_screen_Nm / compact_screen_covers plus a 'Variant coverage' paragraph; JSON+MD regenerated, --check exit 0. Numbers (equal share + wiring / 70 percent): compact-Kowa 0.9309/1.3033, Fujinon 0.7641/1.0698, original-Kowa 0.9763/1.3669 N m; the 0.95 compact screen does not cover original-Kowa; covering screen 1.00 N m (governed by original-Kowa). Batch rows j4_screen/<variant> + envelope in verify_check_scope.py fail if the supplement stops stating a covering screen.
- 2026-10-11 01:07 FP-12 registration (single lines, snapshots in vnfix/snap/FP-12): run_shadow_checks.py ('check_scope',[P/'verify_check_scope.py']); reconcile_review_evidence.py CASES ('check_scope', out/compact-kowa_lm6hc/check-scope-checks.json, verify_check_scope.py) appended after microSD (CASES[8] index unchanged); review_docs_audit.py selected-report list + verifier map gain check-scope-checks.json. MEASUREMENTS-TO-CLOSE: microSD row (tweezers, dog-leg, collar-blocked straight path, slit = VN-29 decision), HDMI row (record contact-facing side of each head and ribbon convention into check_scope.HDMI_CONTACT_SIDES), airflow row (fan P-Q band needed before flow_network computes an operating point; CSI plug = VN-36 decision).
- 2026-10-11 01:09 FP-12 VN-30 HDMI: verify_hdmi.py per-state obstacle sets = 9ced753 sets UNION every material part steps.py has in the body (installed = final state 44 ids, premate = before evf_mate 37, carried sweep = before carrier_in minus MODULE 22); exclusions listed per state (only the keepout usb_storage_plug_reserve); new hard_head_vs_material rows (only the head's own receptacle partner excluded, named) and obstacle_fixture rows (1 mm cube at each interior-centroid hardware part inside the analysis crop must be detected); --out; --include-rejected diagnostics keep their 9ced753 sets (not selected service). Run (356 s, fp12/hdmi-solid-checks.json, manifest 53e668d4): 13 pass / 0 fail (was 6/0): ribbon installed/premate 0 hits (broad phase still finds no candidate solid), carried sweep 0 hits / 225 exact intersections, heads vs material 3/3 clear, fixtures p_carrier1/p_grip/p_panel1/p_panel2 detected (1.0 mm3 each).
- 2026-10-11 01:24 FP-10 (in progress): new candidate-vertical/harness_rules.py (CAD-free r7 ports: cable_routes, mate_reach, lead_access pigtail face_out with ties as fixed points + RTV-only alternative, pigtail_drop G-W5 range, cable_stow, header_housings, signal-route family consistency) + verify_harness_checks.py (manifest-bound runner, exact STEP hits/distances, tie slots confirmed in the carrier STEP, route-source/snapshot bindings) -> out/compact-kowa_lm6hc/harness-checks.json. Registered with one line each: run_shadow_checks.py ('harness'), reconciler CASES + harness_dependency + harness gate (evidence_rules.EXPECTED_HARNESS_FAILURES = {}), docs audit report lists. Orphan signal_routes_review.json (binds power_source_sha256 3b7db74a, no tracked file) moved byte-identical to history/orphan-signal-routes-2026-10-11/ with INDEX.json; delivery-core-paths.json updated. MEASUREMENTS-TO-CLOSE: QT lead, run lead, RCY pair, EVF 5 V pad rows. Snapshots in vnfix/snap/FP-10. CAD run waiting on the lock (FP-07 driver job).
- 2026-10-11 01:40 FP-12 new batch row check_scope = verify_check_scope.py -> out/compact-kowa_lm6hc/check-scope-checks.json (manifest 53e668d4, verifier/helper/input shas recorded). First run crashed on a duplicate 'posts' key (fixed: post_count); a 0.4 mm z-grid missed the post-centre plane (z 8.0) and passed the hot bay 511.2 > 510, so every post-centre plane (vent_geometry.post_centres) is now always sampled. Final run (run_locked): 30 pass / 3 fail / 14 info.
- 2026-10-11 01:40 FP-12 VN-37 area_parity (saved tub STEP, the plenum verifier's port/mouth rectangles + flow-normal series planes incl. post centres): cold 420 (rear mouth) + 426 (bottom mouth) = 846 >= 420 ports PASS (series minima 464.4 / 437.4); hot: bottom branch governed by the z 8.0 post-row section 299.4 (< mouth 324), front branch by its 210 mouth (series min 464.4): 509.4 < 510 FAIL by 0.6 mm2 (-0.12 percent) = EXPECTED FAILURE for the CAD phase; the old parallel-mouth row (534 >= 510) stays as it was. VN-36 flow_network (report only, equal-Cd orifice network, fan curve UNKNOWN so no operating point): nominal intake 670.3 / exhaust 320.1 / system 288.9 mm2 eq., CSI = 48.2 percent of intake; occlusion system-flow ratios: cold rear blocked 0.966, cold bottom 0.968, strap 20/71 0.995, hot bottom blocked 0.599, hot front 0.669, set down on a table 0.592; CSI plugged: intake -48.2 percent, system 0.815 (information for user decision VN-36, nothing adopted).
- 2026-10-11 01:40 FP-12 VN-35 hdmi_face (selected snapshot hdmi-export17-selected, installed + premate): carried strip normal continuous (frames <= 0.496 mm apart, <= 6.70 deg per frame, no formula sign change), ends exactly on both head wire exits with the normal perpendicular to exit and width: PASS; face A (outward -Z at the 3557 Pi head) reaches the 3556 EVF head facing -X, so a same-side ribbon needs EVF head contacts on the -X side, an opposite-side ribbon on +X: contact_sides rows are info/HOLD until check_scope.HDMI_CONTACT_SIDES is filled from parts (MTC HDMI row); fixtures prove pass/fail/face-B logic.
- 2026-10-11 01:40 FP-12 VN-34 evf_restraint: r7 checks.check_evf_restraint imported unchanged and run in the r7 frame (candidate evf_board/tub/panel translated by -(154-length, EY-16, 0) = -(-4,-5,0); frame check: measured translation and board spans agree < 0.05 mm), r7 limits 0.6/8 mm, arrest tub+panel (no hood), plug zone = selected snapshot p_hdmi_evf head. 8 rows side by side with r7 out/checks.json: +X 0.25 tub, -X 0.25 tub, +Y 0.30 panel, -Y 0.31 tub, +Z 0.25 tub, support_span_final 0.26 and prepanel 0.26 PASS (all equal to r7); -Z FAIL = EXPECTED FAILURE (CAD phase): PCB stops at 0.25 on the tub but the r7 'hdmi receptacle' zone also meets the tub at 0.27 (within PCB + 0.2: the stop bears on the connector, r7 passed with PCB only). Control without the panel: +Y fails (plug zone 0.53) as required. evf_face (manifest bboxes vs r7 parts-manifest, resolution 0.05 mm): axis Y 16 -> 11 (-5.0), Z 78 (0), flange -154 -> -158 compact / -185 original; eyecup protrusion behind the body +16.20 mm (33.61 vs 17.41), left (+Y) extent -2.00, right -4.40, top +0.011 (inside resolution): all 4 x 3 variants PASS (no regression vs r7; face trial remains the gate).
- 2026-10-11 01:40 FP-12 VN-38: stack_retention (r7 _hull2/_inside_margin/_max_lift unchanged; tests reproduce r7 checks.json: margin 16.7, lifts 0.15/0.189/0.131/0.1): rigid stack carrier+pi5+x1203+kit+cooler+microsd 117.60 g, CoM (-79.48, 5.05, 33.96); retention = the two carrier PT screws only -> no hull (margin None), CoM 6.11 mm off the screw diagonal (> 4.8 mm post bearing radius), rigid lift unbounded at all 4 kit bosses and 4 carrier corners: FAIL = EXPECTED FAILURE (CAD phase: third printed locating feature, no new screw). post_root_bending: both posts measured from the tub STEP at y -24.5: 72.38 mm2 (d 9.600) single face, length 42.75 single span; 5 g lateral on 129.6 g (stack + 12 g wiring sensitivity), lever 42.75 + 12.15 eccentricity: 2.01 MPa equal share / 2.81 MPa 70 percent <= 5 MPa (lowest supplement strength scenario, across layers; a screen, not an allowable): PASS.
- 2026-10-11 01:44 FP-12 tests via run_locked: new tests/test_check_scope.py 19/19 pass, 0 skipped (3.5 s; J4 lower-set identity, per-variant numbers 0.9763/1.3669, refusal fixture, supplement states 1.00; branch parity 509.4 fail fixture vs the old parallel pass; network fractions scale/Cd-free, CSI-plug identity; U-turn sign-jump fixture, selected route frames, face_match HOLD/pass/fail/face-B; r7 stack_retention reproduced from r7 checks.json, two-screw fail and three-point pass fixtures; post bending formula; r7 EVF axis/flange extraction (Y16 Z78 F-154 within 0.05) and screen fixtures; microSD dog-leg declaration + doc tool + fixture probes; wire/HDMI obstacle-set source rules; run reports bound to manifest AND current verifier: microSD, wire, HDMI (fp12/) and check-scope (out/)). Affected suites: test_assembly_state 11/11, test_build_order_docs 23/23, test_windows_smoke 3/3 (structural --check), test_repo_eol 7/7 (148 s), test_cross_platform_io 11/12 and test_evidence_tooling 12/13: the two failures are outside FP-12 (tests/test_j7_collar.py:70 subprocess text without utf-8; MAIN_AUDIT_INFO lacks the new lens_clamp/lens_support/roll_catch info rows: FP-08 lane). Docs audit --out scratch: 33 failures (unchanged count), check-scope-checks.json listed as current manifest-bound evidence with current verifier. Reconciler --out scratch: 36 gate failures, none for check_scope; power_static/hdmi/microSD 'Different verifier' = committed out/ reports predate the verifiers (left untouched; the fp12/ copies are the current runs; FP-16 refreshes). fp12/microsd report's helper steps.py sha predates a note-only edit of the microsd_out note. EXPECTED FAILURES (CAD phase): area_parity/hot_branch_series, evf_restraint/-Z, stack_retention/vertical_carrier. User decisions left documented: VN-29 slit, VN-36 CSI plug.
- 2026-10-11 01:46 FP-07 (VN-23): new candidate-vertical/driver_checks.py, a port of r7 checks.check_driver and its service-driver use (check_removals unscrew rows and layout.SERVICE_DRIVER). Tool is r7 layout.DRIVER: bit dia 6.5 x 40 from the head bearing face back, so it covers the head zone; handle dia 30 x 100 behind it. A hit is an exact OCP common above r7 VOL_TOL 0.05 mm3. Nearest gaps are computed as in r7. Contexts come from steps.driver_contexts() (FP-05): 11 screws x build + service = 22 rows. They include the strap at p_grip, the centring gauge at s_c1-3 and the other screws; r7 left s_* screws out. A context id that is not loaded fails the row unless steps.OPTIONAL names it. Each change is stricter than r7, never looser. (1) A boolean or distance that raises or returns NaN fails the row; r7 common() returns NaN, which compares False with the tolerance, so it passes silently. The fixture proves r7 passes that case and the port fails it. (2) Multi-solid shapes are tested solid by solid. (3) Screw poses are not typed: head point and axis are derived from each screw's manifest-bound STEP solid, and the head height is checked against r7 PT/M3 head_d by cross-section slabs. Coverage row driver_coverage/screws: every PT/M3 hardware row is in steps.SCREW_IDS and has a build and a service row. Nuts (fps_nut, power_nut_reserve) are not audited: the deep-socket envelope is a receipt gate (VN-46) and none is invented.
- 2026-10-11 01:46 FP-07: registered with ONE line in verify_candidate.py, after the motion loop: categories driver, service_driver and driver_coverage behind want('driver'). It runs in every full main-audit run; partial run: --only driver --out. Snapshot in vnfix/snap/FP-07. The FP-08 lane's line now follows it.
- 2026-10-11 01:46 FP-07 result (compact-kowa_lm6hc, manifest 53e668d4, record review-2026-10-10/fp07/driver-compact-kowa_lm6hc.json, driver_checks.py 8753d074, steps.py 04c84ba3): 18 of 22 rows pass; coverage passes. EXPECTED FAIL (CAD phase, FP-11c / VN-56): the 6.5 mm bit enters the 6.4 mm carrier counterbores. p_carrier1 fails by 2.432 mm3 and p_carrier2 by 0.405 mm3, at both carrier_screws and svc_carrier_screws_out; the only hit part is the carrier. This reproduces the review's DES-3 numbers exactly. Passing margins: p_panel1-4 bit 0.27 mm to the panel; s_c1-3 bit 0.5 mm to the collar counterbore, with the gauge present at collar_tighten; s_c4 bit 0.25 mm to the collar and handle 6.5 mm to the tub, at lens_float and in the closed-body loosen; p_grip bit 0.25 mm to the base_grip and handle 1.37 mm to the STRAP (r7 2.35; VN-78 load test stays open). All 11 derived poses equal model.py's declared poses. The first run (813 s) and the re-run (805 s, after an exact branch-and-bound for the nearest gaps) give identical rows apart from -0.0 axis signs, now normalised. Total run time is about 13.5 min. Most of it is booleans and distances against the tub; the build and service rows of one screw recompute the same tool against the same parts, so a later speed-up could memoise them.
- 2026-10-11 01:46 FP-07 tests (all via run_locked): new tests/test_driver_checks.py 18/18 OK (5.8 s). Counterbore fixtures: 6.0 mm fails (bit 14.726 mm3), 6.4 mm fails (3.040), 7.0 mm passes (bit gap 0.25). r7 parity: hits, volumes, nearest and status match r7 check_driver on the counterbores, a handle-only wall, a two-solid compound and a three-part nearest case. A raising boolean passes r7 and fails the port. Poses: r7 cots PT/M3 (washer, inserts) in 6 axis directions, r7 s_c1/s_c4/s_j and model.pt_screw; a headless cylinder and a wrong kind are rejected. Contexts equal steps.driver_contexts(); a missing context id fails; coverage negative controls pass. Registration is one want('driver') line after the tools load. Record test: binds the current driver_checks/steps/manifest. It caught the stale record after the branch-and-bound edit (negative control), and asserts exactly the 4 carrier failures with their volumes and the 1.37 mm strap gap. Affected suites: test_assembly_state 11/11 OK, test_evidence_numbers 8/8 OK, test_repo_eol 7/7 OK (144 s). test_cross_platform_io 11/12: the one failure is tests/test_j7_collar.py:70 (subprocess text, FP-08 lane); driver_checks.py and test_driver_checks.py are clean. test_evidence_tooling 12/13: the one failure is test_exact_info_set, 8 FP-08 info rows (lens_clamp, lens_support, roll_catch) missing from the committed verification.json; not FP-07.
- 2026-10-11 01:46 FP-07 open, not done here: (a) Once the main audit is refreshed (FP-16), the reconciler's "only pi5/cooler rigid fault" assertion will fail on the 4 carrier driver rows until FP-11c opens the bores to 7.0 mm. That is the intended state; do not accept these rows. (b) original-kowa and compact-fujinon driver runs are left to FP-13 (verify_candidate --variant ... --only driver). (c) The X1203 M2.5 stack screws are bench-driven inside the x1203_kit proxy; they are not modelled screws and get no driver row. [fixup-1 correction, was 'Closed: VN-23.'] Check ported and registered (want('driver')); VN-23 closes only after the FP-13 variant runs (verify_candidate --only driver for compact-fujinon and original-kowa) and the FP-16 main-audit refresh carry the rows. VN-56 is now caught by the ported check (expected fail; the CAD fix is FP-11c). VN-78: the computed strap part is covered (1.37 mm); the physical load test stays open.
- 2026-10-11 01:53 FP-10 results: verify_harness_checks.py via run_locked -> out/compact-kowa_lm6hc/harness-checks.json (sha 0fff85c3, manifest 53e668d4): 25 pass / 10 fail / 20 info. Every STEP opened is hash-checked; manifest source drift (6 FP-02 I/O-only sources: export_candidate, make_corrected_pi, model, official_pi5_csi, official_pi5_geometry, power_geometry) is a recorded info row (fails only if a harness dependency drifts), not a raise. signal_routes: family_qt/run_pin37/run_pin39 recompute the recorded 250.000 mm from their own knots, binding pass (power snapshot 4b2eaa91 = manifest source = power_routes mechanical_snapshot; junction pose and 201 rigid poses equal to 1e-9), orphan_report_archived pass, tie_slots_in_step pass (4 slots open, both flanks in carrier material).
- 2026-10-11 01:53 FP-10 expected failures (CAD/docs phase or user decision, all honest): cable_routes qt (family minimum at the solver bound low=50: 239.14 + allowance 25 > 240 minimum; branch fan-in gap 8.55 mm, pin 6), usb_5v and pack_lead (no current installed route), pigtail_positive / pigtail_negative (shortest route with the stored hump drawn out 251.8 / 250.9 + r7 allowance 27 > 270). mate_reach qt_enc: lanes secured at evf_mate before panel_prop (steps.py), loop at its family minimum: fixed 214.9 + tail 64.8 + margin 24 = 303.7 vs 240 -> short 63.7 mm; no prop offset reaches; free-lead alternative needs 165.9 (info, not the documented order). xt30_pack fails on reach only (hand box clear, out_of 0.0, pack hangs 18 mm lower on its 60 mm lead, slack 10). lead_access pigtail_ties_on_route: no slot within OD/2 + band 2.3 mm of a core (nearest positive 31.76, negative 4.89 mm); pigtail_xt30_mouth (ties as fixed points, worst slot as drawn): positive none / negative -53.5 mm face out, best-case straight lower bound 32.1 / 37.3. RTV-only alternative (info, VN-47 decision data) on the candidate's own front-bypass service corridor (routes.pigtail_16_study, the study computed only the negative root): positive 12.86 mm (< 15: its 6.3 mm root stub), negative 17.47 mm. pigtail_drop (VN-62): lo 0.14277 V (= the BOM hot_drop model), hi_cold_fuse 0.15103, nominal_hot_fuse 0.15427, hi 0.16254 V > 0.150; decision data: max finished path 225.4 mm (hot fuse) / 266.3 (cold), 14 AWG nominal 0.13245 V (lane fit unchecked), cut-off raise 12.5 mV needed; vendor PRC page read: over 250 x 0.08 mm strands.
- 2026-10-11 01:53 FP-10 passing: run_pi_37/39 (module staged at carrier_in +70 mm, anchor at the floor-hole riser top: slack 122.7/122.2, reach to 210.8/210.6 mm offset, hand and tail clear by exact STEP Booleans), j2_btn (junction placed 45.5 mm out so the pinch box clears the opening; needs 139.4+35.0 / 146.9+27.5 mm for either gender assignment, both feasible from V-28 tails), cable_routes run (214.31/209.54 + 25 <= 250, MP-RUN), fpc, fan, oled_flex, power_button; cable_stow qt (family max 271.14 >= 260), run; info spares fpc 87.1, J2 97.6, fan 22.1, oled 21.9 (no named home, r7 semantics); header_housings 7/7 (COTS gaps 0.54-0.75 mm by box; hdr_qt_6 vs the rotated xt30_pair box -2.0 refined by the exact proxy solid to 15.72; tub exact 5.43-7.97).
- 2026-10-11 01:53 FP-10 tests via run_locked: new tests/test_harness_checks.py 21/21 (84 s): r7 constants/helpers equal checks.py/layout.py; family bounds are signal_routes literals, minima 239.14/214.31/209.54; QT, run lead and J2 halves shortened 10 mm fail mate_reach; pigtail 10 mm shorter loses 9 mm of face out; slot moved onto a core is on route; retention switch moves the gate; drop low end = BOM model, hot fuse fails, cold 225 mm passes, 230 mm hot fails; header overlap / COTS-on-housing and longest-lead-beyond-family fixtures fail; bound report bindings, numbers reproduced CAD-free, failing set == documented expected set; registration and orphan archive. Also test_cross_platform_io 12/12, test_evidence_numbers 8/8, test_evidence_tooling 13/13 (77 s), test_repo_eol 7/7 (146 s). Reconciler --out scratch: report:harness and harness_dependency clean, failures listed as harness_failures_differ (EXPECTED_HARNESS_FAILURES stays empty). Docs audit --out scratch: harness-checks.json 'current manifest-bound scoped evidence', 33 failures as before (none new).
- 2026-10-11 01:53 FP-10 open / not done: VN-47 docs part (record the no-tie departure in REVIEW) and both decisions (VN-47 ties vs RTV, VN-62 G-W5 branch) stay with the user; r7 pigtail_range/store/lanes/run_lead_window/wrap_clear not ported (one fixed 270 mm allocation at one assumed pad, no keeper or taped lanes; pigtail_pad_range info row says so); other variants refused by the verifier until their routes are solved (FP-13); full run_shadow_checks batch not run (standalone verifier run instead).
- 2026-10-11 02:00 FP-08 (VN-24): new candidate-vertical/j7_collar_checks.py (CAD-free at import). It calls r7 ../checks.py unchanged: check_j7_float, check_roll_catch, check_lens_support, check_collar_gauge, check_lens_clamp and check_inserts. Inputs: the candidate layout context (model.py import edits + JG.trial_layout + L.LENS + model.collar_setup, restored on exit) and rows from the manifest-bound STEPs (multi-solid rows split into id#k). The two r7 test_mechanical_refinements washer tests are added as computed rows. Wiring: one line in verify_candidate.py (`want('j7')`), one line in evidence_rules.expected_main_info (8 FP-08 info rows, same pattern as the FP-05 motion_coverage rows), and a one-line extension of the last assertion of tests/test_evidence_tooling.py test_exact_info_set (FP-04 lane; it pins expected_main_info - MAIN_AUDIT_INFO). Snapshots in vnfix/snap/FP-08.
- 2026-10-11 02:00 FP-08 candidate adaptations (each is stated in its rows; none is looser than r7). (1) Centring: r7 adds HOOD_TO_TUB_LATERAL to hood obstacles only. Here it goes to the side panel (cover catch, 4 PT screws) as a stand-in, 0.25. The tab catch is part of the tub, so it gets no location term. (2) Roll catch: the catch host is the tub, passed under the r7 key 'hood' and renamed back afterwards. Catch top is 98.0 (pinned to the model.py source). Tine root = tub roof underside measured on the STEP, z 97.5; the slot boss at z 87.23 is not credited. The window now measures metal to the whole tub. COTS boxes are kept only where the r7 box still encloses the STEP solid; pi5, cooler, x1203, x1203_kit, encoder, xt30_pair and microsd were dropped as moved. Lens-hold records come from steps.py (lens_in, svc_lens_out). Lint covers the steps.py texts, ASSEMBLY-VERTICAL.md and both guide builders. (3) Gauge: r7's "hood >= 0.5" becomes ">= 0.5 to every part present at gauge_in" (steps.py), with the insertion sweep against those parts too. (4) Context rows: the STEP collar equals the rebuilt collar, the STEP camera equals gs_camera_parts(s_nom), and the rebuilt Fujinon collar equals the compact-fujinon STEP. All three give 0.0 mm3.
- 2026-10-11 02:00 FP-08 results. compact-kowa_lm6hc, manifest 53e668d4, `verify_candidate.py --only j7 --out review-2026-10-10/fp08/j7-compact-kowa_lm6hc.json` (record sha 3b33dd01; j7_collar_checks a68713b9; roll scan 69.8 s, 33254 booleans). 169 FP-08 rows: 157 pass, 8 info (exactly INFO_ROWS), 4 fail. The other 6 audit fails are the FP-02 source_binding drift.
  - j7_float: 50/50 pass over s 0..3 at 0.25 steps plus s_nom. Per-obstacle minima: tub overall 0.4 (body axial at s 0, rule 0.4, same as r7), lateral 0.75 (bfar). Panel axial 0.5 (body at s 3.0), lateral 5.45. Carrier 2.16. lens_collar 3.483. power_nut_reserve 4.479. microsd 4.756. s_c4 9.329. Adapter lateral 0.825.
  - Centring remainders: body/tub 0.9, bfar/tub 0.45, adapter/tub 0.525, body/panel 4.9 (after the 0.25 term). The lens touches only the collar; lens_vs_camera passes 13/13.
  - roll_catch: 58 pass. Metal first meets the tub tab catch at 1.758 deg at every s, declared and one-head. Window: centred 0.4, worst 0.129. Tine: 6.88 MPa, 0.047 mm, arm 17.59. Axial engagement 1.4. Lens hold and lint pass.
  - lens_support: 41 pass, 5 info. Centring gauge: 8/8 pass.
  - lens_clamp: polygon margin 14.433 (r7 16.012); bolted-only -3.264 (info, M1). Anchor bound: Kowa 50.2 N (info, M_sep below the 5 g moment), Fujinon 25.3 N, Computar 86.1 N. Inserts: 4/4.
  - EXPECTED FAIL until FP-11d (VN-55): washer_flat_support kowa + fujinon, 0.0165 mm3 = 0.33 mm2 unsupported (the footprint r 3.9 runs 0.2 past the lug face). washer_free_seat kowa + fujinon, 0.1564 mm3 overlap at dy +0.2 (nominal relief margin 0.0; the r7 collar has 0.3 at the same float).
- 2026-10-11 02:00 FP-08 r7 test_mechanical_refinements.py on the candidate collar values: new tests/test_collar_r7_mechanical.py runs the r7 class unchanged inside the candidate context. Result: 15 tests OK, 3 expected failures. Two are the washer tests (VN-55). The third is test_print_stock_is_exactly_three_removable_membranes: r7 printed_collar.prepare_print (fuse + clean) raises "removed finished material" on the candidate Fujinon collar (Kowa passes). The candidate prints through model.collar_print_stock instead, and a new test holds that path to the r7 contract for both lenses (added 5.44752 = expected, lost 0.0); it passes. FOUND (latent, not in the register): after prepare_print has run on a shape, model.collar_print_stock rejects that same in-memory Fujinon shape ("Invalid collar print union"); a fresh shape passes. The test now gives each test its own copied collars. r7 baseline test_mechanical_refinements.py: 12/12 pass.
- 2026-10-11 02:00 FP-08 tests via run_locked. New tests/test_j7_collar.py 14/14, 39 s. It covers: registration; CAD-free import; source pins; centring, minima, alias and emit units; lens records and turn-back lint, with mutation; a planted bump 0.3 from the housing fails the body row (min_lateral 0.3); a panel#9 bump at 0.6 passes r7's 0.5 rule but fails the centring row (0.05 < 0.1); a hole cut in a tine is caught by catch_material; tine root 97.5; a part 0.3 from the seated gauge fails; the washer rows fail on the candidate collar and pass on the r7 collar; and a record check (manifest, source sha, failing set == the 4 washer rows). Directly affected suites: test_cross_platform_io 12/12, test_assembly_state 11/11, test_driver_checks Registration 1/1, test_evidence_tooling 13/13 (76 s).
- 2026-10-11 02:00 FP-08 not done here. Fujinon and original-storage runs belong to FP-13 (`verify_candidate.py --variant ... --only j7`). The verification.json refresh belongs to FP-16; the reconciler will report the 8 FP-08 info rows as missing until then. FP-09's J7 joint (verify_print_checks) can now read these rows. Tine printability is VN-53 / FP-11b; roll_catch passes in use.
- 2026-10-11 02:23 fixup-1 FP-03/FP-01 (major): export_candidate.py now writes LICENSE-RaspberryPi.txt itself (out/<variant>/ and step/, LF vendor bytes b8c5ff87, both bound in meta['files'] from the next export) and runs the stale-file check as a pre-flight on the planned names (new export_cache.planned_export_files / leftover_files / write_licence_copies) before any write; post-check written==planned. New tests/test_export_plan.py 6/6 (real out/ folders: 0 leftovers for all 3 variants; negative control with the old plan reports step/LICENSE-RaspberryPi.txt for all 3; clean --out folder meets the third-party-notice rule).
- 2026-10-11 02:39 fixup-1 FP-05/FP-06 (majors): steps.py strap_thread moved before tub_on (strap's over-bridge pass lies in the 2 mm base-top recess the seated tub floor closes; r7 order); ORDER_RULES + ('strap','tub'); base_on open_reason names the strap. Refit model: steps.route_refit (moved from make_assembly_text, which now delegates), refit_sequence, text_refit_ids, lint_refit (REFIT_PRECONDITION, REFIT_ADD_PRESENT [xt30_pair proxy re-add exempt with reason], FASTENER_ABSENT, ORDER, CAMERA_RETAINED, POWER_LAST, REFIT_INCOMPLETE, TOOL_COEXIST), all_states yields phase 'refit', motion_table obstacles = union over build + every refit occurrence (new refit-only obstacles: camera_in +EVF/eyepiece/eyecup/s_c4, gauge_out +EVF/eyepiece/eyecup, evf_in +module parts; covered motions still COVERAGE-clean). Camera route requires reordered to panel,storage,module,lens (service CAMERA_RETAINED lint). ASSEMBLY s5 rule replaced by the whole-chain rule; per-route lines now render the whole-chain refit. lint() == []. Negative controls: strap after tub -> ORDER; old literal refit rule -> POWER_LAST for module/camera/collar/grip and REFIT_PRECONDITION (collar lens_float without camera/lens); collar route without camera -> TOOL_COEXIST at refit gauge_in; old camera order -> CAMERA_RETAINED at svc_carrier_out. New tests/test_refit_state.py 14/14.
- 2026-10-11 02:39 fixup-1 FP-05/06 (minors): evf_mate secures only pigtail/run/18-24/EVF leads (new op field secures; lint SECURE_BEFORE_MATE/SECURE_ID/SECURE_DUP; steps.secured_at/secured_before); QT and J2 stay free until panel_in. harness_rules mate_reach: lead_state from steps; a lead free at the mating op fails until an obstacle-checked free-lead route exists (FP-10 HOLD), secured-lane problems kept with a label (qt_enc stays fail). Guides (both builders): pages 07 = grip_prep+strap_thread (tub off), 07b = tub_on+grip_lock; scenes 08b..17 add strap, 16/17 add lens/s_c4/microsd, 16 uses EVF_IN (eyecup was drawn before step 7); page 09 draws the eyepiece -30 X with a +X arrow. guide/STEP-REVIEW.md rows follow the new page set. New tests/test_guide_scenes.py 3/3 (negative control on the pre-fix builder: 7 pages flagged incl. page 16 eyecup early, lens/microsd/strap missing).
- 2026-10-11 02:44 fixup-1 FP-04 (minor): export_cache.guide_report now binds every guide-receipt 'sources' entry (relative to cad/gs8-d2-v1; new export_cache.source_bindings) and evidence_rules.evaluate_docs_audit fails ['binding', guide receipt, 'sources', ...] on drift. Live: 197 sources, 0 missing, 44 changed (verifier counted 43 before this fix-up's edits). Tests added to test_evidence_tooling: structure (guide source drift -> exit 1, exact failure row) and fixture (tampered guide/software_lineart.py listed in guide sources.changed, absent from the untouched copy).
- 2026-10-11 02:44 fixup-1 FP-04 (VN-08, minor): typed inherited-gate counts removed from model.py (manifest state now names the r7 receipt, no number), official_pi5_assembly.py and verify_shadow_usb_head.py ('All inherited r7 physical gates and M1'), both guide builders (pages + receipt 'physical_gates' format GATES_OPEN = evidence_rules.inherited_gates()['open']; the concealed builder binds evidence_rules.py and ../out/build-receipt.json in its sources), both guide packagers (readme formatted from evidence_rules) and structural-review/build_shadow_structural_pdf.py (text and its PDF text check use GATES_TEXT). test_evidence_numbers GENERATORS lint extended to these 8 files plus a 'baselineNN and M1' pattern; all 13 generators clean now and every 9ced753 version still has hits (negative control). Outputs of these generators (manifests, Pi receipt, USB-head report, guide, structural PDF) are rebuilt in FP-16.
- 2026-10-11 fixup-1 FP-03 (VN-17, minor): make_shadow_plenum_coupon.py (generated_utc now EC.UNRECORDED), verify_fps_contact_pad.py and verify_fps_pair_guide.py write their receipt-bound STEPs through EC.export_step. test_deterministic_export ExporterLint widened: every live script writing a STEP is normalised or in RAW_STEP_WRITERS (16 entries, each with its reason; stale entries fail; the allowlisted writers' literal STEP names are not bound in out/fps-service-study/fps-final-source-receipt.json). REPRODUCE.md names the rule. ExporterLint 4/4. The committed coupon and FPS-study STEPs/receipts predate this and need the FP-16 re-run (scripts changed: their verifier/source bindings go stale).
- 2026-10-11 fixup-1 FIX-LOG corrections in place (marked 'fixup-1 correction'): the FP-03 make_corrected_pi size (52,035,113 bytes not reproduced; verifier fresh-clone figures and the re-measured committed file recorded) and the FP-07 'Closed: VN-23' (VN-23 stays open until the FP-13 variant driver runs and the FP-16 main-audit refresh).
- 2026-10-11 03:02 fixup-1 FP-05/06 (latent, found while fixing): the grip route refit still re-threaded the strap with the tub on (grip_prep -> strap_thread under the closed recess). steps.TRAVELS_WITH {'strap': base_grip host, tub blocking}: lint ORDER in lint_refit (the strap may re-enter only together with base_grip) and SERVICE_TRAVEL (the strap leaves only with base_grip); svc_grip_off doc + text refit say the strap stays threaded in the removed base and returns with it. Negative controls in test_refit_state (15/15).
- 2026-10-11 03:02 fixup-1 FP-12 (VN-30, minor): new wire_terminal_rules.py (pure): each terminal run is bounded by a snapshot-derived max entry (x1203 root: cores[].unmodeled_root_joint_allowance_mm; fuse: snapshot fuse start->end; housing: junction_housing_original_box longest edge), each with a named gate; runs from both ends of one part must not meet. verify_wire_solids.py uses it (row fails on any terminal problem) and adds fixture_buried_xt30_wire (a wire inside xt30_pair end to end must fail the rule). tests/test_wire_terminal_rules.py 5/5.
- 2026-10-11 03:02 fixup-1 FP-12 (binding, minor): evidence_rules.dependency_mismatches (helper_source_sha256 / input_sha256 / state_model_sha256 / terminal_rule_source_sha256); tests/test_check_scope.report() now FAILS (not skips) a report that binds the current manifest+verifier but has a stale helper/input; reconciler gate check_scope_dependency over check-scope, wire and microSD reports.
- 2026-10-11 03:02 fixup-1 FP-12 (VN-36, minor; VN-36 stays open): flow_network/baseline_drift row (check_scope.flow_drift vs review-2026-10-10/fp12/flow-network-baseline.json, 8 cases x 5 fields from the FP-12 run on 53e668d4, rel_tol 1e-6) can fail; a deliberate CAD change must rewrite the baseline with a reason. Tests: halving cold ports or +20% CSI fails.
- 2026-10-11 03:02 fixup-1 FP-10 (minor): harness_rules.apply_member_clearance: the bound family members behind cable_stow 'loop' and cable_routes family-minimum passes are swept as cable-OD capsules (RDP 0.1 mm, diameter +0.2, cylinders + joint cubes) against the closed-camera material (own end parts exempt, r7 rule); a hit fails the row. collect() now carries od_mm (qt 3.2, run 1.6). Fixture tests (TestFamilyMemberClearance 2/2).
- 2026-10-11 04:11 fixup-1 records regenerated via run_locked (compact-kowa, manifest 53e668d4; steps.py, harness_rules.py, check_scope.py, evidence_rules.py, verify_wire_solids.py changed): out/compact-kowa_lm6hc/harness-checks.json (20 pass / 15 fail / 20 info; new fails: cable_routes + cable_stow run_pin37/39 member capsules hit the tub 64.87/38.71 and 58.90/37.27 mm3, mate_reach j2_btn free lead; qt member clear, 91 pieces); out/compact-kowa_lm6hc/check-scope-checks.json (31/3/14, same 3 expected fails, flow_network/baseline_drift pass 8 cases, deps current); fp12/wire-solid-checks.json (pass; runs 0.84<=20.0, 0.0<=20.0, 0.0<=26.0, 4.8<=26.0 mm; fixture_buried_xt30_wire detected); fp12/microsd (closed panel REJECTED, unchanged); fp07/driver (175/11/8: the 4 expected carrier counterbore fails + 7 source_binding drift); fp08/j7 (313/11/16: the 4 expected washer fails + 7 source_binding); fp05/motions (16/16 motions pass incl. camera_in now 16 obstacles, evf_in 28, gauge_out 15; covered 10 pass, open 6 info); fp12/hdmi (13 pass). Source_binding drift is now 7 files (+export_candidate.py, official_pi5_assembly.py from this fix-up): FP-16 re-export.
- 2026-10-11 04:11 fixup-1 FOUND (latent, open, route/CAD phase): the run-lead route itself intersects the tub, not only its bound members (probe fixup_probe_runlead.py via run_locked): recorded run_pin37 35.88 mm3, run_pin39 25.34 mm3 with a 1.8 mm capsule (OD 1.6 + 0.2) - the floor lay has its centreline at z 4.9 on the floor face (11.6 mm3 per lead) and the riser at x -12/-14 runs in tub material. QT clear at recorded value and both bounds. Not fixed here (signal_routes re-route or tub channel = route/CAD phase); the harness rows fail visibly.
- 2026-10-11 04:11 fixup-1 tests via run_locked, all OK after the record refresh: test_harness_checks 24 (failing set updated to the new computed fails, stricter), test_driver_checks 18, test_j7_collar 14, test_check_scope 21, test_assembly_state 11, test_build_order_docs 23, test_refit_state 15, test_guide_scenes 3, test_evidence_tooling 15, test_cross_platform_io 12, test_print_checks 11, test_wire_terminal_rules 5, test_export_plan 6, test_deterministic_export 20, test_evidence_numbers 8, test_third_party_notices 9, test_repo_eol 7. Docs audit --out: exit 1, 34 failures (binding 8 incl. the new guide-receipt sources row, bound_files 4, stale_selected_report 17, report_input 2, cooler_witness_number 3). Reconciler: exit 1, 38 (36 before: +1 source_binding file, +1 new check_scope_dependency on the pre-FP-12 selected wire report). All remaining failures are FP-16 rebuild items or computed CAD-phase fails.
- 2026-10-11 04:11 fixup-1 incident: TaskStop left the first regeneration shell running, so two batches overlapped for ~5 min (serialised by run_locked; log lines interleaved). The overlapping runs were superseded: every record above comes from the second batch, started after the last steps.py edit.
- 2026-10-11 05:30 phase1-closeout: full run via run_locked (runner + logs: scratchpad vnfix/closeout; before-images of 214 text evidence files: vnfix/snap/phase1-closeout). Phase-1 tests 19 files / 240 tests all OK before the batch (3 marked expected failures in test_collar_r7_mechanical). r7 suite: test_r3_regressions 82/82, unittest list 73 OK (4 POSIX skips), audit_cloud_release --final-release pass (20/20, 86/86, 4/4, 35 categories, 58 gates 56 open / 2 withdrawn). Inspect before: BOM --check 0, structural --check 0, docs audit 1 (34), reconciler 1 (38), export_cache status 1.
- 2026-10-11 05:30 phase1-closeout batch: run_shadow_checks.py (runner 15238fc4, manifest 53e668d4, 47 min) wrote out/compact-kowa_lm6hc/review-check-run.json: exit 0 = mesh (10/0), build_order_docs, csi, power_static (pass, 44 obstacles), hdmi (13/0/0), usb_head, microsd (closed path REJECTED); exit 1 = bound_files (cache), print, harness (20/15/20, byte-identical), rigid, check_scope (31/3/14, byte-identical), and power_rigid / fps / void refused on changed manifest sources (also plenum and outlet run separately: Source-stale export). Main audit 481 pass / 16 fail / 32 info, 20 categories, 529 rows; fails = pi5/cooler 79.902671, 7 source_binding, driver+service_driver p_carrier1 2.432 / p_carrier2 0.405 mm3, 4 lens_clamp washer rows; info set == expected_main_info(); microsd_out dog-leg 30 samples 0 hits. Refreshed in place: verification.json, print-checks, print-mesh-checks, csi-source-tool-checks, hdmi-solid-checks, wire-solid-checks, microsd-service-dependency.
- 2026-10-11 05:30 phase1-closeout post-batch: test_cross_platform_io 11/12 (the batch's usb_head report held this machine's absolute Windows path: verify_shadow_usb_head.py:88 manifest_path=str(mp), VN-10) -> committed report restored byte-for-byte from history/head-checks (sha abd3a4d1), batch copy kept in scratch only; then 12/12. test_evidence_tooling 14/15 (test_exact_info_set held the committed audit to the static 18-row MAIN_AUDIT_INFO, true only for the 9ced753 audit) -> its three assertions now use ER.expected_main_info(), the reconciler's gate set (extra and missing rows still fail; snapshot vnfix/snap/phase1-closeout/tests); then 15/15. BOM --check went stale (it quotes the main-audit binding) -> make_bom_vertical.py regenerated, one BOM-VERTICAL.md line changed, then exit 0. Final: docs audit 1 (27: binding 8, bound_files 4, stale_selected_report 11, checkpoint_number 1, cooler_witness_number 3), reconciler 1 (18: source_binding 7, export_files 1, report verifier 6, fps_dependency 1, rigid "new active rigid fault" = the 16 expected rows, print 1, harness 1), cache status 1; candidate's own test_routes_source.py 8/10 (same 2 as on 9ced753).
- 2026-10-11 05:30 phase1-closeout: wrote review-2026-10-10/PHASE1-STATUS.md: 84 entries = 22 closed, 19 check fails by design, 18 open for phase 2, 7 user decision, 18 hardware; expected-failure list; phase-2 work incl. ported-check failures with no FP-11 step (VN-34 evf_restraint -Z, VN-37 area parity, VN-38 stack_retention, run-lead/QT/pigtail routes, critical_features re-nomination, small tub regions, VN-43 carried sweep margin).
- 2026-10-11 06:10 D1 FP-14 (VN-61, VN-63, VN-64): new candidate-vertical/wiring_data.py (pure data: J2 family default + alternatives, JUNCTIONS, junction_family / shared_family_pairs, WIRE_SKUS, SPARES, BUY_SPLIT, GATED, LEADS, HEADER) and make_wiring_vertical.py (CAD-free generator, `--check`) -> new WIRING-VERTICAL.md (303 lines, sha 61b935f5): block diagram, J8 + J2 + I2C tables, junction table with families read from the BOM SKUs, J2 family section, harness schedule for all 11 leads (both ends, conductors/colours, polarity, BOM lines + SKUs, stock length and tolerance from harness_rules.CABLES, installed / shortest + allowance / slack from routes.build() + harness_rules.cable_routes_rows, plug op/step from steps.CONNECTIONS, service partings from steps.SERVICE, bound harness-report rows), polarity rules, build plug order (steps.STEPS), service unplug order (steps.SERVICE), G-W5 drop from harness_rules.pigtail_drop_row, open items. It states that it supersedes r7 electronics/gs8-d2-v1/WIRING.md sections 2 and 5-7 for this fork (r7 sections 4, 8, 9 still apply); r7 WIRING.md itself is not edited (r7 file). Port naming: the doc and ASSEMBLY say upper USB2; the stale "corrected lower USB2" string in routes.py build() (usb_5v/fpc superseded-route error) is flagged in the doc and left to the usb_5v route owner (FP-11f / VN-60); not edited here (route source, harness dependency). Generated from the current route sources: H1/H2 had not logged here, so the FP-16 refresh regenerates (`make_wiring_vertical.py`, then `--check`). Snapshots: scratchpad vnfix2/snap/D1.
- 2026-10-11 06:10 D1 FP-14 J2 (VN-63): BOM V-28 now a keyed 2-circuit wire-to-wire set of a family no other junction uses; DEFAULT PENDING USER DECISION 13 = Molex Micro-Fit 3.0 class (3.0 mm pitch, polarized, positive latch, factory pre-crimped leads, no crimp tool); socket half on the Pi J2 pads, pin half on the switch; each lead >= 231 mm (the longest 9ced753 V-28 tail upper bound 225 + 6, so harness_rules j2_btn halves 150/225 +/- 6 and CABLES power_button 363-387 mm stay lower bounds of what is bought: 2 x 231 = 462 >= 387). Part numbers are NOT invented: the SKU is a class "recorded at order after user decision 13"; housing size, mated length, stow and placement stay G-V-POWER (VN-73), plus a try-mate matrix gate on receipt. Alternatives listed with their gates (JST SM 2.5 mm needs a try-mate proof vs the RCY pair; PicoBlade 3-circuit blanked rejected by the conservative family rule; labels only rejected by VN-63). I-28A..D included rows renamed to the set's housings and pre-crimped leads (still 2 housings + 4 contacts; solder joints stay 24). make_bom_vertical.validate -> validate_fp14: no two JUNCTIONS (evf_5v D2-23, fps_1824 D2-27, j2 V-28, xt30 D2-14) share a mating family whatever the circuit count; an unidentified family fails. Docs: ASSEMBLY B2 items 1 and 3 and the s5 lane sentence (lanes now stated as NOT qualified, a hold point), REVIEW power-control paragraph and references, MEASUREMENTS-TO-CLOSE 1505/J2 row (try-mate matrix, V-62 set by the measured across-flats), README (WIRING + buy view links), REPRODUCE (`make_wiring_vertical.py --check` inspect command).
- 2026-10-11 06:10 D1 FP-14 BOM (VN-64): D2-26 black SKU = PRC SW-16B (store product record https://www.progressiverc.com/products/prc-silicone-wire-16-awg.json lists Red SW-16R / Black SW-16B, read 2026-10-11; the product page shows one SKU field with a colour selector); spare policy wiring_data.SPARES: V-23S RCY pair purchase 0 -> 1, new V-27S (FPS PicoBlade pair), V-28S (J2 set), V-22OS (3562 ribbon), each installed 0 / buy 1; V-62 stays purchase 0, now a GATED row (1505 nut across-flats, MTC row) and validate fails if it is bought before. Consolidated buy view (BOM-VERTICAL.md section + new BUY-VERTICAL.csv, 79 SKU rows): pair rows split into orderable SKUs (BUY_SPLIT) and summed across lines: Pololu 2180 / 2181 = 2 (D2-23 + V-23S), Molex 2181110202 / 2181120201 = 2 (D2-27 + V-27S), Adafruit 3562 = 2 (V-22O + V-22OS), J2 class housings 2 + 2 and pre-crimped leads 4 + 4 (V-28 + V-28S), PRC SW-16R 1 + SW-16B 1; class rows never merge. BOM 131 -> 134 rows. The export18 claim "every purchased selection/quantity are unchanged" is no longer true, so the generator now says so and lists the computed differences on the docs audit's own fields: D2-26 changed (sku), V-22OS added, V-23S changed (purchase_qty), V-27S added, V-28 changed (units, sku, supplier), V-28S added (= the docs audit's 6 differences; bom_claim does not fire because the claim is withdrawn, not because the check changed). No check, fixture, accepted set or test assertion edited.
- 2026-10-11 06:10 D1 FP-14 tests via run_locked: new tests/test_wiring_bom.py 20/20 (2.8-4.0 s, CAD-free): WIRING/BOM/BUY outputs current; every steps.CONNECTIONS end with its plug op/step; plug order == steps order, xt30:pack last; every SERVICE parting; every harness_rules cable/core in exactly one lead with stock text and recomputed route lengths; a 10 mm route change changes the doc; header pins == r7 layout HDR_USED_PINS == route header housings, signals == r7 pi5-header.csv; every lead BOM line + SKU; J2 lead requirement >= harness j2_btn halves and power_button range; no shared junction family now; negative controls: old J2 SKU -> [('fps_1824','j2','molex-picoblade-1.25')] and validate_fp14 raises, an unknown family fails also when listed last, the 9ced753 BOM-VERTICAL.csv (git show) -> the same fps/j2 pair; buy view: duplicate SKUs summed (3 real pairs + fixture 2 + 3 = 5 with an included row excluded), class rows never merge, CSV == view for both variants, every purchased row bought; spares, SW-16B/SW-16R, V-62 gated (buying it fails validate); supersession text, ASSEMBLY/REVIEW links, removed phrases, export18 change list == export18_differences. Affected suites: test_build_order_docs 23/23, test_evidence_numbers 8/8, test_cross_platform_io 12/12, test_windows_smoke 3/3, test_evidence_tooling 15/15 (96 s), test_repo_eol 7/7 (144 s). make_bom_vertical.py --check exit 0 (134 rows, 70 baseline lines), make_wiring_vertical.py --check exit 0. Docs audit --out scratch: exit 1, 27 failures = the phase-1 closeout set exactly (stale_selected_report 11, binding 8, bound_files 4, cooler_witness_number 3, checkpoint_number 1); BOM outputs current, export18 claim not made, 0 missing local links, 0 missing BOM sources; committed out/review-docs-audit.json not rewritten (FP-16).
- 2026-10-11 06:10 D1 FP-14 open / for other lanes: (1) harness_rules.py CABLES power_button range_src and MATE_POSES j2_btn halves still NAME the superseded Molex SKUs (their lengths stay conservative lower bounds; test_wiring_bom checks the lengths, not the names): harness lane or FP-16 should rename them to "V-28 keyed set, each lead >= 231 mm" and rerun verify_harness_checks.py. (2) routes.py "corrected lower USB2" error string (usb_5v route owner, FP-11f). (3) steps.py evf_mate doc (generated into ASSEMBLY step 5) still says "in their qualified lanes"; the hand text after it now says the lanes are not qualified; steps.py not edited here (state-model hash bound by many records). (4) delivery-core-paths.json lists none of the phase-1/2 modules that make_bom_vertical.py now imports (cv_io.py, evidence_rules.py, wiring_data.py) nor WIRING-VERTICAL.md / BUY-VERTICAL.csv / make_wiring_vertical.py: a delivery package would not run the BOM generator (FP-15/FP-16). (5) User decision 13 (J2 family) and the V-62 purchase (after the 1505 nut is measured) stay open; VN-73 placement of the J2 junction stays a hardware hold.
- 2026-10-11 06:27 D1 FP-14 final re-run via run_locked after the README (WIRING + buy-view links) and REPRODUCE (`make_wiring_vertical.py --check` inspect command) edits: make_bom_vertical.py --check 0, make_wiring_vertical.py --check 0, test_wiring_bom 20/20, test_build_order_docs 23/23. Docs audit --out scratch: exit 1, 29 failures; the 2 more than at 06:10 are stale_selected_report print-checks.json and check-scope-checks.json (verify_print_checks.py / verify_check_scope.py edited meanwhile by other lanes), and the binding rows now also name vent_geometry.py (other lane); no BOM, link or source failure; BOM outputs current; export18 claim not made.
- 2026-10-11 T1 FP-11a (VN-51, VN-52, VN-59, VN-37) bed-edge chamfer check FIRST (PHASE1-STATUS s8.1): new print_rules.check_bed_chamfer (manifold3d; r7 layout.FDM BED_CHAMFER 0.6 mm 45 deg, LAYER 0.2): the exterior outline of the first layer (slice z 0.1) must lie inside the z 0.7 outline shrunk by 0.35 mm (0.6 - 0.1 - 0.15 tol); the band left outside / 0.35 = equivalent sharp edge length; FAIL above 2.0 mm; hole outlines measured and reported as info only (r7 printed_tub chamfers only the exterior '|X' bed edges, and a chamfered CSI slot would change csi_straight_sleeve_area). verify_print_checks.py: new category bed_chamfer on every manifest print pose (bed_chamfer_rows; added after the FP-11c bed_contact lane's category, no other line touched). Snapshots: scratchpad vnfix2/snap/T1.
- 2026-10-11 T1 watched it fail: verify_print_checks.py --categories bed_chamfer on the selected export (manifest 53e668d4, report to scratch only, exit 1): 4 pass / 6 fail: tub 514.6 of 516.0 mm unchamfered (the sharp skin, VN-59), panel 489.8 / 491.2, eyecup 122.34 / 123.44, carrier 104.97 / 111.12, base_grip 39.0 / 330.8, lens_collar 7.05 / 361.44; cap, centring_gauge, knob_exp, knob_fps pass. Same function on the upstream r7 print STLs (digital8mm out/stl, read-only): base_grip, cap, hood, knob_exp, knob_fps, panel, tub pass; eyecup 122.31, lens_collar 7.85, pi_keeper 236.9, plunger 17.0, stick_sleeve 9.65 fail. So r7 never enforced the rule everywhere (VN-59's premise holds for the tub, panel and grip only); the candidate panel and base_grip LOST r7's chamfer (new latent findings), the carrier is new (the FP-11c lane's carrier docstring now claims the chamfer; re-check after its export), eyecup and collar are inherited r7 state. These rows stay FAIL (no exception list added); not fixed here (other parts, other lanes).
- 2026-10-11 T1 geometry (vent_geometry.py only; model.py untouched): plenum trial2. Posts removed (post_centres() returns []); continuous 1.2 mm ribs (r7 MIN_WALL; rib y -34.05..-27.9 like the old posts) along the flow. Cold bay: one roof region bridged in z: x-rows at z 18.45 (stops at x -104, above the cold underside branch band z 2.6-17.8 and left of the ports), 22.5/28.5/34.5 (between the port slots), 43/51/59/67 (to the CSI block), 55 (x -75..-65 only), 76/84/92; rows with z in 5..75 run out through the rear mouth as its 8 mullions; staggered 6 mm breaks (even rows at x -116.5/-138.5, odd at -128.5/-147.5, never overlapping) join the channels into one air volume; the lower band z 2.5-17.85 has no rib at all (bridged from the bottom-mouth lintel to row 18.45 / the port slot). Hot bay: two roof regions split by a diagonal rib (-3.2, 2.0) -> (-17.5, 17.0) from the solid front-bottom frame corner into hot port 0's corner plus a left separator (x -62.1..-58.5, z 15.85..17.05): the underside-mouth zone bridges in x between z-ribs at x -48 / -31 / -19 (z to 16.3; -31 is the single mouth mullion, off the verifier ray at x -32), the rest bridges in z between rows 21/28/35 (x -59.8..-17.3, 0.8 mm short of the port ends inside r7's 1.0 mm cantilever: a 2.2 mm lane at the divider and a collector column behind the front mouth join the port channels), row 28 to x -9.5, row 21 x -10.5..0 = the single front-mouth mullion (off the ray at z 22.5), rows 43..91 with 3 mm staggered breaks. Mouths = openings between mullions (cold rear 8 mullions, cold underside 2 for L 158 / 4 for L 185, even count so none sits on the verifier's centre ray, hot underside 1, hot front 1; largest opening 27.4 mm). Cold mouths: 45 deg lintel, 1.0 mm high with a 1.2 mm flat land at the outer face (the first try without a land gave a 45 deg knife edge: thin_wall sample 0.491 mm at (-157.8, -28.8, 14.4), which would have become an unclassified tub thin spot; the land removes it). Skin: r7 0.6 mm 45 deg chamfer on its 4 exterior bed edges (CSI slot left sharp). Rib ends avoid the integer x planes of the check-scope series sampling (an end face on a sampled plane made that plane read one extra rib, 7.2 mm2, conservative).
- 2026-10-11 T1 deviation from the register text (FP-11a "45 degree lintels at all four mouths"): the hot underside and hot front mouths have mullions but no lintel. The verifiers' hot mouth rectangles are fixed (324 + 210 = 534 mm2 gross vs 510 mm2 of hot wall ports, 24 mm2 slack); one mullion per mouth is needed for a <= 30 mm bridge and costs 2 x 7.2 = 14.4 mm2, and a lintel of the smallest printable height (2 layers, 0.4 mm) at the outer neck plane would cost about 0.4 x 89 = 36 mm2 -> area parity (VN-37) would fail. The hot mouths instead bridge parallel to the mouth between the mullion and the frame (computed rule passes, below). Recorded in vent_geometry's docstring, README and REVIEW.
- 2026-10-11 T1 results, trial2 tub alone (scratch build_tub.py: model.make_tub in model.build's layout state, export_cache.export_step, export_candidate's -Y print pose; final layout = scratch manifest e90efbcb): real verify_print_checks.py (tub only, print_overhang, print_bridge_direction, bed_chamfer, thin_wall): print_overhang tub FAIL with 8 regions, none in the plenum (y >= -3.0): tab catch 48.04 / 16.34 / 14.96, EVF support 13.66 / 7.81, rear panel-screw landing 7.98, 2.82 at x -55..-54 y -3.0 z 0..2.5, LL insert boss 1.72 mm2 (the trial1 plenum mouth regions 665.92 + 417.86 mm2 are gone). print_bridge_direction tub FAIL with the same 8 regions only; every plenum region passes: cold bay 6501.6 mm2 at print z 7.6 in one direction (90 deg), longest run 19.5 mm (trial1: 1162.2 mm2 bad, best single direction 43.8 mm); hot upper/front region 3629.8 mm2, 25.0 mm (90 deg); hot underside zone 454.9 + 302.2 mm2, 27.1 / 25.1 mm (0 deg); cold-underside lintel land strands 31.9 / 31.9 / 31.1 mm2 at print z 6.6, 22.8 / 22.8 / 22.2 mm between mullions. Longest passing bridge on the tub 27.7 mm is the pre-existing rear storage finger recess roof (x -158..-155.5, y 3). bed_chamfer tub PASS 0.0 of 512.0 mm (holes: CSI slot 77.38 mm, info). thin_wall tub PASS, min 1.199, p1 1.199, 0 samples under 1.15, 106 loaded samples, loaded share under 1.6 = 0.0.
- 2026-10-11 T1 results, plenum verifier: first trial2 layout (exp1, model.py before the FP-11c lane's edits): 49 pass / 0 fail / 21 info. Final layout (exp3) and the selected export: 48 / 1 / 21; the one fail is no_added_material_in_original_cavity 207.675 mm3, located (scratch cavity probe) at x -86.0..-74.0, y 10.32..17.20, z 2.60..6.50 = the FP-11c tub floor seat rib (model.CARRIER_LOCATORS seat_box, VN-38), not the plenum (ribs stop at y -27.9). Left to the FP-11c lane / orchestrator: the row compares the whole original cavity with export18, so any deliberate in-cavity addition fails it; it must not be weakened here. Plenum rows on trial2: mouth necks cold rear 302.00, cold underside 343.00, hot underside 316.80, hot front 202.80 mm2 (= vent_geometry.mouth_nominal net), every mouth ray 0.000 mm material, 3 external voids, every mouth/port joins its bay, divider continuous, CSI sleeve area exact, facade rays >= 1.6 mm. The info row print_and_thermal_limits now reports VG.support_summary (verify_shadow_plenum.py: info-row text only, no pass/fail logic touched; its post sentences were false for trial2).
- 2026-10-11 T1 results, check scope (VN-37): area_parity hot_branch_series PASS 519.6 >= 510 mm2 (margin 9.6, +1.88 %; trial1 509.4 FAIL): hot underside min(316.8 neck, 325.45 series), hot front min(202.8, 494.77); cold_branch_series PASS 645.0 >= 420 (cold rear 302.0 / series 490.8, cold underside 343.0 / 543.0). Same numbers on the selected export ec60b42d (FP-11c lane's 06:49 re-export, which already contains trial2). flow_network: baseline_drift failed as designed on the changed geometry; review-2026-10-10/fp12/flow-network-baseline.json rewritten with a reason (FP-11a; 'previous' keeps the FP-12 values) from the trial2 tub run (extract review-2026-10-10/fp11a/check-scope-trial2-tub.json, local path redacted, plus scratch-manifest.json and shadow-plenum-checks-trial2-tub.json): nominal cold path 347.1 -> 333.2, exhaust 320.1 -> 321.7, system 288.9 -> 288.9 mm2 eq., CSI share of intake 48.2 -> 49.2 %; occlusion system-flow ratios: cold rear blocked 0.966, cold underside blocked 0.958, strap 20/71 0.993, hot underside blocked 0.589, hot front blocked 0.685, set down on a table 0.580 (FP-12 trial1: 0.966 / 0.968 / 0.995 / 0.599 / 0.669 / 0.592).
- 2026-10-11 T1 flow-topology note (not modelled by any check): the hot-bay roof partition (diagonal + left separator) also partitions air: the underside mouth is fed directly by hot port 0 (z 16-19) and reaches ports 1-3 only through the collector column behind the front mouth and the 2.2 mm lane at the divider (passages of roughly 3 x 6 mm each above the diagonal end / separator); ports 1-3 mostly exhaust through the front mouth. The cold upper rear-mouth channels (z 43-75) drain to the ports through the 6 mm row breaks. check_scope.flow_network treats each bay as one plenum, so it overstates trial2's mixing; G-V-THERMAL (MEASUREMENTS-TO-CLOSE airflow row) must measure it. The hot channels above z 40 have no straight lane to a mouth (cleanout stays a coupon/physical gate, cleanout_qualified false).
- 2026-10-11 T1 coupon (VN-52): make_shadow_plenum_coupon.py gains a third crop 'all_four_mouths' = [-length, 0, -35.6, -25.5, 0, 100] (whole plenum, all four mouths) and --export / --dest for scratch runs (defaults unchanged); coupon-index records mouths_covered. Run on the exp1 scratch export (plenum 49/0): 3 valid single-solid crops written to scratch. Not run on the selected export: the script refuses while shadow-plenum-checks.json has the FP-11c cavity fail. The committed vent-study/shadow-plenum-coupon files still show trial1; FP-16 must regenerate them (and add the coupon to its refresh list).
- 2026-10-11 T1 check/test changes and why: (1) tests/test_check_scope.py CheckScopeReport.test_report: the hard-coded VN-37 expectation hot < ports now follows the bound export's plenum revision (trial1: still asserts the failure; trial2: asserts pass and >= ports), as removing an expected-failure mark once the fix lands; no tolerance changed. (2) vent_geometry.post_centres() returns [] (no posts); verify_check_scope adds a sample plane at every post centre, so tests/test_plenum_trial2.py proves on a plenum body (both storage lengths) that no rib lies lengthwise in any series family's range and that every family's minimum at the verifier's own planes equals the minimum over every constant interval between rib faces. (3) No check, threshold, fixture, accepted set or expected-failure mark was edited otherwise.
- 2026-10-11 T1 selected export: the FP-11c lane re-exported out/compact-kowa_lm6hc at 06:49 (manifest ec60b42d) from the final vent_geometry.py (56bc0a3f), so it already holds trial2. Runs on it: verify_shadow_plenum.py 48 / 1 / 21 (the FP-11c cavity row above) -> wrote shadow-plenum-checks.json; verify_check_scope.py (all categories) 33 pass / 1 fail (evf_restraint/-Z, VN-34, not this lane) / 14 info, area_parity cold 645.0 and hot 519.6 PASS, flow_network baseline_drift PASS (0 drifts: the selected tub's plenum equals the scratch trial2 tub) -> wrote check-scope-checks.json. The FP-11c lane's print-checks.json on ec60b42d (06:50, includes bed_chamfer) shows the same tub rows as the scratch run (8 non-plenum regions, plenum regions pass, longest plenum bridge 27.1 mm, thin_wall min 1.199, 0 under 1.15) and bed_chamfer: tub PASS 0.0 / 512.0, carrier PASS 0.0 / 350.87 (FP-11c chamfer), FAIL base_grip 39.0 / 330.8, eyecup 122.34 / 123.44, lens_collar 7.05 / 361.44, panel 489.8 / 491.2.
- 2026-10-11 T1 tests via run_locked: new tests/test_plenum_trial2.py 17/17 (65.6 s): bed-chamfer fixtures (sharp block 120 mm, r7 chamfer pass, 0.3 mm fail, one sharp edge ~20 mm, sharp hole info only, empty mesh fail); layout rules for L 158 and 185; plenum body (shell + plenum + ports + CSI slot) at L 158 and 185: r7 overhang PASS, single-direction bridge PASS with 0 failing regions, longest 27.1 mm; mouth necks = nominal net; series minima at the verifier planes = every-interval minima (L 158: 490.800 / 543.000 / 325.452 / 494.765; L 185: 490.800 / 705.000 / 325.452 / 494.765); parity cold 645.0 (L 185: 768.0) and hot 519.6 vs 510; the skin fails the bed-chamfer rule without its chamfer and passes with it; wiring (bed_chamfer on every print pose, coupon crop covers the four mouth rectangles for both lengths, flow baseline reproduces from its source). test_check_scope 21 OK / 3 skipped (FP-12 microSD, HDMI, wire runs not bound to ec60b42d), CheckScopeReport.test_report ran and passed on the trial2 branch. test_cross_platform_io 12/12, test_deterministic_export 20/20 (make_shadow_plenum_coupon still writes STEPs via EC.export_step), test_windows_smoke OK. test_print_checks 10/11: test_report_bound_and_complete fails because print_rules.py was edited at 06:57 by another lane after the 06:50 selected print run (a print-verifier refresh was running under another lane at 07:0x); not caused by stale bed_chamfer wiring.
- 2026-10-11 T1 open / for others: (1) FP-11c lane + orchestrator: the floor seat rib fails verify_shadow_plenum no_added_material_in_original_cavity (207.675 mm3); until resolved the coupon script refuses to regenerate the selected coupons. (2) FP-16: regenerate vent-study/shadow-plenum-coupon (now 3 crops) after (1), outlet verifier on the final export, variant audits (test_plenum_trial2 already checks the L 185 plenum body: bridge rule pass, parity cold 768.0 / hot 519.6). (3) Parts failing the new bed_chamfer rows (latent, VN-59 scope): panel (candidate make_panel lost r7's chamfer), base_grip (FP-11e), lens_collar (FP-11d; r7's own collar fails 7.85 mm too), eyecup (r7 TPU part, identical in r7). (4) Docs lane: REVIEW plenum-evidence row (49/0/21 on 53e668d4) and the coupon README still describe trial1/two coupons; MEASUREMENTS-TO-CLOSE airflow row should carry the hot-bay partition note above.
- 2026-10-11 07:40 H1 (VN-26 routes, FP-11f / VN-60) cause found: the 9ced753 run-lead floor lay (centreline z 4.9) passed under the two full-width lower bosses that span the cavity in Y (carrier boss (-25, 9) r 4.8 bottom z 4.2, panel boss (-10.8, 8.3) r 4.5 bottom z 3.8; 1.7 / 1.3 mm above the z 2.5 floor, under the 1.8 mm swept envelope), the riser at x -12 / -14 stood inside the panel boss, and pin37 dropped through the carrier boss flank at x -30 (exact probe on the then-current STEPs: 8.27 mm3 for a riser behind the boss with the x -30 drop). Tub lane probe (1 mm point classification, scratch vnfix2/H1/probe_tub_lanes.log): floor top 2.5 everywhere on y -24.3..-18 except the baffle (x -65..-62, z >= 10) and the two bosses.
- 2026-10-11 07:40 H1 run-lead re-route (signal_routes.py run_loops, REVISION ...-v3-runlead-behind-carrier-boss; roots, terminals, lanes, the pin37 shelf and the solver call '_solve_top(make,250,35,80)' unchanged; the 'top' knots keep indices 6,7 / 4,5): pin37 floor lay to x -34, riser x -34 (clear of the negative return's Y -19.7 lane that reaches x -36 at z 47), front drop x -27 (clear of the camera at x -25.1), diagonal Y crossing at z 15 over the boss to (-31.5, 7), slanting drop through the floor hole to the x -30 terminal (a first version with a z 3 knot put the mate_reach run_pi_37 anchor 0.5 mm over the floor and its dia-3 free tail hit the tub 2.56 mm3: fixed in the route, not the check); pin39 riser x -39.5, drop and Y crossing at x -32 / z 12 to y 3, drop to the x -32 terminal. Analytic boss clearance of the 1.8 mm capsule: pin37 0.48 mm, pin39 1.30 mm at the recorded member and both bounds. Solved tops 68.36 / 74.18; family minima 183.27 / 171.63 mm (were 214.31 / 209.54), maxima 273.27 / 261.63. test_harness_checks TestFamilies minima pins updated to these values with this reason (geometry change behind it; the recompute-from-knots assertion is unchanged).
- 2026-10-11 07:40 H1 EVF feed (routes.py usb_5v_feed, FEED_VOLUMES, place_on_leg; REVISION ...-2026-10-11-h1-feed-routes): installed full-core route for the selected compact scope (other scopes return a blocked curve with the reason): GPIO-side USB2 port face -> straight through the 31 x 15.5 x 9.8 head/bend allowance (rigid head must end within 24.72 mm of the face: MEASUREMENTS-TO-CLOSE Adafruit 4448 row) -> -Y channel -> splice leg z 20.5 (x -146.5..-114) -> up at x -108 (4 mm short of the negative power loop at x -104) -> RCY leg z 38.5 -> rear-corner climb -> over the board rail -> EVF 5 V pad point of record (r7 usb_5v_evf far point with the EVF shift, (-140.8, -4, 67)) from above; 197.93 mm, r 6, OD 3.6 (BOM D2-22 jacket). Volumes (oriented boxes on straight legs): diode_sleeve 30 x 4.8 x 4.8 (D2-16 DO-41 + r7 splice laps + D2-46 sleeve), option_c_reserve 16 x 7.5 x 4.5 (D2-16P) centred in the splice zone it would replace (r7 WIRING s4.8; DEFAULT PENDING USER DECISION 10), rcy_pair 32 x 7 x 7 (ASSEMBLY reserve) at x -146.25..-114.25, z 35..42. Stations: head 24.7, splice 44.7..74.7, RCY 101.4..133.4, pad 197.9 mm.
- 2026-10-11 07:40 H1 pack lead (routes.py pack_lead_route): pack top +X end (-29, 0.5, -36.8) (MP-PACK hypothesis; the old knots' +X-face root sat in the 0.7 mm pack-to-bay gap) -> knee 10 mm out of the posed XT30 male along its axis -> male face centre p(13, -2.6); 16.76 mm, r 6. Bundle swept at the two-core envelope 4.8 mm up to 8 mm from the face; each core (2.4 mm) on its own stub from its contact (v -5.1 / -0.1, 5 mm pitch). The 4.8 mm bundle carried to the face would hit the grip pocket (0.091 mm3 exact) where the cores are still apart; a 7.4 mm single envelope does not fit (40-79 mm3) - recorded as design data.
- 2026-10-11 07:40 H1 checks added (stricter, nothing relaxed): harness_rules INSTALLED_CLEARANCE + apply_installed_clearance (run_all): the installed route of run_pin37/39, usb_5v and pack_lead (the recorded member for families; the member sweep only covered the bounds) swept as capsules against every closed-camera part (own ends exempt, r7 rule), the HDMI ribbon cells of all three states and the FPS mated pair box at INSTALLED_TOL 0.01 mm3 (r7 SWEEP_TOL 0.5 elsewhere), plus centreline separation from every other modeled cable (pigtail cores, QT and branches, header branches, the FPS mated-carry wires of record, fan, ribbons at their width) with no envelope overlap (SEPARATION_TOL 0.01 mm); feed_volume_rows: exact oriented-box Booleans against all parts (no exemption) and ribbon cells, axis on the installed centreline, cable separation, donor / 2180 / 2181 segment + r7 allowance <= own stock, station order. verify_harness_checks.py: obox solids, strict tol passed through, neighbour context (binds out/fps-service-study/mated-carry-input.json as a dependency). box_hits accepts obox (AABB) and a per-spec tol. cable_stow: a cut-to-length lead with no mate_reach finished length is cut to route + r7 allowance. MATE_INFO evf_5v:evf now names the placed RCY and keeps the access HOLD.
- 2026-10-11 07:40 H1 data correction with justification (CABLES usb_5v, the only number changed in a gating rule input): length 200 -> 500 (range 500..535), cut_to_length. The 200 mm was the routes.py definition placeholder FP-10 copied; the candidate's own records supersede it (routing-snapshots/hdmi-export17-selected-20261009-0704/usb-donor-provenance.json: superseded_allocation_mm 200, installed_wire_length_is_fixed false; routes.py note 'the old 200mm value is an obsolete allocation'; BOM D2-22 catalog 300 / supplier 325 +/- 10; D2-23 100 mm tails). The binding stock limits are per segment and are now checked by the new feed_volumes rows (donor 19.99 + 30.0 <= 300, tail_2180 26.71 + 10 <= 100, tail_2181 64.52 + 10 <= 100). New test test_usb_stock_is_the_segmented_bom_assembly ties the number to the provenance file; test_long_tail_fails_its_segment_row proves a 95 mm 2181 span fails. With 200 the route (197.93 + 20 allowance) cannot hold the three rigid volumes at all.
- 2026-10-11 07:40 H1 stale text (VN-60): BOM D2-16P item 'inside ko_5v_up by box arithmetic' -> 'reserved on the installed usb_5v route (routes.py FEED_VOLUMES)' (make_bom_vertical.py change after the option-C loop; BOM regenerated, 0 ko_5v_up in BOM-VERTICAL.md / .csv); routes.py usb_5v note (Diode + PH pair), the shared fpc/usb 'corrected lower USB2' error text, the usb_stow method (diode/PH pair) and the dead 32x7x7 'TBD' note rewritten; ASSEMBLY-VERTICAL.md feed paragraph (route, volumes, gates, HOLD), MEASUREMENTS-TO-CLOSE RCY and 4448 rows (24.7 mm head limit, 1.8 mm core OD). Frozen copies (routing-snapshots, vent-study, history) untouched.
- 2026-10-11 07:58 H1 results via run_locked (manifest ec60b42d, the 06:49 re-export by another lane; harness-checks.json sha 2b342f2b): verify_harness_checks.py 32 pass / 9 fail / 20 info (was 20 / 15 / 20). Now passing: cable_routes run_pin37 (installed 250.0, minimum 183.27 + 25 <= 250, slack 41.73; installed sweep 93 pieces, hits {}; shortest member at 35 hits {}; tightest separation FPS header branch 1.78 vs 1.60), run_pin39 (171.63, slack 53.37, 73 pieces, hits {}; tightest run_pin37 1.87 vs 1.60), usb_5v (197.93 mm, 101 pieces, hits {}; tightest pigtail_negative 4.01 vs 3.40), pack_lead (16.76, slack 33.24, 11 pieces incl. 2 core stubs, hits {}); cable_stow run_pin37 / run_pin39 (longest members 273.27 / 261.63 >= 250, hits {}); feed_volumes 6/6 pass (diode_sleeve, option_c_reserve, rcy_pair exact hits {} against all parts and 6849 ribbon cells + FPS pair; nearest cable pigtail_negative 6.50 / 12.51 / 3.68 mm beyond need; donor 19.99 + 30 <= 300, tail_2180 26.71 + 10 <= 100, tail_2181 64.52 + 10 <= 100). mate_reach run_pi_37 / run_pi_39 still pass (slack 121.8 / 120.7, tail hits none). Remaining fails are the other lane's rows only: cable_routes qt, pigtail_positive, pigtail_negative; lead_access pigtail_drop, pigtail_ties_on_route, pigtail_xt30_mouth; mate_reach qt_enc, j2_btn, xt30_pack. Exact pre-checks on the same manifest before wiring (scratch vnfix2/H1/driver2.log): usb route hits {}, diode 1.60 mm / option C 1.75 mm / RCY 1.42 mm to the tub (RCY 2.17 to pi5, 2.23 to usb_stick).
- 2026-10-11 07:58 H1 tests via run_locked: new tests/test_h1_feed_routes.py 17/17 (39 s): run-lead boss/floor clearance for the recorded member and both bounds, with the 9ced753 knots as negative control; installed routes exist and fit; usb stock tied to the provenance file; a 95 mm 2181 span fails its segment row; a feed volume off its leg raises; feed rows CAD-free; planted part on the usb route, a cable laid onto it and a planted part on the RCY volume each fail; bound report rows exact with no hits/overlaps; no ko_5v_up in routes/signal/harness/BOM outputs/ASSEMBLY/MEASUREMENTS/README/REVIEW/WIRING (the BOM generator names it only in the D2-16P replace), no diode/PH pair text on usb lines of routes.py, no 'corrected lower USB2'. tests/test_harness_checks.py 24/24 (EXPECTED_FAILING minus the six H1 rows; family minima pins as above), candidate test_routes_source.py 10/10, tests/test_routes_source_fix.py 7/7, tests/test_wiring_bom.py 20/20 after make_wiring_vertical.py regenerated WIRING-VERTICAL.md (stale because routes.py changed: the port-naming note is gone with the old error text and usb_5v now has an installed route), tests/test_cross_platform_io.py 12/12, tests/test_coverage_gates.py 8/8. tests/test_evidence_tooling.py 12/15: the 3 failures come from the 06:49 re-export (16 selected-folder reports still bound to 53e668d4, the stale-report index and checkpoint claims); harness-checks.json binds the current manifest and is not among them (FP-16 refresh).
- 2026-10-11 07:58 H1 found while fixing (latent, not gated here, for another lane): the J2 power_button installed route intersects the cooler (exact capsule 7.03 mm3, on the 53e668d4 STEPs) at its first knots, the pad hypothesis under the cooler (G-V-POWER / VN-73); cable_routes power_button still passes because only H1's four cables have installed sweeps (INSTALLED_CLEARANCE); the fan route sweeps clean; ribbons (fpc, oled_flex) are not capsule-checked. Also: reports binding routes.py or signal_routes.py (e.g. verify_fps_fixed_service sourcehash, FPS central-rest / contact-pad studies) are now stale against the edited sources (FP-16 re-run).
- 2026-10-11 07:58 H1 open / defaults: DEFAULT PENDING USER DECISION 10 (VN-80) - option-C reserve kept free, centred in the splice zone, BOM qty 0. Gates carried, not closed: received USB head must end within 24.7 mm of the port face (else re-route); 20 AWG RCY cores <= 1.8 mm OD to stay inside the 3.6 mm envelope; EVF 5 V pad position (MP-EVF); pack BMS lead exit and solder-tail length (MP-PACK); RCY finger access at evf_mate and the 2181 half's parking during carrier_in (mate_reach evf_5v:evf HOLD). Design aids (voxel grids, A*, box fits) are in scratch vnfix2/H1 and are not evidence. Snapshots of every H1-edited file before editing: vnfix2/snap/H1.
- 2026-10-11 D2 FP-15 VN-10 (writers): verify_shadow_usb_head.py:88 records `manifest_path=relpath_posix(mp,ROOT)` (was `str(mp)`, the local absolute path); verify_check_scope.py bind() keys are always `relpath_posix(p, CV.parent)` (was `str(p)` for a path outside cad/gs8-d2-v1); refresh_primary_evidence.py / refresh_alternatives.py log to the git-ignored out/checklogs (was /tmp/d2-final-*.log); probe_power_boolean.py / probe_power_boolean2.py use tempfile.gettempdir() (was the literal /tmp). Snapshots: scratchpad vnfix2/snap/D2. Six JSONs still hold a machine-local path: 4 frozen history/routing-snapshot reports, 2 non-reproducible records (out/final-check-run.json, power-csi-clear independent-audit.json), and the selected usb_head report routing-snapshots/hdmi-export17-selected-20261009-0704/shadow-plenum-head-checks.json (author /workspace path). That one is not hand-edited: FP-16 regenerates it with the fixed writer; tests/test_repo_hygiene.test_selected_evidence_holds_no_absolute_path is marked expectedFailure until then (remove the mark when it passes). The usb_head and check_scope reports read "verifier changed" until they are rerun (verifier hashes changed).
- 2026-10-11 D2 FP-15 VN-11 / VN-20 (provenance): make_repo_index.py -> REPO-INDEX.md lists evidence whose producer is not in the repository (Pi connector extraction + port landmarks + 7 native STEPs from the official Pi 5 STEP 78164070; the 2026-10-09 independent XT30 audit with /tmp scripts; out/final-check-run.json; the structural base JSON; the probe archive input), with what still checks each. Internal consistency tested: every connector-extraction source_sha256 and port-landmarks sha256 equals its *-native.step (9 files). No extractor was written: re-deriving needs the official archive (a download, not done). VN-20: the base JSON generator is not recoverable; new structural-review/verify_reference_binding.py re-derives manifest hash, mass, centre of mass, 5 part STEP hashes, valid/solid flags, part volumes vs the export18 manifest (relative difference <= 4.1e-9) and the two history STEP hashes, and with --cad the history tub/panel volumes; the critical-region comparisons and load blocks stay labelled non-reproducible ("inherited" = r7 1.6 mm lip / 1.8 mm head J4 geometry; (2.4/1.6)^2 = 2.25 is that ratio).
- 2026-10-11 D2 FP-15 VN-12 (toolchain): new requirements-candidate-lock.txt (-r the shared base lock; every third-party import of the live scripts on exactly one line: pinned-in-base cadquery OCP numpy PIL reportlab vtk manifold3d; optional pypdf (structural PDF page check) and scipy (8 historical screen_fps_* studies), both absent from the reference venv and deliberately unpinned; external bpy/mathutils). render_review.py now writes bpy.app.version_string into each receipt (the 9ced753 render receipts hold no version; r7 used Blender 4.3.2). REPRODUCE.md: Windows/POSIX section (interpreter paths, PowerShell inspect block, core.longpaths, UTF-8, POSIX-only steps and their Windows form). Guide rasterizer: new guide/raster_numpy.py (pure numpy, same arithmetic and painter rule as raster.cpp: per pixel min z, ties to the first triangle, chunked lexsort reduction) and guide/run_with_numpy_raster.py (runs a guide builder with software_lineart.py and raster.cpp byte-identical: the guide receipt binds both, and tests/test_evidence_tooling.test_edited_guide_source_is_listed needs software_lineart.py to match that receipt, so it was not edited; the launcher only answers the raster.cpp g++ build and the raster.so load while software_lineart is imported, then restores subprocess.run/ctypes.CDLL; writes guide/out-concealed-vents/raster-backend.json after a selected-guide build). Bit identity with raster.cpp holds for an x86-64 (no FMA) build. The guide was not rebuilt here (FP-16).
- 2026-10-11 D2 FP-15 VN-14 (entry docs): PUBLISHING.md rewritten (the repository is public at AubergineShallow/digital8mm-vertical-nizo, main and redesign/vertical-pi-hidden-vents = 9ced753 as fetched 2026-10-10; review branch local and unpushed = user decision 15; the bundle text marked superseded); root README (publication sentence, gate map instead of "56 inherited", REPRODUCE/lock/REPO-INDEX links, review section); banners on CLOUD-START-HERE.md and cad/gs8-d2-v1/HANDOFF.md (both were byte-identical to d38468e, neither is an r7 audit source or holds a broken link); history/reviewed-export18/README.md "Library" sentence replaced. Candidate README/REVIEW/REPRODUCE: phase-1 changes summarised, typed main-audit and HDMI counts replaced by generated blocks, the hard-coded guide manifest hash replaced by "the nominated manifest's SHA-256", new inspect and refresh commands.
- 2026-10-11 D2 FP-15 VN-15 (links): check_links_vertical.py scans every Markdown file git knows (tracked + untracked not ignored): 146 files, 650 relative links, 214 broken = 55 inherited (4 r7 files byte-identical to d38468e: candidate-fr1/CANDIDATE.md 40, EVF-SELECTION.md 10, software/gs8-camera-evf/README.md 4, LENS-M12-ANAMORPHIC.md 1) + 159 in 7 frozen copies, now bannered by FROZEN-LINKS.md notices in history/, history/reviewed-export18/ and vent-study/angled-channel-trial/ (the copies themselves stay byte-exact); live documents 0 broken; exit 0.
- 2026-10-11 D2 FP-15 VN-18: longest repository path 132 characters (routing-snapshots/hdmi-ck1044-clear-20261009-0524/fps-deployed-carrier-context-0551-superseded.json); documented core.longpaths=true or a clone root <= 120 characters (REPRODUCE, REPO-INDEX); folder names not shortened (recorded in receipts and reconciler cases); test fails if a path grows past 132.
- 2026-10-11 D2 FP-15 VN-19: REPO-INDEX.md separates the selected pipeline (40 entry scripts), their computed import closure (31 helpers, including __import__-loaded driver_checks/j7_collar_checks), 8 superseded runners and 56 studies/probes; studies not moved (paths recorded in snapshots/receipts). Part REFUTED: structural-review/tmp/pdfs/supplement-1.png and -2.png are not stray: structural-supplement-pdf-receipt.json visual_review.rendered_page_sha256 binds both (a05acdf8, c6a650cf); kept, test asserts the binding. Not changed: long lines and the 9ced753 one-line commit message (style only).
- 2026-10-11 D2 FP-15 VN-21 (reporting): make_coverage_vertical.py -> COVERAGE-VERTICAL.md, generated blocks in README.md and REVIEW.md, and CHECKPOINT-STATUS.json main_summary + check_coverage (main_summary was the 9ced753 292/1/18; now generated from verification.json, which clears the docs-audit checkpoint_number failure). Every report category gets a kind (geometric / bookkeeping / coverage-state / analytical-declared; an unclassified category fails the run: it caught the new harness feed_volumes rows of FP-11f) and every r7 checks.json category a mapping (36: 21 ported, 3 partly, 1 report only, 11 not ported). The outputs follow the live reports, so they go stale whenever a lane refreshes a report: rerun `make_coverage_vertical.py --write` in FP-16 (added to REPRODUCE).
- 2026-10-11 D2 FP-15 VN-50: gate_map.py + make_gates_vertical.py -> GATES-VERTICAL.md and generated gates blocks in README/REVIEW: all 58 r7 receipt gates (56 open, 2 withdrawn) and BX-1..BX-17 mapped once: gates 39 carried, 11 re-scoped, 3 replaced (G-MP-STICK -> G-V-STORAGE, G-PI-1 -> G-V-STACK, G-PLG-1 -> G-V-POWER), 5 retired (G-SKIRT-1 and G-SNAP-1 withdrawn in r7; G-KEEP-1, G-KEEP-1/whole, G-SNAP-2/whole with the deleted keeper and hood); 53 of the 56 open still apply. BX: 8 carried, 7 re-scoped, 2 retired (BX-6, BX-17). Conservative rule: retired only for deleted subject parts or r7 withdrawal. FOUND (latent, docs lane): the r7 fixes for BX-13 (proud shafts before the knobs) and BX-14 (18/24 shaft cut) are not written into ASSEMBLY-VERTICAL.md.
- 2026-10-11 D2 FP-15 test_routes_source.py (2/10 failures since 9ced753): both TESTS were wrong, the geometry is right. (1) test_full_rigid_connectors_retained asserted p_usb_pi x [-153,-122], z [44.75,60.25]: that is the Ethernet-row placement routes.py explicitly rejects; the plug is bound to the official usb2 landmark (x max = -121.779999264573 exactly = usb2 bbox_candidate x min; z centre 16.0003 = landmark centre). Only the x assertion ever ran; the z lines behind it were 36.5 mm off. (2) test_frozen_mechanical_geometry_unchanged compared recomputed sin/cos results with the frozen JSON by exact equality: the frozen -0.7071067811865475 is the correctly rounded sin(radians(45)) (60-digit decimal Taylor series), this Windows libm returns -0.7071067811865476; 26 pose floats differ (<= 2 ulp) and, behind them (never reached before), core-polyline points differ by up to 1.42e-14 mm (1 ulp at 68 mm; 8 ulp = 3.6e-15 mm at 3.0 mm). Correction (justified here): p_usb_pi asserted against the landmark (exact face, z centre, y centre inside the receptacle, full 31 x 9.8 x 15.5 allowance kept; stricter than the constants); poses and core points compared within 1e-12 mm (structure, lengths, z<5 selection, strings and ints exact; the other frozen keys still exact; evidence tolerance elsewhere is 1e-6 mm). Proof: new tests/test_routes_source_fix.py (correctly rounded value, old constants = Ethernet row and miss usb2, helper rejects the old box, 1e-11 / 1e-9 / 1e-6 perturbations, phase/length changes still fail).
- 2026-10-11 D2 FP-15 structural check numbers: verify_reference_binding.py --cad via run_locked exit 0, 23 of 23 rows pass; history tub.step re-imports to 134777.50809510006 mm3 and panel.step to 41134.69136222837 mm3, bit-equal to the base JSON (so its part volumes are STEP re-import volumes); manifest volumes differ by <= 4.1e-9 relative.
- 2026-10-11 D2 FP-15 CHECKPOINT-STATUS.json: main_summary and plenum_summary are now written by make_coverage_vertical.py from verification.json and shadow-plenum-checks.json (the fields the docs audit compares); the docs-audit checkpoint_number failure is gone. Other fields untouched.
- 2026-10-11 D2 FP-15 tests via run_locked (final run 07:45-07:52): new tests/test_repo_hygiene.py 17 OK (1 expected failure: the selected usb_head report, FP-16), new tests/test_coverage_gates.py 8 OK, new tests/test_raster_fallback.py 7 OK, test_routes_source.py 10/10 OK (was 8/10), new tests/test_routes_source_fix.py 7 OK, test_cross_platform_io 12 OK (lint covers the new scripts), test_build_order_docs 23 OK, test_third_party_notices 9 OK; make_coverage_vertical / make_gates_vertical / make_repo_index --check exit 0; check_links_vertical exit 0. Docs audit --out scratch: exit 1, 56 failures (binding 11, foreign_manifest_report 15, stale_selected_report 22, bound_files 3, checkpoint_binding 1, checkpoint_claim 1, cooler_witness_number 2, guide_manifest_stale 1): none from these edits (0 missing links, 0 gate or figure findings in the edited documents; checkpoint_number cleared); the rise from the phase-1 closeout's 27 comes from the FP-11c re-export of compact-kowa at 06:49 (manifest ec60b42d) and other lanes' source edits. REVIEW.md and verify_shadow_usb_head.py join the stale guide receipt's changed-source list (guide rebuilt in FP-16).
- 2026-10-11 D2 FP-15 NOT caused here (FP-11c re-export ec60b42d, 06:49; the selected reports still bind 53e668d4): test_evidence_numbers 6/8 (changed_rows now include carrier), test_deterministic_export 19/20 (committed OCCT header test: the working-tree STEPs are the new normalised export), test_windows_smoke 2/3 (structural output stale against the new manifest), test_evidence_tooling 12/15 (baseline already has checkpoint_claim because the guide nominates 53e668d4; foreign-manifest reports in the selected folder; stale-report index selected manifest). They clear in FP-16 once every report and generated file is rebuilt on the final export; no assertion was touched.
- 2026-10-11 D2 FP-15 left for FP-16 / others: regenerate the usb_head report (then remove the expectedFailure mark), rerun make_coverage_vertical.py / make_gates_vertical.py / make_repo_index.py --write after the last report refresh (the coverage outputs follow the live reports), rebuild the guide on Windows with guide/run_with_numpy_raster.py (full-guide runtime of the numpy rasterizer not measured), install and pin pypdf/scipy only with the user's permission (download), and write the r7 BX-13/BX-14 procedures into ASSEMBLY-VERTICAL.md (docs lane). VN-47 docs (no-tie departure) was not part of this task.
- 2026-10-11 07:30 C1 FP-11c (VN-54, VN-56) carrier geometry (snapshot vnfix2/snap/C1): model.make_carrier grows the frame rails, ear box, arm, the four kit bosses (r 4.5) and the two ear bosses from y 20.2 to one continuous +Y bed face at y 22.2 (CARRIER_BED_Y = STACK_Y, the old arm face); PT counterbores r 3.2 -> 3.5 (7.0 mm, as the r7 panel; r7 DRIVER bit 6.5) in ear bosses r 4.8 -> 5.2 (r7 panel boss, 1.7 mm wall), the same constants in structure_geometry.carrier_arm_addition (SG.CARRIER_CBORE_R / CARRIER_EAR_R; root pad and bore); kit heads (y 19.2..21.6, seat unchanged at 19.2) sit in r 2.65 pockets with the arm's r 3.35 lead-in from 21.5; the four tie slots run through; r7 FDM BED_CHAMFER 0.6 mm 45 deg on the exterior bed outline only (_carrier_bed_chamfer, holes keep their sections). Found while doing it: the 22.2 face met the power-nut reserve face (_build power_nut_reserve OD 22, y 22.2..25.2) at 0 mm over the right rail's outer 2 mm; a cone relief coaxial with the nut (0.8 mm at the bed face, 0.61 mm normal to its 50 deg slope) keeps it printable from the bed. Carrier 8784.07 -> 13115.24 mm3, 9.40 -> 14.03 g.
- 2026-10-11 07:30 C1 export prerequisite: export_candidate refused ('Corrected Pi source changed: official_pi5_assembly.py', phase-1 I/O edit), so make_corrected_pi.py ran first via run_locked (FP-16 step 1, deterministic per FP-03; pi5-corrected.step 85fae8b0 -> 15f13dc8, .json sources re-hashed), then export_candidate (compact-kowa) -> manifest ec60b42d (includes the other lanes' model state at 06:45; tub +7980 mm3 is mostly FP-11a, carrier and panel deltas are C1).
- 2026-10-11 07:30 C1 FP-11c results (manifest ec60b42d, all via run_locked): print_overhang carrier PASS (was 1963.09 mm2 at z 2.0), print_bridge_direction carrier PASS (was 2041.7 mm2), bed_chamfer (FP-11a row) carrier PASS 0.0 mm unchamfered, thin_wall carrier pass p1 1.696 / loaded share < 1.6 = 0.0151 / min 1.142 (loaded zones now r 5.2 to y 22.2). NEW bed_contact row (print_rules.check_bed_contact, verify_print_checks category bed_contact over print_rules.FLAT_BED_PARTS = carrier): PASS, silhouette 2670.51 mm2, bed 2299.70 mm2 (0.861), covered recesses 175.04, lifted 0.00; the HEAD 44f8131 carrier STL FAILS it: bed 336.12 of 2653.09 mm2 (0.127), 6 lifted regions 2213.38 mm2, largest 2139.05 mm2 starting at z 2.0. Driver (verify_candidate --only driver -> fp07/driver-compact-kowa_lm6hc.json, 188 pass / 0 fail / 8 info): p_carrier1 and p_carrier2 at carrier_screws and svc_carrier_screws_out PASS, bit gap 0.27 mm to the carrier (were 2.432 / 0.405 mm3 bit in bore). Boss wall from the STEP (tests/test_carrier_fp11c, 24 rays at y 20.0 and 21.5 per screw): bore r 3.500 measured, min radial wall 1.700 mm at both screws; main-audit rays carrier_PT_radial_wall 1.700 and NEW carrier_PT2_radial_wall 1.700 (1 span each, >= 1.6). Clearances measured from the bound STEPs (exact OCP distance, 0 overlap): power_nut_reserve 0.615 mm, switch_1824 0.466 mm (to the r 5.2 p_carrier1 boss; not measured for the old r 4.8 boss), power_button 1.000, encoder 1.200, panel 0.150 (the stop pad); x1203_kit, p_carrier1/2 and the tub posts touch (bearing faces).
- 2026-10-11 07:30 C1 VN-38 third locating feature (no new screw): the carrier bottom-rail tongue (x -86..-74, z 4..9) lands on a tub floor seat rib (model.carrier_locator_seat, in make_tub's carrier-boss block: +Y face on the carrier datum y 17.2, top z 6.5 under the X1203 at z 7.0 with 0.5 mm, -Y face 4 in 5 to the floor so it grows from the tub's -Y bed wall; floor under it solid 180/180 mm3) and sits 0.15 mm under a panel stop pad (model.carrier_locator_stop in make_panel; r7 HOOD_STACK_STOP gap 0.15, window 0.1-0.3). model.CARRIER_LOCATORS declares where to look only. Results (check-scope-checks.json, ec60b42d, 33 pass / 1 fail / 14 info): stack_retention/vertical_carrier PASS: locator credited (seat 0.0000 mm, stop gap 0.1500 mm measured from the tub, panel and carrier STEPs), CoM (-78.84, 33.90) of the 122.23 g rigid stack inside the hull with margin 5.834 mm, every lift bounded (max 0.284 mm at the carrier corner (-132.2, 3.8)); without the locator the same row has no hull and unbounded lift. post_root_bending PASS 2.88 MPa <= 5 MPa (134.23 g incl. 12 g wiring). Main audit subset (verify_candidate --only interference,motion,step_material_probes,assembly_state -> fp11c/main-subset-compact-kowa_lm6hc.json): 315 pass / 1 fail / 24 info; the only fail is the known pi5/cooler 79.902671 mm3 (VN-69 hardware); 108 interference rows pass (carrier, tub with rib, panel with pad), 16 motions pass incl. carrier_out / panel_out (pure +Y), 13 STEP probes pass, assembly_state 3 pass. Print rows: tub keeps 8 known regions, none at the rib (x -86..-74); panel overhang and direction pass with the pad.
- 2026-10-11 07:30 C1 check-side changes, with reasons (the verifier will want these): (1) verify_check_scope.py VN-38 block hard-coded the retention set to model.CARRIER_SCREWS, so no geometry could pass (its own remedy said 'add a third printed locating feature'). It now adds each model.CARRIER_LOCATORS point only when the new check_scope.locator_point credits it from the bound STEPs: seat on the tongue's -Y side touching (exact distance <= 1e-3, no overlap), stop on its +Y side with an exact gap in r7's hood-stop window 0.1-0.3, declared point inside the measured XZ overlap; an uncredited locator fails the row. This is how r7 check_stack_retention works (retention points read from layout PI_KEEPER / HOOD_STACK_STOP, stop gap measured by exact OCP distance). stack_retention(), the hull, margin and LP are untouched; the two-screw fixture still fails (test_check_scope.test_two_screw_carrier_fails). Tests prove the window: credited at 0.15; not at 0.5, 0.0 (touching), seat 0.3 off, seat on the wrong side, point outside the overlap. (2) test_check_scope.CheckScopeReport asserted stack_retention 'fail' as the by-design expected failure; now that it passes it asserts 'pass' plus every locator credited, margin > 0 and lift bounded (the analogue of removing an expectedFailure mark). (3) print_rules.candidate_state carrier loaded zones follow the model (ear r CARRIER_EAR_R, kit and ear bosses to CARRIER_BED_Y): more material probed, stricter. (4) verify_candidate: nominal_features carrier_PT_head_radial_wall now 5.2 - 3.5 (report-only design value, was 1.6 for the old 4.8/3.2 pair) and a new STEP ray carrier_PT2_radial_wall. (5) New check bed_contact: material that first appears over a column at layer k must lie within cantilever_max + k x layer x tan 45 of the first-layer section (r7 PRINT_OVERHANG constants; holes not filled, so a floating bar over a through-window fails); fixtures: 2 mm floating frame fails, counterbore passes, 0.6 chamfer passes, 50 deg edge relief passes, lip starting at z 1.0 fails by 40 mm2, bar over a window fails. (7) tests/test_evidence_numbers.py (FP-04, VN-06) hard-coded the rows that differ from export18 as ['tub', 'panel']; FP-11c changes the carrier row by design, so two tests failed with ['carrier', 'tub', 'panel']. Their purpose (1.4e-13 jitter changes no row, 1e-3 changes are caught, a pi5 change is refused) is kept: the expected set is now the unjittered truth (ER.changed_rows of the pristine manifest) and must lie inside the generator's ALLOWED_CHANGED_ROWS (read from its source) and contain tub and panel; the negative controls are unchanged. (6) structural-review/update_concealed_vent_structure.py asserted changed rows <= {tub, panel}; the carrier is upper body (not a J4 lower row; check_scope.j4_screen already accepts it), so check_changed allows tub/panel/carrier and carrier_section scales the retained reinforced-arm screen with payload (arm section unchanged by FP-11c); output is byte-identical when the carrier row is unchanged. Regenerated for ec60b42d: payload 122.60 -> 127.23 g, arm screen 3.39 -> 3.52 MPa, 0.399 -> 0.414 mm; J4 equal share 0.9437 N m (<= 0.95 compact screen; includes the FP-11a tub mass). Regenerated a second time at 07:58 after the FP-11a lane re-ran the plenum verifier on ec60b42d: only ventilation_report changed (same_manifest true, 48 pass / 1 fail). FP-16 must regenerate it again on the final manifest.
- 2026-10-11 07:40 C1 neighbouring verifiers on ec60b42d (records in review-2026-10-10/fp11c/): verify_wire_solids (power-csi-clear snapshot) status pass, 44 obstacles; verify_harness_checks 32 pass / 9 fail / 20 info, no row turned to fail against the phase-1 report (the 9 are the known qt, pigtail_positive/negative, mate_reach qt_enc/j2_btn/xt30_pack, lead_access x3; six run/usb/pack route rows now pass from other lanes); verify_hdmi (export17 selected snapshot, 2 mm) 13 pass / 0 fail.
- 2026-10-11 07:30 C1 tests via run_locked (ec60b42d): new tests/test_carrier_fp11c.py 20/20 OK (bed-contact fixtures, locator fixtures, structural transfer guard and scaling, declarations, bound-STEP geometry: bed contact, 7.0 bore and 1.700 walls, locator credited; reports: print rows, driver rows, stack row); test_check_scope 21 OK (3 skips: microSD/HDMI/wire FP-12 runs not bound to the new manifest); test_print_checks 11/11 OK; test_driver_checks 18/18 OK.
- 2026-10-11 07:30 C1 docs: REVIEW.md (stack carrier row, kit-boss pockets, tie heads, G-V-STACK) and MEASUREMENTS-TO-CLOSE.md (counterbore/bit, tongue seat, stop gap). Open, not done here: (a) user decision 6: with 5 mm rails a tie head on the +Y face has 3.0 mm to the panel (was 5.0), so heads go at the rail edges or the ties are dropped for RTV-only (default pending user decision 6); (b) switch_1824 clearance to the p_carrier1 boss is 0.466 mm with the r7 panel boss r 5.2 (r 5.1 would still meet the 1.6 mm loaded wall if more clearance is wanted; not built); (c) the carrier still has no CRITICAL_FEATURES / CRITICAL_JOINTS entry (print critical_features coverage, section 8.2 re-nomination lane); (d) steps.py carrier_in / panel_in docs could name the tongue landing on the seat rib and the stop pad (no new action; not edited, it would stale every steps-bound record); (e) original-kowa and compact-fujinon exports and audits (FP-13); (f) the structural supplement, print/check-scope reports and fp07/fp11c records bind the transient ec60b42d manifest: FP-16 regenerates.
- 2026-10-11 08:20 C1 reruns after the second supplement regeneration (ec60b42d, run_locked): verify_check_scope 33 pass / 1 fail / 14 info (stack_retention and post_root_bending pass; the only fail is the known evf_restraint/-Z, VN-34); test_evidence_numbers 8/8 OK (after correction 7), test_windows_smoke 3/3 OK, test_check_scope 21 OK (3 skips), test_carrier_fp11c 20/20 OK. Status: VN-54, VN-56 and VN-38 (computed part) closed in CAD on the compact-kowa export; G-V-STACK physical checks and the FP-13 variants stay open.
- 2026-10-11 T2 FP-11b + VN-34 + tub print minors (VN-53, VN-34, VN-25 tub regions of PHASE1-STATUS s8.2). Snapshots: scratchpad vnfix2/snap/T2 (model.py, print_rules.py (not edited), export_candidate.py, export_cache.py, steps.py, make_bom_vertical.py, MEASUREMENTS-TO-CLOSE.md, ASSEMBLY-VERTICAL.md, BOM-VERTICAL.md/.csv, BUY-VERTICAL.csv). Baseline = the selected export ec60b42d, built from exactly the pre-T2 model.py (e74cd9b4) and vent_geometry.py (56bc0a3f): tub print_overhang FAIL with 8 regions (tab catch 48.04 / 16.34 / 14.96, pair guide 13.66 / 7.81 (PHASE1-STATUS called them "EVF support"; they are the FPS pair guide, fps_pair_guide.build, x -137.6..-129.4 y 6), rear panel-screw landing 7.98, floor tooth 2.82 at x -55, LL insert boss 1.72 mm2), check_scope evf_restraint/-Z FAIL (receptacle zone 0.27 mm within the PCB's 0.25 + 0.2). No check, fixture, test assertion, accepted set or expected-failure mark was edited; no support zone was declared (every region is fixed in geometry; print_rules.py untouched).
- 2026-10-11 T2 why the +Y tine cannot stay integral (VN-53): its catch face (y +8.28, facing -Y) is a DOWN face in the -Y-down tub pose, and a bridge or cantilever needs supported material within 1.0 mm of its free edges. Its rear edge (x -14.5) borders the camera_in sweep (the lock tab and heads travel x -22.97 -> -11.87 at |y| <= 7.08, z <= 82.1 after the 2 mm drop), its bottom edge (z 78.5) borders the tab/head roll in the slot, so every anchor pillar would stand in a sweep; a 45 deg self-supporting underside would have to start 1 mm below an anchor at z >= 82.5 and would move the face at the head contact (z about 81.4) out by >= 1.1 mm (a different, softer catch the r7 tine_strength estimate would misjudge); paint-on support would land on the catch face (the window margin is 0.129 mm). The -Y tine is different: its catch face (y -8.28) faces UP; only its outer faces needed support.
- 2026-10-11 T2 geometry (model.py; new functions tub_print_fixes, tab_catch_split, tub_print_parts, constants TUB_PRINT_SLOPE_DEG 50, EVF_HDMI_RECEPTACLE_Y, TAB_CATCH_*; make_tub gains 2 lines before the final fuse and 3 after cut_passages; the CATCH_SOURCE line pinned by test_j7_collar is unchanged). Every addition's underside rises at 50 deg from the bed plane (> r7's 45 deg allowance): (1) -Y tine: flange grown from the -Y wall (x -14.5..-12.5, y -25.55..-20.27, z 78.5..98) + a fill under the web's outer face rising from the flange (x -12.5..-8.2, underside y -20.28 -> -15.16, to the web at -11.28, z 78.5..98); camera side untouched. (2) LL collar insert boss: coaxial cone under the boss axis (r 6.98 at the wall x -5.1 -> r 4 at x -7.6, lower half only); boss, insert bore and screw-tip relief unchanged (r7 had declared a paint-on 'll_insert_boss_chin' for the same boss; here none is needed). (3) rear panel-screw landing: wedge under its -Y face from the floor (y 17.92 at z 2.5 -> 21.5 at z 5.5, x f+6..f+11); landing face unchanged. (4) floor tooth between the pigtail hole and the power floor hull: cut back so the hole roof rises at 50 deg from the hull's highest point (computed from PG.floor_hull: x -51.5, y -2.80) to the pigtail hole edge (x -55, y 1.37); holes only grow, no feature moves. (5) FPS pair guide: ruled loft corbel under its -Y face (y -0.32..6.0) narrowing onto the connector-rest arm (x -136..-133, z 76.3..78.05), slit kept open; HDMI ribbon cells stay 0.6 mm below (z <= 75.7, the same gap the existing rest has). (6) VN-34: relief in the EVF PCB shelf under the receptacle zone (x f+15.45..f+15.85 = PCB face + the groove clearance g - 0.8 = 0.25, y -1.5..12.5 = r7 zone y 4..17 moved with the board by EY - 16, +-0.5; z 62.9..63.8), so the PCB edge takes the -Z stop even with the board pushed +X in its groove.
- 2026-10-11 T2 +Y tine split (FP-11b, model.py tab_catch_split / tub_print_parts): joint plane TAB_CATCH_SPLIT_Z 83.5 (tab top 82.1 + 1.4); a ceiling over the slot (x -14.5..-8.2, y -8.29..8.29, z 83.5..90, into the panel-screw boss column) makes the +Y web above the joint printable (it grows from the -Y tine through the slot above every tab position); pad +1.2 on the +Y web above the joint (pocket wall). Below the joint a separate stub (the r7 boxes x -14.5..-8.2, y 8.28..20.28, z 78.5..83.5, 0.6 mm bed chamfer, 202.28 mm3) carries a tenon (x -13.5..-9.2, 1.6 thick, 3.5 high) whose -Y face lies on the catch-face plane: the pocket's -Y face is the datum (no clearance), 0.1 / 0.2 / 0.1 mm adhesive clearance elsewhere; the stub prints bed face down (catch face vertical) and is bonded at B1 print_inserts with two-part epoxy V-68, DEFAULT PENDING USER DECISION 16 (new; proposed here): bonded stub (default: it holds at lens_in, where the panel is still off, and keeps the computed catch identical), or a press fit with a printed detent, or the register's panel-held block (only valid if the lens is fitted with the panel on). make_tub returns the bonded tub (adhesive fills the clearance), so every assembly check sees the same catch faces; export_candidate writes stl/tub.stl from the print stock (stub removed, pocket open) and step+stl/tab_catch_insert (planned by export_cache.INSERT_FILES, pose -Z face down). BOM: P-tub note (two printed pieces, counted once; no count or validate() invariant changed), new consumable V-68; steps.py print_inserts text gains the bonding sentence (ASSEMBLY-VERTICAL.md block regenerated, --check current; BOM/BUY regenerated, --check passed). MEASUREMENTS-TO-CLOSE gains the G-V-PRINT tab-catch tine coupon row (bond/tenon strength, face position vs the 0.129 mm window margin).
- 2026-10-11 T2 results (scratch exports under vnfix2/T2: exp1 = the six fixes, exp2 = + the +Y split; each = a copy of ec60b42d with only the tub STEP/STL (and exp2 the insert) replaced, built by build_tub.py / build_tub2.py through run_locked from the current model.py in model.build's layout state). Tub volume 177957.01 (ec60b42d) -> 178555.13 (exp1, +598.12) -> bonded 179009.54 (exp2); exp2 print stock 178802.18 + stub 202.28 (5.08 mm3 = pocket clearance). verify_print_checks (print_overhang, print_bridge_direction, bed_chamfer, thin_wall): exp1 tub 1 region left, 48.04 mm2 = the +Y catch face only (the other 7 gone); exp2 tub print_overhang PASS (0 unsupported; supports used = the two J4 wing zones only, 20.21 mm2 each), print_bridge_direction PASS (0 failing regions, longest 27.7 mm = the pre-existing rear storage recess roof), bed_chamfer PASS, thin_wall PASS min 1.199 / p1 1.199 / loaded share under 1.6 = 0.0 (unchanged); tab_catch_insert print_overhang PASS, print_bridge_direction PASS, bed_chamfer PASS, thin_wall PASS min 1.599. verify_check_scope (all categories) exp1 and exp2: 34 pass / 0 fail / 14 info (ec60b42d: 33 / 1 / 14): evf_restraint -Z PASS gap 0.25 on tub, first contact by zone: pcb 0.25, hdmi receptacle none, hdmi plug none, bears on pcb 1.0; +X/-X/+Y/-Y/+Z, both support spans (0.26) and the no-panel control unchanged; area_parity cold margin 225.0, hot 9.6 mm2 unchanged; stack_retention, post_root_bending pass.
- 2026-10-11 T2 main audit subset on exp2 (verify_candidate.py --only j7,interference,motion,driver,assembly_state, scratch --out; compared with the committed verification.json): roll_catch 58 pass + 1 info unchanged (window centred 0.400 / 0.650 / 0.679 mm and worst 0.129 mm at every s, identical; first contact metal 1.758..4.766 deg declared, PCB/cover never; tab_catch_geometry tine_root_z 97.5 unchanged, slot first material 87.23 -> 83.50 = the ceiling, reported only; tine_strength sigma 6.88 MPa unchanged); j7_float 50 pass (tub minima overall 0.40 / lateral 0.75 / axial 0.40, identical); motion 16 pass (camera_in, camera_out, evf_out, fps and carrier motions); interference 108 pass / 1 fail (pi5/cooler, VN-69) / 9 info, same rows; assembly_state 3 pass; lens_support / lens_clamp / inserts unchanged. driver/service_driver p_carrier1/2 fail -> pass comes from the FP-11c carrier in ec60b42d, not from T2. Obstacle probes before the change (mesh SAT against every exported part, routes.build + harness_rules cable polylines, HDMI ribbon cells, FPS mated-pair box): every addition >= 1.0 mm from every part (the LL cone box only meets s_c3 inside the boss bore, which the bore cut removes) and >= 4.2 mm from every cable centreline minus radius.
- 2026-10-11 T2 plenum verifier on exp2 (manifest sources set to the current model.py / vent_geometry.py, as T1's scratch runs): 48 pass / 1 fail / 21 info, unchanged except the already-failing no_added_material_in_original_cavity, 207.675 -> 1279.487 mm3 (+1071.8 mm3 = the T2 additions, all deliberately inside the original cavity: -Y tine flange and fill, ceiling and pad, LL cone, landing wedge, pair-guide corbel). Every mouth, port, divider, CSI and facade row unchanged. The row fails on any in-cavity addition (T1 note); its scope stays with the orchestrator (not weakened here). print critical_features on exp2: 50 pass / 55 fail / 37 info and the same 4 unclassified thin spots (none on the tub or the stub) = ec60b42d, no status change.
- 2026-10-11 T2 real exporter: export_candidate.py --out scratch exp3 (all rows, current sources): planned == written (export_cache plan incl. INSERT_FILES), 47 STEP files, stl/tub.stl from the print stock, stl+step/tab_catch_insert with print pose -Z face down (translation 14.5, -8.28, -78.5; footprint 6.3 x 12.0 x 8.5), tub row volume 179009.54 = the bonded tub. verify_print_checks on exp3: tub print_overhang PASS, print_bridge_direction PASS (0 failing, longest 27.7), bed_chamfer PASS, thin_wall PASS; tab_catch_insert all four PASS (the remaining print fails are base_grip and lens_collar, other lanes).
- 2026-10-11 T2 tests via run_locked: new tests/test_tub_print_t2.py 8/8 OK (126 s): data (slope 50 > 45; joint 83.5 = tab top + 1.4 and above the tab corner / head top at any roll plus the roll_catch lateral offset; window gap at 1.4 deg >= 0.3; relief y = r7 receptacle zone y), split (stub = r7 boxes below the joint, tenon datum on the catch-face plane, pocket clearances, pocket wall >= 1.2), built tub at L 158 and 185 (bonded tub one valid solid; print stock in the -Y pose: r7 overhang and single-direction rules PASS with only the two J4 wing zones and no unsupported region; stub in the -Z pose: both PASS and bed chamfer PASS), negative control (stub left integral: FAIL with the +Y catch face, 23.5 mm2 at z 78.4..82.0), EVF (r7 check_evf_restraint unchanged in the r7 frame with the selected evf_board/panel: -Z PASS, pcb 0.25, no connector zone; control with the relief filled back: FAIL 'hdmi receptacle' 0.27). The first run had 1 failure and 3 errors in the test itself (an import before model put structural-review on sys.path; a bound that used the tab corner's highest point at 12.9 deg roll plus r7's window gap, which is not the window rule) - the test was corrected, no geometry changed. Other tests: test_assembly_state 11 OK, test_refit_state 15 OK, test_build_order_docs 23 OK, test_wiring_bom 20 OK, test_check_scope 21 OK (3 skipped), test_print_checks 11 OK, test_carrier_fp11c 20 OK, test_cross_platform_io 12 OK, test_windows_smoke 3 OK, test_repo_hygiene 17 OK (1 expected failure, pre-existing), test_driver_checks 18 OK after regenerating its record (below). Failing, not caused by T2 geometry: test_export_plan 1/6 (test_plan_covers_every_file_the_last_export_bound: the plan now holds step+stl/tab_catch_insert that the three committed variant folders have not bound yet; clears at the FP-16 re-export of all three variants, nothing to edit in the test); test_deterministic_export 1/20 (test_committed_occt_header_is_recognised expects a wall-clock OCCT stamp in the committed tub.step, but the FP-11c re-export at 06:49 already wrote the normalised 1970-01-01 header; pre-existing since that export); test_j7_collar 1/14 (Record.test_record: verification.json binds 53e668d4, the selected export is ec60b42d; pre-existing); test_coverage_gates 1/8 (COVERAGE-VERTICAL.md stale because verify_hdmi.py was edited at 08:20 by another lane).
- 2026-10-11 T2 records regenerated because the steps.py text edit made them stale: review-2026-10-10/fp07/driver-compact-kowa_lm6hc.json (verify_candidate --only driver on ec60b42d: driver 11 pass, service_driver 11 pass, coverage pass, identical to before; state model 8c9dce03 -> 5387da30; it now also records the 3 source_binding fails of the T2-edited bound sources model.py, export_candidate.py, export_cache.py, which clear at the FP-16 re-export); ASSEMBLY-VERTICAL.md print_inserts block (make_assembly_text, --check current); WIRING-VERTICAL.md (make_wiring_vertical, --check current; it was already stale from the H1 route edits, whose current qt numbers it now carries); BOM-VERTICAL.md/.csv and BUY-VERTICAL.csv (make_bom_vertical, --check passed). Still stale until FP-16 (they bind steps.py or the T2 sources): verification.json, harness-checks.json, hdmi-solid-checks.json (also stale for other reasons).
- 2026-10-11 T2 open / for others: (1) USER DECISION 16 (new): +Y tab-catch stub retention, default bonded (V-68); alternatives press fit with a printed detent, or a panel-held block that needs the lens fitted with the panel on (lens_in today runs panel-off). Please add it to the register's user decisions. (2) FP-16: re-export all three variants (writes tab_catch_insert; test_export_plan then passes), then print/check-scope/main audit/harness/plenum refresh; the PHASE1-STATUS s7 rows 'print_overhang + print_bridge_direction: tub' and 'check_scope evf_restraint/-Z' are expected to pass after it (they pass on the scratch exports above). (3) Orchestrator: verify_shadow_plenum no_added_material_in_original_cavity now 1279.487 mm3 (T2 adds 1071.8 to FP-11c's 207.675). (4) Docs lane: README/REVIEW/CHECKPOINT tab-catch text and the guide (B1 page) should name the bonded stub, the ceiling and decision 16; MEASUREMENTS-TO-CLOSE already has the G-V-PRINT tine coupon row. (5) Critical-feature re-nomination (VN-21/25): the stub bond is a new candidate joint (not in r7's CRITICAL_JOINTS); the r7 tine_strength estimate still uses the box section and the roof arm (conservative for the 5 mm stub, silent on the bond: the coupon gate covers it).
- 2026-10-11 09:15 H2 (VN-28) QT fan-in modeled (signal_routes.py, REVISION ...-v4-qt-fanin-free-leads): every QT branch keeps its root, lane and the pin-6 dogleg to Z25, then a straight S-bend to the main start X at Z33 and a 4 mm +Z tail, ending ON the main start F (-45.445, -23.4, 37), tangent to it (no invisible jump). Branch lengths 32.43 / 31.88 / 32.07 / 43.07 mm (pin 6 longest; was 27.67 without fan-in). cable_routes qt fan_in_gap 8.55 -> 0.00 mm. The QT storage variable moved from the under-tool run (knots 3,4: 'lo,hi=34.,50.') to the top run (knots 1,2): '_solve_top(qt_curve,250-qt_longest,56.,87.5)', under-tool run fixed at Z38 (QT_LOW). Why Z38: the FPS mated-carry 200 main of record lies in the same Y-23.4 lane at Z33.5; the superseded family's Z34 bound member overlapped it (centreline 0.56 vs 2.90 mm needed, found while fixing; never swept before because the member sweep checks parts only). Why top >= 56: exact member sweep run 1 hit a tub wall rib at X-64 (top about Z52) with the top-52 member (17.21 mm3); top 56 clears it. Shortest route 239.14 -> 203.54 mm (+25 allowance = 228.54 <= 240, slack 11.46); cable_stow qt family max 266.54 >= 260 (pass, member at 87.5 exact hits {}). CSI-tool legs (X-72.5, X-93.2) unchanged: computed clearance >= 0.6 mm for the installed route and both bound members (test).
- 2026-10-11 09:15 H2 (VN-28) checks extended (stricter): harness_rules.INSTALLED_CLEARANCE += qt (main d 3.2, each of the four branches d 1.6 via branch_d), so the re-solved QT route and its fan-in are swept against the closed camera, the HDMI ribbon cells and the FPS pair and kept off every other cable. FAMILIES['qt'] follows the new source literal (var top, knots 1,2, bound (56, 87.5)); test_bounds_are_source_literals binds the new literal and asserts the old one is gone.
- 2026-10-11 09:15 H2 RESULT cable_routes qt still FAILS, on a real conflict the new installed sweep found: at the nominal 250 mm solve the top run sits at Z79.23 and its 3.4 mm capsule meets the HDMI 3562 ribbon's U-turn bottom (cells Y-22.35..-21.24, Z80.15..85.85, X-64.8..-54.8; 4.94 mm3 as keepout boxes in the exact run). LATENT in 9ced753: its top run at Z87.5 overlapped the same keepouts too (0.04 mm3 box volume, CAD-free recompute). Storage that stays below the band (top <= 78.4) holds at most 205.27 + 43.07 = 248.34 mm < 260 (longest lead); a family spanning the band would put every lead of about 248-256 mm on the ribbon, so moving only the nominal solve would game the check and was not done. Options for the next lane / user (numbers): (a) shorter finished QT lead (D2-24/D2-24B are cut-to-length): window [237.3, 238.3] mm at the BOM +/-10 tolerance (not practical); [231.7, 243.3] if MP-QT shows +/-5; (b) move the QT storage loop off the ribbon band (candidates: the free Y-24..-9 gap behind the cooler fins, the controls_stow reservation) with new exact sweeps; (c) move the HDMI U-turn (frozen HDMI shape; not recommended). No choice made.
- 2026-10-11 09:15 H2 (VN-28, the FP-10 HOLD) free-lead routes: signal_routes.build() declares free_leads (knots, bend radius, OD, op, source) for qt_enc and j2_btn; harness_rules.free_lead_eval() decides a free lead's row instead of the HOLD: (1) valid rounded curve at the cable's own radius; (2) starts on the body-fixed end (QT: fan-in point after the longest branch; J2: pad root) and ends on the posed plug / far end within ROUTE_END_TOL, leaving / arriving along the installed first / last leg (<= 5 deg); (3) plug: fixed + route + reach_margin(L_min) <= L_min; inline: junction on the route junction_out beyond the opening with the centred pinch box beyond it, both gender assignments with r7 margins, hand box hits; (4) exact capsule sweep (OD + 0.2, INSTALLED_TOL 0.01 mm3) against every part present at the op with the moving set displaced by the pose (own ends exempt, r7 rule), the HDMI ribbon cells of the op's state, the FPS mated pair, and the other cables' rigid heads and header housings (keepouts, all taken as mated); (5) no envelope overlap with any cable at the op (leads free at the op enter as their free routes). The secured-lane problems are not dropped: they move to row 'secured_lane_case' (not the documented order). Without a declared route the HOLD failure is unchanged (negative control in tests). Design aid only (not evidence): 1 mm voxel occupancy of the ec60b42d STEPs + A* + knot hill-climb (scratch vnfix2/H2).
- 2026-10-11 09:15 H2 RESULT mate_reach qt_enc PASS (exact, manifest ec60b42d): free route 142.65 mm (lane exit -> over the cooler fins and the Pi top edge -> over the carrier where it is open at X-46 -> across the 60 mm prop gap -> plug from -X), fixed 43.07, need 209.73 vs L_min 240 (slack 30.27), 63 capsule pieces vs 2323 targets, hits {}, tightest separation pigtail_negative 5.28 vs 3.20 mm. mate_reach j2_btn still FAILS on its free route (80.57 mm, junction at Y46.71, both assignments feasible, min finished 116.8 mm, pinch box 0.06 mm beyond the opening): the exact sweep grazes the cooler (1.95 mm3) where the lead leaves the hypothetical pads along the installed +Z exit, and the lead starts inside the conservative 16 mm round FPC envelope (5.75 < 8.80 mm). Both trace to VN-73 (J2 pads unmeasured; H1 found the installed J2 route on the same fin) and the unmodeled FPC strip; physically the pads sit 3.4 mm behind the FPC ribbon plane. Not relaxed.
- 2026-10-11 09:15 H2 (VN-47 / VN-72) pigtail service corridor now obstacle-checked (harness_rules.corridor_clearance, CORRIDOR_OP pack_in; own ends x1203 / xt30_pair and the pack exempt; plugs / housings as keepouts; cable separation): the declared study corridor (routes.pigtail_16_study service_path) hits microsd 10.90 / 9.88 mm3 and tub 1.47 / 1.47 mm3 (positive / negative, exact) and overlaps run_pin37 (1.09 < 2.40), run_pin39 (0.96 < 2.40) and the FPC envelope (9.38 < 9.60). Both face-out rows carry these problems (gating ties row; RTV row as would_fail). Without a hit function nothing is claimed ('not swept'). lead_access pigtail_ties_on_route / pigtail_xt30_mouth and mate_reach xt30_pack stay FAIL: no carrier slot on a drawn core (nearest 31.76 mm), ties face out None / -53.53, RTV positive 12.86 < 15 mm. User decision 6 (ties vs RTV-only) untouched: PIGTAIL_RETENTION stays the candidate's 'carrier_ties'; both rows computed.
- 2026-10-11 09:15 H2 (VN-62 / VN-72) shorter path tried, then options. The installed upper paths can be much shorter (voxel A*, clearance >= 2.4 mm, design aid: positive about 80 mm vs current minimum 198.8; negative about 106 vs 207.0) but the binding length is the service corridor, not the installed path: the shortest clear corridor root -> isolation face 15 mm out is about 207 mm (positive; straight line 189.1) and 196 mm (negative; 189.0) vs the study's 238.85 / 238.63. RTV reach then needs L >= 237.0 (positive) / 220.0 (negative); at 237 the G-W5 corners are lo 0.13411, hi_cold_fuse 0.14175, nominal_hot_fuse 0.14562, hi 0.15325 V: the hi corner (vendor-minimum strands, lay 1.03, hot fuse x1.3) still fails by 3.25 mV, so no shorter path alone passes 0.150 V (hot boundary 225.4 mm < 237). pigtail_drop decision_data gains by_finished_length_mm (220..280 mm: four cases, 14 AWG nominal, cut-off raise): at 270 hi 0.16254 V (+12.54 mV needed), 14 AWG nominal hi 0.13245 V (OD / bend / lane re-check open), cold-fuse vendor-minimum 0.15103 V. A measured hot-fuse factor <= about 1.21 would pass at 237 mm but not at 270. 0.150 V never relaxed; no default taken for user decision 4 (pigtail stays the 270 mm allocation of record; cable_routes pigtail_positive / negative 251.8 / 250.9 + 27 > 270 stay FAIL).
- 2026-10-11 09:15 H2 (VN-43) HDMI carried margin and unplug corridor (verify_hdmi.py): the carried sweep now carries the EVF head and the ribbon stroke + 3 mm low (CARRIED_DROP_MM = 6.0 snapshot stroke + 3.0 = 9.0; head top Z54.8 vs mated 63.8); the carried ribbon is hdmi_routes.ribbon300(158, drop=9), the generator that reproduces the snapshot's installed and premate ribbons to 1.4e-14 mm (test), full 300.0 mm, 2283 cells. New rows service_access/evf_head_unplug_jaw_minus_x, _jaw_plus_x, _shank: smooth-jaw pliers on the head's thin X faces over its +Y 8.0 mm and lowest 9.4 mm, swept down the 6 mm stroke, shank to 10 mm beyond the opening (r7 layout.ACCESS acc_hdmi_evf_jaws / acc_hdmi_evf_pliers_svc tool numbers), against every material part before svc_evf_unplug and the installed ribbon cells (exact). Run via run_locked (manifest ec60b42d): 16 pass / 0 fail / 0 info (was 13/0/0): carried sweep 225 exact intersections, 0 hits at drop 9; the three corridor boxes meet no material and no ribbon cell. Report binds hdmi_routes.py and routes.py (carried_ribbon_source_sha256). Physical grip / finger reach stays the MEASUREMENTS-TO-CLOSE HDMI-heads row.
- 2026-10-11 09:15 H2 records via run_locked (manifest ec60b42d): verify_harness_checks.py -> out/compact-kowa_lm6hc/harness-checks.json (sha 561f2d29) 33 pass / 8 fail / 20 info (H1: 32 / 9 / 20): qt_enc leaves the failing set; failing now cable_routes pigtail_negative, pigtail_positive, qt; lead_access pigtail_drop, pigtail_ties_on_route, pigtail_xt30_mouth; mate_reach j2_btn, xt30_pack. H1's rows unchanged (run leads, usb_5v, pack_lead, feed volumes pass). verify_hdmi.py -> hdmi-solid-checks.json (sha 9d0ac0fa) 16 / 0 / 0. Scratch run 1 (top bound 52) is superseded (rib hit); both runs' logs: scratch vnfix2/H2/harness1.log, harness2.log, hdmi1.log.
- 2026-10-11 09:15 H2 tests via run_locked: new tests/test_h2_harness.py 21/21 (fan-in end/tangent and the gap rule with the 9ced753 branches as negative control; family minimum / stow; bound members vs the FPS harness with the superseded Z34 member as negative control; CSI-tool clearance computed; branch sweep with a planted part; free lead pass, HOLD without a route, a 10 mm shorter lead fails, end / tangent rules, planted part on the route, moving-set displacement (a rider planted 60 mm toward -Y is hit at the propped pose), J2 fails only on the FPC envelope CAD-free; corridor sweep with a planted part and 'not swept' without hits; drop table monotonic, 225 passes / 237 fails, limit 0.15; ribbon300 reproduces the snapshot, carried drop = stroke + 3, r7 tool numbers; bound-report rows). test_harness_checks 24/24, test_wiring_bom 20/20, test_h1_feed_routes 17/17, test_routes_source 10/10, test_routes_source_fix 7/7, test_cross_platform_io 12/12, test_build_order_docs 23/23, test_repo_hygiene 17 OK (1 expected failure, usb_head, FP-16), test_evidence_numbers 8/8, test_wire_terminal_rules 5/5, test_coverage_gates 8/8 (after the classification and the coverage refresh below). test_evidence_tooling 12/15: the same three failures as before H2 (docs-audit fixture checkpoint_claim, foreign_manifest_report on 53e668d4-bound reports, stale-report index 53e668d4 vs ec60b42d; FP-16), not caused here.
- 2026-10-11 09:15 H2 test changes and why (no tolerance or accepted set loosened): test_harness_checks: test_bounds_are_source_literals binds the new QT literal and asserts the old one is gone; test_recompute_and_minima QT minimum 239.14 -> 203.54 (route of record changed); test_qt_documented_order_fails_now -> test_qt_documented_order: the HOLD assertions kept as the negative control (free_leads removed -> both rows fail on the HOLD with the secured-lane shortfall), plus qt passes on its free route with the shortfall kept in secured_lane_case and j2 fails; _plug_fixture and test_j2_halves_shortened_10mm_fail judge a lead free at its mate on its free route (a 10 mm shorter lead / halves must still fail; the junction predicate accepts the free-route wording 'junction ... cannot'); member-sweep fixtures follow the new bound (top 87.5); test_stow_and_route_fixtures: the route of record passes, a 200 mm minimum lead fails 'shortest route'; EXPECTED_FAILING drops only qt_enc (now computed pass). make_coverage_vertical.py: KIND ('hdmi','service_access') = geometric and R7_MAP mate_paths -> partly (the EVF HDMI unplug ACCESS rows only); coverage outputs regenerated (--write: COVERAGE-VERTICAL.md, README/REVIEW blocks, CHECKPOINT-STATUS.json; batch geometric 167 / 71 / 64, r7 21 ported / 4 partly / 1 report only / 10 not ported; hdmi now fresh).
- 2026-10-11 09:15 H2 docs / generated: WIRING-VERTICAL.md (make_wiring_vertical.py; QT installed 206.93, shortest 203.54 + 25 vs 240, slack 11.46: the length rule, which passes) and BOM-VERTICAL.md/.csv (make_bom_vertical.py: binds the new HDMI report); both --check exit 0. MEASUREMENTS-TO-CLOSE QT row names the free-lead gate and the branch sweep; ASSEMBLY-VERTICAL.md step 6 details give the computed prop-pose reach (QT 30.3 mm spare on 240; J2 blocked by VN-73). Snapshots of every edited source before editing: scratch vnfix2/snap/H2 (WIRING / BOM / coverage outputs are generated: regenerate after any rollback).
- 2026-10-11 09:15 H2 open / for others: (1) QT storage vs the HDMI U-turn (above): a route redesign or a QT cut-length decision; (2) j2_btn: VN-73 (measure J2, then re-declare its free route; the installed J2 route meets the same fin, H1); (3) the FPC 16 mm round envelope (RIBBON_D, H1) blocks any lead near the ribbon (J2 pads, pigtail corridor 9.38 < 9.60): a measured FPC developable shape (MTC camera-cable row) would replace it - not relaxed here; (4) member_clearance (fixup-1) sweeps family members against parts only: the QT spare-home member at top 87.5 overlaps the HDMI ribbon keepouts by about 0.06 mm3 (box volume, CAD-free) - include ribbon cells there when the QT storage is redesigned; (5) user decisions 4 (G-W5 branch) and 6 (ties vs RTV) untouched, no defaults taken; the pigtail corridor obstruction (microsd, tub, run leads) applies to both retention choices; (6) MATE_POSES j2_btn halves still carry the superseded Molex names with conservative 144 / 219 mm lower bounds (D1 note; lengths unchanged).
- 2026-10-11 09:15 H2 check-change justification (for the verifier): (a) free_lead_eval is the computation the fixup-1 HOLD named ('fails until a free-lead route from the header end is computed and obstacle-checked'); it keeps every r7 mate_reach element (reach_margin, hand envelope with out_of, strict sweeps, own-end exemption only) and adds stricter ones (rigid heads / housings as keepouts, cable separation, start / end tangent along the installed legs); the secured-lane result is retained in secured_lane_case; tests prove a missing route, a shorter lead, an end or tangent off, a planted part on the route and a displaced rider each fail. (b) FAMILIES['qt'] is route data that must equal the source literal (tested). (c) INSTALLED_CLEARANCE += qt, the branch sweep and corridor_clearance only add failure modes. (d) by_finished_length_mm is information; the drop row's status still comes from drop_hi <= 0.150 V at 270 mm.
- 2026-10-11 10:59 C2 FP-11d (VN-55) collar lug (snapshots vnfix2/snap/C2): model.collar_setup spaces the s_c4 lug as r7 does (r7 layout COLLAR lug: relief -27.0, screw -31.0, face -35.0 = 4.0 / 4.0; 9ced753: -22.8 / -26.3 / -30.0 = 3.5 / 3.7). Named constants: COLLAR_BIT_RELIEF_Y -22.8 (unchanged), COLLAR_SCREW_Y -26.3 -> -26.8 (s_c4 head_point/tip, insert and driver line follow), COLLAR_LUG_Y_OUT -30.0 -> -30.8. Margins = r7's: washer 0.5 mm to the relief (0.3 at the 0.2 float), r 3.9 flat-support footprint 0.1 mm inside the lug face, dia 6.5 bit 0.75 mm from the relief (driver s_c4@lens_float and svc_s_c4_loosen: bit gap 0.75, was 0.25), lug wall outside the dia 4.0 insert bore 1.7 -> 2.0 mm. A first version moved the relief instead (y_out -30.3, relief -22.3, screw kept): the washer rows passed, but the body wall between the relief and the Kowa bore that verify_candidate reports as nominal_features/collar_relief_nominal_after_bed_chamfer (hypot(relief, 6) - 21.15 - 0.6) would have dropped from 1.83 to 1.34 mm, under its 1.6 minimum. It was replaced before the final export; that row still reads 1.826 and is still true.
- 2026-10-11 10:59 C2 FP-11d (VN-58) LR foot: new model.lr_foot_support / model.make_collar. make_collar = r7 printed_collar.build_part in the candidate layout, fused with a cone on the LR foot axis: r 3.8 at the body rear face (x 0.3), radius falling 1 mm per 1.2 mm toward the bed (about 50 deg from the bed plane), kept only outside r 24.5 about the lens axis, so it cannot reach the bore, the cone seat or the rear land. The union is not cleaned (clean() moved the volume by about 0.001 mm3 on these collars). model._build uses make_collar. The support adds 31.44 mm3 (exact GProp). Shape.Volume() over-reads the whole union by 0.22 mm3 on its cone faces: the manifest says 11255.05 mm3 where the exact value is 11254.83. The roundtrip row uses the same function, so it stays consistent. Kowa collar 11137.50 -> 11255.05 mm3 (manifest reading).
- 2026-10-11 10:59 C2 check-side change, with reasons (collar): j7_collar_checks.context_rows and lens_collars rebuilt the collar with r7 printed_collar.build_part. Their collar_context_match rows claim "the rebuild in the candidate context == the manifest-bound STEP". r7 build_part cannot make the candidate-only LR support, so those rows would fail on a correct collar. Both calls now use model.make_collar, the builder model._build uses, so the rows still prove what they claim and still fail on any other difference. Thresholds and logic are unchanged. Result: kowa and fujinon collar_context_match pass, symmetric difference 0.0. Docstrings are updated.
- 2026-10-11 10:59 C2 test pins, with reasons: tests/test_collar_r7_mechanical.py loses the two washer expectedFailure marks (both tests now pass) and its EXPECTED_FAILURES tuple shrinks to the r7 prepare_print test. Its two context asserts move from screw_y -26.3 to -26.8: they pin the candidate value that the fix changes. tests/test_j7_collar.py: EXPECTED_FAILURES held only the four FP-11d washer rows and is now {}, so any failing FP-08 row fails test_record. Its source pin now reads the named constants. test_washer_rows now asserts that the bound collar passes with r7's margins (0.1 / 0.5, min gap 0.3); it used to assert the VN-55 failure. tests/test_print_checks.py test_bridge_rows_reproduce: the hand-built zone set now includes model.grip_support_zones, the same declarations the verifier uses (candidate_state).
- 2026-10-11 10:59 C2 'Invalid collar print union' (PHASE1-STATUS s9), cause found. r7 prepare_print runs sh.fuse(*disks).clean() on the shape it is given. On the candidate Fujinon collar, the same-domain cleanup rewrites sub-shapes that the fused stock still shares with `sh`, so `sh` turns invalid (isValid and BRepCheck both False, volume read 13053.25 instead of 12654.80). r7's own check sh.cut(prepared) then reports 13051.85 mm3 'removed'. Any later union on that shape (model.collar_print_stock) fails. On a copy, fuse + clean gives a valid stock that removes 0.0 mm3, and the Kowa collar is not affected. The geometry is not at fault. r7 code is read-only, so test_print_stock_is_exactly_three_removable_membranes stays an expected failure. The candidate path copies its input and skips clean(). Pinned by tests/test_c2_collar_grip.py test_r7_prepare_print_corrupts_its_input.
- 2026-10-11 10:59 C2 FP-11e (VN-57) base grip rear J4 pocket. The pocket ends at x -64.75 (tongue_r base_pocket). Two cuts removed its +X end wall, so the pocket floor (a roof when the grip prints +Z down) had no anchor there: the power passage box (x >= -66, y -12.4..9) and the base pigtail opening (layout FLOOR_HOLES pigtail moved to x -65.8..-55, y -8..2, cut through the base by printed_grip). model.grip_passage_wall gives back x -66..-63.25 for y -4..9, z -10..0, minus the rear keyhole and every power capsule and fuse pocket (power_geometry.local_cutters); it is fused after the r7 cuts. This puts the wall 1.5 mm past the pocket end and carries the floor to it. Clearance to the installed XT30 pair/fuse and to all 201 rigid service poses (junction and pack, built as verify_power_service builds them) is 1.145 mm. For y < -4, the installed fuse, the negative core and the service sweep need the passage to x -66 (a wall there overlaps the installed pair by 50.0 mm3). That band therefore gets the one declared paint-on support zone, model.grip_support_zones 'grip_rear_pocket_passage_band' (x -82.75..-65.8, y -12.6..-3.8, z -5.7..-5.1). The zone lies inside the neck-slot footprint (|y| < 13.25), so the supports stand on the bed through the neck slot and window and never on the keyhole lips. They touch only the pocket floor, which has the 0.25 mm slide gap and carries no J4 load. power_geometry.py is unchanged.
- 2026-10-11 10:59 C2 declaration plumbing, with reasons: print_rules.candidate_state now returns zones['base_grip'] = model.grip_support_zones(tongues) next to the tub's J4 wing zones. The register's fix text for VN-57 is "declare a support zone off the J4 mating faces". The zone is design data in model.py, built from the trial tongue rows. It refuses to build if it leaves the neck-slot footprint, and the stale-zone rule still fails it if no region needs it. No check, threshold or rule changed. Negative control (test_c2 test_zone_needed_and_sufficient): the r7 overhang rule fails the grip without the zone and passes it with the zone, using only that zone.
- 2026-10-11 10:59 C2 feather edge (FP-09 note). The s_j counterbore (dia 7.0, z -8..-2) at y -22 broke through the narrowed base's -Y face (y -25.2) over x -111 +- 1.4, leaving 0.1-0.4 mm walls beside the opening. model.sj_side_wall adds a local wall outside the face: r 4.9 about the screw axis (1.4 mm round the bore, 1.7 mm proud, 1.1 mm inside the tub's -Y face at -28), z -8..-2.9, then a cone to r 3.2 at z -0.7. The cone is 52 deg from the bed plane and ends below the 0.6 mm bed chamfer. Counterbore, clearance hole and head seat are unchanged. Nearest other parts: p_grip head 0.2 mm (inside the bore), tub 0.7 mm. base_grip thin_wall min 0.373 -> 1.393 mm, and no unclassified thin spot remains on base_grip.
- 2026-10-11 10:59 C2 found while fixing (base_grip, latent). (1) The passage box ends at x -35.0 and the run-lead drop (ko_run_drop) starts at x -34.0, leaving a 1.0 mm wall over y 6.25..9; below y 6.25 the run-button drop opening joins them. The wall surfaced as thin spots of 0.999 mm at x -34.0 once the base faces were re-unified. model.GRIP_RUN_WALL gives back x -35.6..-35.0 over y 6.25..9, making the wall 1.6 mm; the junction sweep and the installed pair stay >= 12.9 mm away. A first version over y 1.5..9 left a free-standing 0.6 mm slab where the switch drop is open (thin spots 0.599 on export 3fa2e287). It was corrected before the final export. (2) bed_chamfer base_grip was 39.0 mm: JG.entry_floor_stock re-squared the front top edge (x -0.5) over y -19.5..19.5. make_base_grip cuts r7's own 0.6 x 45 deg slab chamfer back there; the row now reads 0.0.
- 2026-10-11 10:59 C2 J4 slide clearance row (FP-11e evidence; new and stricter). New candidate-vertical/j4_slide_checks.py, registered with one line in verify_candidate.py behind want('clearance'), category 'clearance'. It adds two kinds of row. (a) r7 checks.check_clearances, unchanged, for the two J4 zones of r7 clearance_zones on the bound tub/base_grip in the trial layout; pass at min gap >= 0.9 x SLIDE. (b) 'J4 <tongue> slide path': the tongue (tub material inside the r7 zone) moves +X 0..10 mm, then up through the window until the head clears the base top, in 0.5 mm steps against the grip; pass with no overlap and min gap >= 0.9 x SLIDE. make_coverage_vertical: ('main','clearance') is geometric, and r7 'clearance' moves to partly. The COVERAGE outputs regenerate in FP-16.
- 2026-10-11 10:59 C2 exports via run_locked (each about 5 min; both variants, so the j7 Fujinon context row binds a current STEP): compact-kowa_lm6hc manifest b00c1462 and compact-fujinon_hf6xa c84d800a. They include the other lanes' model state at 09:56. Interim exports were superseded within the lane: 8c524dc4 (no front chamfer), 3fa2e287 (run wall over y 1.5..9) and aef8e6bd (relief-moving lug). Kowa base_grip 66883.97 -> 67212.29 mm3, collar 11137.50 -> 11255.05 mm3, assembly 877.435 g, dimensions unchanged at 248.834 x 72.815 x 216.821.
- 2026-10-11 10:59 C2 results on b00c1462, all via run_locked:
  - verify_print_checks: print_overhang 11/11 pass and print_bridge_direction 11/11 pass. base_grip passes with zone use of 6.67 mm2 (r7 rule; was 102.94 mm2 unsupported) and 120.04 mm2 (single direction; longest bridge 24.7 mm). lens_collar passes with 0 supports (was 11.0 mm2) and a longest bridge of 7.2 mm. bed_chamfer: base_grip 0.0 mm (was 39.0) and lens_collar 7.85 mm (was 7.05; see open item (b)). thin_wall 10/10. base_grip min 1.393 / p1 1.599; lens_collar min 1.793 / p1 1.849 with a loaded share < 1.6 of 0.0. unclassified_thin_spots: 3 info rows left, all on the carrier and panel; none on base_grip or the collar.
  - verify_candidate --only j7 (record review-2026-10-10/fp08/j7-compact-kowa_lm6hc.json): 326 pass, 0 fail, 16 info. j7_float 50 pass, roll_catch 58 pass + 1 info, lens_support 41 pass + 5 info, lens_clamp 8 pass + 2 info (washer_flat_support kowa/fujinon unsupported 0.0; washer_free_seat min gap 0.3 at the float), inserts 4/4. Collar gauge rows pass.
  - verify_candidate --only interference,motion,driver,clearance (new record review-2026-10-10/c2/main-c2-compact-kowa_lm6hc.json): 316 pass, 1 fail, 18 info. The only fail is interference pi5/cooler 79.902671 mm3 (VN-69, hardware); collar and grip have no interference. Motions 16/16 pass, collar_off included. Driver 11/11 and service_driver 11/11 pass. Clearance 4/4: both r7 J4 zones have min gap 0.25 (need 0.225), and both slide paths ran 33 samples with min gap 0.25 and no overlap. Source_binding 73/73.
  - verify_candidate --only driver (FP-07 record refreshed on the new manifest): 188 pass, 0 fail, 8 info.
  - verify_power_service: pass, 201 poses, 659 exact intersections, 0 hits.
  - verify_wire_solids (power-csi-clear snapshot): pass, 44 obstacles.
  - verify_print_meshes: 0 fails.
  - verify_microsd_service: closed case REJECTED (by design); panel-off 4 pass / 0 fail / 2 info.
  - verify_harness_checks: 33 pass / 8 fail / 20 info. The 8 are the known qt, pigtail_positive/negative, mate_reach j2_btn and xt30_pack, and lead_access x3; no new fail.
  - verify_check_scope: 32 pass / 2 fail / 14 info. The 2 fails are j4_screen compact-kowa_lm6hc and compact-fujinon_hf6xa, open item (a). The envelope row passes, governed by original-kowa at 1.00 N m.
- 2026-10-11 10:59 C2 tests via run_locked:
  - new tests/test_c2_collar_grip.py: 18/18 OK (37 s).
  - test_collar_r7_mechanical: 15 OK, 1 expected failure (r7 prepare_print).
  - test_j7_collar 14 OK, test_print_checks 11 OK, test_driver_checks 18 OK, test_cross_platform_io 12 OK, test_build_order_docs 23 OK, test_carrier_fp11c 20 OK (2 skips), test_assembly_state 11 OK, test_harness_checks 24 OK, test_h1_feed_routes 17 OK, test_tub_print_t2 8 OK, test_plenum_trial2 17 OK, test_wire_terminal_rules 5 OK.
  - Failing, not by a C2 defect:
    - test_check_scope 1: J4Screen.test_per_variant_and_envelope, open item (a).
    - test_evidence_numbers 3: the structural refresh refuses changed rows base_grip, lens_collar and s_c4; open item (a).
    - test_coverage_gates 1: the outputs embed the manifest hash; regenerate in FP-16.
    - test_evidence_tooling 3: foreign-manifest reports in the selected folder, the stale report index and checkpoint_claim. The same three followed the FP-11c re-export; they clear in FP-16.
- 2026-10-11 10:59 C2 OPEN, for the orchestrator.
  - (a) The base_grip geometry change (+328.33 mm3, +0.211 g, near z -5) makes the J4 free-body transfer refuse, as designed: check_scope.j4_screen sees "lower free-body rows changed: ['base_grip']", and structural-review/update_concealed_vent_structure.py check_changed refuses base_grip, lens_collar and s_c4. Both C2 grip fixes (the VN-57 end wall and the feather wall) and the front chamfer necessarily change that lower row. The upper body that loads J4 is unchanged by C2 except the collar (+0.126 g) and s_c4.
    - If the old transfer were applied regardless, the base_grip change would move the 5g floor moment by about -0.05 N mm of 1720 (0.003 %).
    - No check or guard was edited. The options are a new free body, an exact lower-row subtraction from the bound STEPs (a check change), or reverting the grip geometry.
    - lens_collar and s_c4 are upper-body rows; like C1's carrier, they would have to join ALLOWED_CHANGED_ROWS once (a) is settled.
  - (b) bed_chamfer lens_collar 7.85 mm. r7 printed_collar._outer_bed_chamfer leaves the upper-lug top edge sharp on purpose (review A1, to keep the washer bearing plane). The r 3.9 washer footprint reaches the front face, so a 0.6 mm chamfer there would leave 1.69 mm2 of the footprint unsupported and fail washer_flat_support. The edge is 8.0 mm long now (lug 0.8 mm wider); it was 7.2 mm. This is a conflict between the r7 design rule and the new T1 check. It needs a declared bed-chamfer exception with the A1 reason (a check-side decision) or a lug redesign.
  - (c) The lens_collar critical_features probes collar_lug_upper and collar_lug_lower (r7 origin y -34.15) and collar_foot_ll are still stale-origin rows (8.2 re-nomination, not C2).
  - (d) The user decisions are not touched and no defaults were taken.
  - (e) Not committed.
- 2026-10-11 CF (VN-21, VN-25: critical_features re-nomination, PHASE1-STATUS s8.2). Snapshots: scratchpad vnfix2/snap/CF (model.py 3edbf20a, print_rules.py c62d581f, verify_print_checks.py 77fd6c94, print-checks.json of b00c1462). Phase-1 state on b00c1462: critical_features 50 pass / 55 fail / 37 info (the 56 of FP-09 less the base_grip feather C2 closed). Dry run of the new registry on b00c1462 (scratch report, 77 s): 111 / 3 / 7, the 3 being carrier_tie_bar_3, its joint and the panel clamp thin spot fixed below.
- 2026-10-11 CF registry: new candidate-vertical/critical_features_vertical.py (data + build()). print_rules.candidate_state passes its CRITICAL_FEATURES / CRITICAL_JOINTS / NONSTRUCTURAL_EXCEPTIONS / EXPECT_OUTSIDE into the LayoutView and adds tab_catch_insert to LOAD_BEARING_PARTS (beside the carrier); r7 checks.py and layout.py are untouched and still do all grading. Every one of r7's 114 CRITICAL_FEATURES ids is accounted for exactly once (build() raises otherwise): 32 KEEP, 30 RENOMINATE, 52 RETIRE; 37 ADDED.
  - KEEP (r7 origin measures the same feature; values equal r7's own out/checks.json except the J4 trial head/lip 2.4): tongues (wings 2.4, necks 8.0), keyhole lips 2.4, tub_front_wall_lr_foot 2.5, tub_lip 1.2, tub_insert_boss_tl/tr 2.0, collar_foot_tl/tr 2.1, lr 7.6, panel_cam_keeper 3.33, grip_column_wall 2.5, base_tripod_wall 2.3, grip_front_wall_pad_top 1.75, cap lips 1.696, the 3 G-CAP-1 flexures (info, gated), the 6 cap entries.
  - RENOMINATE (same id, part, min_mm and class; origin derived from model.py numbers; replaces=dict(origin, why) as r7 replace_feature): tub_front_wall_seat 2.5 (r7 origin gave the 5.2 plate outside the r 4.3 recess), tub_j4_lock_boss 2.75 (lock at y -22; r7 origin measured 6.928 beside the boss), tub_insert_boss_ll 2.0 (LL at (18, 30), +Y side), EVF rails/collar (F -158, axis y 11): wall_bot_px 1.3, wall_top_mx/px 1.3, floor_bot 2.25, roof_top 1.25, end_bot 23.7, end_top 31.3, collar_radial 24.35, collar_axial 4.4; panel_wall 2.8, panel_evf_clamp_prong 3.233, panel_evf_stop 2.6, the 6 encoder hook/tooth probes moved by CONTROL_MOVES (8, -7, 21): 1.6 / 1.62; collar_foot_ll 2.1, collar_lug_upper 2.3 / lower 2.0, collar_wall_min 2.434 (bore to the s_c4 bit-relief corner, the ring's thinnest section; r7 origin lay outside the r 25 body in the outline toward the LL ear, 6.516); base_strap_bridge/web 4.0, base_sj_head_floor 2.0; grip_strap_bar and grip_heel_slot_end 3.5 along z (heel doubler: x depth 5.5 / 5.815, r7 2.5 / 2.59, so the narrowest section is the height between the lower slots). Latent: nine r7 rows PASSED on a different section than their feature (tub_front_wall_seat 5.2, tub_j4_lock_boss 6.928, tub_evf_groove_wall_bot_mx 1.95 = the +X wall, wall_top_mx 1.3 = the +X wall, wall_top_px 3.277 = another rib, collar_wall_min 6.516, grip_strap_bar 5.5, grip_heel_slot_end 5.815, base_sj_head_floor 2 mm off the moved screw axis); all re-nominated or retired.
  - RETIRE (reason per probe in the module and in print-checks.json critical_feature_registry): hood hooks/teeth/ledges/band/groove lip (hood merged into the tub), panel tongue + tooth, end lands, locate ribs (flat panel, screwed top edge), panel_boss_b1/b2 wall + cap and base_sb1/sb2 floors (s_b1/s_b2 not built; four of these were passing on the plain plate, chords 2.8 / 93.8 / 90.5), panel_post_f_wall and tub_pad_* (s_r screws replaced by +Y p_panel screws), keeper_* and tub_keeper/pi bosses and hood_stack_post (stack on the carrier; tub_pi_boss_0/2 were passing on the plenum skin), hood_foot_hole_* (no hood plate), hood_tab_catch_p/n (tines on the tub and the bonded insert), tub_rib_l_tip (no gusset), tub_evf_groove_wall_bot_mx (not built: evf_support cuts the bottom -X groove wall over the whole groove; the -X arrest is the top-rail wall and check_scope evf_restraint). r7 exceptions: exposure_label_glyph_ridge re-nominated with the panel engraving (make_panel moves the items +8 x, +21 z; the d848d413 panel screen found a 0.233 sample at (-57.53, 27.81, 57.45) on that label, points every 2.5 mm along it), _2 merged into it, the other 4 retired (through anti-rotation slot, no badge, hood removed, no stick-rail sample); EXPECT_OUTSIDE of wall_bot_px retired (no 5 V relief).
  - ADDED (class floor and r7 analog never undercut, tested): JV1 tub_roof_plate / tub_wall_minus_y / tub_wall_rear 2.5 (analog hood_band); JV3 panel_boss_p1..4_head_floor 2.1 (analog base_sj_head_floor), tub_panel_boss_p1..4 3.25 (analog tub_keeper_boss_s_k1, 2.25 floor), tub_panel_landing_rear 5.188; JV9 carrier_kit_boss_a..d_head_floor 3.0, carrier_ear_c1/c2_head_floor 2.6, tub_carrier_boss_c1/c2 3.55 (2.25 floor), carrier_arm 8.0, carrier_locator_tongue 5.0, tub_locator_seat 2.625, panel_locator_stop 5.65; JV9_carrier_ties carrier_tie_bar_1..4 2.6 / 4.361 / 0.877 / 3.1; J7 tub_foot_recess_tl/tr 5.2, ll 5.591, lr 2.289 (analog hood_foot_hole_*), tub_tab_catch_n 10.621 and insert_tab_catch_p 3.0 (wing 2.4, analog hood_tab_catch_*), insert_tab_catch_tenon 1.6 (lug); J8 tub_evf_floor_relief 1.4 (T2 VN-34 relief), tub_evf_collar_ring_end 2.359 (the half collar's narrowest section).
  - Joints by r7's own fork rule (candidate-fr1 'FR integrate'): JV1_integral_roof supersedes J1_hood_hooks; JV3_panel_screws supersedes J3_panel_tub and J2_panel_tongue; JV9_carrier supersedes J9_pi_keeper and J9_stack_stop; each requires its own ids plus the superseded joints' non-retired ids and lists them in `replaces`. New JV9_carrier_ties. Kept: J4 (minus s_b floors), J6, J7 (+ tab_catch_insert, recesses, tines, tenon; minus hood/rib ids), J8 (+ relief, ring end; minus bot_mx), J12, J13_grip, J13_strap. r7 REQUIRED_JOINT_IDS unchanged: the superseded ids are accepted by r7's check only through the validated fork joints.
  - One candidate exception: kit_boss_lead_in_rim (carrier): the 0.7 deep r 3.35 lead-in at the bed face leaves 4.5 - 0.6 (bed chamfer) - 3.35 = 0.55 at the face, 0.6 measured 0.05 under it, 1.15 at the chamfer root, where the boss is free; the head bears on the pocket floor (3.0). It classifies the two phase-1 carrier samples 1.142 / 1.149.
- 2026-10-11 CF check-side changes, with reasons (no rule, floor, accepted set or r7 file changed): (1) print_rules.candidate_state hands the candidate registries to the LayoutView instead of r7's (the re-nomination itself; r7's check reads them the same way). (2) tab_catch_insert joins LOAD_BEARING_PARTS: it carries the +Y camera tab catch (r7 hood_tab_catch_p, a J7 structural wing), so r7's coverage rules now also demand a structural entry and a joint for it (stricter). (3) verify_print_checks.py binds critical_features_vertical.py in check_sources and writes the accounting as critical_feature_registry (report only; no row changes). (4) EXPECT_OUTSIDE is empty for the candidate (r7's only declaration, wall_bot_px offset -0.5, named the r7 5 V relief; keeping it would itself fail as a stale declaration on the re-nominated span).
- 2026-10-11 CF CAD fix (real thin material, thin-spot gate): the panel EVF clamp starts at f+2.6, 0.5 behind the plate's rear edge (-length+3.1); over that strip the r 14.4 bore left a 0.2 mm crown skin (thin spot 0.312 at (-155.05, 25.6, 79.51), chord 0.2 at x -155.1, z 78). model.make_panel now cuts the strip where its skin would be under MIN_WALL 1.2 (x f+2.5..-length+3.1, |z-78| < sqrt(14.4^2 - (22.6-1.2-ey)^2) = 5.273). Removed 2.787 mm3 (bbox x -155.40..-154.90, y 24.40..25.60, z 72.73..83.27); nothing added. The plate-backed crown (2.6 at x -153.8) and both prongs (3.233) keep their full length; skin at the cut edge 1.251 (z 72.6). Scratch build: thin_wall panel pass, no sample under 1.2.
- 2026-10-11 CF REAL DEFECT, needs a design decision (not fixed): carrier_tie_bar_3, the bar outside the tie slot (-34, 25) on the right rail, is 3.5 at y 18.2, 2.462 at y 20.1 and 0.877 at y 22.0 (bar floor 1.6, analog base_strap_bridge): the FP-11c power-nut relief cone (r 11.8 at the bed face about (-20, 25.5)) cuts the rail back to x -31.8 at the bed face while the slot ends at x -32.5. No relief geometry keeps the nut reserve (r 11) clear and leaves 1.6 there; the slot must move (x -35 gives 1.7 outside and 2.5 inside at the bed face; or z 31 gives 1.81 at the slot corner) or the tie anchor be dropped (user decision 6, RTV-only). Moving it changes harness_rules.TIE_SLOTS_XZ (H lanes, tie_slots_in_step / pigtail_ties_on_route), so it is left for the orchestrator. The row and JV9_carrier_ties fail; tests/test_critical_features_cf.py carries test_carrier_tie_bar_3_passes as an expected failure (remove the mark when the slot moves).
- 2026-10-11 CF exports via run_locked (the panel fix changes model.py, so both variants C2 had exported were re-exported): compact-kowa_lm6hc manifest d848d413 (5 min 43 s; mass 877.4325 g, C2 877.435; dimensions unchanged 248.834 x 72.815 x 216.821), compact-fujinon_hf6xa 0c557761 (5 min 8 s; 764.013 g). Both bind model.py 8c5de680.
- 2026-10-11 CF results on d848d413, all via run_locked:
  - verify_print_checks (full, out/compact-kowa_lm6hc/print-checks.json, sha 99ac45db): critical_features 112 pass / 2 fail / 8 info (b00c1462 phase-1 state: 50 / 55 / 37). Failing: carrier_tie_bar_3 0.877 and its joint JV9_carrier_ties (real defect above); nothing else. Info: the 3 G-CAP-1 flexures, J6 (gated), hood / pi_keeper coverage (parts removed), the 2 exceptions. thin_spot_classification pass (unclassified 0; the kit-boss rim and exposure-label samples classified by their named exceptions). Joints J4, J7, J8, J12, J13_grip, J13_strap, JV1, JV3, JV9 pass; no REQUIRED_JOINT_IDS row fails (J1, J2, J3, J9_pi_keeper, J9_stack_stop accepted only through the validated fork joints). Coverage passes for tub, panel, base_grip, cap, lens_collar, carrier, tab_catch_insert. Other categories unchanged from b00c1462: print_overhang 11/11, print_bridge_direction 11/11, bed_contact 1/1, thin_wall 10/10, bed_chamfer 8 pass / 3 fail (eyecup 122.34, lens_collar 7.85, panel 489.8 mm, all pre-existing T1/C2 items, untouched).
  - verify_candidate --only interference,motion (record review-2026-10-10/cf/main-cf-interference-motion-compact-kowa_lm6hc.json): 289 pass / 1 fail / 18 info in 491 s; against the C2 record (b00c1462) the 118 interference and 16 motion rows have the same ids and statuses (108 / 9 info / 1 fail pi5/cooler, VN-69; 16 motion pass) and the only changed number is the info row eyepiece/panel (the modelled 0.1 mm radial EVF clamp pinch, G-EVF-1 open): overlap 5.403555 -> 4.863836 mm3, the 0.54 mm3 the removed strip shared with the spigot.
  - tests: new tests/test_critical_features_cf.py 11 tests OK, 1 expected failure (test_carrier_tie_bar_3_passes): accounting partition, limits never lower than r7 (graded minimum incl. class floor; added entries >= analog), retire reasons and successors, fork-joint union rule and r7 REQUIRED_JOINT_IDS untouched, exceptions and tie slots = harness_rules; bound report: binding + registry record, every probe at its design value (67 pinned) or r7 own value (32 kept), rows pass except the named defect, thin-spot gate pass with both exceptions backed by a report sample or a fresh chord (kit rim 0.6), r7 origins stale on the panel, clamp strip removed / cut-edge skin 1.251 / prong 3.233. test_print_checks 11 OK, test_cross_platform_io 12 OK, test_repo_hygiene 17 OK (1 expected failure, FP-16 usb_head; REPO-INDEX.md regenerated with make_repo_index.py --write: it now lists critical_features_vertical.py and C2 j4_slide_checks.py), test_carrier_fp11c 20 OK (3 skips: driver, check-scope and structural records not bound to d848d413), test_tub_print_t2 8 OK, test_plenum_trial2 17 OK, test_c2_collar_grip 17 of 18 (test_main_audit_c2_record: its record binds b00c1462, see below)
- 2026-10-11 CF made stale by the re-export (not regenerated here; FP-16 refreshes them): every report bound to b00c1462 - harness-checks.json, check-scope-checks.json, verification.json, hdmi/power/wire/microsd reports, review-2026-10-10 c2/main-c2, fp07/driver, fp08/j7 and fp11c records - and the coverage / repo-index / gates outputs that embed the manifest hash. test_c2_collar_grip.test_main_audit_c2_record fails for that reason only (record manifest b00c1462 vs d848d413). The panel change removes 2.787 mm3 at the EVF clamp rear strip only, so no interference, motion, driver, j7 or clearance row can get worse; the scratch interference+motion run above shows it.
- 2026-10-11 CF open / for the orchestrator: (1) carrier_tie_bar_3 (above): move the (-34, 25) slot (x -35 or z 31) together with harness_rules.TIE_SLOTS_XZ, or settle user decision 6 (ties vs RTV-only); then remove the expectedFailure mark of test_carrier_tie_bar_3_passes. (2) J7 required_checks (j7_float, lens_support, lens_clamp, inserts) are still not graded by verify_print_checks (r7 check_joint_checks needs the main-audit rows; FP-09 note). (3) The original-kowa_lm6hc export predates T2 (no tab_catch_insert): FP-13 must re-export before its print checks, or J7 reports insert_tab_catch_p unmeasured. (4) No user decision was taken and no default was set. (5) Not committed.
