AubergineShallow/digital8mm-vertical-nizo/cad/gs8-d2-v1/candidate-vertical/history/reviewed-export18/README.md

Frozen reviewed export18 reference, prior to concealed-channel changes. Source files and these printed STEP parts match the delivered review package. The complete original review package was kept by its author outside this repository (an off-repository folder the 9ced753 text called "Library"); it is not available here, and only the files in this folder are part of the repository. All physical gates remain open.
