AubergineShallow/digital8mm-vertical-nizo/cad/gs8-d2-v1/candidate-vertical/history/FROZEN-LINKS.md

# Frozen copies in this folder

Notice (review 2026-10-10 VN-15): the Markdown files listed below are a frozen copy: relative links point to the original location. They are kept byte-for-byte as recorded (several are bound by SHA-256 in review evidence), so their relative links are not rewritten and some do not resolve from this folder. `check_links_vertical.py` allows broken links only in the files named here.

| File | Original location |
|---|---|
| `UPSTREAM-README-d38468e.md` | the repository root `README.md` of the upstream r7 commit d38468e; open its links at <https://github.com/AubergineShallow/digital8mm/blob/d38468e58eb2b02d56743e2e0cfdd8f780818a65/> (the root of that commit), not from this folder |
