AubergineShallow/digital8mm-vertical-nizo/cad/gs8-d2-v1/candidate-vertical/make_coverage_vertical.py

"""Per-category check coverage of the vertical candidate, generated from the selected reports (review VN-21, FP-15).

CAD-free. Reads the selected compact-Kowa reports and the r7 out/checks.json category list; writes nothing by default.
  --write  rewrites COVERAGE-VERTICAL.md, the generated blocks between the coverage markers in README.md and
           REVIEW.md, and CHECKPOINT-STATUS.json fields main_summary, plenum_summary and check_coverage (all other
           fields untouched)
  --check  read-only; exit 1 if any of those differs from a fresh generation (or a category is unclassified)
Every count is computed from the report rows; nothing is typed. Geometric rows (computed from the exported STEP or
mesh geometry) are counted apart from bookkeeping rows (file, hash and export identity), coverage/state rows and
analytical or declared rows, so a headline pass count cannot be read as geometric evidence. Each r7 category is
mapped to where the candidate runs it, or marked not ported. A category with no classification fails the run.
"""
from cv_io import read_text, write_text
from pathlib import Path
import argparse, collections, hashlib, json, re, sys

HERE = Path(__file__).resolve().parent
SEL = 'out/compact-kowa_lm6hc'
R7_CHECKS = '../out/checks.json'
DOC = 'COVERAGE-VERTICAL.md'
BLOCK_DOCS = ('README.md', 'REVIEW.md')
BEGIN, END = '<!-- coverage:begin (generated by make_coverage_vertical.py; do not edit) -->', '<!-- coverage:end -->'
STATUSES = ('pass', 'fail', 'info', 'stub')

# report label -> (file under SEL, verifier)
REPORTS = {
    'main': ('verification.json', 'verify_candidate.py'),
    'print': ('print-checks.json', 'verify_print_checks.py'),
    'mesh': ('print-mesh-checks.json', 'verify_print_meshes.py'),
    'harness': ('harness-checks.json', 'verify_harness_checks.py'),
    'check_scope': ('check-scope-checks.json', 'verify_check_scope.py'),
    'hdmi': ('hdmi-solid-checks.json', 'verify_hdmi.py'),
    'power_static': ('wire-solid-checks.json', 'verify_wire_solids.py'),
}
GEO, BOOK, COV, ANA = 'geometric', 'bookkeeping', 'coverage/state', 'analytical/declared'
KIND = {
    ('main', 'interference'): GEO, ('main', 'motion'): GEO, ('main', 'driver'): GEO, ('main', 'service_driver'): GEO,
    ('main', 'j7_float'): GEO, ('main', 'roll_catch'): GEO, ('main', 'lens_support'): GEO, ('main', 'lens_clamp'): GEO,
    ('main', 'inserts'): GEO, ('main', 'step_aperture_probes'): GEO, ('main', 'step_material_probes'): GEO,
    ('main', 'clearance'): GEO,
    ('main', 'integrity'): BOOK, ('main', 'roundtrip'): BOOK, ('main', 'source_binding'): BOOK,
    ('main', 'driver_coverage'): COV, ('main', 'motion_coverage'): COV, ('main', 'assembly_state'): COV,
    ('main', 'nominal_features'): ANA, ('main', 'physical'): ANA, ('main', 'non_material_keepout'): ANA,
    ('print', 'print_overhang'): GEO, ('print', 'print_bridge_direction'): GEO, ('print', 'bed_contact'): GEO,
    ('print', 'bed_chamfer'): GEO, ('print', 'thin_wall'): GEO, ('print', 'critical_features'): GEO,
    ('print', 'unclassified_thin_spots'): GEO,
    ('mesh', 'mesh'): GEO,
    ('harness', 'cable_routes'): GEO, ('harness', 'cable_stow'): GEO, ('harness', 'header_housings'): GEO,
    ('harness', 'mate_reach'): GEO, ('harness', 'signal_routes'): GEO, ('harness', 'lead_access'): ANA,
    ('harness', 'feed_volumes'): GEO,
    ('check_scope', 'area_parity'): GEO, ('check_scope', 'evf_face'): GEO, ('check_scope', 'evf_restraint'): GEO,
    ('check_scope', 'hdmi_face'): GEO, ('check_scope', 'stack_retention'): GEO, ('check_scope', 'flow_network'): ANA,
    ('check_scope', 'j4_screen'): ANA, ('check_scope', 'post_root_bending'): ANA,
    ('hdmi', 'carried_sweep'): GEO, ('hdmi', 'full_ribbon_vs_solids'): GEO, ('hdmi', 'hard_head_vs_material'): GEO,
    ('hdmi', 'hard_head_vs_printed'): GEO, ('hdmi', 'obstacle_fixture'): COV, ('hdmi', 'service_access'): GEO,
    ('power_static', 'power_static'): GEO,
}
KIND_NOTE = {
    ('harness', 'lead_access'): 'mixed: lead geometry plus the G-W5 voltage-drop estimate',
    ('harness', 'feed_volumes'): 'EVF feed parts (diode sleeve, RCY pair, option-C reserve) placed on the usb_5v route (FP-11f)',
    ('main', 'nominal_features'): 'analytical constants, not measured from the STEP (VN-21)',
    ('main', 'integrity'): 'STEP validity, solid count and volume per exported part',
    ('hdmi', 'service_access'): 'EVF HDMI unplug corridor: pliers jaws and shank swept down the stroke (H2, VN-43; r7 ACCESS tool numbers)',
}
# r7 category -> (where the candidate runs it, coverage word)
R7_MAP = {
    'contract': (None, 'not ported'), 'cots_containment': (None, 'not ported'),
    'interference': ('main/interference', 'ported'), 'mate_overlap': ('main/interference (declared mating info rows)', 'partly'),
    'clearance': ('main/clearance (J4 zones and the J4 keyhole slide path; C2)', 'partly'), 'keepouts': ('main/non_material_keepout (1 info row)', 'partly'),
    'cable_routes': ('harness/cable_routes', 'ported'), 'lead_access': ('harness/lead_access', 'ported'),
    'mate_reach': ('harness/mate_reach', 'ported'), 'cable_stow': ('harness/cable_stow', 'ported'),
    'header_housings': ('harness/header_housings', 'ported'), 'thin_wall': ('print/thin_wall', 'ported'),
    'driver': ('main/driver', 'ported'), 'critical_features': ('print/critical_features', 'ported'),
    'unclassified_thin_spots': ('print/unclassified_thin_spots', 'ported'),
    'evf_restraint': ('check_scope/evf_restraint', 'ported'), 'removals': (None, 'not ported'),
    'service_driver': ('main/service_driver', 'ported'), 'release_access': (None, 'not ported'),
    'stack_retention': ('check_scope/stack_retention', 'ported'), 'engrave_groove': (None, 'not ported'),
    'boss_geometry': (None, 'not ported'), 'inserts': ('main/inserts', 'ported'),
    'sweeps': ('main/motion', 'ported'), 'mate_paths': ('hdmi/service_access (r7 ACCESS rows for the EVF HDMI unplug only, H2)', 'partly'), 'handling': (None, 'not ported'),
    'j7_float': ('main/j7_float', 'ported'), 'roll_catch': ('main/roll_catch', 'ported'),
    'lens_support': ('main/lens_support', 'ported'), 'lens_clamp': ('main/lens_clamp', 'ported'),
    'mass_com': ('manifest mass_est_g / com_est_mm (report only, as in r7)', 'report only'),
    'layout_self_check': (None, 'not ported'), 'bed_fit': ('mesh/mesh (fits_250x210x220 field)', 'partly'),
    'stl_mesh': ('mesh/mesh', 'ported'), 'print_overhang': ('print/print_overhang', 'ported'),
    'print_modifiers': (None, 'not ported'),
}


def sha(p):
    return hashlib.sha256(Path(p).read_bytes()).hexdigest()


def load(p):
    return json.loads(read_text(p))


def counts(label, d):
    """{category: {status: n}} for one report."""
    out = collections.defaultdict(collections.Counter)
    if label == 'print':
        for cat, c in d['summary'].items():
            out[cat].update({k: v for k, v in c.items() if v})
        return out
    rows = d.get('checks') if label != 'mesh' and label != 'power_static' else d.get('rows')
    for r in rows:
        cat = r.get('category') or label
        out[cat][r['status']] += 1
    return out


def collect(root=HERE):
    root = Path(root)
    sel = root / SEL
    reports, missing = {}, []
    man = sel / 'manifest.json'
    msha = sha(man) if man.is_file() else None
    for label, (name, verifier) in REPORTS.items():
        p = sel / name
        if not p.is_file():
            missing.append(label)
            continue
        d = load(p)
        bound = d.get('manifest_sha256', d.get('mechanical_manifest_sha256'))
        vsha = d.get('verification_source_sha256', d.get('source_sha256'))
        reports[label] = dict(path=SEL + '/' + name, sha256=sha(p), counts=counts(label, d),
                              same_manifest=bound == msha, verifier=verifier,
                              verifier_current=(root / verifier).is_file() and vsha == sha(root / verifier))
    unclassified = sorted('%s/%s' % (l, c) for l, r in reports.items() for c in r['counts'] if (l, c) not in KIND)
    r7 = load((root / R7_CHECKS).resolve())
    r7_rows = {k: (len(v) if isinstance(v, (list, dict)) else 0) for k, v in r7['results'].items()}
    unmapped = sorted(set(r7_rows) - set(R7_MAP))
    stale_map = sorted(set(R7_MAP) - set(r7_rows))
    return dict(manifest_sha256=msha, reports=reports, missing=missing, unclassified=unclassified,
                r7=r7_rows, unmapped=unmapped, stale_map=stale_map)


def tally(reports, label=None):
    t = collections.defaultdict(collections.Counter)
    for l, r in reports.items():
        if label and l != label:
            continue
        for c, n in r['counts'].items():
            t[KIND.get((l, c), 'unclassified')].update(n)
    return t


def fmt(c):
    return ' / '.join('%d %s' % (c.get(s, 0), s) for s in STATUSES if c.get(s, 0) or s != 'stub')


def summary_lines(col):
    rep = col['reports']
    main = rep.get('main')
    lines = []
    if main:
        tot = collections.Counter()
        for n in main['counts'].values():
            tot.update(n)
        k = tally(rep, 'main')
        lines.append('- Main audit (`%s`, %d rows in %d categories): %s. By kind: geometric %s; bookkeeping %s; '
                     'coverage/state %s; analytical/declared %s.' % (
                         main['path'], sum(tot.values()), len(main['counts']), fmt(tot), fmt(k[GEO]), fmt(k[BOOK]),
                         fmt(k[COV]), fmt(k[ANA])))
    k = tally({l: r for l, r in rep.items() if l != 'main'})
    lines.append('- Batch reports (%s): geometric %s; coverage/state %s; analytical/declared %s.' % (
        ', '.join(l for l in rep if l != 'main'), fmt(k[GEO]), fmt(k[COV]), fmt(k[ANA])))
    words = collections.Counter(w for _, w in R7_MAP.values())
    lines.append('- r7 categories (`cad/gs8-d2-v1/out/checks.json`, %d): %s.' % (
        len(col['r7']), ', '.join('%d %s' % (words[w], w) for w in ('ported', 'partly', 'report only', 'not ported'))))
    stale = [l for l, r in rep.items() if not (r['same_manifest'] and r['verifier_current'])]
    lines.append('- Report freshness: %s.' % ('every counted report binds the selected manifest and its current verifier'
                                              if not stale else 'stale (manifest or verifier changed since the report): '
                                              + ', '.join(stale) + '; the counts are what those reports hold'))
    lines.append('- Per-category table and the r7 mapping: [COVERAGE-VERTICAL.md](COVERAGE-VERTICAL.md).')
    return lines


def render_doc(col):
    rep = col['reports']
    out = ['# Check coverage of the vertical candidate', '',
           'Generated by `make_coverage_vertical.py` from the selected compact-Kowa reports (manifest `%s`); do not edit. '
           'Regenerate with `make_coverage_vertical.py --write` after every report refresh; `--check` fails when this '
           'file is stale. Review 2026-10-10 VN-21.' % (col['manifest_sha256'] or 'missing'), '',
           '## Summary', ''] + summary_lines(col) + ['', '## Per report and category', '',
           '| Report | Category | Kind | pass | fail | info | stub |', '|---|---|---|---|---|---|---|']
    for l, r in rep.items():
        for c in sorted(r['counts']):
            n = r['counts'][c]
            kind = KIND.get((l, c), 'UNCLASSIFIED')
            note = KIND_NOTE.get((l, c))
            out.append('| %s | %s | %s%s | %d | %d | %d | %d |' % (l, c, kind, ' (%s)' % note if note else '',
                                                                 n.get('pass', 0), n.get('fail', 0), n.get('info', 0), n.get('stub', 0)))
    out += ['', '## Reports read', '', '| Report | File | Binds selected manifest | Verifier current |', '|---|---|---|---|']
    for l, r in rep.items():
        out.append('| %s | `%s` | %s | %s (`%s`) |' % (l, r['path'], 'yes' if r['same_manifest'] else 'no',
                                                     'yes' if r['verifier_current'] else 'no', r['verifier']))
    for l in col['missing']:
        out.append('| %s | missing | - | - |' % l)
    out += ['', '## r7 categories', '',
            'Each category of the r7 release check (`cad/gs8-d2-v1/out/checks.json`, row counts from that file) and where '
            'the candidate runs it. "partly" means a narrower candidate check stands in; "not ported" means the candidate '
            'has no equivalent and its geometry is not checked for that rule.', '',
            '| r7 category | r7 rows | Candidate | Coverage |', '|---|---|---|---|']
    for c in sorted(col['r7']):
        where, word = R7_MAP.get(c, (None, 'UNMAPPED'))
        out.append('| %s | %d | %s | %s |' % (c, col['r7'][c], where or '-', word))
    new = sorted('%s/%s' % (l, c) for l, r in rep.items() for c in r['counts']
                 if not any(w and w.split(' ')[0] == '%s/%s' % (l, c) for w, _ in R7_MAP.values()))
    out += ['', 'Candidate categories with no r7 counterpart: ' + ', '.join(new) + '.', '']
    return '\n'.join(out)


def block(col):
    return '\n'.join([BEGIN, '**Check coverage (generated):**', ''] + summary_lines(col) + [END])


def with_block(text, blk):
    if BEGIN in text and END in text:
        a = text.index(BEGIN)
        b = text.index(END, a) + len(END)
        return text[:a] + blk + text[b:]
    raise ValueError('coverage markers missing')


def checkpoint(root, col):
    p = Path(root) / 'CHECKPOINT-STATUS.json'
    d = load(p)
    main = col['reports'].get('main')
    if main:
        tot = collections.Counter()
        for n in main['counts'].values():
            tot.update(n)
        d['main_summary'] = {s: tot.get(s, 0) for s in ('pass', 'fail', 'info')}
    plenum = Path(root) / SEL / 'shadow-plenum-checks.json'
    if plenum.is_file() and isinstance(load(plenum).get('summary'), dict):
        d['plenum_summary'] = load(plenum)['summary']    # the docs audit compares this field with the same source
    d['check_coverage'] = dict(
        generator='make_coverage_vertical.py', table=DOC,
        by_kind={l: {k: dict(v) for k, v in sorted(tally(col['reports'], l).items())} for l in col['reports']},
        r7_categories={w: sorted(c for c, (_, ww) in R7_MAP.items() if ww == w) for w in ('ported', 'partly', 'report only', 'not ported')})
    return json.dumps(d, indent=2) + '\n'


def outputs(root=HERE):
    root = Path(root)
    col = collect(root)
    out = {DOC: render_doc(col), 'CHECKPOINT-STATUS.json': checkpoint(root, col)}
    blk = block(col)
    for n in BLOCK_DOCS:
        out[n] = with_block(read_text(root / n), blk)
    return col, out


def main(argv=None):
    ap = argparse.ArgumentParser(description=__doc__, formatter_class=argparse.RawDescriptionHelpFormatter)
    g = ap.add_mutually_exclusive_group()
    g.add_argument('--write', action='store_true')
    g.add_argument('--check', action='store_true')
    ap.add_argument('--root', type=Path, default=HERE)
    a = ap.parse_args(argv)
    col, out = outputs(a.root)
    problems = [('unclassified', x) for x in col['unclassified']] + [('r7_unmapped', x) for x in col['unmapped']] + \
               [('r7_map_stale', x) for x in col['stale_map']] + [('missing_report', x) for x in col['missing']]
    if a.write and not problems:
        for n, t in out.items():
            write_text(a.root / n, t)
    stale = [n for n, t in out.items() if not (a.root / n).is_file() or read_text(a.root / n) != t]
    if a.check:
        problems += [('stale_output', n) for n in stale]
    print(json.dumps(dict(problems=problems, stale_outputs=stale if not a.write else [], summary=summary_lines(col)), indent=2))
    return 1 if problems else 0


if __name__ == '__main__':
    sys.exit(main())
