AubergineShallow/digital8mm-vertical-nizo/cad/gs8-d2-v1/candidate-vertical/routing-snapshots/hdmi-corrected-ports-20261009-0623/run_selected_hdmi_export16.py

"""Bind and preserve the parent's selected-only HDMI check for export16."""
from pathlib import Path
import hashlib,json,runpy,sys
P=Path(__file__).resolve().parent;ROOT=P.parents[1]
MP=ROOT/'out/compact-kowa_lm6hc/manifest.json'
EXPECTED_MANIFEST='8a288f3ac9cdae1731867b5ffed0660b7598047ae572d1c2eb410ae60cb5a2e0'
EXPECTED_SOURCE='72439840fbb66463e6fbaf9e1311138232b81706ace46e84d1c5d5002e9c118e'
EXPECTED_INPUT='cf6b20f21e342414dbf001fe9a4d84ad9634fa2b93e81118b112cac4eaec6f88'
def digest(p):return hashlib.sha256(p.read_bytes()).hexdigest()
assert digest(MP)==EXPECTED_MANIFEST,'Different mechanical export'
assert digest(ROOT/'verify_hdmi.py')==EXPECTED_SOURCE,'Different verifier'
assert digest(P/'input.json')==EXPECTED_INPUT,'Changed geometry input'
dst=P/'export16-selected-hdmi-checks.json'
if dst.exists():raise ValueError('Do not overwrite an existing named result')
sys.argv=[str(ROOT/'verify_hdmi.py'),'--variant','compact-kowa_lm6hc','--snapshot',str(P/'input.json'),'--step','2']
code=0
try:runpy.run_path(str(ROOT/'verify_hdmi.py'),run_name='__main__')
except SystemExit as e:code=e.code or 0
assert digest(MP)==EXPECTED_MANIFEST and digest(ROOT/'verify_hdmi.py')==EXPECTED_SOURCE
src=MP.parent/'hdmi-solid-checks.json';result=json.loads(src.read_text())
assert result['snapshot_sha256']==EXPECTED_INPUT and result['mechanical_manifest_sha256']==EXPECTED_MANIFEST
assert result['verification_source_sha256']==EXPECTED_SOURCE and not result['includes_rejected_diagnostics']
dst.write_bytes(src.read_bytes())
receipt=dict(selected_report_sha256=digest(dst),geometry_input_sha256=EXPECTED_INPUT,mechanical_manifest_sha256=EXPECTED_MANIFEST,
 verification_source_sha256=EXPECTED_SOURCE,donor_addendum_sha256=digest(P/'usb-donor-provenance.json'),
 exit_code=code,physical_qualified=False,scope='Selected installed/Pi-mated EVF-free geometry only. Full USB donor cuts/lead/junction placement, adapter registration, complete FPC, cooler/latch/tool and whole-loom staging remain explicit gates.')
(P/'export16-selected-hdmi-receipt.json').write_text(json.dumps(receipt,indent=2));print(json.dumps(receipt),flush=True)
raise SystemExit(code)
