AubergineShallow/digital8mm-vertical-nizo/cad/gs8-d2-v1/candidate-vertical/harness_rules.py

# SPDX-License-Identifier: MIT
"""FP-10 (VN-26, VN-28; check parts of VN-47 and VN-62): harness and power checks for the vertical candidate.

CAD-free. Ports the r7 checks.py (d38468e) categories cable_routes, mate_reach, lead_access (pigtail face_out with
flexible cores and ties as fixed points, pigtail_drop), cable_stow and header_housings onto the candidate's own
centreline routes (routes.py, signal_routes.py, power_routes.py) and assembly-state model (steps.py).
verify_harness_checks.py binds the manifest, supplies the solid-hit and distance functions and writes the report.

Rules: r7 numbers are never relaxed; a route stretched to its stock length is judged at the SHORTEST member of its
own family (the solver's own bound) and at the MINIMUM stock length; unknown data are ranges with a named gate; a
failing row is the expected result until the CAD/docs phase fixes the geometry. VN-47 (ties vs RTV-only) and
VN-62 (G-W5 fail branch) stay user decisions: both alternatives are computed and reported, neither is chosen.
"""
import copy
import math

# ------------------------------------------------------------------ r7 constants (checks.py / layout.py, d38468e)
ROUTE_ALLOWANCE = (10.0, 0.10)     # checks.py ROUTE_ALLOWANCE: service allowance max(10 mm, 10 % of the length)
ROUTE_END_TOL = 1.0                # checks.py ROUTE_END_TOL: a route end within this of its end part / plug
MATE_MARGIN = 10.0                 # layout.py MATE_MARGIN
MATE_POSE_TOL = 0.01               # checks.py MATE_POSE_TOL: a mating pose lies on its insertion path
TAIL_D = 3.0                       # checks.py TAIL_D: lead tail tested as a dia 3 cylinder
SWEEP_TOL = 0.5                    # checks.py SWEEP_TOL (mm3) for hand / tail hits
STOW_FILL = 0.25                   # checks.py STOW_FILL (reported; the candidate has no stow boxes)
HAND_ENVELOPES = {                 # layout.py HAND_ENVELOPES (a, t, r)
    'pinch_sh': (30.0, 20.0, 24.0), 'pinch_ph': (35.0, 22.0, 26.0), 'pinch_ph1': (20.0, 22.0, 26.0),
    'pinch_xt30': (40.0, 30.0, 30.0), 'pinch_zif': (25.0, 20.0, 30.0)}
HDR_MIN_GAP = 0.3                  # layout.py HDR_HOUSING['min_gap']
FACE_OUT_MIN = 15.0                # layout.py PIGTAIL['face_out_min']: XT30 face out of the grip mouth
JUNCTION_OUT = 15.0                # checks.py mate_reach default junction_out (inline pairs)
R7_SOURCE = 'r7 cad/gs8-d2-v1/checks.py + layout.py at d38468e'

# ------------------------------------------------------------------ G-W5 drop model (VN-62)
# r7 layout.PIGTAIL['drop'] + PIGTAIL_FUSE; the candidate's own model is make_bom_vertical.py validate() hot_drop
# (16 AWG 13.17 / 18 AWG 21 mohm/m, 270 + 60 mm per conductor, copper at 60 C). Limit 0.150 V: never relaxed.
DROP = dict(
    i_peak_a=8.6, limit_v=0.15, xt30_mohm=1.0, fuse_cold_mohm=4.46,          # r7 WIRING s4 / PIGTAIL_FUSE (251 rev VL)
    rho20_ohm_mm2_per_m=1.0 / 58.0, alpha_per_k=0.00393, t_ref_c=20.0, t_hot_c=60.0,   # IACS copper; existing model
    pigtail_path_mm=270.0, pack_lead_mm=60.0,                                # power_routes / D2-13
    prc_strands_min=250, prc_strand_d_mm=0.08,                               # vendor: "over 250 strands ... .08 mm"
    prc_src='https://www.progressiverc.com/products/prc-silicone-wire-16-awg (over 250 strands of pure copper, '
            'each .08 mm; OD 3.0 mm; read 2026-10-11)',
    awg16_mm2=1.3088, awg18_mm2=0.8231,                                      # AWG nominal areas (ASTM B258)
    pack_lead_hi_mm2=150 * math.pi / 4 * 0.08 ** 2,                          # assumption: 150 x 0.08 18 AWG silicone
    lay_range=(1.00, 1.03),          # assumed stranding lay increment range (review drop_probe); G-W5 measures
    fuse_hot_factor_range=(1.0, 1.3),  # assumed hot/cold fuse resistance range (review drop_probe; not data)
    gate='G-W5 hot 8.6 A drop test on the built pigtail (measured fuse, contacts, copper); MP-PACK pack lead')


def reach_margin(length):
    """checks.reach_margin: max(MATE_MARGIN, ROUTE_ALLOWANCE[0], ROUTE_ALLOWANCE[1] x length)."""
    return max(MATE_MARGIN, ROUTE_ALLOWANCE[0], ROUTE_ALLOWANCE[1] * length)


def route_allowance(length):
    """checks.check_cable_routes allowance: max(10 mm, 10 % of the cable length)."""
    return max(ROUTE_ALLOWANCE[0], ROUTE_ALLOWANCE[1] * length)


def _r(x, n=3):
    return None if x is None else round(float(x), n)


# ------------------------------------------------------------------ geometry helpers (pure math)
def bb(b):
    """[x0, x1, y0, y1, z0, z1] from a list or a routes.B() dict."""
    if isinstance(b, dict):
        return [b['x'][0], b['x'][1], b['y'][0], b['y'][1], b['z'][0], b['z'][1]]
    return [float(v) for v in b]


def pt_box_dist(p, b):
    return math.sqrt(sum(max(b[2 * i] - p[i], 0.0, p[i] - b[2 * i + 1]) ** 2 for i in range(3)))


def box_gap(a, b):
    """checks._box_gap: largest axis gap (<= 0: touch or overlap)."""
    return max(max(a[2 * i], b[2 * i]) - min(a[2 * i + 1], b[2 * i + 1]) for i in range(3))


def box_vol(a, b):
    out = 1.0
    for i in range(3):
        out *= max(0.0, min(a[2 * i + 1], b[2 * i + 1]) - max(a[2 * i], b[2 * i]))
    return out


def boxes_overlap(a, b, m=0.0):
    return all(a[2 * i] < b[2 * i + 1] + m and b[2 * i] < a[2 * i + 1] + m for i in range(3))


def shift(b, d):
    return [b[0] + d[0], b[1] + d[0], b[2] + d[1], b[3] + d[1], b[4] + d[2], b[5] + d[2]]


def add(p, d, s=1.0):
    return [p[i] + s * d[i] for i in range(3)]


def cumulative(points):
    out, s = [0.0], 0.0
    for a, b in zip(points, points[1:]):
        s += math.dist(a, b)
        out.append(s)
    return out


def arc_length(points):
    return cumulative(points)[-1] if points else 0.0


def nearest_on_polyline(points, q):
    """(arc position s, point, distance) of the polyline point nearest q (segments, not only samples)."""
    cum = cumulative(points)
    best = (None, None, float('inf'))
    for i, (a, b) in enumerate(zip(points, points[1:])):
        ab = [b[k] - a[k] for k in range(3)]
        n2 = sum(x * x for x in ab)
        t = 0.0 if n2 == 0 else max(0.0, min(1.0, sum((q[k] - a[k]) * ab[k] for k in range(3)) / n2))
        p = [a[k] + ab[k] * t for k in range(3)]
        d = math.dist(p, q)
        if d < best[2]:
            best = (cum[i] + t * math.sqrt(n2), p, d)
    return best


def plane_crossings(points, axis, value):
    """[(s, point)] where the polyline crosses coordinate `axis` == value."""
    cum, out = cumulative(points), []
    for i, (a, b) in enumerate(zip(points, points[1:])):
        if (a[axis] - value) * (b[axis] - value) <= 0 and a[axis] != b[axis]:
            t = (value - a[axis]) / (b[axis] - a[axis])
            out.append((cum[i] + t * math.dist(a, b), [a[k] + t * (b[k] - a[k]) for k in range(3)]))
    return out


def cross3(a, b):
    return (a[1] * b[2] - a[2] * b[1], a[2] * b[0] - a[0] * b[2], a[0] * b[1] - a[1] * b[0])


def hand_box(rear, axis, row, env):
    """checks._hand_box: hand envelope (a, t, r) a behind `rear` along -axis, t along axis x row, r along row."""
    a, t, r = env
    nrm = math.sqrt(sum(x * x for x in axis)) or 1.0
    ax = [x / nrm for x in axis]
    th = cross3(ax, row)
    cs = [[rear[i] - sa * a * ax[i] + st * t * th[i] + sr * r * row[i] for i in range(3)]
          for sa in (0.0, 1.0) for st in (-0.5, 0.5) for sr in (-0.5, 0.5)]
    return [f(c[i] for c in cs) for i in range(3) for f in (min, max)]


def out_of_mm(box, out_of):
    """checks._out_of_mm: how far the whole box lies beyond plane + margin on the signed side (>= 0 holds)."""
    sgn, ax = out_of[0][0], 'xyz'.index(out_of[0][1])
    return (box[2 * ax] - out_of[1] - out_of[2]) if sgn == '+' else (out_of[1] - out_of[2] - box[2 * ax + 1])


def on_path(path, d, tol=MATE_POSE_TOL):
    """checks._on_path: the pose d lies on the insertion path polyline."""
    for a, b in zip(path, path[1:]):
        ab = [b[i] - a[i] for i in range(3)]
        n2 = sum(x * x for x in ab)
        t = 0.0 if n2 == 0 else max(0.0, min(1.0, sum((d[i] - a[i]) * ab[i] for i in range(3)) / n2))
        if math.dist(d, [a[i] + ab[i] * t for i in range(3)]) <= tol:
            return True
    return False


def tail_box(p0, p1, d=TAIL_D):
    return [f(p0[i], p1[i]) + s * d / 2 for i in range(3) for f, s in ((min, -1), (max, 1))]


# ------------------------------------------------------------------ route families (VN-28)
# A route stretched to its stock length by a solver is judged at the shortest member of its own family: the
# solver variable at its own bound. Each entry names the knots that carry the variable and the source literal.
FAMILIES = {
    # H2 (VN-28): the QT storage variable moved from the under-tool run (knots 3, 4: 'lo,hi=34.,50.') to the top run
    'qt': dict(var='top', knots=(1, 2), axis=2, bound=(56.0, 87.5),
               src="signal_routes.py build(): QT top run '_solve_top(qt_curve,250-qt_longest,56.,87.5)'"),
    'run_pin37': dict(var='top', knots=(6, 7), axis=2, bound=(35.0, 80.0),
                      src="signal_routes.py build(): run cores '_solve_top(make,250,35,80)'"),
    'run_pin39': dict(var='top', knots=(4, 5), axis=2, bound=(35.0, 80.0),
                      src="signal_routes.py build(): run cores '_solve_top(make,250,35,80)'"),
}


def family_eval(rounded_path, curve, fam, value, upto=None):
    """Rounded length of the family member with the variable = value (knots[:upto+1] when upto is given)."""
    knots = copy.deepcopy(curve['knots'])
    for i in fam['knots']:
        knots[i][fam['axis']] = float(value)
    if upto is not None:
        knots = knots[:upto + 1]
    c = rounded_path(knots, curve['centerline_radius_mm'], curve['first_straight_min_mm'],
                     0.0 if upto is not None else curve['last_straight_min_mm'], 0.5)
    return dict(length=c['rounded_length_mm'], errors=c['errors'], knots=knots, points=c['sampled_centerline'])


def family_range(rounded_path, curve, fam):
    """Recorded variable, recomputed recorded length, and the family lengths at both solver bounds."""
    vals = [curve['knots'][i][fam['axis']] for i in fam['knots']]
    rec = vals[0]
    same = all(abs(v - rec) < 1e-9 for v in vals)
    at = {b: family_eval(rounded_path, curve, fam, b) for b in fam['bound']}
    lens = {b: at[b]['length'] for b in fam['bound']}
    valid = {b: not at[b]['errors'] for b in fam['bound']}
    good = [lens[b] for b in fam['bound'] if valid[b]]
    return dict(variable=fam['var'], recorded=rec, knots_share_variable=same, bound=list(fam['bound']),
                src=fam['src'], recomputed_mm=family_eval(rounded_path, curve, fam, rec)['length'],
                recorded_mm=curve['rounded_length_mm'], length_at_bound_mm={str(b): lens[b] for b in fam['bound']},
                valid_at_bound={str(b): valid[b] for b in fam['bound']},
                min_mm=min(good) if good else None, max_mm=max(good) if good else None,
                min_at=min(fam['bound'], key=lambda b: lens[b] if valid[b] else float('inf')))


# ------------------------------------------------------------------ cable declarations (data of record)
CABLES = {
    'qt': dict(src=('signal_geometry', 'qt'), length=250.0, length_range=(240.0, 260.0), ends=('pi5', 'encoder'),
               range_src='BOM D2-24 / D2-24B: finished QT lead 250 +/- 10 mm (MP-QT measures)', end_plug='p_qt_enc'),
    'run_pin37': dict(src=('signal_geometry', 'run_cores', 0), length=250.0, length_range=None,
                      ends=('pi5', 'run_button'), housing='hdr_run_lead_37',
                      range_src='r7 CABLES run_lead length 250 mm design value; no vendor tolerance (MP-RUN measures)'),
    'run_pin39': dict(src=('signal_geometry', 'run_cores', 1), length=250.0, length_range=None,
                      ends=('pi5', 'run_button'), housing='hdr_run_lead_39',
                      range_src='r7 CABLES run_lead length 250 mm design value; no vendor tolerance (MP-RUN measures)'),
    'power_button': dict(src=('signal_geometry', 'power_button'), length=375.0, length_range=(363.0, 387.0),
                         ends=('pi5', 'power_button'), cut_to_length=True,
                         range_src='BOM V-28: 2181120201 female 150 +/- 6 mm + 2181110202 male 225 +/- 6 mm exposed '
                                   'tails, cut to measured length; side genders unassigned (VN-63). The signal_routes '
                                   '150 mm stock figure predates V-28.'),
    'fpc': dict(src=('signal_geometry', 'fpc'), length=200.0, length_range=None, ends=('pi5', 'gs_camera'),
                end_plug='p_fpc_cam', range_src='official 200 mm camera cable, design value (MTC camera-cable row)'),
    'fan': dict(src=('routes', 'fan'), length=60.0, length_range=None, ends=('cooler', 'pi5'),
                range_src='native Active Cooler lead, r7 length estimate'),
    'oled_flex': dict(src=('routes', 'oled_flex'), length=50.0, length_range=None, ends=('hmx039', 'evf_board'),
                      range_src='kit OLED flex 50 mm (r7 CABLES)'),
    'usb_5v': dict(src=('routes', 'usb_5v'), length=500.0, length_range=(500.0, 535.0), ends=('pi5', 'evf_board'),
                   cut_to_length=True,
                   range_src='H1 (FIX-LOG): cut-to-length feed assembly, BOM D2-22 Adafruit 4448 donor catalog 300 mm '
                             '(supplier drawing 325 +/- 10) + D2-23 Pololu 2180 / 2181 100 mm tails; the old 200 mm '
                             'allocation is superseded (routing-snapshots/hdmi-export17-selected-20261009-0704/'
                             'usb-donor-provenance.json). Each segment is held to its own stock with the r7 allowance '
                             'in feed_volumes (usb_5v_donor, usb_5v_tail_2180, usb_5v_tail_2181).'),
    'pack_lead': dict(src=('routes', 'pack_lead'), length=60.0, length_range=None, ends=('pack', 'xt30_pair'),
                      range_src='D2-13 existing 60 mm 18 AWG pack lead (MP-PACK)'),
    'hdmi': dict(delegated='verify_hdmi.py -> hdmi-solid-checks.json: the full developable 300 mm 3562 ribbon is laid '
                           'in explicit deployable loops and its carried / premate / unplugged poses are swept there'),
    'fps_lead': dict(delegated='verify_fps_integrated.py -> integrated-fps-checks.json: the selected D2-27 Molex '
                               'mated-carry harness; the signal_routes 200 + 50 mm PH model is superseded (BOM D2-27)'),
}
POWER_CORES = ('positive', 'negative')
PIGTAIL_LENGTH = 270.0     # power_routes finished-path allocation per polarity (cut to it; G-V-PIGTAIL)


def _dig(d, path):
    for k in path:
        d = d[k] if not isinstance(k, str) or not isinstance(d, list) else next(x for x in d if x['id'] == k)
    return d


def collect(out, rows, L, ST):
    """Harness data H from routes.build() output `out`, manifest rows {id: row}, the baseline layout module L and the
    assembly-state model ST (steps.py)."""
    routes = {r['id']: r for r in out['routes']}
    H = dict(boxes={k: bb(r['bbox_mm']) for k, r in rows.items()}, kinds={k: r['kind'] for k, r in rows.items()},
             plugs={p['id']: bb(p['box']) for p in out['plugs'] if p.get('box')},
             plug_cable={p['id']: p.get('cable') for p in out['plugs'] if p.get('box')},   # H2: free-lead keepouts
             housings={h['id']: dict(id=h['id'], cable=h['cable'], pins=list(h['pins']), box=bb(h['box']),
                                     wire_exit=list(h['wire_exit'])) for h in out['header_housings']},
             used_pins={k: tuple(v) for k, v in L.HDR_USED_PINS.items()}, hdr=dict(L.HDR_HOUSING),
             header_types={'hdr_%s_%s' % (c, '_'.join(map(str, p))): t for c, t, p in L.HEADER_HOUSINGS},
             opening_y=rows['tub']['bbox_mm'][3], mouth_z=L.GRIP['bay']['z'][0],
             grip_bottom_z=rows['base_grip']['bbox_mm'][4], grip_top_z=rows['base_grip']['bbox_mm'][5],
             floor_z=out['signal_geometry']['body_inner_z_mm'][0], pack_in_start=list(ST.MOTIONS['pack_in']['path'][0]),
             cables={}, power=out['power_geometry'], signal_revision=out['signal_geometry']['revision'],
             routes_revision=out['revision'])
    sig = out['signal_geometry']
    H['branch_starts'] = ([(b['id'], list(b['curve']['sampled_centerline'][0])) for b in sig['branches']]
                          + [(c['source_housing_id'] if 'source_housing_id' in c else 'hdr_run_lead_%d' % c['pins'][0],
                              list(c['curve']['sampled_centerline'][0])) for c in sig['run_cores']])
    for cid, spec in CABLES.items():
        c = dict(id=cid, **{k: v for k, v in spec.items() if k != 'src'})
        if 'delegated' in spec:
            H['cables'][cid] = c
            continue
        src = sig if spec['src'][0] == 'signal_geometry' else routes
        item = _dig(src, spec['src'][1:])
        curve = item['curve']
        c.update(curve=curve, points=[list(p) for p in curve.get('sampled_centerline') or []],
                 errors=list(curve.get('errors') or []), family=FAMILIES.get(cid), branches=[], od_mm=item.get('od_mm'),
                 feed=item.get('feed'), stubs=item.get('stubs'), sweep_points=item.get('sweep_points'))   # H1
        if cid == 'qt':
            c['branches'] = [dict(id=b['id'], points=[list(p) for p in b['curve']['sampled_centerline']],
                                  length=b['curve']['rounded_length_mm']) for b in sig['branches'] if b['cable'] == 'qt']
        H['cables'][cid] = c
    st = out['retired_pigtail_service_estimate']['study']['service_path']
    H['pigtail_service'] = dict(knots=[list(k) for k in st['knots']], radius=st['centerline_radius_mm'],
                                first_tail=st['first_straight_min_mm'], last_tail=st['last_straight_min_mm'],
                                src='routes.pigtail_16_study() service_path (the conservative front-bypass service '
                                    'centreline; listed as retired_pigtail_service_estimate, the only flexible-service '
                                    'corridor in the source)')
    for core in out['power_geometry']['cores']:
        cid = 'pigtail_' + core['id']
        own = ('xt30_selected_housing',)   # r7: a cable's own end part is exempt (the core ends on its housing face)
        errs = (['hits %s' % h['obstacle'] for h in core['source_proxy_hits'] if h['obstacle'] not in own]
                + (['%d wall overrun points' % len(core['wall_overrun_points'])] if core['wall_overrun_points'] else [])
                + list(core['upper_curve']['errors']))
        H['cables'][cid] = dict(id=cid, length=PIGTAIL_LENGTH, length_range=None, ends=('x1203', 'xt30_pair'),
                                range_src='power_routes 270 mm finished-path allocation, cut to it (G-V-PIGTAIL)',
                                points=[list(p) for p in core['full_centerline_excluding_unmeasured_root_joint']],
                                errors=errs,
                                core=core, family=None, branches=[])
    # H2 (VN-28): free-lead routes declared by the route source, keyed by MATE_POSES id
    H['free_leads'] = {k: dict(v, id=k) for k, v in (sig.get('free_leads') or {}).items()}
    return H


# ------------------------------------------------------------------ pigtail power cores (VN-47, VN-62)
# Retention of record: ASSEMBLY-VERTICAL.md 'Provisionally allocate four existing-class 2.5 mm cable ties ... at the
# new carrier lacing slots'. VN-47 user decision: carrier ties or r7 BX-3 RTV-only. Changing this value switches the
# gating row; the other alternative is always reported as 'info' with the decision reference.
PIGTAIL_RETENTION = 'carrier_ties'
TIE_SLOTS_XZ = [(-92.0, 25.0), (-92.0, 45.0), (-34.0, 25.0), (-34.0, 45.0)]   # model.py make_carrier()
TIE_SLOT_HALF = (1.5, 0.5)             # model.py: 3 x 1 mm through-plate slots (x, z half sizes)
TIE_SLOT_Y = (13.9 + 3.2, 17.1 + 3.2)  # model.py: plate y 13.9..17.1, carrier translated +3.2 in y
TIE_BAND_MAX = 0.7                     # ASSEMBLY-VERTICAL.md: band thickness must measure <= 0.7 mm
CORE_OD = 3.2                          # power_routes od_mm reservation per core (vendor OD 3.0)
HUMP_R2 = 16.0                         # power_routes side(): two 8 mm arcs per hump side


def tie_slot_boxes():
    return [[x - TIE_SLOT_HALF[0], x + TIE_SLOT_HALF[0], TIE_SLOT_Y[0], TIE_SLOT_Y[1], z - TIE_SLOT_HALF[1],
             z + TIE_SLOT_HALF[1]] for x, z in TIE_SLOTS_XZ]


def _side(drop):
    if drop <= HUMP_R2:
        a = math.acos(1 - max(0.0, drop) / HUMP_R2)
        return a, 0.0, HUMP_R2 * math.sin(a), HUMP_R2 * a
    return math.pi / 2, drop - HUMP_R2, HUMP_R2, HUMP_R2 * math.pi / 2 + drop - HUMP_R2


def hump_excess(sh):
    """Stored slack of a power core: designed hump length minus its family minimum (power_routes hump(low))."""
    a1, a2 = math.radians(sh['rise_angle_deg']), math.radians(sh['fall_angle_deg'])
    l1, l2, flat, high = sh['rise_straight_mm'], sh['fall_straight_mm'], sh['middle_straight_mm'], sh['top_z']
    bump = HUMP_R2 * (a1 + a2) + l1 + l2 + flat
    width = flat + HUMP_R2 * (math.sin(a1) + math.sin(a2))
    zbase = high - (HUMP_R2 * (1 - math.cos(a1)) + l1)
    endbase = high - (HUMP_R2 * (1 - math.cos(a2)) + l2)
    lo = max(zbase, endbase)
    s1, s2 = _side(lo - zbase), _side(lo - endbase)
    minimum = s1[3] + s2[3] + width - s1[2] - s2[2]
    return dict(bump_mm=bump, min_mm=minimum, excess_mm=bump - minimum, width_mm=width, zbase=zbase,
                endbase=endbase, top_z=high)


def junction_local(P, x):
    """Local (u, v, w) coordinates of a seated junction-attached point (power_routes junction frame)."""
    M, C = P['junction_transform_matrix'], P['junction_center']
    cols = [[M[i][j] for i in range(3)] for j in range(3)]
    return [sum((x[i] - C[i]) * cols[j][i] for i in range(3)) for j in range(3)]


def junction_posed(P, local, pose):
    return [pose['center'][a] + sum(pose['matrix'][a][b] * local[b] for b in range(3)) for a in range(3)]


def face_isolation(H, core_id):
    """Wire face of a core's XT30 housing in the last rigid service pose (the candidate's battery-isolation pose,
    swept by verify_power_service.py): positive = female face F, negative = F + 5 mm v (power_routes)."""
    P = H['power']
    core = next(c for c in P['cores'] if c['id'] == core_id)
    face = core['full_centerline_excluding_unmeasured_root_joint'][-1]
    return junction_posed(P, junction_local(P, face), P['rigid_service_poses'][-1])


def corridor(H, core_id, e, rounded_path):
    """The candidate's declared flexible-service corridor (routes.pigtail_16_study service_path: front bypass, floor
    hole, drop) for one core. The study's knots are kept (bend radius and tails as declared) except the last one,
    which becomes the core's isolation-pose face lowered to e mm below the grip mouth (the study dropped at the
    floor-hole x). The study starts at the negative-core root; for a core whose root differs, the first straight
    leg is re-measured from that root to the study's second knot (the positive's own first corner would violate the
    declared 8 mm bend radius on the 16 mm leg after it, so the study fillets are kept).
    -> dict(rounded_length_mm (None if invalid), errors, sampled_centerline, lead_in_mm)"""
    S = H['pigtail_service']
    core = next(c for c in H['power']['cores'] if c['id'] == core_id)
    k = copy.deepcopy(S['knots'])
    f = face_isolation(H, core_id)
    k[-1] = [f[0], f[1], H['mouth_z'] - e]
    c = rounded_path(k, S['radius'], S['first_tail'], S['last_tail'], 0.5)
    lead = math.dist(core['root'], k[1]) - math.dist(k[0], k[1])
    pts = [list(p) for p in c['sampled_centerline']]
    if math.dist(core['root'], k[0]) > 1e-9:
        pts = [list(core['root'])] + pts[1:]
    return dict(rounded_length_mm=None if c['rounded_length_mm'] is None else c['rounded_length_mm'] + lead,
                errors=c['errors'], sampled_centerline=pts, lead_in_mm=lead)


def _solve_e(f, lo=-60.0, hi=400.0):
    """Largest e with f(e) >= 0 (f decreasing in e); None if f(lo) < 0 (not even 60 mm inside the mouth)."""
    if f(lo) < 0:
        return None
    if f(hi) >= 0:
        return hi
    for _ in range(70):
        mid = (lo + hi) / 2
        lo, hi = (mid, hi) if f(mid) >= 0 else (lo, mid)
    return lo


CORRIDOR_OP = 'pack_in'   # H2: the corridor is the pigtail's taut path while the XT30 is drawn out at pack_in


def corridor_clearance(H, rounded_path, ST, hits=None):
    """H2 (VN-47 / VN-72): the declared service corridor at e = FACE_OUT_MIN, per core, swept as a capsule (core OD +
    2 x MEMBER_TOL, strict INSTALLED_TOL) against every part present at CORRIDOR_OP (own ends x1203 / xt30_pair and
    the pack exempt) plus the other cables' rigid heads and header housings, and kept off every other cable (both
    pigtail cores travel together and the pack lead moves with the pack: excluded)."""
    hits = box_hits if hits is None else hits
    memo = H.setdefault('_memo', {})
    if ('corridor', id(hits)) in memo:
        return memo[('corridor', id(hits))]
    body, _mv = pose_state(ST, CORRIDOR_OP)
    exempt = {'x1203', 'xt30_pair', 'pack'}
    tg = _targets(H, body, set(), (0.0, 0.0, 0.0), exempt)
    tg += [dict(id='plug ' + pid, kind='keepout', disp=(0.0, 0.0, 0.0), box=b) for pid, b in H['plugs'].items()
           if (H.get('plug_cable') or {}).get(pid) not in ('pigtail', 'pack_lead', None)]
    tg += [dict(id='housing ' + hid, kind='keepout', disp=(0.0, 0.0, 0.0), box=h['box']) for hid, h in H['housings'].items()]
    d = CORE_OD + 2 * MEMBER_TOL
    out = {}
    for cid in POWER_CORES:
        c = corridor(H, cid, FACE_OUT_MIN, rounded_path)
        pts = [list(p) for p in c['sampled_centerline']]
        found = {}
        for s_ in capsule_specs(simplify_polyline(pts, MEMBER_TOL), d):
            for h in hits(s_, tg):
                found[h['obstacle']] = round(found.get(h['obstacle'], 0.0) + h['volume_mm3'], 2)
        over, tight = [], []
        for n, q, dq in neighbour_cables(H, 'pigtail_' + cid):
            if n.split(':')[0] in ('pigtail_positive', 'pigtail_negative', 'pack_lead'):
                continue
            dist, need = polyline_distance(pts, q, SEPARATION_TOL), (CORE_OD + dq) / 2
            tight.append((dist - need, n, dist, need))
            if dist < need - 1e-9:
                over.append('%s %.2f < %.2f mm' % (n, dist, need))
        tight.sort()
        out[cid] = dict(op=CORRIDOR_OP, capsule_d_mm=_r(d, 2), exempt=sorted(exempt), targets=len(tg), hits=found,
                        cable_overlaps=over, tightest=[dict(cable=n, min_centreline_mm=_r(a, 2), need_mm=_r(b, 2))
                                                       for _m, n, a, b in tight[:4]])
    memo[('corridor', id(hits))] = out
    return out


def pigtail_reach_rows(H, rounded_path, retention=None, hits=None, ST=None):
    """lead_access pigtail rows (r7 C3 _pigtail_face_out on the candidate cores): ties on route; face_out with the
    four carrier ties as fixed points (design of record); face_out RTV-only (r7 BX-3, the pad as the only fixed
    point). The allowance reach_margin(270) is always kept; the root stub is fixed at the pad. H2: with `hits` and
    `ST`, the corridor itself is obstacle-checked (corridor_clearance) and a hit or overlap fails both face-out rows."""
    retention = PIGTAIL_RETENTION if retention is None else retention
    cc = corridor_clearance(H, rounded_path, ST, hits) if hits is not None and ST is not None else None
    slots, cap, allow = tie_slot_boxes(), CORE_OD / 2 + TIE_BAND_MAX, reach_margin(PIGTAIL_LENGTH)
    cores = {c['id']: c for c in H['power']['cores']}
    ties, rtv, tie_res = [], {}, {}
    for cid in POWER_CORES:
        core = cores[cid]
        free0 = PIGTAIL_LENGTH - core['unmodeled_root_joint_allowance_mm']
        pts = [list(p) for p in core['full_centerline_excluding_unmeasured_root_joint']]
        k_end = len(core['flexible_wire_parts'][0]['points']) - 1 if cid == 'positive' else len(pts) - 1
        flex = pts[:k_end + 1]
        f_rtv = lambda e, cid=cid, free0=free0: free0 - corridor(H, cid, e, rounded_path)['rounded_length_mm'] - allow
        c15 = corridor(H, cid, FACE_OUT_MIN, rounded_path)
        rtv[cid] = dict(face_out_mm=_r(_solve_e(f_rtv), 2), slack_at_face_out_min_mm=_r(f_rtv(FACE_OUT_MIN), 2),
                        corridor_mm=_r(c15['rounded_length_mm'], 2), free_length_mm=_r(free0, 2), allowance_mm=allow,
                        root_stub_mm=_r(core['unmodeled_root_joint_allowance_mm'], 2), corridor_errors=c15['errors'])
        per = []
        for (x, z), sb in zip(TIE_SLOTS_XZ, slots):
            q = [x, (TIE_SLOT_Y[0] + TIE_SLOT_Y[1]) / 2, z]
            s_t, p_t, _ = nearest_on_polyline(flex, q)
            gap = min(pt_box_dist(p, sb) for p in flex)
            drawn = s_t + math.dist(p_t, q)          # as drawn: installed path to its nearest point, then to the slot
            lower = math.dist(core['root'], q)        # lower bound: straight pad root to slot (not obstacle-checked)

            def f_tie(e, fixed, q=q, cid=cid, free0=free0):
                c = corridor(H, cid, e, rounded_path)
                s_c, p_c, d_c = nearest_on_polyline(c['sampled_centerline'], q)
                return free0 - fixed - (d_c + arc_length(c['sampled_centerline']) - s_c) - allow
            rec = dict(core=cid, slot_xz=[x, z], core_to_slot_mm=_r(gap, 2), on_route=gap <= cap + 1e-9,
                       nearest_core_point=[_r(v, 2) for v in p_t], arc_s_mm=_r(s_t, 1),
                       fixed_as_drawn_mm=_r(drawn, 1), fixed_lower_bound_mm=_r(lower, 1),
                       face_out_as_drawn_mm=_r(_solve_e(lambda e: f_tie(e, drawn)), 2),
                       face_out_lower_bound_mm=_r(_solve_e(lambda e: f_tie(e, lower)), 2))
            per.append(rec)
            ties.append(rec)
        key = lambda t, k: -1e9 if t[k] is None else t[k]
        worst = min(per, key=lambda t: key(t, 'face_out_as_drawn_mm'))
        best = max(per, key=lambda t: key(t, 'face_out_lower_bound_mm'))
        tie_res[cid] = dict(face_out_mm=worst['face_out_as_drawn_mm'], worst_slot=worst['slot_xz'],
                            best_case_face_out_mm=best['face_out_lower_bound_mm'], best_case_slot=best['slot_xz'],
                            any_slot_on_route=any(t['on_route'] for t in per))
    pr = ['no allocated tie slot reaches the %s core (nearest %s mm; a tie binds a core within OD/2 + band = %.1f mm '
          'of its slot)' % (c, min(t['core_to_slot_mm'] for t in ties if t['core'] == c), cap)
          for c in POWER_CORES if not tie_res[c]['any_slot_on_route']]
    rows = [dict(category='lead_access', id='pigtail_ties_on_route', retention_of_record=retention, capture_mm=cap,
                 ties=ties, slots_off_route=sum(not t['on_route'] for t in ties), slot_boxes=slots,
                 status=('fail' if pr else 'pass') if retention == 'carrier_ties' else 'info', problems=pr,
                 gate='VN-47 user decision (carrier ties vs RTV-only); G-V-PIGTAIL routing mock-up',
                 note='Slots from model.py make_carrier(); the runner confirms each slot open in the carrier STEP.')]
    model = ('r7 _pigtail_face_out: free length (270 - root stub - fixed length up to the governing fixed point) minus '
             'the taut path along the declared service corridor to the isolation-pose face lowered to e below the '
             'mouth, minus reach_margin(270); face_out = the largest e that keeps slack >= 0. Ties: the design does '
             'not assign slots to cores, so the worst slot gates with the fixed length as drawn (installed path to '
             'its nearest point, then to the slot); the best slot with a straight pad-to-slot lower bound is reported')
    rows.append(dict(category='lead_access', id='pigtail_pad_range', status='info', gate='G-W2 / G-V-PIGTAIL',
                     assumed_pad=list(cores['positive']['source_assumed_pad']),
                     note='r7 pigtail_range (cut rule over the credible pad range) is not ported: the candidate uses one '
                          'fixed 270 mm allocation at one assumed pad, with no cut rule. Every reach and drop row here '
                          'holds only at that assumed pad; the real pad roots are a STOP (G-W2, G-V-PIGTAIL).'))
    for rid, res, ret in (('pigtail_xt30_mouth', tie_res, 'carrier_ties'), ('pigtail_xt30_mouth_rtv_only', rtv, 'rtv_only')):
        bad = [c for c, v in res.items() if v['face_out_mm'] is None or v['face_out_mm'] < FACE_OUT_MIN - 1e-9]
        msg = ['%s core: XT30 face out %s mm < %.1f' % (c, res[c]['face_out_mm'], FACE_OUT_MIN) for c in bad]
        if ret == 'carrier_ties':
            msg += ['ties as fixed points are not on the drawn %s route' % c for c in POWER_CORES
                    if not res[c]['any_slot_on_route']]
        if cc is not None:   # H2: the corridor must itself be clear (obstacle-checked free-lead path)
            for c in POWER_CORES:
                if cc[c]['hits']:
                    msg.append('%s core service corridor intersects %s at %s' % (
                        c, ', '.join('%s %.2f mm3' % kv for kv in sorted(cc[c]['hits'].items())), CORRIDOR_OP))
                if cc[c]['cable_overlaps']:
                    msg.append('%s core service corridor overlaps cable(s): %s' % (c, '; '.join(cc[c]['cable_overlaps'])))
        gating = ret == retention
        rows.append(dict(category='lead_access', id=rid, retention=ret, gating=gating, cores=res, model=model,
                         corridor_src=H['pigtail_service']['src'], face_out_min=FACE_OUT_MIN, allowance_mm=allow,
                         corridor_clearance=cc if cc is not None else 'not swept (no hit function)',
                         estimate=True, status=('fail' if msg else 'pass') if gating else 'info',
                         problems=msg if gating else [], would_fail=None if gating else msg,
                         gate='G-V-PIGTAIL flexible withdrawal (mock-up)' if gating else 'VN-47 user decision'))
    return rows


def drop_v(area16_mm2, lay, area18_mm2, fuse_factor, path_mm=None, D=DROP):
    """G-W5 drop estimate (V): 2 conductors x (pigtail path + pack lead) at 60 C + fuse + XT30, at the peak current."""
    path_mm = D['pigtail_path_mm'] if path_mm is None else path_mm
    k = 1 + D['alpha_per_k'] * (D['t_hot_c'] - D['t_ref_c'])
    r16 = D['rho20_ohm_mm2_per_m'] / area16_mm2 * 1000.0 * lay       # mohm/m
    r18 = D['rho20_ohm_mm2_per_m'] / area18_mm2 * 1000.0 * lay
    r = 2 * (path_mm / 1000.0 * r16 + D['pack_lead_mm'] / 1000.0 * r18) * k + D['fuse_cold_mohm'] * fuse_factor + D['xt30_mohm']
    return D['i_peak_a'] * r / 1000.0


def pigtail_drop_row(D=DROP):
    """VN-62 computed row: drop range from the vendor strand data; asserts drop_hi <= 0.150 V (never relaxed)."""
    prc_min = D['prc_strands_min'] * math.pi / 4 * D['prc_strand_d_mm'] ** 2
    lay0, lay1 = D['lay_range']
    f0, f1 = D['fuse_hot_factor_range']
    cases = dict(
        lo=dict(area16=D['awg16_mm2'], lay=lay0, area18=D['awg18_mm2'], fuse=f0,
                basis='AWG nominal areas, no lay increment, cold fuse (= make_bom_vertical hot_drop model)'),
        hi_cold_fuse=dict(area16=prc_min, lay=lay1, area18=D['pack_lead_hi_mm2'], fuse=f0,
                          basis='vendor minimum 250 x 0.08 mm, lay 1.03, 150 x 0.08 pack lead, cold fuse'),
        nominal_hot_fuse=dict(area16=D['awg16_mm2'], lay=lay0, area18=D['awg18_mm2'], fuse=f1,
                              basis='AWG nominal copper with the hot fuse case'),
        hi=dict(area16=prc_min, lay=lay1, area18=D['pack_lead_hi_mm2'], fuse=f1,
                basis='vendor minimum strands, lay 1.03, 150 x 0.08 pack lead, hot fuse x 1.3'))
    out = {}
    for k, c in cases.items():
        out[k] = dict(c, drop_v=_r(drop_v(c['area16'], c['lay'], c['area18'], c['fuse'], D=D), 5),
                      margin_mv=_r(1000 * (D['limit_v'] - drop_v(c['area16'], c['lay'], c['area18'], c['fuse'], D=D)), 2))
        out[k]['area16'] = _r(c['area16'], 4)
        out[k]['area18'] = _r(c['area18'], 4)

    def max_path(fuse):
        lo, hi = 0.0, 1000.0
        for _ in range(60):
            mid = (lo + hi) / 2
            lo, hi = (mid, hi) if drop_v(prc_min, lay1, D['pack_lead_hi_mm2'], fuse, mid, D) <= D['limit_v'] else (lo, mid)
        return lo
    hi_v = drop_v(prc_min, lay1, D['pack_lead_hi_mm2'], f1, D=D)
    pr = [] if hi_v <= D['limit_v'] + 1e-12 else ['drop_hi %.4f V > %.3f V at %.1f A (hot fuse x %.2f, vendor minimum '
                                                   'strands, lay %.2f)' % (hi_v, D['limit_v'], D['i_peak_a'], f1, lay1)]
    decision = dict(
        shorter_path_max_mm_hot_fuse=_r(max_path(f1), 1), shorter_path_max_mm_cold_fuse=_r(max_path(f0), 1),
        awg14_nominal_hi_drop_v=_r(drop_v(2.0809, lay1, D['pack_lead_hi_mm2'], f1, D=D), 5),
        awg14_note='AWG 14 nominal 2.0809 mm2 for information only; OD and lane fit unchecked (lane re-check needed)',
        cutoff_raise_needed_v=_r(max(0.0, hi_v - D['limit_v']), 5),
        # H2 (VN-62): the four cases over finished lengths, for the user decision (information; the gate is drop_hi)
        by_finished_length_mm={str(L): dict(
            lo_v=_r(drop_v(D['awg16_mm2'], lay0, D['awg18_mm2'], f0, L, D), 5),
            hi_cold_fuse_v=_r(drop_v(prc_min, lay1, D['pack_lead_hi_mm2'], f0, L, D), 5),
            nominal_hot_fuse_v=_r(drop_v(D['awg16_mm2'], lay0, D['awg18_mm2'], f1, L, D), 5),
            hi_v=_r(drop_v(prc_min, lay1, D['pack_lead_hi_mm2'], f1, L, D), 5),
            awg14_nominal_hi_v=_r(drop_v(2.0809, lay1, D['pack_lead_hi_mm2'], f1, L, D), 5),
            cutoff_raise_needed_v=_r(max(0.0, drop_v(prc_min, lay1, D['pack_lead_hi_mm2'], f1, L, D) - D['limit_v']), 5))
            for L in (220.0, 225.0, 237.0, 250.0, 260.0, 270.0, 280.0)},
        options='VN-62 user decision: shorter finished path, 14 AWG with a lane re-check, or a higher software cut-off. '
                'The 0.150 V limit is never relaxed by this check.')
    return dict(category='lead_access', id='pigtail_drop', kind='drop', model='r7 _pigtail_drop_v (G-W5) with '
                'vendor strand data', i_peak_a=D['i_peak_a'], limit_v=D['limit_v'], cases=out,
                drop_lo_v=out['lo']['drop_v'], drop_hi_v=out['hi']['drop_v'], vendor=D['prc_src'],
                assumptions=dict(lay_range=list(D['lay_range']), fuse_hot_factor_range=list(D['fuse_hot_factor_range']),
                                 pack_lead='150 x 0.08 mm 18 AWG silicone (strand count unknown; MP-PACK)',
                                 copper='IACS annealed copper 1/58 ohm mm2/m at 20 C, alpha 0.00393/K, 60 C'),
                decision_data=decision, gate=D['gate'], estimate=True, problems=pr, status='fail' if pr else 'pass')


# ------------------------------------------------------------------ cable_routes (r7 C2 semantics, VN-26 / VN-28)
def _end_boxes(H, c, part, where):
    if where == 'start' and c.get('housing'):
        return [H['housings'][c['housing']]['box']]
    if where == 'end' and c.get('end_plug'):
        return [H['plugs'][c['end_plug']]]
    return [H['boxes'][part]] if part in H['boxes'] else []


def _gap(p, boxes):
    return min(pt_box_dist(p, b) for b in boxes) if boxes else float('inf')


def min_route(H, c, rounded_path):
    """(shortest route length, how): family minimum (+ longest branch), hump drawn out, or the fixed curve."""
    if c.get('family'):
        fr = family_range(rounded_path, c['curve'], c['family'])
        br = max([b['length'] for b in c['branches']] or [0.0])
        return (None if fr['min_mm'] is None else fr['min_mm'] + br), dict(family=fr, longest_branch_mm=br)
    if c.get('core'):
        hx = hump_excess(c['core']['upper_curve']['slack_hump'])
        return c['core']['modeled_length_mm'] - hx['excess_mm'], dict(hump=hx, modeled_mm=c['core']['modeled_length_mm'])
    L = c['curve'].get('rounded_length_mm') or arc_length(c['points'])
    return L, dict(fixed_curve_mm=L)


def cable_routes_rows(H, rounded_path):
    rows = []
    for cid, c in H['cables'].items():
        row = dict(category='cable_routes', id=cid, length_mm=c.get('length'), length_range=c.get('length_range'),
                   range_src=c.get('range_src'), estimate=True)
        if 'delegated' in c:
            rows.append(dict(row, status='info', covered_by=c['delegated']))
            continue
        if c['errors'] or not c['points']:
            rows.append(dict(row, status='fail', problems=['no current installed route: ' + '; '.join(
                c['errors'] or ['no centreline'])]))
            continue
        pts, probs = c['points'], []
        a, b = c['ends']
        if c['branches']:
            ga = max(_gap(br['points'][0], [H['housings'][br['id']]['box']]) for br in c['branches'])
            gb = _gap(pts[-1], _end_boxes(H, c, b, 'end'))
            end_gap = max(ga, gb)
            fan = max(math.dist(br['points'][-1], pts[0]) for br in c['branches'])
            row['fan_in_gap_mm'] = _r(fan, 2)
            if fan > ROUTE_END_TOL + 1e-9:
                probs.append('branch-to-main fan-in gap %.2f mm > %.1f (unmodeled fan-in; signal_routes fan_in_gate)'
                             % (fan, ROUTE_END_TOL))
        else:
            A0, B1 = _end_boxes(H, c, a, 'start'), _end_boxes(H, c, b, 'end')
            A1, B0 = _end_boxes(H, c, a, 'end'), _end_boxes(H, c, b, 'start')
            end_gap = min(max(_gap(pts[0], A0), _gap(pts[-1], B1)), max(_gap(pts[0], B0), _gap(pts[-1], A1)))
        if end_gap > ROUTE_END_TOL + 1e-9:
            probs.append('route ends %.2f mm from its end parts / plugs %s (> %.1f)' % (end_gap, list(c['ends']), ROUTE_END_TOL))
        lmin = (c.get('length_range') or (c['length'],))[0]
        mr, how = min_route(H, c, rounded_path)
        allow = route_allowance(c['length'])
        if mr is None:
            probs.append('no valid family member at the solver bounds')
        elif mr + allow > lmin + 1e-6:
            probs.append('shortest route %.1f + allowance %.1f > minimum stock %.1f mm' % (mr, allow, lmin))
        row.update(installed_mm=_r(c['curve'].get('rounded_length_mm') if c.get('curve') else arc_length(pts), 2),
                   min_route_mm=_r(mr, 2), allowance_mm=_r(allow, 1), length_min_mm=lmin,
                   slack_mm=None if mr is None else _r(lmin - mr - allow, 2), end_gap_mm=_r(end_gap, 2), basis=how,
                   problems=probs, status='fail' if probs else 'pass')
        rows.append(row)
    return rows


# ------------------------------------------------------------------ cable_stow (r7 C2 semantics)
def cable_stow_rows(H, rounded_path, finished=None):
    """Every mm of the longest purchased lead needs a modeled home: a stretched family absorbs up to its maximum;
    a fixed curve's spare with no home is 'info' (r7: 'no named home'); cut-to-length leads report the spare their
    finished length leaves in the closed pose (finished: {cable: minimum finished length from mate_reach})."""
    rows, finished = [], finished or {}
    for cid, c in H['cables'].items():
        row = dict(category='cable_stow', id=cid, estimate=True)
        if 'delegated' in c:
            rows.append(dict(row, status='info', covered_by=c['delegated']))
            continue
        if c['errors'] or not c['points']:
            rows.append(dict(row, status='info', home='no installed route (see cable_routes)'))
            continue
        lmax = (c.get('length_range') or (None, c['length']))[-1]
        if c.get('family'):
            fr = family_range(rounded_path, c['curve'], c['family'])
            br = max([b['length'] for b in c['branches']] or [0.0])
            cap = None if fr['max_mm'] is None else fr['max_mm'] + br
            pr = [] if cap is not None and cap >= lmax - 1e-6 else [
                'longest lead %.1f mm > family maximum %s mm: spare has no modeled home' % (lmax, _r(cap, 1))]
            rows.append(dict(row, kind='loop', home='%s loop (%s)' % (cid, fr['src']), length_max_mm=lmax,
                             family_min_mm=_r(None if fr['min_mm'] is None else fr['min_mm'] + br, 2),
                             family_max_mm=_r(cap, 2), problems=pr, status='fail' if pr else 'pass'))
        elif c.get('core'):
            hx = hump_excess(c['core']['upper_curve']['slack_hump'])
            rows.append(dict(row, kind='hump', home='stored hump (power_routes)', status='info',
                             hump_excess_mm=_r(hx['excess_mm'], 2),
                             note='cut to the 270 mm finished path; cut tolerance and stored-length fit are G-V-PIGTAIL'))
        else:
            route = c['curve'].get('rounded_length_mm') or arc_length(c['points'])
            # H1: a cut-to-length assembly with no mate_reach finished length is cut to its route + the r7 allowance
            total = finished.get(cid, route + route_allowance(route) if c.get('cut_to_length') else lmax)
            rows.append(dict(row, kind='spare', status='info', closed_route_mm=_r(route, 2),
                             finished_length_mm=_r(total, 1), spare_mm=_r(total - route, 1),
                             home='no named home (r7 cable_stow info; give it a modeled home)'))
    return rows


# ------------------------------------------------------------------ header_housings (r7 C2 semantics)
def header_housing_rows(H, final_present, printed_dist=None, cots_dist=None):
    """r7 check_header_housings. COTS gaps use the proxy boxes (r7); where a box gap is under min_gap and cots_dist is
    given, the exact candidate proxy solid decides (the candidate's COTS proxies are STEP solids, not boxes)."""
    rows, hd = [], H['hdr']
    shrink = (max(hd['sec']) - min(hd['sec'])) / 2
    small = {k: [h['box'][0] + shrink, h['box'][1] - shrink, h['box'][2], h['box'][3], h['box'][4] + shrink,
                 h['box'][5] - shrink] for k, h in H['housings'].items()}
    for hid, h in H['housings'].items():
        b, pins, pr = h['box'], h['pins'], []
        typ = H['header_types'].get(hid)
        used = set(H['used_pins'].get(h['cable'], ()))
        if [p for p in pins if p not in used]:
            pr.append('covers unused pin(s) %s' % [p for p in pins if p not in used])
        if typ == '1' and len(pins) != 1:
            pr.append("type '1' with %d pins" % len(pins))
        elif typ == '1x2' and not (len(pins) == 2 and ((pins[0] % 2 == pins[1] % 2 and abs(pins[0] - pins[1]) == 2)
                                                     or (min(pins) % 2 == 1 and abs(pins[0] - pins[1]) == 1))):
            pr.append("type '1x2' on non-adjacent pins %s" % (pins,))
        elif typ not in ('1', '1x2'):
            pr.append('illegal housing type %r' % typ)
        cg = sorted((box_gap(H['boxes'][i], b), i) for i in final_present
                    if H['kinds'].get(i) == 'cots' and i != 'pi5' and i in H['boxes'])
        refined = {}
        if cots_dist:
            for g, i in cg:
                if g < HDR_MIN_GAP - 1e-9:
                    refined[i] = dict(box_gap_mm=_r(g, 2), exact_mm=_r(cots_dist(i, b), 3))
            cg = sorted((refined[i]['exact_mm'] if i in refined else g, i) for g, i in cg)
        if cg and cg[0][0] < HDR_MIN_GAP - 1e-9:
            pr.append('gap %.2f to COTS %s < %.1f' % (cg[0][0], cg[0][1], HDR_MIN_GAP))
        pg = []
        for i in final_present:
            if H['kinds'].get(i) != 'printed' or i not in H['boxes'] or box_gap(H['boxes'][i], b) > 3.0:
                continue
            d = printed_dist(i, b) if printed_dist else max(0.0, box_gap(H['boxes'][i], b))
            pg.append((d, i))
            if d < HDR_MIN_GAP - 1e-9:
                pr.append('distance %.2f to %s < %.1f' % (d, i, HDR_MIN_GAP))
        pg.sort()
        starts = [s for cab, s in H['branch_starts'] if cab == hid]
        con = min([math.dist(s, h['wire_exit']) for s in starts] or [float('inf')])
        if con > ROUTE_END_TOL + 1e-9:
            pr.append('no route starts at the housing wire exit (nearest %s mm)' % _r(con, 2))
        ov = [k for k, o in small.items() if k != hid and box_vol(small[hid], o) > 1e-9]
        if ov:
            pr.append('overlaps housing(s) %s' % ov)
        rows.append(dict(category='header_housings', id=hid, cable=h['cable'], type=typ, pins=pins,
                         box=[_r(x, 2) for x in b], cots_gap_mm=_r(cg[0][0], 2) if cg else None,
                         cots_nearest=cg[0][1] if cg else None, printed_gap_mm=_r(pg[0][0], 2) if pg else None,
                         cots_refined=refined, printed_nearest=pg[0][1] if pg else None, printed_method='exact STEP distance' if printed_dist
                         else 'bbox gap (no solids)', route_start_mm=_r(con, 3), problems=pr,
                         status='fail' if pr else 'pass'))
    return rows


# ------------------------------------------------------------------ family consistency (manifest-bound verifier)
def family_rows(H, rounded_path):
    rows = []
    for cid, c in H['cables'].items():
        if not c.get('family'):
            continue
        fr = family_range(rounded_path, c['curve'], c['family'])
        pr = []
        if not fr['knots_share_variable']:
            pr.append('family knots %s do not share one solver variable' % (c['family']['knots'],))
        if fr['recomputed_mm'] is None or abs(fr['recomputed_mm'] - fr['recorded_mm']) > 1e-6:
            pr.append('recomputed %s != recorded %s mm' % (fr['recomputed_mm'], fr['recorded_mm']))
        if not (min(fr['bound']) - 1e-9 <= fr['recorded'] <= max(fr['bound']) + 1e-9):
            pr.append('recorded %s outside the solver bound %s' % (fr['recorded'], fr['bound']))
        rows.append(dict(category='signal_routes', id='family_' + cid, family=fr, problems=pr,
                         status='fail' if pr else 'pass'))
    return rows


# ------------------------------------------------------------------ mate_reach (r7 C2/C3 semantics)
# One row per steps.CONNECTIONS end that is mated in a displaced pose. disp None: taken from the named motion's
# first knot (steps.MOTIONS). Anchor: the last route point fixed to the body at that op (see anchor_src).
MATE_POSES = [
    dict(id='qt_enc', connection='qt:enc', cable='qt', kind='plug', op='panel_prop', disp=(0.0, 60.0, 0.0),
         path_motion='panel_in', end='encoder', anchor_knot=6, axis=(1.0, 0.0, 0.0), row=(0.0, 0.0, 1.0),
         hand='pinch_sh', disp_src='ASSEMBLY-VERTICAL.md s6: baseline 60 mm prop offset (r7 MATE_POSES qt_enc)',
         anchor_src='secured-lane anchor: knot 6, the last route knot fixed to the body once the QT lead is in its '
                    'lanes (the wall loop may shrink to its family minimum); applies only if steps.py secures the '
                    'lead before panel_prop (lead_state, fixup-1)'),
    dict(id='j2_btn', connection='j2:btn', cable='power_button', kind='inline', op='panel_prop',
         disp=(0.0, 60.0, 0.0), path_motion='panel_in', end='power_button', anchor_knot=7, row=(0.0, 0.0, 1.0),
         hand='pinch_ph', junction_out=JUNCTION_OUT, halves=(('2181120201 female', 150.0, 6.0),
                                                             ('2181110202 male', 225.0, 6.0)),
         disp_src='ASSEMBLY-VERTICAL.md s6: baseline 60 mm prop offset',
         anchor_src='secured-lane anchor: knot 7, the last body-fixed knot once the J2 lead is in its lanes; applies '
                    'only if steps.py secures the lead before panel_prop (lead_state, fixup-1)'),
    dict(id='run_pi_37', connection='run_lead:pi', cable='run_pin37', kind='plug_reverse', op='module_staged',
         disp=None, path_motion='carrier_in', end='pi5', axis=(0.0, 1.0, 0.0), row=(0.0, 0.0, 1.0), hand='pinch_ph1',
         disp_src='steps.MOTIONS carrier_in first knot (module staged outside the open +Y side)',
         anchor_src='lanes are secured only at evf_mate (later): the lead is free beyond the top of its floor-hole '
                    'riser (the route knot after the button leg; the tail does not start lying on the floor)'),
    dict(id='run_pi_39', connection='run_lead:pi', cable='run_pin39', kind='plug_reverse', op='module_staged',
         disp=None, path_motion='carrier_in', end='pi5', axis=(0.0, 1.0, 0.0), row=(0.0, 0.0, 1.0), hand='pinch_ph1',
         disp_src='steps.MOTIONS carrier_in first knot (module staged outside the open +Y side)',
         anchor_src='as run_pi_37'),
    dict(id='xt30_pack', connection='xt30:pack', cable='pigtail', kind='pigtail', op='pack_in', end='xt30_pair',
         hand='pinch_xt30', axis=(0.0, 0.0, -1.0), row=(1.0, 0.0, 0.0), hang=('pack', 'pack_lead', 60.0),
         hang_motion='pack_in', disp_src='last rigid service pose of power_routes (battery-isolation pose)'),
]
MATE_INFO = [
    ('fps_1824', 'both ends mated on the bench (module_bench) and carried in one moving set (r7 both_moving info)'),
    ('fan', 'both ends mated on the bench (module_bench) and carried in one moving set (r7 both_moving info)'),
    ('camera_fpc:pi', 'in-situ mate at evf_mate through the CSI side slot: no displaced pose; reach = installed route '
                      '(cable_routes fpc), tool access = verify_csi_source; finger access HOLD'),
    ('evf_hdmi:evf', 'in-situ mate at evf_mate (head pushed up from below): reach = verify_hdmi carried ribbon'),
    ('evf_5v:evf', 'in-situ mate at evf_mate: the RCY pair sits on the installed usb_5v route (feed_volumes '
                   'usb_5v_rcy_pair, Z35..42 behind the HDMI ribbon, storage stick still out); hand / tweezer access and '
                   'the 2181 half parked during carrier_in are not modeled (HOLD: MEASUREMENTS-TO-CLOSE EVF power RCY row)'),
]


def pose_state(ST, op_id):
    """(body ids before the op, moving ids) from the assembly-state model."""
    for o, before, _after, groups in ST.build_sequence():
        if o['id'] == op_id:
            moving = set(groups.get(o.get('group'), ())) if o['where'] in ('prop', 'bench') else set(o['adds'])
            return set(before), moving
    raise KeyError(op_id)


def box_hits(spec, targets):
    """Fallback hit test on boxes only (a cylinder by its bounding box): conservative."""
    b = spec['box'] if spec['type'] in ('box', 'obox') else tail_box(spec['p0'], spec['p1'], spec['d'])   # obox: AABB
    return [dict(obstacle=t['id'], volume_mm3=_r(box_vol(b, t['box']), 2)) for t in targets
            if box_vol(b, t['box']) > spec.get('tol', SWEEP_TOL)]


def _targets(H, body, moving, disp, exclude):
    out = []
    for i in sorted(body | moving):
        if i in exclude or i not in H['boxes']:
            continue
        d = tuple(disp) if i in moving else (0.0, 0.0, 0.0)
        out.append(dict(id=i, kind=H['kinds'][i], disp=d, box=shift(H['boxes'][i], d)))
    return out


def _segment_at_y(p0, p1, y):
    if (p1[1] - p0[1]) == 0 or not (min(p0[1], p1[1]) <= y <= max(p0[1], p1[1])):
        return None
    t = (y - p0[1]) / (p1[1] - p0[1])
    return [p0[i] + t * (p1[i] - p0[i]) for i in range(3)]


def mate_reach_rows(H, rounded_path, ST, hits=box_hits, lengths=None, retention=None):
    """lengths: {cable: L_min override} (regression fixtures). -> (rows, finished {cable: min finished length})."""
    lengths, rows, finished = lengths or {}, [], {}
    opening = ('+y', H['opening_y'], 0.0)
    for mp in MATE_POSES:
        row = dict(category='mate_reach', id=mp['id'], connection=mp['connection'], op=mp['op'], estimate=True,
                   disp_src=mp.get('disp_src'), anchor_src=mp.get('anchor_src'))
        body, moving = pose_state(ST, mp['op'])
        probs = []
        if mp['kind'] == 'pigtail':
            rows.append(_pigtail_mate_row(H, mp, row, body, moving, hits, retention, rounded_path, ST))
            continue
        if mp['kind'] == 'inline':
            r, fin = _inline_row(H, mp, rounded_path, ST, hits, opening, lengths)
            rows.append(r)
            finished[mp['cable']] = fin
            continue
        c = H['cables'][mp['cable']]
        path = ST.MOTIONS[mp['path_motion']]['path']
        disp = tuple(mp['disp']) if mp.get('disp') else tuple(path[0])
        lmin = lengths.get(mp['cable'], (c.get('length_range') or (c['length'],))[0])
        if not on_path(path, disp):
            probs.append('mate pose %s not on the %s path' % (list(disp), mp['path_motion']))
        if mp['kind'] == 'plug':
            fam, curve = c['family'], c['curve']
            fr = family_range(rounded_path, curve, fam)
            br = max([b['length'] for b in c['branches']] or [0.0])
            fixed = br + family_eval(rounded_path, curve, fam, fr['min_at'], upto=mp['anchor_knot'])['length']
            apt = list(curve['knots'][mp['anchor_knot']])
            W = c['points'][-1]
            free_from = c['points'][0]
        else:   # plug_reverse: the fixed end is the route END (run button); the plug is the route START (header)
            pts, kn = c['points'], c['curve']['knots']
            if not (kn[-1][2] < H['floor_z'] < kn[-2][2]):
                probs.append('the last route leg does not rise through the floor plane z %.1f' % H['floor_z'])
            apt = list(kn[-2])
            fixed = math.dist(kn[-1], kn[-2])
            W = pts[0]
            free_from = None
        Wd = add(W, disp)
        tail = math.dist(apt, Wd)
        m = reach_margin(lmin)
        slack = lmin - fixed - tail - m

        def slack_at(dy):
            return lmin - fixed - math.dist(apt, [W[0] + disp[0], W[1] + dy, W[2] + disp[2]]) - m
        lo, hi = 0.0, 300.0
        for _ in range(60):
            mid = (lo + hi) / 2
            lo, hi = (mid, hi) if slack_at(mid) >= 0 else (lo, mid)
        row.update(cable=mp['cable'], pose=list(disp), length_min=lmin, margin=_r(m, 1), fixed_mm=_r(fixed, 1),
                   anchor_pt=[_r(x, 2) for x in apt], W_pose=[_r(x, 2) for x in Wd], tail_mm=_r(tail, 1),
                   slack_mm=_r(slack, 1), max_offset_y_for_reach_mm=_r(lo, 1) if slack_at(0.0) >= 0 else None)
        if free_from is not None:
            row['info_free_lead_need_mm'] = _r(br + math.dist(free_from, Wd) + m, 1)
            row['info_free_lead_note'] = ('if the lead were left out of its lanes until the panel closes: longest '
                                          'branch + straight main start to the posed plug + margin (lower bound, '
                                          'not obstacle-checked); see lead_state for whether this is the documented order')
        if slack < -1e-9:
            probs.append('lead short by %.1f mm in the mating pose (L %.0f, fixed %.1f, tail %.1f, margin %.1f)'
                         % (-slack, lmin, fixed, tail, m))
        hb = hand_box(Wd, mp['axis'], mp['row'], HAND_ENVELOPES[mp['hand']])
        tg = _targets(H, body, moving, disp, {mp['end']})
        hh = hits(dict(type='box', box=hb), tg)
        th = hits(dict(type='cyl', p0=apt, p1=Wd, d=TAIL_D), tg)
        oo = out_of_mm(hb, opening)
        row.update(hand=mp['hand'], hand_box=[_r(x, 2) for x in hb], hand_hits=hh, tail_hits=th,
                   out_of=list(opening), out_of_mm=_r(oo, 2), targets=len(tg))
        for bad, msg in ((hh, 'hand envelope hits %s' % ', '.join(h['obstacle'] for h in hh)),
                         (oo < -1e-9, 'hand envelope %.2f mm short of %s' % (-oo, list(opening))),
                         (th, 'tail path blocked by %s' % ', '.join(h['obstacle'] for h in th))):
            if bad:
                probs.append(msg)
        rows.append(dict(row, problems=probs, status='fail' if probs else 'pass'))
    for mp in MATE_POSES:
        if mp['kind'] in ('plug', 'inline'):
            r_ = next(r for r in rows if r['id'] == mp['id'])
            _apply_lead_state(r_, mp, ST, H, rounded_path, hits, lengths)
            if mp['kind'] == 'inline' and (r_.get('free_lead') or {}).get('min_finished_length_mm') is not None:
                finished[mp['cable']] = r_['free_lead']['min_finished_length_mm']   # H2: the documented (free) order
    for cid, why in MATE_INFO:
        rows.append(dict(category='mate_reach', id='info_' + cid.replace(':', '_'), connection=cid, status='info',
                         note=why))
    return rows, finished


def _apply_lead_state(row, mp, ST, H=None, rounded_path=None, hits=None, lengths=None):
    """fixup-1: the reach above assumes the lead is already secured in its lanes (anchor knot). steps.py `secures`
    decides whether that is the documented order. If the lead is still free at the mating op, the secured-lane figures
    do not describe it: the row fails until a free-lead route from the header end is computed and obstacle-checked,
    and the secured-lane problems are kept, labelled, never dropped. H2: when the route source declares a free-lead
    route for this mate (H['free_leads']), free_lead_eval() decides the row; the secured-lane problems move to
    'secured_lane_case' (reported, not the documented order); lane-independent problems (pose on its path, and for a
    plug the hand envelope at the posed plug) still gate."""
    lead = mp['connection'].split(':')[0]
    at = ST.secured_at(lead)
    secured = ST.secured_before(lead, mp['op'])
    row['lead_state'] = ('secured in its lanes at %s, before %s' % (at, mp['op']) if secured else
                         'free at %s; laid into its lanes at %s (steps.py secures)' % (mp['op'], at))
    if secured:
        return
    fl = (H.get('free_leads') or {}).get(mp['id']) if H is not None and rounded_path is not None else None
    if fl is not None:
        res = free_lead_eval(H, mp, fl, rounded_path, ST, hits or box_hits, lengths)
        row['free_lead'] = res
        lane = list(row['problems'])
        keep = [p for p in lane if p.startswith('mate pose') or (mp['kind'] == 'plug' and p.startswith('hand envelope'))]
        row['secured_lane_case'] = dict(problems=[p for p in lane if p not in keep],
                                        note='lanes secured before %s is not the documented order (steps.py secures at '
                                             '%s); reported, not gating' % (mp['op'], at))
        row['problems'] = keep + ['free-lead route: ' + p for p in res['problems']]
        row['status'] = 'fail' if row['problems'] else 'pass'
        if mp['kind'] == 'inline' and res.get('min_finished_length_mm') is not None:
            row['min_finished_length_mm'] = res['min_finished_length_mm']
        return
    lb = row.get('info_free_lead_need_mm')
    msg = ('lead is free at %s (secured only at %s): no obstacle-checked free-lead route from the header end to the '
           'posed end exists yet (FP-10 HOLD)' % (mp['op'], at))
    if lb is not None:
        msg += '; straight lower bound %.1f mm vs L_min %s (necessary only)' % (lb, row.get('length_min'))
        if lb > (row.get('length_min') or 0) + 1e-9:
            msg += ' - short even on the lower bound'
    row['problems'] = [msg] + ['secured-lane case (not the documented order): ' + p for p in row['problems']]
    row['status'] = 'fail'


# ------------------------------------------------------------------ free-lead routes (H2: VN-28, the FP-10 HOLD)
# A free-lead route is declared in the route source (signal_routes.build() 'free_leads'): knots from the body-fixed
# end of the free lead (QT: the modeled fan-in point, after the longest branch; J2: the pad root of the installed
# route) to the posed far end, rounded at the cable's own bend radius. Instead of r7's straight tail from a secured
# anchor, the drawn route must: (1) be a valid rounded curve; (2) start on the body-fixed end and end on the posed
# plug / far end within ROUTE_END_TOL, leaving and arriving along the installed route's own first / last leg
# (FREE_LEAD_END_ANGLE_DEG); (3) fit: plug: fixed + route + reach_margin(L_min) <= L_min; inline: the junction on the
# route, junction_out beyond the opening with the centred pinch box wholly beyond it, each half its need +
# reach_margin(half) (both gender assignments); (4) clear every part present at the op, the moving set displaced by
# the pose, as a capsule (OD + 2 x MEMBER_TOL) with the strict INSTALLED_TOL (own end parts exempt, r7 rule), plus the
# HDMI ribbon cells of the state at the op and the FPS mated pair as keepouts; (5) keep its envelope off every other
# modeled cable at the op (leads free at the op are represented by their free routes, not their installed ones).
FREE_LEAD_END_ANGLE_DEG = 5.0


def _leg_dir(pts, first):
    a, b = (pts[0], pts[1]) if first else (pts[-2], pts[-1])
    n = math.dist(a, b)
    return [(b[i] - a[i]) / n for i in range(3)] if n > 1e-12 else None


def _angle_deg(u, v):
    if u is None or v is None:
        return None
    return math.degrees(math.acos(max(-1.0, min(1.0, sum(u[i] * v[i] for i in range(3))))))


def free_lead_curve(fl, rounded_path):
    return rounded_path(fl['knots'], fl['radius'], fl['first_tail'], fl['last_tail'], 0.5)


def free_lead_eval(H, mp, fl, rounded_path, ST, hits=box_hits, lengths=None):
    c = H['cables'][mp['cable']]
    body, moving = pose_state(ST, mp['op'])
    disp = tuple(mp['disp'])
    cv = free_lead_curve(fl, rounded_path)
    res = dict(source=fl.get('src'), op=mp['op'], pose=list(disp), knots=[[_r(v, 3) for v in k] for k in fl['knots']],
               radius_mm=fl['radius'], od_mm=fl['od_mm'])
    if cv['errors'] or cv.get('rounded_length_mm') is None:
        return dict(res, problems=['invalid rounded route: %s' % '; '.join(cv['errors'] or ['no length'])])
    pts, L = [list(p) for p in cv['sampled_centerline']], cv['rounded_length_mm']
    probs = []
    inst = c['curve']['knots']
    if mp['kind'] == 'plug':
        start_ref, fixed = list(c['points'][0]), max([b['length'] for b in c['branches']] or [0.0])
    else:
        start_ref, fixed = list(c['points'][0]), 0.0
    end_ref = add(c['points'][-1], disp)
    g0, g1 = math.dist(pts[0], start_ref), math.dist(pts[-1], end_ref)
    a0 = _angle_deg(_leg_dir(fl['knots'], True), _leg_dir(inst, True))
    a1 = _angle_deg(_leg_dir(fl['knots'], False), _leg_dir(inst, False))
    for bad, msg in ((g0 > ROUTE_END_TOL + 1e-9, 'starts %.2f mm from the body-fixed end %s' % (g0, [_r(v, 2) for v in start_ref])),
                     (g1 > ROUTE_END_TOL + 1e-9, 'ends %.2f mm from the posed end %s' % (g1, [_r(v, 2) for v in end_ref])),
                     (a0 is None or a0 > FREE_LEAD_END_ANGLE_DEG, 'leaves the body-fixed end at %s deg to the installed first leg' % _r(a0, 1)),
                     (a1 is None or a1 > FREE_LEAD_END_ANGLE_DEG, 'arrives at the posed end at %s deg to the installed last leg' % _r(a1, 1))):
        if bad:
            probs.append(msg)
    res.update(route_mm=_r(L, 2), fixed_mm=_r(fixed, 2), start_gap_mm=_r(g0, 3), end_gap_mm=_r(g1, 3),
               start_angle_deg=_r(a0, 2), end_angle_deg=_r(a1, 2))
    tg = _targets(H, body, moving, disp, set(c['ends']))
    env = HAND_ENVELOPES[mp['hand']]
    opening = ('+y', H['opening_y'], 0.0)
    if mp['kind'] == 'plug':
        lmin = (lengths or {}).get(mp['cable'], (c.get('length_range') or (c['length'],))[0])
        m = reach_margin(lmin)
        need = fixed + L + m
        res.update(length_min=lmin, margin=_r(m, 1), need_mm=_r(need, 2), slack_mm=_r(lmin - need, 2))
        if need > lmin + 1e-9:
            probs.append('lead short by %.1f mm on the free route (L %.0f, fixed %.1f, route %.1f, margin %.1f)'
                         % (need - lmin, lmin, fixed, L, m))
    else:
        cum = cumulative(pts)
        J = s_J = u = hb = None
        for i in range(1, len(pts)):
            uu = [(pts[i][k] - pts[i - 1][k]) / max(1e-12, math.dist(pts[i], pts[i - 1])) for k in range(3)]
            hb_i = hand_box(add(pts[i], uu, env[0] / 2), uu, mp['row'], env)
            if pts[i][1] >= H['opening_y'] + mp['junction_out'] - 1e-9 and out_of_mm(hb_i, opening) >= -1e-9:
                J, s_J, u, hb = pts[i], cum[i], uu, hb_i
                break
        if J is None:
            probs.append('no route point puts the junction %.1f mm beyond the opening with the pinch box beyond it'
                         % mp['junction_out'])
        else:
            halves = (lengths or {}).get(mp['cable'], mp['halves'])
            assign = []
            for (bn, bl, bt), (fn, fl_, ft) in ((halves[0], halves[1]), (halves[1], halves[0])):
                nb, nf = s_J + reach_margin(bl - bt), (L - s_J) + reach_margin(fl_ - ft)
                assign.append(dict(body_side=bn, far_side=fn, body_need_mm=_r(nb, 1), body_min_mm=bl - bt,
                                   far_need_mm=_r(nf, 1), far_min_mm=fl_ - ft,
                                   feasible=nb <= bl - bt + 1e-9 and nf <= fl_ - ft + 1e-9))
            if not all(a['feasible'] for a in assign):
                probs.append('junction on the free route cannot be reached by %s (side genders unassigned: VN-63)'
                             % [a['body_side'] for a in assign if not a['feasible']])
            hh = hits(dict(type='box', box=hb), tg)
            if hh:
                probs.append('hand envelope at the junction hits %s' % ', '.join(h['obstacle'] for h in hh))
            res.update(junction_at=[_r(v, 2) for v in J], junction_s_mm=_r(s_J, 2), assignments=assign,
                       min_finished_length_mm=_r(min(a['body_need_mm'] + a['far_need_mm'] for a in assign), 1),
                       hand=mp['hand'], hand_box=[_r(v, 2) for v in hb], hand_hits=hh,
                       hand_out_of_mm=_r(out_of_mm(hb, opening), 2))
    # (4) capsule sweep against the parts present at the op (moving set displaced) and the keepouts of that state
    state = fl.get('hdmi_state', 'installed')
    tg_k = tg + [dict(id='hdmi_ribbon cell %d' % i, kind='keepout', disp=(0.0, 0.0, 0.0), box=b)
                 for i, b in enumerate((H.get('hdmi_cells_state') or {}).get(state, []))]
    if H.get('fps_pair_box'):
        tg_k.append(dict(id='fps_mated_pair', kind='keepout', disp=(0.0, 0.0, 0.0), box=H['fps_pair_box']))
    # rigid connector heads and header housings of the other cables (all taken as mated: conservative)
    own = mp['cable']
    tg_k += [dict(id='plug ' + pid, kind='keepout', disp=(0.0, 0.0, 0.0), box=b) for pid, b in H['plugs'].items()
             if (H.get('plug_cable') or {}).get(pid) not in (own, None)]
    tg_k += [dict(id='housing ' + hid, kind='keepout', disp=(0.0, 0.0, 0.0), box=h['box']) for hid, h in H['housings'].items()
             if h['cable'] != own]
    sp = simplify_polyline(pts, MEMBER_TOL)
    d = fl['od_mm'] + 2 * MEMBER_TOL
    found = {}
    specs = capsule_specs(sp, d)
    for s_ in specs:
        for h in hits(s_, tg_k):
            key = 'hdmi_ribbon' if h['obstacle'].startswith('hdmi_ribbon') else h['obstacle']
            found[key] = round(found.get(key, 0.0) + h['volume_mm3'], 2)
    if found:
        probs.append('free route intersects %s at %s (capsule d %.2f mm)' % (
            ', '.join('%s %.2f mm3' % kv for kv in sorted(found.items())), mp['op'], d))
    # (5) separation from the cables present at the op
    free_ids = {f['cable'] for k, f in (H.get('free_leads') or {}).items() if f['op'] == mp['op']}
    neigh = [(n, q, dq) for n, q, dq in neighbour_cables(H, mp['cable']) if n.split(':')[0] not in free_ids]
    for k, f in (H.get('free_leads') or {}).items():
        if f['op'] == mp['op'] and f['cable'] != mp['cable']:
            fc = free_lead_curve(f, rounded_path)
            if not fc['errors']:
                neigh.append(('free_lead:' + k, fc['sampled_centerline'], f['od_mm']))
    sep, over = {}, []
    for n, q, dq in neigh:
        dist, needd = polyline_distance(pts, q, SEPARATION_TOL), (fl['od_mm'] + dq) / 2
        sep[n] = dict(min_centreline_mm=_r(dist, 2), need_mm=_r(needd, 2))
        if dist < needd - 1e-9:
            over.append('%s %.2f < %.2f mm' % (n, dist, needd))
    if over:
        probs.append('free route envelope overlaps cable(s): ' + '; '.join(over))
    tight = sorted(sep.items(), key=lambda kv: kv[1]['min_centreline_mm'] - kv[1]['need_mm'])[:5]
    res.update(capsule_d_mm=_r(d, 2), pieces=len(specs), targets=len(tg_k), exempt=sorted(c['ends']), hits=found,
               hdmi_state=state, tightest_separation=dict(tight), cable_overlaps=over, problems=probs)
    return res


def _inline_row(H, mp, rounded_path, ST, hits, opening, lengths=None):
    c = H['cables'][mp['cable']]
    body, moving = pose_state(ST, mp['op'])
    path = ST.MOTIONS[mp['path_motion']]['path']
    disp = tuple(mp['disp'])
    probs = [] if on_path(path, disp) else ['mate pose %s not on the %s path' % (list(disp), mp['path_motion'])]
    curve = c['curve']
    k = mp['anchor_knot']
    fixed = rounded_path(curve['knots'][:k + 1], curve['centerline_radius_mm'], curve['first_straight_min_mm'], 0.0,
                         0.5)['rounded_length_mm']
    apt, far = list(curve['knots'][k]), c['points'][-1]
    fd = add(far, disp)
    # The halves are cut to length, so the junction J is placed (not given): the first point on the anchor -> posed
    # far-end line that is junction_out beyond the opening AND puts the whole pinch box beyond it (r7 out_of).
    env = HAND_ENVELOPES[mp['hand']]
    dd = math.dist(apt, fd)
    u = [(fd[i] - apt[i]) / dd for i in range(3)]
    hb0 = hand_box(add([0.0, 0.0, 0.0], u, env[0] / 2), u, mp['row'], env)
    J = _segment_at_y(apt, fd, H['opening_y'] + max(mp['junction_out'], -hb0[2]))
    row = dict(category='mate_reach', id=mp['id'], connection=mp['connection'], op=mp['op'], cable=mp['cable'],
               pose=list(disp), fixed_mm=_r(fixed, 1), anchor_pt=[_r(x, 2) for x in apt],
               far_pose=[_r(x, 2) for x in fd], d_mm=_r(dd, 1), junction_out=mp['junction_out'],
               junction_rule='junction_out beyond the opening and the centred pinch box wholly beyond it (cut to length)',
               disp_src=mp['disp_src'], anchor_src=mp['anchor_src'], estimate=True)
    if J is None:
        probs.append('the posed far end lies less than %.1f mm beyond the opening' % mp['junction_out'])
        return dict(row, problems=probs, status='fail'), None
    body_need = fixed + math.dist(apt, J)
    far_need = math.dist(J, fd)
    assign = []
    halves = (lengths or {}).get(mp['cable'], mp['halves'])
    for (bn, bl, bt), (fn, fl, ft) in ((halves[0], halves[1]), (halves[1], halves[0])):
        nb, nf = body_need + reach_margin(bl - bt), far_need + reach_margin(fl - ft)
        assign.append(dict(body_side=bn, far_side=fn, body_need_mm=_r(nb, 1), body_min_mm=bl - bt,
                           far_need_mm=_r(nf, 1), far_min_mm=fl - ft,
                           feasible=nb <= bl - bt + 1e-9 and nf <= fl - ft + 1e-9))
    if not all(a['feasible'] for a in assign):
        probs.append('junction cannot sit %.1f mm beyond the opening for %s (side genders unassigned: VN-63)'
                     % (mp['junction_out'], [a['body_side'] for a in assign if not a['feasible']]))
    hb = hand_box(add(J, u, env[0] / 2), u, mp['row'], env)
    tg = _targets(H, body, moving, disp, {mp['end']})
    hh = hits(dict(type='box', box=hb), tg)
    th = hits(dict(type='cyl', p0=apt, p1=J, d=TAIL_D), tg)
    oo = out_of_mm(hb, opening)
    for bad, msg in ((hh, 'hand envelope hits %s' % ', '.join(h['obstacle'] for h in hh)),
                     (oo < -1e-9, 'hand envelope %.2f mm short of %s' % (-oo, list(opening))),
                     (th, 'tail path blocked by %s' % ', '.join(h['obstacle'] for h in th))):
        if bad:
            probs.append(msg)
    fin = min(a['body_need_mm'] + a['far_need_mm'] for a in assign)
    row.update(junction_at=[_r(x, 2) for x in J], assignments=assign, min_finished_length_mm=_r(fin, 1),
               hand=mp['hand'], hand_box=[_r(x, 2) for x in hb], hand_hits=hh, tail_hits=th, out_of=list(opening),
               out_of_mm=_r(oo, 2), targets=len(tg), problems=probs, status='fail' if probs else 'pass')
    return row, fin


def _pigtail_mate_row(H, mp, row, body, moving, hits, retention, rounded_path, ST=None):
    retention = PIGTAIL_RETENTION if retention is None else retention
    W = face_isolation(H, 'positive')
    rr = {r['id']: r for r in pigtail_reach_rows(H, rounded_path, retention, hits, ST)}
    gate_row = rr['pigtail_xt30_mouth' if retention == 'carrier_ties' else 'pigtail_xt30_mouth_rtv_only']
    probs = ['reach: ' + p for p in gate_row['problems']]
    pose_out = H['mouth_z'] - W[2]
    if pose_out < FACE_OUT_MIN - 1e-9:
        probs.append('isolation pose puts the face only %.2f mm out of the mouth' % pose_out)
    hb = hand_box(W, tuple(-a for a in mp['axis']), mp['row'], HAND_ENVELOPES[mp['hand']])
    out_of = ('-z', H['mouth_z'], FACE_OUT_MIN)
    oo = out_of_mm(hb, out_of)
    part, lead, lead_len = mp['hang']
    tg = _targets(H, body, set(), (0.0, 0.0, 0.0), {mp['end'], part})
    pk = shift(H['boxes'][part], H['pack_in_start'])
    lower = min(0.0, hb[4] - pk[5])
    pk = shift(pk, (0.0, 0.0, lower))
    tg.append(dict(id=part + ' (hanging)', kind='cots', disp=tuple(add(H['pack_in_start'], (0.0, 0.0, lower))), box=pk))
    near = [min(max(W[i], pk[2 * i]), pk[2 * i + 1]) if i < 2 else pk[5] for i in range(3)]
    need = math.dist(W, near) + reach_margin(lead_len)
    if need > lead_len + 1e-9:
        probs.append('%s cannot hang below the hand on its %s: needs %.1f > %.0f mm' % (part, lead, need, lead_len))
    hh = hits(dict(type='box', box=hb), tg)
    for bad, msg in ((hh, 'hand envelope hits %s' % ', '.join(h['obstacle'] for h in hh)),
                     (oo < -1e-9, 'hand envelope %.2f mm short of %s' % (-oo, list(out_of)))):
        if bad:
            probs.append(msg)
    row.update(cable='pigtail', retention=retention, reach_model='lead_access ' + gate_row['id'],
               cores=gate_row['cores'], W_pose=[_r(x, 2) for x in W], pose_out_mm=_r(pose_out, 2), hand=mp['hand'],
               hand_box=[_r(x, 2) for x in hb], hand_hits=hh, out_of=list(out_of), out_of_mm=_r(oo, 2),
               hang=dict(part=part, cable=lead, lowered_mm=_r(-lower, 2), need_mm=_r(need, 1),
                         slack_mm=_r(lead_len - need, 1)), targets=len(tg), problems=probs,
               status='fail' if probs else 'pass')
    return row


def run_all(H, rounded_path, ST, hits=box_hits, printed_dist=None, retention=None, lengths=None, cots_dist=None):
    rows = family_rows(H, rounded_path)
    rows += cable_routes_rows(H, rounded_path)
    mr, finished = mate_reach_rows(H, rounded_path, ST, hits, lengths, retention)
    rows += mr
    rows += pigtail_reach_rows(H, rounded_path, retention, hits, ST)
    rows.append(pigtail_drop_row())
    rows += cable_stow_rows(H, rounded_path, finished)
    rows += header_housing_rows(H, set(ST.final_state()), printed_dist, cots_dist)
    apply_member_clearance(rows, H, rounded_path, set(ST.final_state()), hits)   # fixup-1 (FP-10)
    apply_installed_clearance(rows, H, set(ST.final_state()), hits)              # H1 (VN-26 routes)
    rows += feed_volume_rows(H, set(ST.final_state()), hits)                     # H1 (FP-11f, VN-60)
    return rows


# ------------------------------------------------------------------ family member clearance (fixup-1, FP-10)
# A cable_stow 'loop' pass (the longest family member is the spare's home) and a cable_routes family-minimum pass
# (the shortest member is a valid route) rely on members at the solver bounds that routes never clearance-checked.
# r7 covered a stow home or route as a KEEPOUT box in its interference audit. Here each member used is swept as a
# cable-OD capsule (segment cylinders plus a cube of the capsule diameter at every joint, both enclosing the capsule)
# against the material present in the closed camera; the cable's own end parts are exempt (r7 own-end rule).
MEMBER_TOL = 0.1   # mm: polyline simplification tolerance; the capsule diameter is inflated by 2 x this


def simplify_polyline(points, tol=MEMBER_TOL):
    """Ramer-Douglas-Peucker: kept points such that every dropped point lies within tol of its chord."""
    pts = [list(p) for p in points]
    if len(pts) < 3:
        return pts
    keep, stack = {0, len(pts) - 1}, [(0, len(pts) - 1)]
    while stack:
        i, j = stack.pop()
        a, b = pts[i], pts[j]
        ab = [b[k] - a[k] for k in range(3)]
        L2 = sum(x * x for x in ab) or 1e-18
        far, dmax = None, -1.0
        for m in range(i + 1, j):
            t = max(0.0, min(1.0, sum((pts[m][k] - a[k]) * ab[k] for k in range(3)) / L2))
            d = math.dist(pts[m], [a[k] + t * ab[k] for k in range(3)])
            if d > dmax:
                far, dmax = m, d
        if far is not None and dmax > tol:
            keep.add(far)
            stack += [(i, far), (far, j)]
    return [pts[k] for k in sorted(keep)]


def member_clearance(H, rounded_path, cid, value, final_present, hits=box_hits, tol=MEMBER_TOL):
    """Capsule sweep of cable `cid`'s family member with its solver variable = value."""
    c = H['cables'][cid]
    mem = family_eval(rounded_path, c['curve'], c['family'], value)
    pts = simplify_polyline(mem['points'], tol)
    d = (c.get('od_mm') or 0.0) + 2 * tol
    targets = _targets(H, set(final_present), set(), (0.0, 0.0, 0.0), set(c['ends']))
    found = {}
    specs = [dict(type='cyl', p0=p0, p1=p1, d=d) for p0, p1 in zip(pts, pts[1:]) if math.dist(p0, p1) > 1e-9]
    specs += [dict(type='box', box=[p[0] - d / 2, p[0] + d / 2, p[1] - d / 2, p[1] + d / 2, p[2] - d / 2, p[2] + d / 2])
              for p in pts[1:-1]]
    for spec in specs:
        for h in hits(spec, targets):
            found[h['obstacle']] = round(found.get(h['obstacle'], 0.0) + h['volume_mm3'], 2)
    return dict(variable=c['family']['var'], value=value, od_mm=c.get('od_mm'), capsule_d_mm=_r(d, 2),
                polyline_points=len(pts), pieces=len(specs), member_length_mm=_r(mem['length'], 2),
                exempt=sorted(c['ends']), targets=len(targets), hits=found, member_errors=mem['errors'])


def apply_member_clearance(rows, H, rounded_path, final_present, hits=box_hits):
    for r in rows:
        c = H['cables'].get(r.get('id'))
        if not c or not c.get('family') or r.get('status') != 'pass':
            continue
        if r['category'] == 'cable_stow' and r.get('kind') == 'loop':
            fr = family_range(rounded_path, c['curve'], c['family'])
            value = max(c['family']['bound'], key=lambda b: fr['length_at_bound_mm'][str(b)] if fr['valid_at_bound'][str(b)]
                        else float('-inf'))
            use = 'longest member (the spare home)'
        elif r['category'] == 'cable_routes' and isinstance(r.get('basis'), dict) and 'family' in r['basis']:
            value, use = r['basis']['family']['min_at'], 'shortest member (the minimum route)'
        else:
            continue
        mc = member_clearance(H, rounded_path, r['id'], value, final_present, hits)
        r['member_clearance'] = dict(mc, use=use)
        if mc['hits'] or mc['member_errors']:
            r.setdefault('problems', []).append(
                '%s at %s=%s intersects %s in the closed camera (capsule d %.2f mm)%s'
                % (use, mc['variable'], value, ', '.join('%s %.2f mm3' % kv for kv in sorted(mc['hits'].items())) or 'nothing',
                   mc['capsule_d_mm'], '; member errors: %s' % mc['member_errors'] if mc['member_errors'] else ''))
            r['status'] = 'fail'


# ------------------------------------------------------------------ installed-route clearance (H1: VN-26, VN-60)
# The member sweep above covers only the bound members behind a family pass; the installed route itself (a family's
# recorded member or a fixed curve) was never swept, which is how the run-lead route ran through tub material
# unseen. Cables whose installed route was (re)built in phase 2 are swept here: (1) as capsules of their full
# envelope against the closed-camera material (own end parts exempt, r7 rule) and the installed HDMI ribbon cells
# (keepout boxes); (2) for centreline separation from every other modeled cable (no overlap of the two envelopes).
# A hit (above INSTALLED_TOL, stricter than the r7 SWEEP_TOL) or an overlap fails the cable_routes row. Envelope
# diameters are data of record with their sources.
INSTALLED_TOL = 0.01   # mm3: numerical floor for installed-route and feed-volume sweeps
SEPARATION_TOL = 0.01  # mm: polyline simplification for centreline separation (the bound subtracts 2 x this)
INSTALLED_CLEARANCE = {
    'run_pin37': dict(d=1.6, src='signal_routes run core od_mm 1.6 (MP-RUN measures)'),
    'run_pin39': dict(d=1.6, src='signal_routes run core od_mm 1.6 (MP-RUN measures)'),
    'usb_5v': dict(d=3.6, src='BOM D2-22: Adafruit 4448 supplier drawing C14289-001 jacket OD 3.6 mm; the two Pololu '
                              '2180 / 2181 20 AWG tails ride inside the same envelope only if each core OD <= 1.8 mm '
                              '(MEASUREMENTS-TO-CLOSE EVF power RCY row measures)'),
    'pack_lead': dict(d=4.8, src='BOM D2-13: two 18 AWG cores side by side, routes.py od 2.4 mm per core (MP-PACK '
                                 'measures)'),
    # H2 (VN-28): the re-solved QT main and its modeled fan-in branches (each branch on its own 1.6 mm capsule)
    'qt': dict(d=3.2, branch_d=1.6, src='signal_routes QT main od_mm 3.2 and branch od_mm 1.6 (MP-QT measures the '
                                       'breakout and core OD)'),
}


RIBBON_D = {'fpc': 16.0,        # signal_routes fpc full_width_mm 16: a ribbon is taken as a round envelope of its width
            'oled_flex': 12.4}  # routes.py oled_flex note: 12.4 mm ribbon


def _seg_dist(p, q, r, s):
    """Minimum distance between segments pq and rs (3D)."""
    d1 = [q[i] - p[i] for i in range(3)]
    d2 = [s[i] - r[i] for i in range(3)]
    w = [p[i] - r[i] for i in range(3)]
    a = sum(x * x for x in d1); e = sum(x * x for x in d2); f = sum(d2[i] * w[i] for i in range(3))
    if a < 1e-18 and e < 1e-18:
        return math.dist(p, r)
    if a < 1e-18:
        sc, tc = 0.0, max(0.0, min(1.0, f / e))
    else:
        c = sum(d1[i] * w[i] for i in range(3))
        if e < 1e-18:
            sc, tc = max(0.0, min(1.0, -c / a)), 0.0
        else:
            b = sum(d1[i] * d2[i] for i in range(3))
            den = a * e - b * b
            sc = max(0.0, min(1.0, (b * f - c * e) / den)) if den > 1e-18 else 0.0
            tc = (b * sc + f) / e
            if tc < 0.0:
                tc, sc = 0.0, max(0.0, min(1.0, -c / a))
            elif tc > 1.0:
                tc, sc = 1.0, max(0.0, min(1.0, (b - c) / a))
    return math.dist([p[i] + sc * d1[i] for i in range(3)], [r[i] + tc * d2[i] for i in range(3)])


def polyline_distance(a_pts, b_pts, tol=MEMBER_TOL):
    """Lower bound of the distance between two sampled centrelines: RDP-simplified (tol), minus 2 tol."""
    a, b = simplify_polyline(a_pts, tol), simplify_polyline(b_pts, tol)
    best = float('inf')
    bb_b = [(q, s, [min(q[i], s[i]) for i in range(3)], [max(q[i], s[i]) for i in range(3)]) for q, s in zip(b, b[1:])]
    for p, q in zip(a, a[1:]):
        lo = [min(p[i], q[i]) for i in range(3)]; hi = [max(p[i], q[i]) for i in range(3)]
        for r, s, l2, h2 in bb_b:
            gap = math.sqrt(sum(max(0.0, l2[i] - hi[i], lo[i] - h2[i]) ** 2 for i in range(3)))
            if gap >= best:
                continue
            best = min(best, _seg_dist(p, q, r, s))
    return best - 2 * tol


def neighbour_cables(H, cid):
    """Every other modeled cable centreline with its envelope diameter: (name, points, d)."""
    out = []
    for k, c in H['cables'].items():
        if k == cid or 'delegated' in c or not c.get('points'):
            continue
        d = (INSTALLED_CLEARANCE.get(k, {}).get('d') or RIBBON_D.get(k) or c.get('od_mm')
             or (CORE_OD if c.get('core') else None))
        if d:
            out.append((k, c['points'], d))
        for br in c.get('branches') or []:
            out.append((k + ':' + br['id'], br['points'], 1.6))
    for br in H.get('signal_branches', []):
        out.append(('header_branch:' + br['id'], br['points'], br['od_mm']))
    return out


def capsule_specs(pts, d, tol=INSTALLED_TOL):
    """Segment cylinders plus a cube of the capsule diameter at every inner joint (both enclose the capsule)."""
    out = [dict(type='cyl', p0=p0, p1=p1, d=d, tol=tol) for p0, p1 in zip(pts, pts[1:]) if math.dist(p0, p1) > 1e-9]
    out += [dict(type='box', box=[p[0] - d / 2, p[0] + d / 2, p[1] - d / 2, p[1] + d / 2, p[2] - d / 2, p[2] + d / 2],
                 tol=tol) for p in pts[1:-1]]
    return out


def neighbour_context(H, out, fps_input=None):
    """Add the cable context the installed sweeps need: HDMI ribbon cells of all three states (installed, premate,
    unplugged) as keepout boxes, the source header branches that are not QT, and the selected FPS mated-carry wires
    (out/fps-service-study/mated-carry-input.json, the FPS harness of record) with its mated pair box."""
    H['hdmi_cells'] = [bb(s['box']) for key in ('hdmi_ribbon', 'hdmi_ribbon_premate', 'hdmi_ribbon_unplugged')
                       for s in (out.get(key) or {}).get('segments') or []]
    # H2: the same cells per state, for free-lead sweeps at one op (the ribbon is in one state at a time)
    H['hdmi_cells_state'] = {st: [bb(s['box']) for s in (out.get(key) or {}).get('segments') or []]
                             for st, key in (('installed', 'hdmi_ribbon'), ('premate', 'hdmi_ribbon_premate'),
                                             ('unplugged', 'hdmi_ribbon_unplugged'))}
    br = [dict(id=b['id'], points=[list(p) for p in b['curve']['sampled_centerline']], od_mm=b['od_mm'])
          for b in out['signal_geometry']['branches'] if b['cable'] != 'qt']
    if fps_input:
        br += [dict(id='fps_' + q['id'], points=[list(p) for p in q['curve']['sampled_centerline']], od_mm=q['od_mm'])
               for q in fps_input['wire_parts']]
        H['fps_pair_box'] = bb(fps_input['junction']['box'])
    H['signal_branches'] = br
    return H


def installed_clearance(H, cid, final_present, hits=box_hits, tol=MEMBER_TOL):
    c = H['cables'][cid]
    spec = INSTALLED_CLEARANCE[cid]
    # the bundle up to where separate cores take over (sweep_points), then each core on its own stub
    lines = [(c.get('sweep_points') or c['points'], spec['d'])] + [(st['points'], st['d']) for st in c.get('stubs') or []]
    if spec.get('branch_d'):   # H2: a branched cable's own branches (QT fan-in) are swept and separated too
        lines += [(br['points'], spec['branch_d']) for br in c.get('branches') or []]
    pts = simplify_polyline(lines[0][0], tol)
    d = spec['d'] + 2 * tol
    targets = _targets(H, set(final_present), set(), (0.0, 0.0, 0.0), set(c['ends']))
    targets += [dict(id='hdmi_ribbon cell %d' % i, kind='keepout', disp=(0.0, 0.0, 0.0), box=b)
                for i, b in enumerate(H.get('hdmi_cells', []))]
    if H.get('fps_pair_box'):
        targets.append(dict(id='fps_mated_pair', kind='keepout', disp=(0.0, 0.0, 0.0), box=H['fps_pair_box']))
    found = {}
    specs = capsule_specs(pts, d)
    for q, dq in lines[1:]:   # separate cores where they fan out of a connector (pack lead at the XT30 male)
        specs += capsule_specs(simplify_polyline(q, tol), dq + 2 * tol)
    for sp in specs:
        for h in hits(sp, targets):
            key = 'hdmi_ribbon' if h['obstacle'].startswith('hdmi_ribbon') else h['obstacle']
            found[key] = round(found.get(key, 0.0) + h['volume_mm3'], 2)
    sep, overlaps = {}, []
    for name, q, dq in neighbour_cables(H, cid):
        dist, need = min(((polyline_distance(ln, q, SEPARATION_TOL), (dl + dq) / 2) for ln, dl in lines),
                         key=lambda t: t[0] - t[1])
        sep[name] = dict(min_centreline_mm=_r(dist, 2), need_mm=_r(need, 2))
        if dist < need - 1e-9:
            overlaps.append('%s %.2f < %.2f mm' % (name, dist, need))
    return dict(envelope_d_mm=spec['d'], envelope_src=spec['src'], capsule_d_mm=_r(d, 2), polyline_points=len(pts),
                pieces=len(specs), stubs=len(c.get('stubs') or []), exempt=sorted(c['ends']), targets=len(targets), hits=found,
                cable_separation=sep, cable_overlaps=overlaps)


def apply_installed_clearance(rows, H, final_present, hits=box_hits):
    for r in rows:
        if r.get('category') != 'cable_routes' or r.get('id') not in INSTALLED_CLEARANCE or r.get('status') != 'pass':
            continue
        ic = installed_clearance(H, r['id'], final_present, hits)
        r['installed_clearance'] = ic
        probs = []
        if ic['hits']:
            probs.append('installed route intersects %s in the closed camera (capsule d %.2f mm)' % (
                ', '.join('%s %.2f mm3' % kv for kv in sorted(ic['hits'].items())), ic['capsule_d_mm']))
        if ic['cable_overlaps']:
            probs.append('installed route envelope overlaps cable(s): ' + '; '.join(ic['cable_overlaps']))
        if probs:
            r.setdefault('problems', []).extend(probs)
            r['status'] = 'fail'


# ------------------------------------------------------------------ EVF feed volumes (H1: FP-11f, VN-60)
# The rigid parts of the usb_5v feed are placed on straight legs of its installed route by routes.usb_5v_feed():
# the diode splice sleeve (with the parallel ground splice), the option-C regulator reserve (kept free by default
# pending user decision 10) and the mated RCY pair. Each is an oriented box tested by exact Boolean against every
# part of the closed camera (no exemption) and the installed HDMI ribbon cells, strictly (INSTALLED_TOL); its centreline
# must lie on the installed route; its envelope must not overlap another modeled cable; and each Pololu tail must
# span its route segment with the r7 service allowance.
POLOLU_TAIL_MM = 100.0                 # BOM D2-23: Pololu 2180 / 2181 nominal 100 mm 20 AWG tails (cut to fit)
DONOR_MIN_MM = 300.0                   # BOM D2-22: Adafruit 4448 catalog 300 mm (supplier drawing 325 +/- 10)


def feed_volume_rows(H, final_present, hits=box_hits):
    c = H['cables'].get('usb_5v') or {}
    feed = c.get('feed') or {}
    vols = feed.get('volumes') or []
    if c.get('errors') or not c.get('points') or not vols:
        return [dict(category='feed_volumes', id='usb_5v_volumes', status='fail',
                     problems=['no installed usb_5v route with placed feed volumes (VN-60 / FP-11f)'])]
    rows = []
    targets = _targets(H, set(final_present), set(), (0.0, 0.0, 0.0), set())
    targets += [dict(id='hdmi_ribbon cell %d' % i, kind='keepout', disp=(0.0, 0.0, 0.0), box=b)
                for i, b in enumerate(H.get('hdmi_cells', []))]
    if H.get('fps_pair_box'):
        targets.append(dict(id='fps_mated_pair', kind='keepout', disp=(0.0, 0.0, 0.0), box=H['fps_pair_box']))
    nbrs = [n for n in neighbour_cables(H, 'usb_5v')]
    for v in vols:
        spec = dict(type='obox', center=v['center'], axis=v['axis'], width=v['width_vector'], dims=v['dims_mm'],
                    box=v['aabb'], tol=INSTALLED_TOL)
        found = {}
        for h in hits(spec, targets):
            key = 'hdmi_ribbon' if h['obstacle'].startswith('hdmi_ribbon') else h['obstacle']
            found[key] = round(found.get(key, 0.0) + h['volume_mm3'], 3)
        L = v['dims_mm'][0]
        ends = [add(v['center'], v['axis'], -L / 2), add(v['center'], v['axis'], L / 2)]
        off = max(nearest_on_polyline(c['points'], q)[2] for q in [v['center']] + ends)
        half_diag = math.hypot(v['dims_mm'][1], v['dims_mm'][2]) / 2
        sep, overl = {}, []
        for name, q, dq in nbrs:
            dist = polyline_distance(ends, q, SEPARATION_TOL)
            need = half_diag + dq / 2
            sep[name] = dict(min_axis_distance_mm=_r(dist, 2), need_mm=_r(need, 2))
            if dist < need - 1e-9:
                overl.append('%s %.2f < %.2f mm' % (name, dist, need))
        probs = []
        if found:
            probs.append('volume intersects %s' % ', '.join('%s %.3f mm3' % kv for kv in sorted(found.items())))
        if off > 0.05:
            probs.append('volume axis is %.3f mm off the installed usb_5v centreline' % off)
        if overl:
            probs.append('volume envelope overlaps cable(s): ' + '; '.join(overl))
        rows.append(dict(category='feed_volumes', id='usb_5v_' + v['id'], dims_mm=v['dims_mm'], leg=v['leg'],
                         station_mm=v['station_mm'], center=[_r(x, 3) for x in v['center']], axis=v['axis'],
                         aabb=[_r(x, 3) for x in v['aabb']], targets=len(targets), hits=found,
                         axis_off_route_mm=_r(off, 4), cable_separation=sep, source=v['source'], gate=v['gate'],
                         default=v.get('default'), method='exact' if hits is not box_hits else 'aabb',
                         problems=probs, status='fail' if probs else 'pass'))
    # Pololu tails and donor: each spans its route segment with the r7 allowance; the volumes keep their order.
    st = feed['stations_mm']
    order = [st[k] for k in ('head_exit', 'splice_start', 'splice_end', 'rcy_start', 'rcy_end', 'board')]
    segs = [('donor', st['head_exit'], st['splice_start'], DONOR_MIN_MM, 'BOM D2-22 catalog 300 mm'),
            ('tail_2180', st['splice_end'], st['rcy_start'], POLOLU_TAIL_MM, 'BOM D2-23 Pololu 2180 100 mm'),
            ('tail_2181', st['rcy_end'], st['board'], POLOLU_TAIL_MM, 'BOM D2-23 Pololu 2181 100 mm')]
    for sid, a, b, stock, src in segs:
        span = b - a
        allow = route_allowance(stock)
        probs = []
        if any(y < x - 1e-9 for x, y in zip(order, order[1:])):
            probs.append('feed stations out of order: %s' % order)
        if span + allow > stock + 1e-6:
            probs.append('segment %.1f + allowance %.1f > stock %.1f mm' % (span, allow, stock))
        rows.append(dict(category='feed_volumes', id='usb_5v_' + sid, span_mm=_r(span, 2), allowance_mm=_r(allow, 1),
                         stock_mm=stock, stock_src=src, slack_mm=_r(stock - span - allow, 2), problems=probs,
                         status='fail' if probs else 'pass', estimate=True))
    return rows
