AubergineShallow/digital8mm-vertical-nizo/(commit log)

2026-10-09 Add vertical Pi D2 review with concealed ventilation
    [BOM-VERTICAL.csv, C01_carrier_original.step, C01_carrier_original.stl, C02_carrier_reinforced.step, C02_carrier_reinforced.stl, C03_heel_original.step, C03_heel_original.stl, C04_heel_reinforced.step]
2026-10-10 Review fixes phase 1: Windows-safe repo and I/O, evidence tooling, assembly-state model, corrected build order, ported r7 checks
    Independent review of 9ced753 (review-2026-10-10/: issue register with 84
    entries, six dimension reports, reproduction record). Phase 1 closes 22
    entries and ports the r7 checks that the vertical candidate lacked; the
    ported checks now fail on the current geometry by design until the CAD
    fixes of phase 2.
    - FP-01: .gitattributes restores "* -text" (r7 receipts verify on an
    emulated autocrlf clone); THIRD-PARTY-NOTICES.md and Raspberry Pi MIT
    licence copies beside every Pi-derived STEP.
    - FP-02: cv_io helper (UTF-8, LF, POSIX paths) across 76 scripts.
    - FP-03/0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
    [BOM-VERTICAL.csv]
2026-10-11 INTERMEDIATE (work in progress, not final, not verified): review fixes phase 2 snapshot
    Snapshot of the phase-2 review fixes for the vertical-Pi candidate, pushed
    on request while the final evidence refresh is still running. See
    INTERMEDIATE-STATUS.md at the repository root.
    - Includes phase 1 (44f8131, complete and verified) and the source,
    check, test and document changes of nine phase-2 lanes (plenum roof and
    mouths, tab catch, EVF -Z stop, carrier, collar/grip, harness routes,
    generated wiring + BOM, repo hygiene, critical-feature probes).
    - Deliberately excludes candidate-vertical/out/: exports and evidence are
    still the phase-1 state and do NOT match these sources; the reconci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
    [BOM-VERTICAL.csv, BUY-VERTICAL.csv]
